meetsitaram/echo/reports/checks.md

# Physical checks

spec: `spec/robot.json`, 2026-11-05 15:00, 550 s

1134 checks: 1052 pass, 18 warn, **64 fail**

## targets

| status | item | detail |
|---|---|---|
| PASS | height | 1.727 m (Figure 03: 1.727 m, +/- 0.010) |
| PASS | chin_z | 1.522 (photo 1.522 +/- 0.02) |
| PASS | shoulder_top_z | 1.449 (photo 1.445 +/- 0.025) |
| PASS | elbow_z | 1.155 (photo 1.156 +/- 0.025) |
| PASS | wrist_z | 0.955 (photo 0.955 +/- 0.03) |
| PASS | fingertip_z | 0.716 (photo 0.71 +/- 0.03) |
| PASS | knee_z | 0.535 (photo 0.54 +/- 0.03) |
| PASS | pelvis_band_top_z | 1.085 (photo 1.085 +/- 0.02) |
| PASS | hips_black_bottom_z | 0.853 (photo 0.86 +/- 0.03) |
| PASS | head_height_m | 0.205 (photo 0.205 +/- 0.015) |
| PASS | head_depth_m | 0.190 (photo 0.183 +/- 0.015) |
| PASS | head_width_m | 0.140 (photo 0.138 +/- 0.012) |
| PASS | chest_depth_m | 0.231 (photo 0.235 +/- 0.025) |
| PASS | bideltoid_width_m | 0.513 (photo 0.51 +/- 0.04) |
| PASS | foot_length_m | 0.289 (photo 0.28 +/- 0.02) |

## mass

| status | item | detail |
|---|---|---|
| PASS | total | 62.29 kg bottom-up (Figure 03: 61.0 kg; allowed 54.9 .. 62.5) |

## axis

| status | item | detail |
|---|---|---|
| PASS | waist_yaw | RS04 0.0 mm off the axis |
| PASS | neck_yaw | RS00 0.0 mm off the axis |
| PASS | neck_pitch | RS00 0.0 mm off the axis |
| PASS | L_shoulder_pitch | RS04 0.0 mm off the axis |
| PASS | R_shoulder_pitch | RS04 0.0 mm off the axis |
| PASS | L_shoulder_roll | RS06 0.0 mm off the axis |
| PASS | R_shoulder_roll | RS06 0.0 mm off the axis |
| PASS | L_shoulder_yaw | RS02 0.0 mm off the axis |
| PASS | R_shoulder_yaw | RS02 0.0 mm off the axis |
| PASS | L_elbow | RS06 0.0 mm off the axis |
| PASS | R_elbow | RS06 0.0 mm off the axis |
| PASS | L_wrist_yaw | RS02 0.0 mm off the axis |
| PASS | R_wrist_yaw | RS02 0.0 mm off the axis |
| PASS | L_wrist_pitch | RS00 0.0 mm off the axis |
| PASS | R_wrist_pitch | RS00 0.0 mm off the axis |
| PASS | L_wrist_roll | RS00 0.0 mm off the axis |
| PASS | R_wrist_roll | RS00 0.0 mm off the axis |
| PASS | L_hip_pitch | RS04 0.0 mm off the axis |
| PASS | R_hip_pitch | RS04 0.0 mm off the axis |
| PASS | L_hip_roll | RS04 0.0 mm off the axis |
| PASS | R_hip_roll | RS04 0.0 mm off the axis |
| PASS | L_hip_yaw | RS03 0.0 mm off the axis |
| PASS | R_hip_yaw | RS03 0.0 mm off the axis |
| PASS | L_knee | RS04 0.0 mm off the axis |
| PASS | R_knee | RS04 0.0 mm off the axis |

## static

| status | item | detail |
|---|---|---|
| PASS | zero pose | 0 overlaps |

## covers

| status | item | detail |
|---|---|---|
| PASS | motors clear of the covers | 0 cover / motor crossings |

## connect

| status | item | detail |
|---|---|---|
| PASS | pelvis structure |  |
| PASS | pelvis covers mounted |  |
| PASS | torso structure |  |
| PASS | torso covers mounted |  |
| PASS | neck_yaw_link structure |  |
| PASS | neck_yaw_link covers mounted |  |
| PASS | head structure |  |
| PASS | head covers mounted |  |
| PASS | L_shoulder_pitch_link structure |  |
| PASS | L_shoulder_pitch_link covers mounted |  |
| PASS | R_shoulder_pitch_link structure |  |
| PASS | R_shoulder_pitch_link covers mounted |  |
| PASS | L_shoulder_roll_link structure |  |
| PASS | L_shoulder_roll_link covers mounted |  |
| PASS | R_shoulder_roll_link structure |  |
| PASS | R_shoulder_roll_link covers mounted |  |
| PASS | L_shoulder_yaw_link structure |  |
| PASS | L_shoulder_yaw_link covers mounted |  |
| PASS | R_shoulder_yaw_link structure |  |
| PASS | R_shoulder_yaw_link covers mounted |  |
| PASS | L_elbow_link structure |  |
| PASS | L_elbow_link covers mounted |  |
| PASS | R_elbow_link structure |  |
| PASS | R_elbow_link covers mounted |  |
| PASS | L_wrist_yaw_link structure |  |
| PASS | L_wrist_yaw_link covers mounted |  |
| PASS | R_wrist_yaw_link structure |  |
| PASS | R_wrist_yaw_link covers mounted |  |
| PASS | L_wrist_pitch_link structure |  |
| PASS | L_wrist_pitch_link covers mounted |  |
| PASS | R_wrist_pitch_link structure |  |
| PASS | R_wrist_pitch_link covers mounted |  |
| PASS | L_hand structure |  |
| PASS | L_hand covers mounted |  |
| PASS | R_hand structure |  |
| PASS | R_hand covers mounted |  |
| PASS | L_hip_pitch_link structure |  |
| PASS | L_hip_pitch_link covers mounted |  |
| PASS | R_hip_pitch_link structure |  |
| PASS | R_hip_pitch_link covers mounted |  |
| PASS | L_hip_roll_link structure |  |
| PASS | L_hip_roll_link covers mounted |  |
| PASS | R_hip_roll_link structure |  |
| PASS | R_hip_roll_link covers mounted |  |
| PASS | L_hip_yaw_link structure |  |
| PASS | L_hip_yaw_link covers mounted |  |
| PASS | R_hip_yaw_link structure |  |
| PASS | R_hip_yaw_link covers mounted |  |
| PASS | L_knee_link structure |  |
| PASS | L_knee_link covers mounted |  |
| PASS | R_knee_link structure |  |
| PASS | R_knee_link covers mounted |  |
| PASS | L_ankle_pitch_link structure |  |
| PASS | L_ankle_pitch_link covers mounted |  |
| PASS | R_ankle_pitch_link structure |  |
| PASS | R_ankle_pitch_link covers mounted |  |
| PASS | L_foot structure |  |
| PASS | L_foot covers mounted |  |
| PASS | R_foot structure |  |
| PASS | R_foot covers mounted |  |
| PASS | waist_yaw axis |  |
| PASS | neck_yaw axis |  |
| PASS | neck_pitch axis |  |
| PASS | L_shoulder_pitch axis |  |
| PASS | R_shoulder_pitch axis |  |
| PASS | L_shoulder_roll axis |  |
| PASS | R_shoulder_roll axis |  |
| PASS | L_shoulder_yaw axis |  |
| PASS | R_shoulder_yaw axis |  |
| PASS | L_elbow axis |  |
| PASS | R_elbow axis |  |
| PASS | L_wrist_yaw axis |  |
| PASS | R_wrist_yaw axis |  |
| PASS | L_wrist_pitch axis |  |
| PASS | R_wrist_pitch axis |  |
| PASS | L_wrist_roll axis |  |
| PASS | R_wrist_roll axis |  |
| PASS | L_hip_pitch axis |  |
| PASS | R_hip_pitch axis |  |
| PASS | L_hip_roll axis |  |
| PASS | R_hip_roll axis |  |
| PASS | L_hip_yaw axis |  |
| PASS | R_hip_yaw axis |  |
| PASS | L_knee axis |  |
| PASS | R_knee axis |  |
| PASS | L_ankle_pitch axis |  |
| PASS | R_ankle_pitch axis |  |
| PASS | L_ankle_roll axis |  |
| PASS | R_ankle_roll axis |  |

## loadpath

| status | item | detail |
|---|---|---|
| PASS | Foot frame in front of the ankle (all load at the toe) | SF 8.97 on what's required, 810 N walking (needs 1.5); worst of all cases 2.14, 3,400 N foot: 235 MPa on 67.0 x 14.1 mm al7075; a hand estimate |
| PASS | Foot frame behind the ankle (all load at the heel) | SF 7.18 on what's required, 810 N walking (needs 1.5); worst of all cases 1.71, 3,400 N foot: 294 MPa on 67.0 x 14.1 mm al7075; a hand estimate |
| PASS | Clevis plates above the frame | SF 16.23 on what's required, 810 N walking (needs 1.5); worst of all cases 7.66, 3,400 N + 1,614 N side: 66 MPa on 2 x 14.4 x 5.0 + 2 x 14.4 x 6.0 mm al7075; a hand estimate |
| PASS | Clevis plates at the pivot (net of the bushings) | SF 4.66 on what's required, 810 N walking (needs 1.5); worst of all cases 3.23, 3,400 N foot: 156 MPa on 2 x 5.5 x 5.0 + 2 x 6.0 x 5.5 mm al7075; a hand estimate |
| PASS | Ankle cross at its middle (net of the shaft's bore) | SF 95.83 on what's required, 810 N walking (needs 1.5); worst of all cases 22.83, 3,400 N foot: 22 MPa on 2 x 30.6 x 6.2 mm al7075; a hand estimate |
| PASS | Fork cheeks at the bushings' top | SF 5.91 on what's required, motor peak (needs 1.5); worst of all cases 5.14, 3,400 N + 1,614 N side: 98 MPa on 2 x 27.6 x 5.0 mm al7075; a hand estimate |
| PASS | Shank tube, closed, past the rods | SF 11.68 on what's required, motor peak (needs 1.5); worst of all cases 7.16, 3,400 N + 1,614 N side: 70 MPa on 53.0 x 43.2 mm al7075; a hand estimate |
| PASS | Shank closed section at the ankle pitch motor, panel on | SF 19.61 on what's required, motor peak (needs 1.5); worst of all cases 6.49, 3,400 N + 1,614 N side: 78 MPa on 97.1 x 20.0 + 9.5 x 4.8 + 97.4 x 23.1 mm al7075; a hand estimate |
| PASS | Shank closed section at the ankle roll motor, panel on | SF 18.90 on what's required, motor peak (needs 1.5); worst of all cases 6.29, 3,400 N + 1,614 N side: 80 MPa on 82.1 x 15.3 + 92.4 x 29.3 mm al7075; a hand estimate |
| PASS | Shank waist behind the knee | SF 35.78 on what's required, motor peak (needs 1.5); worst of all cases 14.66, 3,400 N + 1,614 N side: 34 MPa on 86.2 x 73.7 mm al7075; a hand estimate |
| PASS | Barrel where it meets the waist | SF 80.79 on what's required, motor peak (needs 1.5); worst of all cases 11.02, 3,400 N + 1,614 N side: 46 MPa on 79.8 x 60.1 mm al7075; a hand estimate |
| PASS | Barrel at the axis (walls, net of the bore) | SF 133.73 on what's required, motor peak (needs 1.5); worst of all cases 57.68, 3,400 N foot: 9 MPa on 2 x 58.3 x 8.3 + 2 x 20.1 x 13.9 mm al7075; a hand estimate |
| PASS | Barrel plate round the inner bearing | SF 4317.73 on what's required, 810 N walking (needs 1.5); worst of all cases 1028.64, 3,400 N foot: 0 MPa on 7.8 x 3.5 + 6.2 x 0.7 + 16.7 x 6.8 + 16.0 x 0.7 + 65.6 x 40.3 + 368.8 x 125.0 mm al7075; a hand estimate |
| PASS | Knee post at its root | SF 620.08 on what's required, 810 N walking (needs 1.5); worst of all cases 147.72, 3,400 N foot: 3 MPa on 52.3 x 52.3 mm al7075; a hand estimate |
| PASS | Rear cap at the axis | SF 193.74 on what's required, 810 N walking (needs 1.5); worst of all cases 46.16, 3,400 N foot: 11 MPa on 127.0 x 26.7 mm al7075; a hand estimate |
| PASS | Cup neck between bearing and cheek | SF 33.98 on what's required, motor peak (needs 1.5); worst of all cases 33.98, motor peak: 15 MPa on 52.8 x 52.8 mm al7075; a hand estimate |
| PASS | Fork inner eye, net of its opening | SF 11.73 on what's required, 810 N walking (needs 1.5); worst of all cases 2.79, 3,400 N foot: 180 MPa on 19.9 x 5.1 + 20.0 x 5.2 mm al7075; a hand estimate |
| PASS | Outer cheek at its bearing | SF 153.79 on what's required, 810 N walking (needs 1.5); worst of all cases 36.64, 3,400 N foot: 14 MPa on 95.7 x 11.1 mm al7075; a hand estimate |
| PASS | Fork cheeks over the barrel, both | SF 116.38 on what's required, 810 N walking (needs 1.5); worst of all cases 77.21, 3,400 N foot: 7 MPa on 86.8 x 84.3 mm al7075; a hand estimate |
| PASS | Fork inner cheek alone (the only one that takes motor torque) | SF 111.58 on what's required, motor peak (needs 1.5); worst of all cases 111.58, motor peak: 5 MPa on 86.8 x 73.7 mm al7075; a hand estimate |
| PASS | Fork cheeks out of plane, under the recorded side force | SF 122.05 on what's required, 3,400 N + 1,614 N side (needs 1.5); worst of all cases 122.05, 3,400 N + 1,614 N side: 4 MPa on 86.8 x 84.3 mm al7075; a hand estimate |
| PASS | Fork crown | SF 137.61 on what's required, 810 N walking (needs 1.5); worst of all cases 89.92, 3,400 N foot: 6 MPa on 80.7 x 79.4 mm al7075; a hand estimate |
| PASS | Thigh tube | SF 26.22 on what's required, motor peak (needs 1.5); worst of all cases 20.35, 3,400 N foot: 25 MPa on 66.0 x 66.0 mm al7075; a hand estimate |
| PASS | Thigh tube under its collar | SF 26.15 on what's required, motor peak (needs 1.5); worst of all cases 20.30, 3,400 N foot: 25 MPa on 66.0 x 66.0 mm al7075; a hand estimate |
| PASS | Yaw housing at the motor | SF 84.72 on what's required, 810 N walking (needs 1.5); worst of all cases 53.02, 3,400 N foot: 9 MPa on 110.6 x 110.6 mm al7075; a hand estimate |
| PASS | Yoke band under the pitch motor | SF 16.50 on what's required, 810 N walking (needs 1.5); worst of all cases 10.09, 3,400 N foot: 50 MPa on 41.5 x 9.7 + 104.8 x 56.9 mm al7075; a hand estimate |
| PASS | Yoke plate behind the pitch motor | SF 7.34 on what's required, 810 N walking (needs 1.5); worst of all cases 3.40, 3,400 N foot: 148 MPa on 59.3 x 6.4 + 41.5 x 11.7 mm al7075; a hand estimate |
| PASS | Carrier arm over the roll output | SF 4.16 on what's required, motor peak (needs 1.5); worst of all cases 2.32, 3,400 N foot: 217 MPa on 56.3 x 10.6 mm al7075; a hand estimate |
| PASS | Carrier arm at the eye | SF 4.03 on what's required, motor peak (needs 1.5); worst of all cases 2.34, 3,400 N foot: 215 MPa on 54.2 x 10.6 mm al7075; a hand estimate |
| PASS | Roll barrel | SF 83.27 on what's required, 810 N walking (needs 1.5); worst of all cases 31.65, 3,400 N foot: 16 MPa on 130.3 x 125.4 mm al7075; a hand estimate |
| PASS | Pelvis bar between the hips | SF 20.26 on what's required, 810 N walking (needs 1.5); worst of all cases 8.19, 3,400 N foot: 61 MPa on 2 x 22.1 x 2.0 + 2 x 67.1 x 16.0 + 2 x 5.7 x 4.6 mm al7075; a hand estimate |
| PASS | Hip barrel on the pelvis | SF 104.96 on what's required, 810 N walking (needs 1.5); worst of all cases 44.31, 3,400 N foot: 11 MPa on 125.4 x 125.4 mm al7075; a hand estimate |
| PASS | Waist housing on the pelvis | SF 151.60 on what's required, 810 N walking (needs 1.5); worst of all cases 130.99, 3,400 N foot: 4 MPa on 232.6 x 125.4 mm al7075; a hand estimate |
| PASS | Waist cup neck | SF 16.93 on what's required, motor peak (needs 1.5); worst of all cases 16.93, motor peak: 30 MPa on 52.9 x 52.9 mm al7075; a hand estimate |
| PASS | Chest rails over the waist | SF 7.33 on what's required, motor peak (needs 1.5); worst of all cases 7.33, motor peak: 69 MPa on 2 x 46.0 x 25.0 mm al7075; a hand estimate |
| PASS | Frame between waist and shoulder bar (the pack is not frame) | SF 6.69 on what's required, motor peak (needs 1.5); worst of all cases 6.69, motor peak: 75 MPa on 2 x 44.0 x 24.0 mm al7075; a hand estimate |
| PASS | Chest bar under the neck | SF 95.29 on what's required, motor peak (needs 1.5); worst of all cases 95.29, motor peak: 5 MPa on 12.5 x 3.8 + 2 x 31.6 x 6.7 + 125.4 x 125.4 mm al7075; a hand estimate |
| PASS | Chest bar at the shoulder motor | SF 185.29 on what's required, motor peak (needs 1.5); worst of all cases 112.72, 3,400 N foot: 4 MPa on 66.0 x 43.8 + 63.9 x 46.3 + 65.2 x 10.0 + 124.2 x 55.5 mm al7075; a hand estimate |
| PASS | Shoulder bracket | SF 24.80 on what's required, motor peak (needs 1.5); worst of all cases 24.80, motor peak: 20 MPa on 36.0 x 36.0 mm al7075; a hand estimate |
| PASS | Shoulder roll post (front of the fork) | SF 15.50 on what's required, 5 kg in the hand (needs 1.5); worst of all cases 7.65, 3,400 N foot: 66 MPa on 24.0 x 24.0 mm al7075; a hand estimate |
| PASS | Shoulder roll axle (back of the fork) | SF 12.11 on what's required, 5 kg in the hand (needs 1.5); worst of all cases 6.12, 3,400 N foot: 82 MPa on 22.0 x 22.0 mm al7075; a hand estimate |
| PASS | Fork plates, upper, solid | SF 99.92 on what's required, motor peak (needs 1.5); worst of all cases 99.92, motor peak: 5 MPa on 2 x 64.0 x 6.0 mm al7075; a hand estimate |
| PASS | Fork plates at the roll axis (front net of its bore) | SF 38.28 on what's required, motor peak (needs 1.5); worst of all cases 38.28, motor peak: 13 MPa on 64.0 x 6.0 + 6.0 x 3.5 + 33.5 x 6.0 mm al7075; a hand estimate |
| PASS | Fork front plate alone, net of its bore | SF 8.66 on what's required, motor peak (needs 1.5); worst of all cases 8.66, motor peak: 58 MPa on 6.0 x 3.5 + 33.5 x 6.0 mm al7075; a hand estimate |
| PASS | Fork plates, lower | SF 67.51 on what's required, motor peak (needs 1.5); worst of all cases 67.51, motor peak: 7 MPa on 2 x 50.0 x 6.0 mm al7075; a hand estimate |
| PASS | Fork bridge | SF 10.77 on what's required, 5 kg in the hand (needs 1.5); worst of all cases 5.67, 3,400 N foot: 89 MPa on 50.0 x 10.0 mm al7075; a hand estimate |
| PASS | Upper arm frame | SF 60.28 on what's required, motor peak (needs 1.5); worst of all cases 42.03, 3,400 N foot: 12 MPa on 30.0 x 30.0 mm al7075; a hand estimate |
| PASS | Elbow bridge beside the frame | SF 5.67 on what's required, motor peak (needs 1.5); worst of all cases 4.24, 3,400 N foot: 119 MPa on 24.0 x 10.0 mm al7075; a hand estimate |
| PASS | Elbow cheeks over the discs, both | SF 39.62 on what's required, 5 kg in the hand (needs 1.5); worst of all cases 24.77, 3,400 N foot: 20 MPa on 2 x 46.0 x 3.0 mm al7075; a hand estimate |
| FAIL | Elbow inner cheek alone (the only one that takes motor torque) | SF 1.31 on what's required, 5 kg in the hand (needs 1.5); worst of all cases 0.82, 3,400 N foot: 610 MPa on 46.0 x 3.0 mm al7075; a hand estimate |
| PASS | Elbow cheek discs at the bores (net of them) | SF 83.18 on what's required, motor peak (needs 1.5); worst of all cases 83.18, motor peak: 6 MPa on 2 x 20.5 x 3.0 + 2 x 28.5 x 3.0 mm al7075; a hand estimate |
| PASS | Elbow axle | SF 52.04 on what's required, motor peak (needs 1.5); worst of all cases 52.04, motor peak: 10 MPa on 34.0 x 34.0 mm al7075; a hand estimate |
| PASS | Elbow post | SF 49.76 on what's required, 5 kg in the hand (needs 1.5); worst of all cases 49.76, 5 kg in the hand: 10 MPa on 34.0 x 34.0 mm al7075; a hand estimate |
| PASS | Forearm frame | SF 4.70 on what's required, 5 kg in the hand (needs 1.5); worst of all cases 3.61, 3,400 N foot: 139 MPa on 40.0 x 5.0 mm al7075; a hand estimate |
| PASS | Elbow idler arm | SF 16.11 on what's required, 5 kg in the hand (needs 1.5); worst of all cases 10.32, 3,400 N foot: 49 MPa on 12.0 x 4.0 mm al7075; a hand estimate |
| PASS | Under the elbow motor | SF 85.51 on what's required, 5 kg in the hand (needs 1.5); worst of all cases 54.82, 3,400 N foot: 9 MPa on 30.0 x 8.0 mm al7075; a hand estimate |
| PASS | Forearm lower frame | SF 71.86 on what's required, motor peak (needs 1.5); worst of all cases 71.86, motor peak: 7 MPa on 30.0 x 24.0 mm al7075; a hand estimate |
| PASS | Wrist cheek | SF 8.34 on what's required, motor peak (needs 1.5); worst of all cases 8.34, motor peak: 60 MPa on 40.0 x 6.0 mm al7075; a hand estimate |
| PASS | Hand bracket | SF 13.22 on what's required, motor peak (needs 1.5); worst of all cases 13.22, motor peak: 38 MPa on 20.0 x 6.0 mm al7075; a hand estimate |
| PASS | Neck housing column | SF 17.04 on what's required, motor peak (needs 1.5); worst of all cases 17.04, motor peak: 30 MPa on 17.2 x 17.0 mm al7075; a hand estimate |
| PASS | Head frame | SF 31.82 on what's required, motor peak (needs 1.5); worst of all cases 7.98, 3,400 N foot: 63 MPa on 37.0 x 4.0 mm al7075; a hand estimate |
| PASS | Pitch rod | SF 2.84 on what's required, motor peak (needs 1.5); worst of all cases 2.84, motor peak: 34 MPa on 10.0 x 10.0 mm al7075; a hand estimate |
| PASS | Roll rod | SF 2.55 on what's required, motor peak (needs 1.5); worst of all cases 2.55, motor peak: 18 MPa on 10.0 x 10.0 mm al7075; a hand estimate |
| PASS | Pitch crank at the motor | SF 4.96 on what's required, motor peak (needs 1.5); worst of all cases 4.96, motor peak: 102 MPa on 6.4 x 4.4 + 6.4 x 4.9 + 12.4 x 6.4 mm al7075; a hand estimate |
| PASS | Roll crank at the motor | SF 6.21 on what's required, motor peak (needs 1.5); worst of all cases 6.21, motor peak: 81 MPa on 2 x 6.2 x 4.3 + 2 x 6.2 x 4.1 mm al7075; a hand estimate |
| PASS | Ankle pitch arm | SF 1.96 on what's required, motor peak (needs 1.5); worst of all cases 1.96, motor peak: 257 MPa on 19.6 x 15.8 mm al7075; a hand estimate |
| PASS | Roll rod post | SF 2.76 on what's required, motor peak (needs 1.5); worst of all cases 2.76, motor peak: 182 MPa on 19.4 x 3.5 mm al7075; a hand estimate |
| PASS | coverage: every rigid part on a path or excused |  |
| PASS | coverage: every named part exists |  |
| WARN | role: L elbow hub in | 7075 with role shell: not counted as load-bearing. If it carries load, make it struct |
| WARN | role: L elbow hub out | 7075 with role shell: not counted as load-bearing. If it carries load, make it struct |
| WARN | role: L knee hub out | 7075 with role shell: not counted as load-bearing. If it carries load, make it struct |

## contact

| status | item | detail |
|---|---|---|
| PASS | L foot frame / L ankle roll bushing front | 110 mm2 (overlap, 0.23 deep), needs 100 to pass 405 N |
| PASS | L foot frame / L ankle roll bushing back | 100 mm2 (overlap, 0.25 deep), needs 100 to pass 405 N |
| PASS | L ankle roll shaft / L ankle cross | 367 mm2 (flush, 0.00 deep), needs 100 to pass 810 N |
| PASS | L ankle pitch bushing in / L shank body | 101 mm2 (overlap, 0.25 deep), needs 100 to pass 405 N |
| PASS | L ankle pitch bushing out / L shank body | 109 mm2 (overlap, 0.23 deep), needs 100 to pass 405 N |
| PASS | L shank body / L shank back panel | 1281 mm2 (overlap, 0.20 deep), needs 100 to pass 81 N |
| PASS | L shank body / L knee rear cap | 534 mm2 (overlap, 0.69 deep), needs 100 to pass 613 N |
| PASS | L shank body / L_knee actuator (buy) RS04 | 8212 mm2 (flush, 0.00 deep), needs 100 to pass 543 N |
| PASS | L thigh fork / L_knee flange | 1461 mm2 (overlap, 0.38 deep), needs 100 to pass 613 N |
| PASS | L thigh fork / L knee outer cheek | 543 mm2 (overlap, 1.67 deep), needs 100 to pass 613 N |
| PASS | L thigh fork / L_hip_yaw flange | 2357 mm2 (overlap, 0.20 deep), needs 100 to pass 810 N |
| PASS | L hip yoke / L hip yaw ring | 274 mm2 (overlap, 0.90 deep), needs 100 to pass 810 N |
| PASS | L hip yaw ring / L_hip_yaw actuator (buy) RS03 | 457 mm2 (overlap, 0.15 deep), needs 100 to pass 810 N |
| PASS | L hip yoke / L_hip_roll flange | 122 mm2 (overlap, 0.57 deep), needs 100 to pass 810 N |
| PASS | L hip carrier / L_hip_roll actuator (buy) RS04 | 3528 mm2 (overlap, 0.31 deep), needs 100 to pass 810 N |
| PASS | L hip carrier / L_hip_pitch flange | 1355 mm2 (overlap, 0.34 deep), needs 100 to pass 810 N |
| PASS | pelvis frame / L_hip_pitch actuator (buy) RS04 | 3516 mm2 (overlap, 0.27 deep), needs 100 to pass 543 N |
| PASS | pelvis frame / L hip ring | 269 mm2 (overlap, 0.80 deep), needs 100 to pass 810 N |
| PASS | pelvis frame / waist_yaw actuator (buy) RS04 | 3580 mm2 (overlap, 0.37 deep), needs 100 to pass 435 N |
| PASS | pelvis frame / waist ring | 268 mm2 (overlap, 0.80 deep), needs 100 to pass 435 N |
| PASS | chest frame / waist_yaw flange | 1150 mm2 (overlap, 0.34 deep), needs 100 to pass 435 N |
| PASS | chest frame / L_shoulder_pitch actuator (buy) RS04 | 3516 mm2 (overlap, 0.27 deep), needs 100 to pass 106 N |
| PASS | L shoulder bracket / L_shoulder_pitch flange | 1187 mm2 (overlap, 4.85 deep), needs 100 to pass 106 N |
| PASS | L shoulder bracket / L_shoulder_roll actuator (buy) RS06 | 545 mm2 (overlap, 2.08 deep), needs 100 to pass 106 N |
| PASS | L shoulder roll axle / L_shoulder_roll flange | 380 mm2 (overlap, 3.25 deep), needs 100 to pass 106 N |
| PASS | L shoulder roll axle / L shoulder roll plate back | 380 mm2 (overlap, 6.00 deep), needs 100 to pass 106 N |
| PASS | L shoulder roll plate back / L shoulder roll plate back low | 115 mm2 (flush, 0.00 deep), needs 100 to pass 106 N |
| PASS | L shoulder roll plate front / L shoulder roll plate front low | 115 mm2 (flush, 0.00 deep), needs 100 to pass 106 N |
| PASS | L shoulder roll plate back low / L shoulder roll bridge | 451 mm2 (overlap, 6.00 deep), needs 100 to pass 106 N |
| PASS | L shoulder roll plate front low / L shoulder roll bridge | 451 mm2 (overlap, 6.00 deep), needs 100 to pass 106 N |
| FAIL | L shoulder roll plate back low / L_shoulder_yaw actuator (buy) RS02 | 87 mm2 (overlap, 1.50 deep), needs 100 to pass 106 N |
| FAIL | L shoulder roll plate front low / L_shoulder_yaw actuator (buy) RS02 | 87 mm2 (overlap, 1.50 deep), needs 100 to pass 106 N |
| PASS | L upper arm frame / L_shoulder_yaw flange | 753 mm2 (overlap, 2.75 deep), needs 100 to pass 106 N |
| PASS | L upper arm frame / L elbow bridge | 619 mm2 (overlap, 2.00 deep), needs 100 to pass 106 N |
| PASS | L elbow bridge / L elbow cheek in | 149 mm2 (overlap, 3.00 deep), needs 100 to pass 106 N |
| PASS | L elbow bridge / L elbow cheek out | 149 mm2 (overlap, 3.00 deep), needs 100 to pass 106 N |
| PASS | L elbow cheek in / L elbow cheek disc in | 788 mm2 (overlap, 3.00 deep), needs 100 to pass 106 N |
| PASS | L elbow cheek out / L elbow cheek disc out | 788 mm2 (overlap, 3.00 deep), needs 100 to pass 106 N |
| PASS | L elbow cheek disc in / L elbow axle | 492 mm2 (overlap, 0.20 deep), needs 100 to pass 106 N |
| PASS | L elbow axle / L_elbow flange | 906 mm2 (overlap, 0.60 deep), needs 100 to pass 106 N |
| PASS | L elbow post / L forearm frame | 875 mm2 (overlap, 5.00 deep), needs 100 to pass 106 N |
| PASS | L forearm frame / L_elbow actuator (buy) RS06 | 1618 mm2 (flush, 0.00 deep), needs 100 to pass 106 N |
| FAIL | L elbow idler stub / L elbow idler arm | 74 mm2 (overlap, 3.50 deep), needs 100 to pass 106 N |
| FAIL | L elbow idler arm / L elbow under motor | 55 mm2 (overlap, 3.00 deep), needs 100 to pass 106 N |
| PASS | L elbow under motor / L forearm frame | 223 mm2 (overlap, 4.50 deep), needs 100 to pass 106 N |
| PASS | L forearm frame / L_wrist_yaw actuator (buy) RS02 | 362 mm2 (overlap, 5.00 deep), needs 100 to pass 106 N |
| PASS | L forearm lower frame / L_wrist_yaw flange | 628 mm2 (overlap, 4.25 deep), needs 100 to pass 106 N |
| PASS | L forearm lower frame / L_wrist_pitch actuator (buy) RS00 | 314 mm2 (overlap, 1.50 deep), needs 100 to pass 106 N |
| PASS | L wrist cheek / L_wrist_pitch flange | 452 mm2 (overlap, 5.00 deep), needs 100 to pass 106 N |
| PASS | L wrist cheek / L_wrist_roll actuator (buy) RS00 | 149 mm2 (overlap, 2.56 deep), needs 100 to pass 106 N |
| PASS | L hand bracket / L_wrist_roll flange | 230 mm2 (overlap, 3.50 deep), needs 100 to pass 106 N |
| PASS | chest frame / neck_yaw actuator (buy) RS00 | 871 mm2 (overlap, 0.25 deep), needs 100 to pass 19 N |
| PASS | neck housing / neck_yaw flange | 479 mm2 (overlap, 0.70 deep), needs 100 to pass 19 N |
| PASS | neck housing / neck_pitch actuator (buy) RS00 | 758 mm2 (overlap, 0.17 deep), needs 100 to pass 19 N |
| PASS | head frame / neck_pitch flange | 987 mm2 (overlap, 0.30 deep), needs 100 to pass 19 N |
| PASS | L foot frame / L ankle roll post | 281 mm2 (overlap, 0.26 deep), needs 200 to pass 1385 N |
| PASS | pelvis: frame in one piece |  |
| PASS | torso: frame in one piece |  |
| PASS | battery: seated on the frame | 113 mm2 on carrying parts (needs 100) |
| PASS | battery lower: seated on the frame | 141 mm2 on carrying parts (needs 100) |
| PASS | compute: seated on the frame | 253 mm2 on carrying parts (needs 100) |
| PASS | neck_yaw_link: frame in one piece |  |
| PASS | head: frame in one piece |  |
| PASS | head camera 0: seated on the frame | 103 mm2 on carrying parts (needs 100) |
| PASS | head camera 1: seated on the frame | 103 mm2 on carrying parts (needs 100) |
| PASS | head camera 2: seated on the frame | 103 mm2 on carrying parts (needs 100) |
| PASS | head display: seated on the frame | 295 mm2 on carrying parts (needs 100) |
| PASS | head board: seated on the frame | 214 mm2 on carrying parts (needs 100) |
| FAIL | L_shoulder_pitch_link: frame in one piece | 2 pieces: L shoulder bracket + L_shoulder_pitch flange; L shoulder roll post. Nothing joins them |
| PASS | L_shoulder_roll_link: frame in one piece |  |
| PASS | L_shoulder_yaw_link: frame in one piece |  |
| FAIL | L_elbow_link: frame in one piece | 3 pieces: L elbow idler stub; L elbow idler arm; L elbow post + L elbow under motor + L forearm frame. Only by: L elbow idler stub / L elbow idler arm 74 mm2 overlap; L elbow idler arm / L elbow under motor 55 mm2 overlap |
| PASS | L_wrist_yaw_link: frame in one piece |  |
| PASS | L_wrist_pitch_link: frame in one piece |  |
| PASS | L_hand: frame in one piece |  |
| PASS | L_hip_pitch_link: frame in one piece |  |
| PASS | L_hip_roll_link: frame in one piece |  |
| PASS | L_hip_yaw_link: frame in one piece |  |
| PASS | L_knee_link: frame in one piece |  |
| PASS | L_ankle_pitch_link: frame in one piece |  |
| PASS | L_foot: frame in one piece |  |

## pivot

| status | item | detail |
|---|---|---|
| PASS | L_ankle_pitch: passive joint | pin d12, 3400 N in double shear: SF 24.6 to yield (a hand estimate) |
| PASS | L_ankle_roll: passive joint | pin d12, 3400 N in double shear: SF 24.6 to yield (a hand estimate) |
| FAIL | L shoulder roll bearing bore: bearing seat | no bearing modelled: L shoulder roll post is on the axis, with 1.50 mm of air to the other link |
| FAIL | L elbow cheek bearing bore: bearing seat | no bearing modelled: L elbow post is on the axis, with 2.50 mm of air to the other link |
| FAIL | L elbow cheek idler bore: bearing seat | no bearing modelled: L elbow axle is on the axis, with 0.30 mm of air to the other link |
| PASS | L knee outer cheek bearing bore: bearing seat | CRBS 508: inner race on L knee rear cap, outer in L knee outer cheek; rating in group bearing |
| PASS | L knee barrel bearing bore: bearing seat | CRBS 508: inner race on L_knee flange, outer in L shank body; rating in group bearing |

## linkage

| status | item | detail |
|---|---|---|
| PASS | L_ankle_pitch: has a motor, crank and rod |  |
| PASS | L_ankle_pitch: crank reaches the motor |  |
| PASS | L_ankle_pitch: rod reaches the crank |  |
| PASS | L_ankle_pitch: rod reaches the output | at L ankle pitch arm |
| PASS | L_ankle_pitch: rod crank end has a pivot | L ankle pitch rod end top |
| PASS | L_ankle_pitch: rod output end has a pivot | L ankle pitch rod end bottom |
| PASS | L_ankle_roll: has a motor, crank and rod |  |
| PASS | L_ankle_roll: crank reaches the motor |  |
| PASS | L_ankle_roll: rod reaches the crank |  |
| PASS | L_ankle_roll: rod reaches the output | at L ankle roll post |
| PASS | L_ankle_roll: rod crank end has a pivot | L ankle roll rod end top |
| PASS | L_ankle_roll: rod output end has a pivot | L ankle roll rod end bottom |

## stator

| status | item | detail |
|---|---|---|
| PASS | waist_yaw actuator (buy) RS04 | held by pelvis frame (on its screwed face), 3850 mm2 on its end face |
| PASS | L_hip_pitch actuator (buy) RS04 | held by pelvis frame (on its screwed face), 3849 mm2 on its end face |
| PASS | R_hip_pitch actuator (buy) RS04 | held by pelvis frame (on its screwed face), 3849 mm2 on its end face |
| PASS | neck_yaw actuator (buy) RS00 | held by chest frame, 1175 mm2 on its end face |
| PASS | L_shoulder_pitch actuator (buy) RS04 | held by chest frame (on its screwed face), 3849 mm2 on its end face |
| PASS | R_shoulder_pitch actuator (buy) RS04 | held by chest frame (on its screwed face), 3849 mm2 on its end face |
| PASS | neck_pitch actuator (buy) RS00 | held by neck housing, 1299 mm2 on its end face |
| FAIL | L_shoulder_roll actuator (buy) RS06 | no mounting face: 0 mm2 on its ends (needs 100); what touches it overlaps its side wall |
| FAIL | L_shoulder_yaw actuator (buy) RS02 | no mounting face: 0 mm2 on its ends (needs 100); what touches it overlaps its side wall |
| PASS | L_elbow actuator (buy) RS06 | held by L forearm frame, 2077 mm2 on its end face |
| FAIL | L_wrist_yaw actuator (buy) RS02 | no mounting face: 0 mm2 on its ends (needs 100); what touches it overlaps its side wall |
| FAIL | L_wrist_pitch actuator (buy) RS00 | no mounting face: 0 mm2 on its ends (needs 100); what touches it overlaps its side wall |
| FAIL | L_wrist_roll actuator (buy) RS00 | no mounting face: 0 mm2 on its ends (needs 100); what touches it overlaps its side wall |
| PASS | L_hip_roll actuator (buy) RS04 | held by L hip carrier (on its screwed face), 3850 mm2 on its end face |
| PASS | L_hip_yaw actuator (buy) RS03 | held by L hip yoke, 8811 mm2 on its end face |
| PASS | L_ankle_pitch actuator (buy) RS03 | held by L shank body, 3052 mm2 on its end face |
| PASS | L_ankle_roll actuator (buy) RS06 | held by L shank body, 1500 mm2 on its end face |
| PASS | L_knee actuator (buy) RS04 | held by L shank body (on its screwed face), 7068 mm2 on its end face |

## skin

| status | item | detail |
|---|---|---|
| PASS | waist_yaw actuator (buy) RS04 | 0.00 % outside the skin |
| PASS | chest frame | 0.00 % outside the skin |
| PASS | battery | 0.00 % outside the skin |
| PASS | battery lower | 0.00 % outside the skin |
| PASS | compute | 0.00 % outside the skin |
| PASS | neck_yaw actuator (buy) RS00 | 0.00 % outside the skin |
| PASS | L_shoulder_pitch actuator (buy) RS04 | 0.00 % outside the skin |
| PASS | R_shoulder_pitch actuator (buy) RS04 | 0.00 % outside the skin |
| PASS | neck housing | 0.00 % outside the skin |
| PASS | neck_yaw flange | 0.00 % outside the skin |
| PASS | neck_pitch actuator (buy) RS00 | 0.00 % outside the skin |
| PASS | head sensor block | 0.00 % outside the skin |
| PASS | head camera 0 | 0.00 % outside the skin |
| PASS | head camera 1 | 0.00 % outside the skin |
| PASS | head camera 2 | 0.00 % outside the skin |
| PASS | head display | 0.22 % outside the skin |
| PASS | head board | 0.00 % outside the skin |
| PASS | head frame | 0.00 % outside the skin |
| PASS | neck_pitch flange | 0.00 % outside the skin |
| PASS | L shoulder bracket | 0.00 % outside the skin |
| PASS | L shoulder roll post | 0.00 % outside the skin |
| PASS | L_shoulder_pitch flange | 0.00 % outside the skin |
| PASS | L_shoulder_roll actuator (buy) RS06 | 0.00 % outside the skin |
| PASS | R shoulder bracket | 0.00 % outside the skin |
| PASS | R shoulder roll post | 0.00 % outside the skin |
| PASS | R_shoulder_pitch flange | 0.00 % outside the skin |
| PASS | R_shoulder_roll actuator (buy) RS06 | 0.00 % outside the skin |
| PASS | L shoulder roll axle | 0.00 % outside the skin |
| PASS | L shoulder roll plate back | 0.00 % outside the skin |
| PASS | L shoulder roll plate front | 0.00 % outside the skin |
| PASS | L shoulder roll plate back low | 0.02 % outside the skin |
| PASS | L shoulder roll plate front low | 0.05 % outside the skin |
| PASS | L shoulder roll bridge | 0.00 % outside the skin |
| PASS | L_shoulder_roll flange | 0.00 % outside the skin |
| PASS | L_shoulder_yaw actuator (buy) RS02 | 0.00 % outside the skin |
| PASS | R shoulder roll axle | 0.00 % outside the skin |
| PASS | R shoulder roll plate back | 0.00 % outside the skin |
| PASS | R shoulder roll plate front | 0.00 % outside the skin |
| PASS | R shoulder roll plate back low | 0.02 % outside the skin |
| PASS | R shoulder roll plate front low | 0.08 % outside the skin |
| PASS | R shoulder roll bridge | 0.00 % outside the skin |
| PASS | R_shoulder_roll flange | 0.00 % outside the skin |
| PASS | R_shoulder_yaw actuator (buy) RS02 | 0.00 % outside the skin |
| PASS | L_elbow flange | 0.00 % outside the skin |
| PASS | R_elbow flange | 0.00 % outside the skin |
| PASS | L_elbow actuator (buy) RS06 | 0.00 % outside the skin |
| PASS | L_wrist_yaw actuator (buy) RS02 | 0.00 % outside the skin |
| PASS | R_elbow actuator (buy) RS06 | 0.00 % outside the skin |
| PASS | R_wrist_yaw actuator (buy) RS02 | 0.00 % outside the skin |
| PASS | L shank body | 0.10 % outside the skin |
| PASS | L shank back panel | 0.00 % outside the skin |
| PASS | L_ankle_pitch actuator (buy) RS03 | 0.00 % outside the skin |
| PASS | L_ankle_roll actuator (buy) RS06 | 0.00 % outside the skin |
| PASS | L ankle pitch bushing in | 0.00 % outside the skin |
| PASS | L ankle pitch bushing out | 0.00 % outside the skin |
| PASS | L_knee actuator (buy) RS04 | 0.00 % outside the skin |
| PASS | R shank body | 0.10 % outside the skin |
| PASS | R shank back panel | 0.00 % outside the skin |
| PASS | R_ankle_pitch actuator (buy) RS03 | 0.00 % outside the skin |
| PASS | R_ankle_roll actuator (buy) RS06 | 0.00 % outside the skin |
| PASS | R ankle pitch bushing in | 0.00 % outside the skin |
| PASS | R ankle pitch bushing out | 0.00 % outside the skin |
| PASS | R_knee actuator (buy) RS04 | 0.00 % outside the skin |
| PASS | L ankle roll shaft | 0.00 % outside the skin |
| PASS | R ankle roll shaft | 0.00 % outside the skin |
| PASS | L ankle roll bushing front | 0.00 % outside the skin |
| PASS | L ankle roll bushing back | 0.00 % outside the skin |
| PASS | R ankle roll bushing front | 0.00 % outside the skin |
| PASS | R ankle roll bushing back | 0.00 % outside the skin |

## sweep

| status | item | detail |
|---|---|---|
| WARN | waist_yaw | [-2.60, +2.60] rad clear; lower: R_hand / R_hip_yaw_link: R palm / R thigh at -0.11 rad (pose-dependent); upper: L_hand / L_hip_yaw_link: L palm / L thigh at +0.11 rad (pose-dependent) |
| PASS | neck_yaw | [-1.40, +1.40] rad clear |
| PASS | neck_pitch | [-0.40, +0.45] rad clear |
| PASS | L_shoulder_pitch | [-3.00, +1.00] rad clear |
| WARN | L_shoulder_roll | [-0.05, +2.60] rad clear; lower: L_hand / L_hip_yaw_link: L palm / L thigh at -0.00 rad (pose-dependent) |
| WARN | L_shoulder_yaw | [-2.60, +2.60] rad clear; lower: L_hand / L_hip_yaw_link: L palm / L thigh at -0.33 rad (pose-dependent); upper: L_hand / L_hip_yaw_link: L palm / L thigh at +0.11 rad (pose-dependent) |
| PASS | L_elbow | [-1.90, +0.00] rad clear |
| WARN | L_wrist_yaw | [-2.60, +2.60] rad clear; lower: L_hand / L_hip_yaw_link: L palm / L thigh at -0.33 rad (pose-dependent); upper: L_hand / L_hip_yaw_link: L palm / L thigh at +0.11 rad (pose-dependent) |
| WARN | L_wrist_pitch | [-0.90, +0.90] rad clear; lower: L_hand / L_hip_yaw_link: L palm / L thigh at -0.04 rad (pose-dependent) |
| PASS | L_wrist_roll | [-0.60, +0.60] rad clear |
| PASS | L_hip_pitch | [-1.65, +0.24] rad clear |
| WARN | L_hip_roll | [-0.35, +0.60] rad clear; lower: L_foot / R_foot: L sole / R shoe midsole at -0.10 rad (pose-dependent); upper: L_hip_yaw_link / L_hand: L thigh / L palm at +0.02 rad (pose-dependent) |
| WARN | L_hip_yaw | [-1.20, +1.20] rad clear; lower: L_hip_yaw_link / L_hand: L thigh / L palm at -0.05 rad (pose-dependent); upper: L_hip_yaw_link / R_hip_yaw_link: L thigh / R thigh at +1.20 rad (pose-dependent) |
| PASS | L_knee | [+0.00, +2.15] rad clear |
| PASS | L_ankle_pitch | [-0.80, +0.55] rad clear |
| PASS | L_ankle_roll | [-0.30, +0.30] rad clear |

## poses

| status | item | detail |
|---|---|---|
| PASS | stand: balance | CoM 11.8 cm inside the feet |
| PASS | stand: within limits | yes |
| PASS | stand: collisions | none |
| PASS | walk crouch: balance | CoM 12.0 cm inside the feet |
| PASS | walk crouch: within limits | yes |
| PASS | walk crouch: collisions | none |
| PASS | carry 3 kg at the chest: balance | CoM 11.8 cm inside the feet |
| PASS | carry 3 kg at the chest: within limits | yes |
| PASS | carry 3 kg at the chest: collisions | none |
| PASS | carry 10 kg at the chest: balance | CoM 11.9 cm inside the feet |
| PASS | carry 10 kg at the chest: within limits | yes |
| PASS | carry 10 kg at the chest: collisions | none |
| PASS | deep squat: balance | CoM 11.9 cm inside the feet |
| PASS | deep squat: within limits | yes |
| PASS | deep squat: collisions | none |
| PASS | arms straight out, 5 kg: balance | CoM 11.9 cm inside the feet |
| PASS | arms straight out, 5 kg: within limits | yes |
| PASS | arms straight out, 5 kg: collisions | none |
| PASS | arms out to the sides: balance | CoM 11.9 cm inside the feet |
| PASS | arms out to the sides: within limits | yes |
| PASS | arms out to the sides: collisions | none |
| PASS | lift 10 kg from a low table: balance | CoM 11.9 cm inside the feet |
| PASS | lift 10 kg from a low table: within limits | yes |
| PASS | lift 10 kg from a low table: collisions | none |
| PASS | single-leg stance (walking): balance | CoM 4.9 cm inside the stance foot |
| PASS | single-leg stance (walking): within limits | yes |
| PASS | single-leg stance (walking): collisions | none |
| PASS | step up a stair: balance | CoM 4.9 cm inside the stance foot |
| PASS | step up a stair: within limits | yes |
| PASS | step up a stair: collisions | none |

## torque

| status | item | detail |
|---|---|---|
| FAIL | L_knee | 144.6 N m x 1.5 in 'step up a stair' vs peak 120 N m (1 x RS04): 181 % used |
| FAIL | L_hip_yaw | 41.1 N m x 1.5 in 'step up a stair' vs peak 60 N m (1 x RS03): 103 % used |
| PASS | R_elbow | 10.5 N m in 'carry 3 kg at the chest' vs rated 11 N m (1 x RS06): 95 % used |
| PASS | L_elbow | 10.5 N m in 'carry 3 kg at the chest' vs rated 11 N m (1 x RS06): 95 % used |
| PASS | R_knee | 71.9 N m x 1.5 in 'deep squat' vs peak 120 N m (1 x RS04): 90 % used |
| PASS | L_hip_roll | 63.6 N m x 1.5 in 'single-leg stance (walking)' vs peak 120 N m (1 x RS04): 79 % used |
| PASS | L_shoulder_roll | 15.8 N m x 1.5 in 'arms out to the sides' vs peak 36 N m (1 x RS06): 66 % used |
| PASS | R_shoulder_roll | 15.8 N m x 1.5 in 'arms out to the sides' vs peak 36 N m (1 x RS06): 66 % used |
| PASS | R_wrist_roll | 4.1 N m x 1.5 in 'carry 10 kg at the chest' vs peak 14 N m (1 x RS00): 44 % used |
| PASS | L_wrist_roll | 4.1 N m x 1.5 in 'carry 10 kg at the chest' vs peak 14 N m (1 x RS00): 44 % used |
| PASS | R_ankle_pitch | 12.5 N m in 'stand' vs rated 30 N m (1 x RS03 x 1.5): 42 % used |
| PASS | L_ankle_pitch | 12.5 N m in 'stand' vs rated 30 N m (1 x RS03 x 1.5): 42 % used |
| PASS | R_shoulder_pitch | 16.6 N m in 'carry 3 kg at the chest' vs rated 40 N m (1 x RS04): 41 % used |
| PASS | L_shoulder_pitch | 16.6 N m in 'carry 3 kg at the chest' vs rated 40 N m (1 x RS04): 41 % used |
| PASS | L_hip_pitch | 29.3 N m x 1.5 in 'lift 10 kg from a low table' vs peak 120 N m (1 x RS04): 37 % used |
| PASS | R_hip_pitch | 29.3 N m x 1.5 in 'lift 10 kg from a low table' vs peak 120 N m (1 x RS04): 37 % used |
| PASS | R_wrist_pitch | 1.5 N m x 1.5 in 'arms out to the sides' vs peak 14 N m (1 x RS00): 16 % used |
| PASS | L_wrist_pitch | 1.5 N m x 1.5 in 'arms out to the sides' vs peak 14 N m (1 x RS00): 16 % used |
| PASS | neck_pitch | 0.7 N m x 1.5 in 'deep squat' vs peak 14 N m (1 x RS00): 7 % used |
| PASS | R_hip_roll | 2.8 N m x 1.5 in 'single-leg stance (walking)' vs peak 120 N m (1 x RS04): 3 % used |
| PASS | R_wrist_yaw | 0.3 N m x 1.5 in 'carry 10 kg at the chest' vs peak 17 N m (1 x RS02): 3 % used |
| PASS | L_wrist_yaw | 0.3 N m x 1.5 in 'carry 10 kg at the chest' vs peak 17 N m (1 x RS02): 3 % used |
| PASS | R_hip_yaw | 0.8 N m x 1.5 in 'single-leg stance (walking)' vs peak 60 N m (1 x RS03): 2 % used |
| PASS | R_shoulder_yaw | 0.2 N m x 1.5 in 'arms straight out, 5 kg' vs peak 17 N m (1 x RS02): 2 % used |
| PASS | L_shoulder_yaw | 0.2 N m x 1.5 in 'arms straight out, 5 kg' vs peak 17 N m (1 x RS02): 2 % used |
| PASS | L_ankle_roll | 0.2 N m in 'stand' vs rated 15 N m (1 x RS06 x 1.3): 1 % used |
| PASS | R_ankle_roll | 0.2 N m in 'walk crouch' vs rated 15 N m (1 x RS06 x 1.3): 1 % used |
| PASS | neck_yaw | 0.0 N m x 1.5 in 'deep squat' vs peak 14 N m (1 x RS00): 0 % used |
| PASS | waist_yaw | 0.1 N m x 1.5 in 'step up a stair' vs peak 120 N m (1 x RS04): 0 % used |

## motorfit

| status | item | detail |
|---|---|---|
| PASS | waist_yaw actuator (buy) RS04 | clear |
| PASS | L_hip_pitch actuator (buy) RS04 | clear |
| PASS | neck_yaw actuator (buy) RS00 | clear |
| PASS | L_shoulder_pitch actuator (buy) RS04 | clear |
| PASS | neck_pitch actuator (buy) RS00 | clear |
| FAIL | L_shoulder_roll actuator (buy) RS06 | inside: L shoulder bracket 1.1 cm3 |
| PASS | L_shoulder_yaw actuator (buy) RS02 | clear |
| PASS | L_elbow actuator (buy) RS06 | clear |
| FAIL | L_wrist_yaw actuator (buy) RS02 | inside: L forearm frame 1.8 cm3 |
| FAIL | L_wrist_pitch actuator (buy) RS00 | inside: L forearm lower frame 0.5 cm3 |
| FAIL | L_wrist_roll actuator (buy) RS00 | inside: L wrist cheek 0.4 cm3 |
| PASS | L_hip_roll actuator (buy) RS04 | clear |
| PASS | L_hip_yaw actuator (buy) RS03 | clear |
| PASS | L_ankle_pitch actuator (buy) RS03 | clear |
| PASS | L_ankle_roll actuator (buy) RS06 | clear |
| PASS | L_knee actuator (buy) RS04 | clear |

## fastener

| status | item | detail |
|---|---|---|
| FAIL | L hip pitch stator: engagement | M4 x 10, 5.3 mm in the motor's drawn thread (1.32 d, the rule is 2.0 d). Strip force 15.5 kN at this length, so preload 6.4 kN, by 0.75 x proof |
| PASS | L hip pitch stator: tip inside its hole | 0.7 mm short of the 6.0 mm hole |
| PASS | L hip pitch stator: clear of what it does not belong in | head and shank clear; clearance holes and counterbores cut |
| PASS | L hip pitch stator: clear through the joints beside it | 3 joints swept, 13 steps |
| FAIL | waist stator: engagement | M4 x 10, 5.3 mm in the motor's drawn thread (1.33 d, the rule is 2.0 d). Strip force 15.5 kN at this length, so preload 6.4 kN, by 0.75 x proof |
| PASS | waist stator: tip inside its hole | 0.7 mm short of the 6.0 mm hole |
| PASS | waist stator: clear of what it does not belong in | head and shank clear; clearance holes and counterbores cut |
| PASS | waist stator: clear through the joints beside it | 3 joints swept, 13 steps |
| PASS | L hip pitch rim: engagement | M3 x 12, 7.8 mm in pelvis frame (2.60 d, the rule is 2.0 d). Strip force 27.4 kN at this length, so preload 3.7 kN, by 0.75 x proof |
| PASS | L hip pitch rim: tip inside its hole | 0.7 mm short of the 8.6 mm hole |
| PASS | L hip pitch rim: clear of what it does not belong in | head and shank clear; clearance holes and counterbores cut |
| PASS | L hip pitch rim: clear through the joints beside it | 3 joints swept, 13 steps |
| PASS | waist rim: engagement | M3 x 12, 7.8 mm in pelvis frame (2.60 d, the rule is 2.0 d). Strip force 27.4 kN at this length, so preload 3.7 kN, by 0.75 x proof |
| PASS | waist rim: tip inside its hole | 0.7 mm short of the 8.6 mm hole |
| PASS | waist rim: clear of what it does not belong in | head and shank clear; clearance holes and counterbores cut |
| PASS | waist rim: clear through the joints beside it | 3 joints swept, 13 steps |
| FAIL | R hip pitch stator: engagement | M4 x 10, 5.3 mm in the motor's drawn thread (1.32 d, the rule is 2.0 d). Strip force 15.5 kN at this length, so preload 6.4 kN, by 0.75 x proof |
| PASS | R hip pitch stator: tip inside its hole | 0.7 mm short of the 6.0 mm hole |
| PASS | R hip pitch stator: clear of what it does not belong in | head and shank clear; clearance holes and counterbores cut |
| PASS | R hip pitch stator: clear through the joints beside it | 3 joints swept, 13 steps |
| PASS | R hip pitch rim: engagement | M3 x 12, 7.8 mm in pelvis frame (2.60 d, the rule is 2.0 d). Strip force 27.4 kN at this length, so preload 3.7 kN, by 0.75 x proof |
| PASS | R hip pitch rim: tip inside its hole | 0.7 mm short of the 8.6 mm hole |
| PASS | R hip pitch rim: clear of what it does not belong in | head and shank clear; clearance holes and counterbores cut |
| PASS | R hip pitch rim: clear through the joints beside it | 3 joints swept, 13 steps |
| FAIL | waist hub: engagement | M5 x 12, 6.2 mm in the motor's drawn thread (1.24 d, the rule is 2.0 d). Strip force 22.7 kN at this length, so preload 10.3 kN, by 0.75 x proof |
| PASS | waist hub: tip inside its hole | 0.3 mm short of the 6.5 mm hole |
| PASS | waist hub: clear of what it does not belong in | head and shank clear; clearance holes and counterbores cut |
| PASS | waist hub: clear through the joints beside it | 4 joints swept, 13 steps |
| FAIL | L shoulder stator: engagement | M4 x 10, 5.3 mm in the motor's drawn thread (1.32 d, the rule is 2.0 d). Strip force 15.5 kN at this length, so preload 6.4 kN, by 0.75 x proof |
| PASS | L shoulder stator: tip inside its hole | 0.7 mm short of the 6.0 mm hole |
| PASS | L shoulder stator: clear of what it does not belong in | head and shank clear; clearance holes and counterbores cut |
| PASS | L shoulder stator: clear through the joints beside it | 4 joints swept, 13 steps |
| FAIL | neck stator: engagement | M3 x 8, 4.5 mm in the motor's drawn thread (1.50 d, the rule is 2.0 d). Strip force 9.9 kN at this length, so preload 3.7 kN, by 0.75 x proof |
| PASS | neck stator: tip inside its hole | 0.5 mm short of the 5.0 mm hole |
| FAIL | neck stator: clear of what it does not belong in | neck stator screw 6 in chest frame 1 mm3; neck stator screw 2 in chest frame 1 mm3; neck stator screw 1 in chest frame 1 mm3 |
| PASS | neck stator: clear through the joints beside it | 4 joints swept, 13 steps |
| FAIL | R shoulder stator: engagement | M4 x 10, 5.3 mm in the motor's drawn thread (1.32 d, the rule is 2.0 d). Strip force 15.5 kN at this length, so preload 6.4 kN, by 0.75 x proof |
| PASS | R shoulder stator: tip inside its hole | 0.7 mm short of the 6.0 mm hole |
| PASS | R shoulder stator: clear of what it does not belong in | head and shank clear; clearance holes and counterbores cut |
| PASS | R shoulder stator: clear through the joints beside it | 4 joints swept, 13 steps |
| FAIL | neck pitch stator: engagement | M3 x 8, 4.0 mm in the motor's drawn thread (1.33 d, the rule is 2.0 d). Strip force 8.8 kN at this length, so preload 3.7 kN, by 0.75 x proof |
| PASS | neck pitch stator: tip inside its hole | 1.0 mm short of the 5.0 mm hole |
| PASS | neck pitch stator: clear of what it does not belong in | head and shank clear; clearance holes and counterbores cut |
| PASS | neck pitch stator: clear through the joints beside it | 2 joints swept, 13 steps |
| FAIL | neck yaw hub: engagement | M3 x 12, 4.2 mm in the motor's drawn thread (1.40 d, the rule is 2.0 d). Strip force 9.2 kN at this length, so preload 3.7 kN, by 0.75 x proof |
| PASS | neck yaw hub: tip inside its hole | 0.8 mm short of the 5.0 mm hole |
| PASS | neck yaw hub: clear of what it does not belong in | head and shank clear; clearance holes and counterbores cut |
| PASS | neck yaw hub: clear through the joints beside it | 2 joints swept, 13 steps |
| FAIL | neck pitch hub: engagement | M3 x 12, 4.3 mm in the motor's drawn thread (1.43 d, the rule is 2.0 d). Strip force 9.4 kN at this length, so preload 3.7 kN, by 0.75 x proof |
| PASS | neck pitch hub: tip inside its hole | 0.7 mm short of the 5.0 mm hole |
| PASS | neck pitch hub: clear of what it does not belong in | head and shank clear; clearance holes and counterbores cut |
| PASS | neck pitch hub: clear through the joints beside it | 1 joints swept, 13 steps |
| FAIL | L hip roll stator: engagement | M4 x 10, 5.3 mm in the motor's drawn thread (1.32 d, the rule is 2.0 d). Strip force 15.5 kN at this length, so preload 6.4 kN, by 0.75 x proof |
| PASS | L hip roll stator: tip inside its hole | 0.7 mm short of the 6.0 mm hole |
| PASS | L hip roll stator: clear of what it does not belong in | head and shank clear; clearance holes and counterbores cut |
| PASS | L hip roll stator: clear through the joints beside it | 2 joints swept, 13 steps |
| FAIL | L hip pitch hub: engagement | M5 x 12, 6.2 mm in the motor's drawn thread (1.24 d, the rule is 2.0 d). Strip force 22.7 kN at this length, so preload 10.3 kN, by 0.75 x proof |
| PASS | L hip pitch hub: tip inside its hole | 0.3 mm short of the 6.5 mm hole |
| PASS | L hip pitch hub: clear of what it does not belong in | head and shank clear; clearance holes and counterbores cut |
| PASS | L hip pitch hub: clear through the joints beside it | 2 joints swept, 13 steps |
| FAIL | L hip roll hub: engagement | M5 x 12, 6.2 mm in the motor's drawn thread (1.24 d, the rule is 2.0 d). Strip force 22.7 kN at this length, so preload 10.3 kN, by 0.75 x proof |
| PASS | L hip roll hub: tip inside its hole | 0.3 mm short of the 6.5 mm hole |
| PASS | L hip roll hub: clear of what it does not belong in | head and shank clear; clearance holes and counterbores cut |
| PASS | L hip roll hub: clear through the joints beside it | 2 joints swept, 13 steps |
| FAIL | L hip yaw stator: engagement | M4 x 10, 4.8 mm in the motor's drawn thread (1.20 d, the rule is 2.0 d). Strip force 14.0 kN at this length, so preload 6.4 kN, by 0.75 x proof |
| PASS | L hip yaw stator: tip inside its hole | 3.2 mm short of the 8.0 mm hole |
| PASS | L hip yaw stator: clear of what it does not belong in | head and shank clear; clearance holes and counterbores cut |
| PASS | L hip yaw stator: clear through the joints beside it | 2 joints swept, 13 steps |
| PASS | L hip yaw rim: engagement | M3 x 12, 6.8 mm in L hip yoke (2.27 d, the rule is 2.0 d). Strip force 23.9 kN at this length, so preload 3.7 kN, by 0.75 x proof |
| PASS | L hip yaw rim: tip inside its hole | 0.7 mm short of the 7.5 mm hole |
| PASS | L hip yaw rim: clear of what it does not belong in | head and shank clear; clearance holes and counterbores cut |
| PASS | L hip yaw rim: clear through the joints beside it | 2 joints swept, 13 steps |
| FAIL | L knee hub: engagement | M5 x 12, 6.2 mm in the motor's drawn thread (1.24 d, the rule is 2.0 d). Strip force 22.7 kN at this length, so preload 10.3 kN, by 0.75 x proof |
| PASS | L knee hub: tip inside its hole | 0.3 mm short of the 6.5 mm hole |
| PASS | L knee hub: clear of what it does not belong in | head and shank clear; clearance holes and counterbores cut |
| PASS | L knee hub: clear through the joints beside it | 2 joints swept, 13 steps |
| PASS | L knee cheek top: engagement | M5 x 14, 11.5 mm in L thigh fork (2.29 d, the rule is 2.0 d). Strip force 67.0 kN at this length, so preload 10.3 kN, by 0.75 x proof |
| PASS | L knee cheek top: tip inside its hole | 1.2 mm short of the 12.6 mm hole |
| PASS | L knee cheek top: clear of what it does not belong in | head and shank clear; clearance holes and counterbores cut |
| PASS | L knee cheek top: clear through the joints beside it | 2 joints swept, 13 steps |
| PASS | L knee cheek: engagement | M5 x 16, 10.0 mm in L thigh fork (2.01 d, the rule is 2.0 d). Strip force 58.8 kN at this length, so preload 10.3 kN, by 0.75 x proof |
| PASS | L knee cheek: tip inside its hole | 1.2 mm short of the 11.2 mm hole |
| PASS | L knee cheek: clear of what it does not belong in | head and shank clear; clearance holes and counterbores cut |
| PASS | L knee cheek: clear through the joints beside it | 2 joints swept, 13 steps |
| FAIL | L hip yaw hub: engagement | M4 x 10, 5.5 mm in the motor's drawn thread (1.38 d, the rule is 2.0 d). Strip force 16.1 kN at this length, so preload 6.4 kN, by 0.75 x proof |
| PASS | L hip yaw hub: tip inside its hole | 0.5 mm short of the 6.0 mm hole |
| PASS | L hip yaw hub: clear of what it does not belong in | head and shank clear; clearance holes and counterbores cut |
| PASS | L hip yaw hub: clear through the joints beside it | 2 joints swept, 13 steps |
| PASS | L thigh collar: engagement | M4 x 12, 8.0 mm in L_hip_yaw flange (2.00 d, the rule is 2.0 d). Strip force 37.4 kN at this length, so preload 6.4 kN, by 0.75 x proof |
| PASS | L thigh collar: tip inside its hole | 1.0 mm short of the 9.1 mm hole |
| PASS | L thigh collar: clear of what it does not belong in | head and shank clear; clearance holes and counterbores cut |
| PASS | L thigh collar: clear through the joints beside it | 2 joints swept, 13 steps |
| FAIL | L knee stator: engagement | M4 x 10, 4.7 mm in the motor's drawn thread (1.19 d, the rule is 2.0 d). Strip force 13.9 kN at this length, so preload 6.4 kN, by 0.75 x proof |
| PASS | L knee stator: tip inside its hole | 0.3 mm short of the 5.0 mm hole |
| PASS | L knee stator: clear of what it does not belong in | head and shank clear; clearance holes and counterbores cut |
| PASS | L knee stator: clear through the joints beside it | 2 joints swept, 13 steps |
| PASS | L knee rim: engagement | M3 x 10, 7.0 mm in L shank body (2.35 d, the rule is 2.0 d). Strip force 24.7 kN at this length, so preload 3.7 kN, by 0.75 x proof |
| PASS | L knee rim: tip inside its hole | 0.8 mm short of the 7.8 mm hole |
| PASS | L knee rim: clear of what it does not belong in | head and shank clear; clearance holes and counterbores cut |
| PASS | L knee rim: clear through the joints beside it | 2 joints swept, 13 steps |
| PASS | L knee post: engagement | M4 x 10, 8.4 mm in L knee rear cap (2.10 d, the rule is 2.0 d). Strip force 39.3 kN at this length, so preload 6.4 kN, by 0.75 x proof |
| PASS | L knee post: tip inside its hole | 1.0 mm short of the 9.4 mm hole |
| PASS | L knee post: clear of what it does not belong in | head and shank clear; clearance holes and counterbores cut |
| PASS | L knee post: clear through the joints beside it | 2 joints swept, 13 steps |
| PASS | L knee hub in foot: engagement | M4 x 12, 9.2 mm in L shank body (2.30 d, the rule is 2.0 d). Strip force 43.0 kN at this length, so preload 6.4 kN, by 0.75 x proof |
| PASS | L knee hub in foot: tip inside its hole | 1.1 mm short of the 10.2 mm hole |
| PASS | L knee hub in foot: clear of what it does not belong in | head and shank clear; clearance holes and counterbores cut |
| PASS | L knee hub in foot: clear through the joints beside it | 2 joints swept, 13 steps |
| PASS | L knee hub out foot: engagement | M4 x 12, 9.2 mm in L shank body (2.30 d, the rule is 2.0 d). Strip force 43.0 kN at this length, so preload 6.4 kN, by 0.75 x proof |
| PASS | L knee hub out foot: tip inside its hole | 1.0 mm short of the 10.2 mm hole |
| PASS | L knee hub out foot: clear of what it does not belong in | head and shank clear; clearance holes and counterbores cut |
| PASS | L knee hub out foot: clear through the joints beside it | 2 joints swept, 13 steps |
| PASS | L shank panel: engagement | M3 x 10, 7.0 mm in L shank body (2.33 d, the rule is 2.0 d). Strip force 24.6 kN at this length, so preload 3.7 kN, by 0.75 x proof |
| PASS | L shank panel: tip inside its hole | 0.8 mm short of the 7.8 mm hole |
| PASS | L shank panel: clear of what it does not belong in | head and shank clear; clearance holes and counterbores cut |
| PASS | L shank panel: clear through the joints beside it | 2 joints swept, 13 steps |
| FAIL | L ankle pitch stator: engagement | M4 x 12, 7.8 mm in the motor's drawn thread (1.95 d, the rule is 2.0 d). Strip force 22.8 kN at this length, so preload 6.4 kN, by 0.75 x proof |
| PASS | L ankle pitch stator: tip inside its hole | 0.2 mm short of the 8.0 mm hole |
| PASS | L ankle pitch stator: clear of what it does not belong in | head and shank clear; clearance holes and counterbores cut |
| PASS | L ankle pitch stator: clear through the joints beside it | 2 joints swept, 13 steps |
| PASS | L ankle roll stator: engagement | M3 x 12, 8.0 mm in the motor's drawn thread (2.67 d, the rule is 2.0 d). Strip force 17.6 kN at this length, so preload 3.7 kN, by 0.75 x proof |
| PASS | L ankle roll stator: tip inside its hole | 0.5 mm short of the 8.5 mm hole |
| PASS | L ankle roll stator: clear of what it does not belong in | head and shank clear; clearance holes and counterbores cut |
| PASS | L ankle roll stator: clear through the joints beside it | 2 joints swept, 13 steps |
| FAIL | L ankle pitch hub: engagement | M4 x 12, 5.8 mm in the motor's drawn thread (1.45 d, the rule is 2.0 d). Strip force 17.0 kN at this length, so preload 6.4 kN, by 0.75 x proof |
| PASS | L ankle pitch hub: tip inside its hole | 0.2 mm short of the 6.0 mm hole |
| PASS | L ankle pitch hub: clear of what it does not belong in | head and shank clear; clearance holes and counterbores cut |
| PASS | L ankle pitch hub: clear through the joints beside it | 2 joints swept, 13 steps |
| FAIL | L ankle roll hub: engagement | M4 x 12, 6.0 mm in the motor's drawn thread (1.50 d, the rule is 2.0 d). Strip force 17.6 kN at this length, so preload 6.4 kN, by 0.75 x proof |
| PASS | L ankle roll hub: tip inside its hole | 0.0 mm short of the 6.0 mm hole |
| PASS | L ankle roll hub: clear of what it does not belong in | head and shank clear; clearance holes and counterbores cut |
| PASS | L ankle roll hub: clear through the joints beside it | 2 joints swept, 13 steps |
| PASS | L ankle roll post: engagement | M4 x 25, 11.0 mm in L ankle roll post (2.75 d, the rule is 2.0 d). Strip force 51.5 kN at this length, so preload 6.4 kN, by 0.75 x proof |
| PASS | L ankle roll post: tip inside its hole | 1.0 mm short of the 12.1 mm hole |
| PASS | L ankle roll post: clear of what it does not belong in | head and shank clear; clearance holes and counterbores cut |
| PASS | L ankle roll post: clear through the joints beside it | 1 joints swept, 13 steps |
| PASS | L hip pitch stator: under the skin | shows on purpose: a real screw in sight, as the design means it |
| PASS | waist stator: under the skin | all inside |
| PASS | L hip pitch rim: under the skin | all inside |
| PASS | waist rim: under the skin | all inside |
| PASS | R hip pitch stator: under the skin | shows on purpose: a real screw in sight, as the design means it |
| PASS | R hip pitch rim: under the skin | all inside |
| PASS | waist hub: under the skin | all inside |
| PASS | L shoulder stator: under the skin | all inside |
| PASS | neck stator: under the skin | all inside |
| PASS | R shoulder stator: under the skin | all inside |
| PASS | neck pitch stator: under the skin | shows on purpose: a real screw in sight, as the design means it |
| PASS | neck yaw hub: under the skin | all inside |
| PASS | neck pitch hub: under the skin | shows on purpose: a real screw in sight, as the design means it |
| PASS | L hip roll stator: under the skin | shows on purpose: a real screw in sight, as the design means it |
| PASS | L hip pitch hub: under the skin | shows on purpose: a real screw in sight, as the design means it |
| PASS | L hip roll hub: under the skin | shows on purpose: a real screw in sight, as the design means it |
| PASS | L hip yaw stator: under the skin | all inside |
| PASS | L hip yaw rim: under the skin | all inside |
| PASS | L knee hub: under the skin | all inside |
| PASS | L knee cheek top: under the skin | all inside |
| PASS | L knee cheek: under the skin | all inside |
| PASS | L hip yaw hub: under the skin | all inside |
| PASS | L thigh collar: under the skin | all inside |
| PASS | L knee stator: under the skin | all inside |
| PASS | L knee rim: under the skin | all inside |
| PASS | L knee post: under the skin | all inside |
| PASS | L knee hub in foot: under the skin | all inside |
| PASS | L knee hub out foot: under the skin | all inside |
| PASS | L shank panel: under the skin | all inside |
| PASS | L ankle pitch stator: under the skin | shows on purpose: a real screw in sight, as the design means it |
| PASS | L ankle roll stator: under the skin | shows on purpose: a real screw in sight, as the design means it |
| PASS | L ankle pitch hub: under the skin | shows on purpose: a real screw in sight, as the design means it |
| PASS | L ankle roll hub: under the skin | shows on purpose: a real screw in sight, as the design means it |
| PASS | L ankle roll post: under the skin | all inside |

## holes

| status | item | detail |
|---|---|---|
| PASS | L hip pitch stator, clearance d4.5: edge distance | 5.5 mm to the edge of pelvis frame (needs 5.4) |
| PASS | L hip pitch stator, clearance d4.5: ligament | 28.3 mm to the next hole in pelvis frame (needs 2.2) |
| PASS | waist stator, clearance d4.5: edge distance | 5.5 mm to the edge of pelvis frame (needs 5.4) |
| PASS | waist stator, clearance d4.5: ligament | 28.3 mm to the next hole in pelvis frame (needs 2.2) |
| PASS | L hip pitch rim screw 1, clearance d3.4: edge distance | 5.3 mm to the edge of L hip ring (needs 4.1) |
| PASS | L hip pitch rim screw 1, clearance d3.4: ligament | 59.7 mm to the next hole in L hip ring (needs 1.7) |
| PASS | L hip pitch rim screw 1, tapped d2.5: edge distance | 3.1 mm to the edge of pelvis frame (needs 3.0) |
| PASS | L hip pitch rim screw 1, tapped d2.5: ligament | 60.6 mm to the next hole in pelvis frame (needs 1.5) |
| PASS | L hip pitch rim screw 2, clearance d3.4: edge distance | 5.3 mm to the edge of L hip ring (needs 4.1) |
| PASS | L hip pitch rim screw 2, clearance d3.4: ligament | 59.7 mm to the next hole in L hip ring (needs 1.7) |
| PASS | L hip pitch rim screw 2, tapped d2.5: edge distance | 3.0 mm to the edge of pelvis frame (needs 3.0) |
| PASS | L hip pitch rim screw 2, tapped d2.5: ligament | 60.6 mm to the next hole in pelvis frame (needs 1.5) |
| PASS | L hip pitch rim screw 3, clearance d3.4: edge distance | 5.3 mm to the edge of L hip ring (needs 4.1) |
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
| PASS | R hip pitch rim screw 6, tapped d2.5: ligament | 60.6 mm to the next hole in pelvis frame (needs 1.5) |
| PASS | waist hub, clearance d5.5: edge distance | 7.0 mm to the edge of waist_yaw flange (needs 6.6) |
| PASS | waist hub, clearance d5.5: ligament | 3.5 mm to the next hole in waist_yaw flange (needs 2.8) |
| FAIL | waist_yaw flange pin hole, pin d6.0: edge distance | 7.0 mm to the edge of waist_yaw flange (needs 7.2) |
| PASS | waist_yaw flange pin hole, pin d6.0: ligament | 3.5 mm to the next hole in waist_yaw flange (needs 3.0) |
| PASS | L shoulder stator, clearance d4.5: edge distance | 5.5 mm to the edge of chest frame (needs 5.4) |
| PASS | L shoulder stator, clearance d4.5: ligament | 28.3 mm to the next hole in chest frame (needs 2.2) |
| PASS | neck stator, clearance d3.4: edge distance | 4.5 mm to the edge of chest frame (needs 4.1) |
| PASS | neck stator, clearance d3.4: ligament | 21.6 mm to the next hole in chest frame (needs 1.7) |
| PASS | R shoulder stator, clearance d4.5: edge distance | 5.5 mm to the edge of chest frame (needs 5.4) |
| PASS | R shoulder stator, clearance d4.5: ligament | 28.3 mm to the next hole in chest frame (needs 2.2) |
| PASS | neck pitch stator, clearance d3.4: edge distance | 5.5 mm to the edge of neck housing (needs 4.1) |
| PASS | neck pitch stator, clearance d3.4: ligament | 21.6 mm to the next hole in neck housing (needs 1.7) |
| PASS | neck yaw hub, clearance d3.4: edge distance | 5.0 mm to the edge of neck_yaw flange + neck housing (needs 4.1) |
| PASS | neck yaw hub, clearance d3.4: ligament | 10.1 mm to the next hole in neck_yaw flange + neck housing (needs 1.7) |
| PASS | neck pitch hub, clearance d3.4: edge distance | 5.0 mm to the edge of neck_pitch flange + head frame (needs 4.1) |
| PASS | neck pitch hub, clearance d3.4: ligament | 10.1 mm to the next hole in neck_pitch flange + head frame (needs 1.7) |
| PASS | neck pitch hub, counterbore d6.3: edge distance | 5.0 mm to the edge of neck_pitch flange + head frame (needs 4.7) |
| PASS | neck pitch hub, counterbore d6.3: ligament | 7.2 mm to the next hole in neck_pitch flange + head frame (needs 1.5) |
| PASS | L hip roll stator, clearance d4.5: edge distance | 5.5 mm to the edge of L hip carrier (needs 5.4) |
| PASS | L hip roll stator, clearance d4.5: ligament | 28.3 mm to the next hole in L hip carrier (needs 2.2) |
| PASS | L hip pitch hub, clearance d5.5: edge distance | 7.0 mm to the edge of L_hip_pitch flange (needs 6.6) |
| PASS | L hip pitch hub, clearance d5.5: ligament | 3.5 mm to the next hole in L_hip_pitch flange (needs 2.8) |
| FAIL | L_hip_pitch flange pin hole, pin d6.0: edge distance | 7.0 mm to the edge of L_hip_pitch flange (needs 7.2) |
| PASS | L_hip_pitch flange pin hole, pin d6.0: ligament | 3.5 mm to the next hole in L_hip_pitch flange (needs 3.0) |
| PASS | L hip roll hub, clearance d5.5: edge distance | 10.5 mm to the edge of L_hip_roll flange (needs 6.6) |
| PASS | L hip roll hub, clearance d5.5: ligament | 3.5 mm to the next hole in L_hip_roll flange (needs 2.8) |
| PASS | L_hip_roll flange pin hole, pin d6.0: edge distance | 10.6 mm to the edge of L_hip_roll flange (needs 7.2) |
| PASS | L_hip_roll flange pin hole, pin d6.0: ligament | 3.5 mm to the next hole in L_hip_roll flange (needs 3.0) |
| FAIL | L hip yaw stator, clearance d4.5: edge distance | 3.4 mm to the edge of L hip yaw ring (needs 5.4) |
| PASS | L hip yaw stator, clearance d4.5: ligament | 6.0 mm to the next hole in L hip yaw ring (needs 2.2) |
| PASS | L hip yaw rim screw 1, clearance d3.4: edge distance | 4.2 mm to the edge of L hip yaw ring (needs 4.1) |
| PASS | L hip yaw rim screw 1, clearance d3.4: ligament | 6.0 mm to the next hole in L hip yaw ring (needs 1.7) |
| PASS | L hip yaw rim screw 1, tapped d2.5: edge distance | 3.1 mm to the edge of L hip yoke (needs 3.0) |
| PASS | L hip yaw rim screw 1, tapped d2.5: ligament | 53.7 mm to the next hole in L hip yoke (needs 1.5) |
| PASS | L hip yaw rim screw 2, clearance d3.4: edge distance | 4.2 mm to the edge of L hip yaw ring (needs 4.1) |
| PASS | L hip yaw rim screw 2, clearance d3.4: ligament | 17.8 mm to the next hole in L hip yaw ring (needs 1.7) |
| PASS | L hip yaw rim screw 2, tapped d2.5: edge distance | 3.2 mm to the edge of L hip yoke (needs 3.0) |
| PASS | L hip yaw rim screw 2, tapped d2.5: ligament | 53.7 mm to the next hole in L hip yoke (needs 1.5) |
| PASS | L hip yaw rim screw 3, clearance d3.4: edge distance | 4.2 mm to the edge of L hip yaw ring (needs 4.1) |
| PASS | L hip yaw rim screw 3, clearance d3.4: ligament | 6.0 mm to the next hole in L hip yaw ring (needs 1.7) |
| PASS | L hip yaw rim screw 3, tapped d2.5: edge distance | 3.2 mm to the edge of L hip yoke (needs 3.0) |
| PASS | L hip yaw rim screw 3, tapped d2.5: ligament | 53.7 mm to the next hole in L hip yoke (needs 1.5) |
| PASS | L hip yaw rim screw 4, clearance d3.4: edge distance | 4.2 mm to the edge of L hip yaw ring (needs 4.1) |
| PASS | L hip yaw rim screw 4, clearance d3.4: ligament | 6.0 mm to the next hole in L hip yaw ring (needs 1.7) |
| PASS | L hip yaw rim screw 4, tapped d2.5: edge distance | 3.1 mm to the edge of L hip yoke (needs 3.0) |
| PASS | L hip yaw rim screw 4, tapped d2.5: ligament | 53.7 mm to the next hole in L hip yoke (needs 1.5) |
| PASS | L hip yaw rim screw 5, clearance d3.4: edge distance | 4.2 mm to the edge of L hip yaw ring (needs 4.1) |
| PASS | L hip yaw rim screw 5, clearance d3.4: ligament | 17.8 mm to the next hole in L hip yaw ring (needs 1.7) |
| PASS | L hip yaw rim screw 5, tapped d2.5: edge distance | 3.2 mm to the edge of L hip yoke (needs 3.0) |
| PASS | L hip yaw rim screw 5, tapped d2.5: ligament | 53.7 mm to the next hole in L hip yoke (needs 1.5) |
| PASS | L hip yaw rim screw 6, clearance d3.4: edge distance | 4.2 mm to the edge of L hip yaw ring (needs 4.1) |
| PASS | L hip yaw rim screw 6, clearance d3.4: ligament | 6.0 mm to the next hole in L hip yaw ring (needs 1.7) |
| PASS | L hip yaw rim screw 6, tapped d2.5: edge distance | 3.2 mm to the edge of L hip yoke (needs 3.0) |
| PASS | L hip yaw rim screw 6, tapped d2.5: ligament | 53.7 mm to the next hole in L hip yoke (needs 1.5) |
| PASS | L knee hub, clearance d5.5: edge distance | 7.0 mm to the edge of L_knee flange (needs 6.6) |
| PASS | L knee hub, clearance d5.5: ligament | 3.5 mm to the next hole in L_knee flange (needs 2.8) |
| FAIL | L knee hub pin hole, pin d6.0: edge distance | 7.0 mm to the edge of L_knee flange (needs 7.2) |
| PASS | L knee hub pin hole, pin d6.0: ligament | 3.5 mm to the next hole in L_knee flange (needs 3.0) |
| PASS | L knee cheek top screw 1, clearance d5.5: edge distance | 12.0 mm to the edge of L knee outer cheek (needs 6.6) |
| PASS | L knee cheek top screw 1, clearance d5.5: ligament | 23.1 mm to the next hole in L knee outer cheek (needs 2.8) |
| PASS | L knee cheek top screw 1, tapped d4.2: edge distance | 6.3 mm to the edge of L thigh fork (needs 5.0) |
| PASS | L knee cheek top screw 1, tapped d4.2: ligament | 24.4 mm to the next hole in L thigh fork (needs 2.1) |
| PASS | L knee cheek top screw 2, clearance d5.5: edge distance | 12.0 mm to the edge of L knee outer cheek (needs 6.6) |
| PASS | L knee cheek top screw 2, clearance d5.5: ligament | 23.1 mm to the next hole in L knee outer cheek (needs 2.8) |
| PASS | L knee cheek top screw 2, tapped d4.2: edge distance | 6.3 mm to the edge of L thigh fork (needs 5.0) |
| PASS | L knee cheek top screw 2, tapped d4.2: ligament | 24.4 mm to the next hole in L thigh fork (needs 2.1) |
| PASS | L knee cheek screw 1, clearance d5.5: edge distance | 16.0 mm to the edge of L knee outer cheek (needs 6.6) |
| PASS | L knee cheek screw 1, clearance d5.5: ligament | 20.9 mm to the next hole in L knee outer cheek (needs 2.8) |
| PASS | L knee cheek screw 1, tapped d4.2: edge distance | 6.5 mm to the edge of L thigh fork (needs 5.0) |
| PASS | L knee cheek screw 1, tapped d4.2: ligament | 24.4 mm to the next hole in L thigh fork (needs 2.1) |
| PASS | L knee cheek screw 2, clearance d5.5: edge distance | 16.0 mm to the edge of L knee outer cheek (needs 6.6) |
| PASS | L knee cheek screw 2, clearance d5.5: ligament | 20.9 mm to the next hole in L knee outer cheek (needs 2.8) |
| PASS | L knee cheek screw 2, tapped d4.2: edge distance | 6.5 mm to the edge of L thigh fork (needs 5.0) |
| PASS | L knee cheek screw 2, tapped d4.2: ligament | 24.4 mm to the next hole in L thigh fork (needs 2.1) |
| PASS | L hip yaw hub, clearance d4.5: edge distance | 29.3 mm to the edge of L_hip_yaw flange (needs 5.4) |
| PASS | L hip yaw hub, clearance d4.5: ligament | 10.7 mm to the next hole in L_hip_yaw flange (needs 2.2) |
| PASS | L hip yaw hub, counterbore d7.6: edge distance | 5.3 mm to the edge of L_hip_yaw flange (needs 5.3) |
| PASS | L hip yaw hub, counterbore d7.6: ligament | 7.6 mm to the next hole in L_hip_yaw flange (needs 1.5) |
| PASS | L thigh collar screw 1, clearance d4.5: edge distance | 5.5 mm to the edge of L thigh fork (needs 5.4) |
| PASS | L thigh collar screw 1, clearance d4.5: ligament | 34.5 mm to the next hole in L thigh fork (needs 2.2) |
| PASS | L thigh collar screw 1, tapped d3.3: edge distance | 5.5 mm to the edge of L_hip_yaw flange (needs 4.0) |
| PASS | L thigh collar screw 1, tapped d3.3: ligament | 19.2 mm to the next hole in L_hip_yaw flange (needs 1.6) |
| PASS | L thigh collar screw 2, clearance d4.5: edge distance | 5.5 mm to the edge of L thigh fork (needs 5.4) |
| PASS | L thigh collar screw 2, clearance d4.5: ligament | 34.5 mm to the next hole in L thigh fork (needs 2.2) |
| PASS | L thigh collar screw 2, tapped d3.3: edge distance | 5.5 mm to the edge of L_hip_yaw flange (needs 4.0) |
| PASS | L thigh collar screw 2, tapped d3.3: ligament | 19.2 mm to the next hole in L_hip_yaw flange (needs 1.6) |
| PASS | L thigh collar screw 3, clearance d4.5: edge distance | 5.5 mm to the edge of L thigh fork (needs 5.4) |
| PASS | L thigh collar screw 3, clearance d4.5: ligament | 34.5 mm to the next hole in L thigh fork (needs 2.2) |
| PASS | L thigh collar screw 3, tapped d3.3: edge distance | 5.5 mm to the edge of L_hip_yaw flange (needs 4.0) |
| PASS | L thigh collar screw 3, tapped d3.3: ligament | 19.2 mm to the next hole in L_hip_yaw flange (needs 1.6) |
| PASS | L thigh collar screw 4, clearance d4.5: edge distance | 5.5 mm to the edge of L thigh fork (needs 5.4) |
| PASS | L thigh collar screw 4, clearance d4.5: ligament | 34.5 mm to the next hole in L thigh fork (needs 2.2) |
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
| PASS | L knee post screw 1, tapped d3.3: edge distance | 6.0 mm to the edge of L knee rear cap (needs 4.0) |
| PASS | L knee post screw 1, tapped d3.3: ligament | 22.9 mm to the next hole in L knee rear cap (needs 1.6) |
| PASS | L knee post screw 2, clearance d4.5: edge distance | 6.0 mm to the edge of L knee post washer (needs 5.4) |
| PASS | L knee post screw 2, clearance d4.5: ligament | 21.7 mm to the next hole in L knee post washer (needs 2.2) |
| PASS | L knee post screw 2, tapped d3.3: edge distance | 6.0 mm to the edge of L knee rear cap (needs 4.0) |
| PASS | L knee post screw 2, tapped d3.3: ligament | 22.9 mm to the next hole in L knee rear cap (needs 1.6) |
| PASS | L knee post screw 3, clearance d4.5: edge distance | 6.0 mm to the edge of L knee post washer (needs 5.4) |
| PASS | L knee post screw 3, clearance d4.5: ligament | 21.7 mm to the next hole in L knee post washer (needs 2.2) |
| PASS | L knee post screw 3, tapped d3.3: edge distance | 6.0 mm to the edge of L knee rear cap (needs 4.0) |
| PASS | L knee post screw 3, tapped d3.3: ligament | 22.9 mm to the next hole in L knee rear cap (needs 1.6) |
| PASS | L knee post screw 4, clearance d4.5: edge distance | 6.0 mm to the edge of L knee post washer (needs 5.4) |
| PASS | L knee post screw 4, clearance d4.5: ligament | 21.7 mm to the next hole in L knee post washer (needs 2.2) |
| PASS | L knee post screw 4, tapped d3.3: edge distance | 6.0 mm to the edge of L knee rear cap (needs 4.0) |
| PASS | L knee post screw 4, tapped d3.3: ligament | 22.9 mm to the next hole in L knee rear cap (needs 1.6) |
| PASS | L knee hub in foot screw 1, clearance d4.5: edge distance | 9.7 mm to the edge of L knee hub in (needs 5.4) |
| PASS | L knee hub in foot screw 1, clearance d4.5: ligament | 9.0 mm to the next hole in L knee hub in (needs 2.2) |
| PASS | L knee hub in foot screw 1, tapped d3.3: edge distance | 7.2 mm to the edge of L shank body (needs 4.0) |
| PASS | L knee hub in foot screw 1, tapped d3.3: ligament | 10.2 mm to the next hole in L shank body (needs 1.6) |
| PASS | L knee hub in foot screw 2, clearance d4.5: edge distance | 7.1 mm to the edge of L knee hub in (needs 5.4) |
| PASS | L knee hub in foot screw 2, clearance d4.5: ligament | 9.0 mm to the next hole in L knee hub in (needs 2.2) |
| PASS | L knee hub in foot screw 2, tapped d3.3: edge distance | 7.2 mm to the edge of L shank body (needs 4.0) |
| PASS | L knee hub in foot screw 2, tapped d3.3: ligament | 10.2 mm to the next hole in L shank body (needs 1.6) |
| PASS | L knee hub out foot screw 1, clearance d4.5: edge distance | 9.7 mm to the edge of L knee hub out (needs 5.4) |
| PASS | L knee hub out foot screw 1, clearance d4.5: ligament | 9.0 mm to the next hole in L knee hub out (needs 2.2) |
| PASS | L knee hub out foot screw 1, tapped d3.3: edge distance | 7.2 mm to the edge of L shank body (needs 4.0) |
| PASS | L knee hub out foot screw 1, tapped d3.3: ligament | 10.2 mm to the next hole in L shank body (needs 1.6) |
| PASS | L knee hub out foot screw 2, clearance d4.5: edge distance | 7.1 mm to the edge of L knee hub out (needs 5.4) |
| PASS | L knee hub out foot screw 2, clearance d4.5: ligament | 9.0 mm to the next hole in L knee hub out (needs 2.2) |
| PASS | L knee hub out foot screw 2, tapped d3.3: edge distance | 7.2 mm to the edge of L shank body (needs 4.0) |
| PASS | L knee hub out foot screw 2, tapped d3.3: ligament | 10.2 mm to the next hole in L shank body (needs 1.6) |
| PASS | L shank panel screw 1, clearance d3.4: edge distance | 6.1 mm to the edge of L shank back panel (needs 4.1) |
| PASS | L shank panel screw 1, clearance d3.4: ligament | 36.2 mm to the next hole in L shank back panel (needs 1.7) |
| PASS | L shank panel screw 1, tapped d2.5: edge distance | 5.1 mm to the edge of L shank body (needs 3.0) |
| PASS | L shank panel screw 1, tapped d2.5: ligament | 31.8 mm to the next hole in L shank body (needs 1.5) |
| PASS | L shank panel screw 2, clearance d3.4: edge distance | 7.0 mm to the edge of L shank back panel (needs 4.1) |
| PASS | L shank panel screw 2, clearance d3.4: ligament | 26.2 mm to the next hole in L shank back panel (needs 1.7) |
| PASS | L shank panel screw 2, tapped d2.5: edge distance | 9.9 mm to the edge of L shank body (needs 3.0) |
| PASS | L shank panel screw 2, tapped d2.5: ligament | 5.7 mm to the next hole in L shank body (needs 1.5) |
| PASS | L shank panel screw 3, clearance d3.4: edge distance | 7.0 mm to the edge of L shank back panel (needs 4.1) |
| PASS | L shank panel screw 3, clearance d3.4: ligament | 26.2 mm to the next hole in L shank back panel (needs 1.7) |
| PASS | L shank panel screw 3, tapped d2.5: edge distance | 7.0 mm to the edge of L shank body (needs 3.0) |
| PASS | L shank panel screw 3, tapped d2.5: ligament | 21.8 mm to the next hole in L shank body (needs 1.5) |
| PASS | L shank panel screw 4, clearance d3.4: edge distance | 6.1 mm to the edge of L shank back panel (needs 4.1) |
| PASS | L shank panel screw 4, clearance d3.4: ligament | 36.2 mm to the next hole in L shank back panel (needs 1.7) |
| PASS | L shank panel screw 4, tapped d2.5: edge distance | 7.0 mm to the edge of L shank body (needs 3.0) |
| PASS | L shank panel screw 4, tapped d2.5: ligament | 8.1 mm to the next hole in L shank body (needs 1.5) |
| PASS | L shank panel screw 5, clearance d3.4: edge distance | 7.0 mm to the edge of L shank back panel (needs 4.1) |
| PASS | L shank panel screw 5, clearance d3.4: ligament | 26.2 mm to the next hole in L shank back panel (needs 1.7) |
| PASS | L shank panel screw 5, tapped d2.5: edge distance | 7.0 mm to the edge of L shank body (needs 3.0) |
| PASS | L shank panel screw 5, tapped d2.5: ligament | 27.5 mm to the next hole in L shank body (needs 1.5) |
| PASS | L shank panel screw 6, clearance d3.4: edge distance | 7.0 mm to the edge of L shank back panel (needs 4.1) |
| PASS | L shank panel screw 6, clearance d3.4: ligament | 26.2 mm to the next hole in L shank back panel (needs 1.7) |
| PASS | L shank panel screw 6, tapped d2.5: edge distance | 7.0 mm to the edge of L shank body (needs 3.0) |
| PASS | L shank panel screw 6, tapped d2.5: ligament | 27.5 mm to the next hole in L shank body (needs 1.5) |
| FAIL | L ankle pitch stator, clearance d4.5: edge distance | 5.0 mm to the edge of L shank body (needs 5.4) |
| PASS | L ankle pitch stator, clearance d4.5: ligament | 33.0 mm to the next hole in L shank body (needs 2.2) |
| PASS | L ankle roll stator, clearance d3.4: edge distance | 4.2 mm to the edge of L shank body (needs 4.1) |
| PASS | L ankle roll stator, clearance d3.4: ligament | 28.0 mm to the next hole in L shank body (needs 1.7) |
| PASS | L ankle pitch hub, clearance d4.5: edge distance | 5.6 mm to the edge of L ankle pitch crank (needs 5.4) |
| PASS | L ankle pitch hub, clearance d4.5: ligament | 3.9 mm to the next hole in L ankle pitch crank (needs 2.2) |
| PASS | L ankle roll hub, clearance d4.5: edge distance | 5.5 mm to the edge of L ankle roll crank (needs 5.4) |
| PASS | L ankle roll hub, clearance d4.5: ligament | 2.6 mm to the next hole in L ankle roll crank (needs 2.2) |
| PASS | L ankle roll post screw 1, clearance d4.5: edge distance | 5.5 mm to the edge of L foot frame (needs 5.4) |
| PASS | L ankle roll post screw 1, clearance d4.5: ligament | 35.0 mm to the next hole in L foot frame (needs 2.2) |
| PASS | L ankle roll post screw 1, tapped d3.3: edge distance | 5.0 mm to the edge of L ankle roll post (needs 4.0) |
| PASS | L ankle roll post screw 1, tapped d3.3: ligament | 36.2 mm to the next hole in L ankle roll post (needs 1.6) |
| PASS | L ankle roll post screw 2, clearance d4.5: edge distance | 5.5 mm to the edge of L foot frame (needs 5.4) |
| PASS | L ankle roll post screw 2, clearance d4.5: ligament | 35.0 mm to the next hole in L foot frame (needs 2.2) |
| PASS | L ankle roll post screw 2, tapped d3.3: edge distance | 6.0 mm to the edge of L ankle roll post (needs 4.0) |
| PASS | L ankle roll post screw 2, tapped d3.3: ligament | 36.2 mm to the next hole in L ankle roll post (needs 1.6) |

## bolted

| status | item | detail |
|---|---|---|
| PASS | L knee hub, the design, the supports take the force | 9 M5, Fp 10.3 kN by 0.75 x proof, T 120 N m, V 0 N, Fa 0 N, Mt 0 N m: slip 2.1, separation inf, shear 14.0, tension 1.3 (needs 1.1), strip 2.2; a hand estimate |
| WARN | L knee hub, what if the motor carried it all | Not the design's load: a bracket on what the motor's bearing could be asked. 9 M5, Fp 10.3 kN by 0.75 x proof, T 120 N m, V 3400 N, Fa 1614 N, Mt 142 N m: slip 1.4, separation 5.3, shear 9.3, tension 1.3 (needs 1.1), strip 2.1; a hand estimate |
| PASS | L knee stator, the design, the supports take the force | 10 M4, Fp 6.4 kN by 0.75 x proof, T 120 N m, V 0 N, Fa 0 N, Mt 0 N m: slip 4.2, separation inf, shear 28.4, tension 1.3 (needs 1.1), strip 2.2; a hand estimate |
| PASS | L knee stator, what if the motor carried it all | 10 M4, Fp 6.4 kN by 0.75 x proof, T 120 N m, V 3400 N, Fa 1614 N, Mt 142 N m: slip 1.7, separation 9.2, shear 11.3, tension 1.3 (needs 1.1), strip 2.1; a hand estimate |
| FAIL | L hip yaw hub, the design, the supports take the force | 6 M4, Fp 6.4 kN by 0.75 x proof, T 60 N m, V 0 N, Fa 0 N, Mt 0 N m: slip 1.5, separation inf, shear 9.8, tension 1.3 (needs 1.1), strip 2.5; a hand estimate |
| WARN | L hip yaw hub, what if the motor carried it all | Not the design's load: a bracket on what the motor's bearing could be asked. 6 M4, Fp 6.4 kN by 0.75 x proof, T 60 N m, V 0 N, Fa 1614 N, Mt 102 N m: slip 1.5, separation 2.6, shear 9.8, tension 1.2 (needs 1.1), strip 2.3; a hand estimate |
| PASS | L ankle pitch stator, the design, the supports take the force | 5 M4, Fp 6.4 kN by 0.75 x proof, T 60 N m, V 0 N, Fa 0 N, Mt 0 N m: slip 3.9, separation inf, shear 26.2, tension 1.3 (needs 1.1), strip 3.6; a hand estimate |
| WARN | L ankle pitch stator, what if the motor carried it all | Not the design's load: a bracket on what the motor's bearing could be asked. 5 M4, Fp 6.4 kN by 0.75 x proof, T 60 N m, V 3400 N, Fa 1614 N, Mt 0 N m: slip 1.0, separation 19.8, shear 6.9, tension 1.3 (needs 1.1), strip 3.5; a hand estimate |
| PASS | L ankle roll stator, the design, the supports take the force | 6 M3, Fp 3.7 kN by 0.75 x proof, T 36 N m, V 0 N, Fa 0 N, Mt 0 N m: slip 3.8, separation inf, shear 25.2, tension 1.3 (needs 1.1), strip 4.8; a hand estimate |
| WARN | L ankle roll stator, what if the motor carried it all | Not the design's load: a bracket on what the motor's bearing could be asked. 6 M3, Fp 3.7 kN by 0.75 x proof, T 36 N m, V 3400 N, Fa 1614 N, Mt 0 N m: slip 0.8, separation 13.6, shear 5.2, tension 1.3 (needs 1.1), strip 4.7; a hand estimate |
| FAIL | L ankle pitch hub, the design, the supports take the force | 6 M4, Fp 6.4 kN by 0.75 x proof, T 60 N m, V 0 N, Fa 0 N, Mt 0 N m: slip 1.5, separation inf, shear 9.8, tension 1.3 (needs 1.1), strip 2.7; a hand estimate |
| WARN | L ankle pitch hub, what if the motor carried it all | Not the design's load: a bracket on what the motor's bearing could be asked. 6 M4, Fp 6.4 kN by 0.75 x proof, T 60 N m, V 3400 N, Fa 1614 N, Mt 0 N m: slip 0.8, separation 23.8, shear 5.2, tension 1.3 (needs 1.1), strip 2.6; a hand estimate |
| PASS | L ankle roll hub, the design, the supports take the force | 6 M4, Fp 6.4 kN by 0.75 x proof, T 36 N m, V 0 N, Fa 0 N, Mt 0 N m: slip 1.9, separation inf, shear 12.9, tension 1.3 (needs 1.1), strip 2.7; a hand estimate |
| WARN | L ankle roll hub, what if the motor carried it all | Not the design's load: a bracket on what the motor's bearing could be asked. 6 M4, Fp 6.4 kN by 0.75 x proof, T 36 N m, V 3400 N, Fa 1614 N, Mt 0 N m: slip 0.9, separation 23.8, shear 6.0, tension 1.3 (needs 1.1), strip 2.7; a hand estimate |
| PASS | L hip pitch stator, the design, the supports take the force | 10 M4, Fp 6.4 kN by 0.75 x proof, T 120 N m, V 0 N, Fa 0 N, Mt 0 N m: slip 4.2, separation inf, shear 28.4, tension 1.3 (needs 1.1), strip 2.4; a hand estimate |
| PASS | L hip pitch stator, what if the motor carried it all | 10 M4, Fp 6.4 kN by 0.75 x proof, T 120 N m, V 3400 N, Fa 1614 N, Mt 115 N m: slip 1.7, separation 10.7, shear 11.3, tension 1.3 (needs 1.1), strip 2.4; a hand estimate |
| PASS | waist stator, the design, the supports take the force | 10 M4, Fp 6.4 kN by 0.75 x proof, T 120 N m, V 0 N, Fa 0 N, Mt 0 N m: slip 4.2, separation inf, shear 28.4, tension 1.3 (needs 1.1), strip 2.4; a hand estimate |
| PASS | waist stator, what if the motor carried it all | 10 M4, Fp 6.4 kN by 0.75 x proof, T 120 N m, V 0 N, Fa 1614 N, Mt 177 N m: slip 4.2, separation 7.7, shear 28.4, tension 1.3 (needs 1.1), strip 2.4; a hand estimate |
| PASS | L hip roll stator, the design, the supports take the force | 10 M4, Fp 6.4 kN by 0.75 x proof, T 120 N m, V 0 N, Fa 0 N, Mt 0 N m: slip 4.2, separation inf, shear 28.4, tension 1.3 (needs 1.1), strip 2.4; a hand estimate |
| PASS | L hip roll stator, what if the motor carried it all | 10 M4, Fp 6.4 kN by 0.75 x proof, T 120 N m, V 3400 N, Fa 1614 N, Mt 335 N m: slip 1.7, separation 4.5, shear 11.3, tension 1.3 (needs 1.1), strip 2.3; a hand estimate |
| PASS | L hip pitch hub, the design, the supports take the force | 9 M5, Fp 10.3 kN by 0.75 x proof, T 120 N m, V 0 N, Fa 0 N, Mt 0 N m: slip 2.1, separation inf, shear 14.0, tension 1.3 (needs 1.1), strip 2.2; a hand estimate |
| WARN | L hip pitch hub, what if the motor carried it all | Not the design's load: a bracket on what the motor's bearing could be asked. 9 M5, Fp 10.3 kN by 0.75 x proof, T 120 N m, V 3400 N, Fa 1614 N, Mt 115 N m: slip 1.4, separation 6.5, shear 9.3, tension 1.3 (needs 1.1), strip 2.1; a hand estimate |
| PASS | waist hub, the design, the supports take the force | 9 M5, Fp 10.3 kN by 0.75 x proof, T 120 N m, V 0 N, Fa 0 N, Mt 0 N m: slip 2.1, separation inf, shear 14.0, tension 1.3 (needs 1.1), strip 2.2; a hand estimate |
| PASS | waist hub, what if the motor carried it all | 9 M5, Fp 10.3 kN by 0.75 x proof, T 120 N m, V 0 N, Fa 1614 N, Mt 177 N m: slip 2.1, separation 4.4, shear 14.0, tension 1.3 (needs 1.1), strip 2.1; a hand estimate |
| PASS | L hip roll hub, the design, the supports take the force | 9 M5, Fp 10.3 kN by 0.75 x proof, T 120 N m, V 0 N, Fa 0 N, Mt 0 N m: slip 2.1, separation inf, shear 14.0, tension 1.3 (needs 1.1), strip 2.2; a hand estimate |
| WARN | L hip roll hub, what if the motor carried it all | Not the design's load: a bracket on what the motor's bearing could be asked. 9 M5, Fp 10.3 kN by 0.75 x proof, T 120 N m, V 3400 N, Fa 1614 N, Mt 335 N m: slip 1.4, separation 2.4, shear 9.3, tension 1.2 (needs 1.1), strip 2.0; a hand estimate |
| PASS | L hip yaw stator, the design, the supports take the force | 8 M4, Fp 6.4 kN by 0.75 x proof, T 60 N m, V 0 N, Fa 0 N, Mt 0 N m: slip 6.3, separation inf, shear 42.0, tension 1.3 (needs 1.1), strip 2.2; a hand estimate |
| PASS | L hip yaw stator, what if the motor carried it all | 8 M4, Fp 6.4 kN by 0.75 x proof, T 60 N m, V 0 N, Fa 1614 N, Mt 102 N m: slip 6.3, separation 8.9, shear 42.0, tension 1.3 (needs 1.1), strip 2.1; a hand estimate |
| PASS | L shoulder stator, the design, the supports take the force | 10 M4, Fp 6.4 kN by 0.75 x proof, T 120 N m, V 0 N, Fa 0 N, Mt 0 N m: slip 4.2, separation inf, shear 28.4, tension 1.3 (needs 1.1), strip 2.4; a hand estimate |
| PASS | L shoulder stator, what if the motor carried it all | 10 M4, Fp 6.4 kN by 0.75 x proof, T 120 N m, V 0 N, Fa 1614 N, Mt 36 N m: slip 4.2, separation 21.5, shear 28.4, tension 1.3 (needs 1.1), strip 2.4; a hand estimate |
| PASS | neck stator, the design, the supports take the force | 6 M3, Fp 3.7 kN by 0.75 x proof, T 14 N m, V 0 N, Fa 0 N, Mt 0 N m: slip 5.9, separation inf, shear 39.4, tension 1.3 (needs 1.1), strip 2.7; a hand estimate |
| PASS | neck stator, what if the motor carried it all | 6 M3, Fp 3.7 kN by 0.75 x proof, T 14 N m, V 80 N, Fa 1614 N, Mt 11 N m: slip 5.1, separation 8.9, shear 34.5, tension 1.3 (needs 1.1), strip 2.6; a hand estimate |
| PASS | neck pitch stator, the design, the supports take the force | 6 M3, Fp 3.7 kN by 0.75 x proof, T 14 N m, V 0 N, Fa 0 N, Mt 0 N m: slip 5.9, separation inf, shear 39.4, tension 1.3 (needs 1.1), strip 2.4; a hand estimate |
| PASS | neck pitch stator, what if the motor carried it all | 6 M3, Fp 3.7 kN by 0.75 x proof, T 14 N m, V 0 N, Fa 1614 N, Mt 7 N m: slip 5.9, separation 10.1, shear 39.4, tension 1.3 (needs 1.1), strip 2.4; a hand estimate |
| PASS | neck pitch hub, the design, the supports take the force | 6 M3, Fp 3.7 kN by 0.75 x proof, T 14 N m, V 0 N, Fa 0 N, Mt 0 N m: slip 3.2, separation inf, shear 21.3, tension 1.3 (needs 1.1), strip 2.6; a hand estimate |
| PASS | neck pitch hub, what if the motor carried it all | 6 M3, Fp 3.7 kN by 0.75 x proof, T 14 N m, V 0 N, Fa 1614 N, Mt 7 N m: slip 3.2, separation 8.2, shear 21.3, tension 1.3 (needs 1.1), strip 2.5; a hand estimate |
| PASS | neck yaw hub, the design, the supports take the force | 6 M3, Fp 3.7 kN by 0.75 x proof, T 14 N m, V 0 N, Fa 0 N, Mt 0 N m: slip 3.2, separation inf, shear 21.3, tension 1.3 (needs 1.1), strip 2.5; a hand estimate |
| PASS | neck yaw hub, what if the motor carried it all | 6 M3, Fp 3.7 kN by 0.75 x proof, T 14 N m, V 80 N, Fa 1614 N, Mt 11 N m: slip 2.9, separation 6.8, shear 19.8, tension 1.3 (needs 1.1), strip 2.4; a hand estimate |
| PASS | L knee rim, the side force and the post's tilt; the cap takes no torque | 6 M3, Fp 3.7 kN by 0.75 x proof, T 0 N m, V 0 N, Fa 1614 N, Mt 0 N m: slip 3294000000.0, separation 13.6, shear 3681960000.0, tension 1.3 (needs 1.1), strip 6.7; a hand estimate |
| PASS | L knee cheek top, half of the outer support, 2,574 N, and half of the moment: the side force 1,614 N at 90 mm over the row, and the bearing 5.75 mm off the seam: an upper bound | 2 M5, Fp 10.3 kN by 0.75 x proof, T 0 N m, V 1287 N, Fa 0 N, Mt 80 N m: slip 2.4, separation 3.2, shear 16.2, tension 1.3 (needs 1.1), strip 6.1; a hand estimate |
| PASS | L knee cheek, the other half, as the top pair | 2 M5, Fp 10.3 kN by 0.75 x proof, T 0 N m, V 1287 N, Fa 0 N, Mt 80 N m: slip 2.4, separation 3.2, shear 16.2, tension 1.3 (needs 1.1), strip 5.3; a hand estimate |
| PASS | L knee post, the side force, on the inner race | 4 M4, Fp 6.4 kN by 0.75 x proof, T 0 N m, V 0 N, Fa 1614 N, Mt 0 N m: slip 3834000000.0, separation 15.8, shear 6426960000.0, tension 1.3 (needs 1.1), strip 6.1; a hand estimate |
| PASS | L knee hub in foot, a cover: its own weight at 10 g | 2 M4, Fp 6.4 kN by 0.75 x proof, T 0 N m, V 30 N, Fa 30 N, Mt 0 N m: slip 63.9, separation 426.0, shear 428.5, tension 1.3 (needs 1.1), strip 6.7; a hand estimate |
| PASS | L knee hub out foot, a cover: its own weight at 10 g | 2 M4, Fp 6.4 kN by 0.75 x proof, T 0 N m, V 30 N, Fa 30 N, Mt 0 N m: slip 63.9, separation 426.0, shear 428.5, tension 1.3 (needs 1.1), strip 6.7; a hand estimate |
| PASS | L shank panel, shear flow in the closed section, a hand figure from the motor's torque on the section | 6 M3, Fp 3.7 kN by 0.75 x proof, T 0 N m, V 200 N, Fa 0 N, Mt 0 N m: slip 16.5, separation inf, shear 110.5, tension 1.3 (needs 1.1), strip 6.7; a hand estimate |
| PASS | L thigh collar, the whole leg, and the yaw motor's and knee motor's peak | 6 M4, Fp 6.4 kN by 0.75 x proof, T 60 N m, V 810 N, Fa 3400 N, Mt 120 N m: slip 2.4, separation 4.0, shear 16.4, tension 1.3 (needs 1.1), strip 5.6; a hand estimate |
| PASS | L ankle roll post, the roll rod at the peak of the RS06, 1,385 N along the post; its 6.6 deg lean, 160 N across, 61 mm up | 2 M4, Fp 6.4 kN by 0.75 x proof, T 0 N m, V 160 N, Fa 1385 N, Mt 10 N m: slip 12.0, separation 5.3, shear 80.3, tension 1.3 (needs 1.1), strip 7.8; a hand estimate |
| PASS | L hip pitch rim, what the ring passes on: the bearing goes in it, not the screws, which only hold it | 6 M3, Fp 3.7 kN by 0.75 x proof, T 0 N m, V 0 N, Fa 1614 N, Mt 0 N m: slip 3294000000.0, separation 13.6, shear 3681960000.0, tension 1.3 (needs 1.1), strip 7.4; a hand estimate |
| PASS | waist rim, what the ring passes on: the bearing goes in it, not the screws, which only hold it | 6 M3, Fp 3.7 kN by 0.75 x proof, T 0 N m, V 0 N, Fa 1000 N, Mt 0 N m: slip 3294000000.0, separation 22.0, shear 3681960000.0, tension 1.3 (needs 1.1), strip 7.4; a hand estimate |
| PASS | L hip yaw rim, the leg, at 810 N, from the motor's face into the housing, and the yaw motor's peak | 6 M3, Fp 3.7 kN by 0.75 x proof, T 60 N m, V 810 N, Fa 810 N, Mt 60 N m: slip 1.7, separation 7.4, shear 11.7, tension 1.3 (needs 1.1), strip 6.3; a hand estimate |

## bearing

| status | item | detail |
|---|---|---|
| PASS | L hip pitch bearing: static at 810 N | C0 6170 N, fs 7.6 at calm walking |
| PASS | L hip pitch bearing: static at 3,400 N (reported) | CRBS 508: C0 6170 N, Fr 3400 N (lever rule on 0 mm), fs 1.81, needs 1.5 |
| PASS | L hip pitch bearing: static with the side force | adding 1614 N axial, an upper bound: fs 1.50, needs 1.5 |
| PASS | L hip pitch bearing: life on the walk | P 1215 N (C 4900 N), 313 M cycles of 60 deg, needs 31.5 M (a hand figure) |
| PASS | L hip pitch bearing: outer race seat wall | 5.5 mm of L hip ring, needs 4.0 (the race's section) |
| PASS | L hip pitch bearing: outer race seat land | 100 % of its 8 mm width seated, needs 80 % |
| PASS | L hip pitch bearing: outer race stopped toward +y | 100 % of its shoulder band has a part of its own link beside it |
| PASS | L hip pitch bearing: outer race stopped toward -y | 100 % of its shoulder band has a part of its own link beside it |
| PASS | L hip pitch bearing: inner race seat wall | 4.0 mm of L_hip_pitch flange, needs 4.0 (the race's section) |
| PASS | L hip pitch bearing: inner race seat land | 100 % of its 8 mm width seated, needs 80 % |
| PASS | L hip pitch bearing: inner race stopped toward +y | 70 % of its shoulder band has a part of its own link beside it |
| PASS | L hip pitch bearing: inner race stopped toward -y | 100 % of its shoulder band has a part of its own link beside it |
| PASS | L hip pitch bearing: goes in | 8 mm wide; nothing in its way, 0.2 mm or more from what turns against it |
| PASS | waist bearing: static at 810 N | C0 6170 N, fs 7.6 at calm walking |
| PASS | waist bearing: static at 3,400 N (reported) | CRBS 508: C0 6170 N, Fr 3400 N (lever rule on 0 mm), fs 1.81, needs 1.5 |
| PASS | waist bearing: static with the side force | adding 1614 N axial, an upper bound: fs 1.50, needs 1.5 |
| PASS | waist bearing: life on the walk | P 1215 N (C 4900 N), 313 M cycles of 60 deg, needs 31.5 M (a hand figure) |
| PASS | waist bearing: outer race seat wall | 5.5 mm of waist ring, needs 4.0 (the race's section) |
| PASS | waist bearing: outer race seat land | 100 % of its 8 mm width seated, needs 80 % |
| PASS | waist bearing: outer race stopped toward + | 100 % of its shoulder band has a part of its own link beside it |
| PASS | waist bearing: outer race stopped toward - | 100 % of its shoulder band has a part of its own link beside it |
| PASS | waist bearing: inner race seat wall | 4.0 mm of waist_yaw flange, needs 4.0 (the race's section) |
| PASS | waist bearing: inner race seat land | 100 % of its 8 mm width seated, needs 80 % |
| PASS | waist bearing: inner race stopped toward + | 70 % of its shoulder band has a part of its own link beside it |
| PASS | waist bearing: inner race stopped toward - | 100 % of its shoulder band has a part of its own link beside it |
| PASS | waist bearing: goes in | 8 mm wide; nothing in its way, 0.2 mm or more from what turns against it |
| PASS | L knee outer bearing: static at 810 N | C0 6170 N, fs 11.6 at calm walking |
| PASS | L knee outer bearing: static at 3,400 N (reported) | CRBS 508: C0 6170 N, Fr 2227 N (lever rule on 68 mm), fs 2.77, needs 1.5 |
| PASS | L knee outer bearing: static with the side force | adding 1614 N axial, an upper bound: fs 2.10, needs 1.5 |
| PASS | L knee outer bearing: life on the walk | P 867 N (C 4900 N), 966 M cycles of 60 deg, needs 31.5 M (a hand figure) |
| PASS | L knee outer bearing: outer race seat wall | 6.3 mm of L knee outer cheek, needs 4.0 (the race's section) |
| PASS | L knee outer bearing: outer race seat land | 100 % of its 8 mm width seated, needs 80 % |
| PASS | L knee outer bearing: outer race stopped toward +y | 100 % of its shoulder band has a part of its own link beside it |
| PASS | L knee outer bearing: outer race stopped toward -y | 100 % of its shoulder band has a part of its own link beside it |
| PASS | L knee outer bearing: inner race seat wall | 8.1 mm of L knee rear cap, needs 4.0 (the race's section) |
| PASS | L knee outer bearing: inner race seat land | 100 % of its 8 mm width seated, needs 80 % |
| PASS | L knee outer bearing: inner race stopped toward +y | 100 % of its shoulder band has a part of its own link beside it |
| PASS | L knee outer bearing: inner race stopped toward -y | 46 % of its shoulder band has a part of its own link beside it |
| PASS | L knee outer bearing: goes in | 8 mm wide; nothing in its way, 0.2 mm or more from what turns against it |
| PASS | L knee inner bearing: static at 810 N | C0 6170 N, fs 10.1 at calm walking |
| PASS | L knee inner bearing: static at 3,400 N (reported) | CRBS 508: C0 6170 N, Fr 2573 N (lever rule on 68 mm), fs 2.40, needs 1.5 |
| PASS | L knee inner bearing: static with the side force | adding 1614 N axial, an upper bound: fs 1.88, needs 1.5 |
| PASS | L knee inner bearing: life on the walk | P 990 N (C 4900 N), 620 M cycles of 60 deg, needs 31.5 M (a hand figure) |
| PASS | L knee inner bearing: outer race seat wall | 5.5 mm of L shank body, needs 4.0 (the race's section) |
| PASS | L knee inner bearing: outer race seat land | 100 % of its 8 mm width seated, needs 80 % |
| PASS | L knee inner bearing: outer race stopped toward +y | 100 % of its shoulder band has a part of its own link beside it |
| PASS | L knee inner bearing: outer race stopped toward -y | 100 % of its shoulder band has a part of its own link beside it |
| PASS | L knee inner bearing: inner race seat wall | 4.0 mm of L_knee flange, needs 4.0 (the race's section) |
| PASS | L knee inner bearing: inner race seat land | 100 % of its 8 mm width seated, needs 80 % |
| PASS | L knee inner bearing: inner race stopped toward +y | 100 % of its shoulder band has a part of its own link beside it |
| PASS | L knee inner bearing: inner race stopped toward -y | 66 % of its shoulder band has a part of its own link beside it |
| PASS | L knee inner bearing: goes in | 8 mm wide; nothing in its way, 0.2 mm or more from what turns against it |

## pattern

| status | item | detail |
|---|---|---|
| PASS | waist_yaw actuator (buy) RS04: hub | 9 of 9 M5 placed |
| PASS | waist_yaw actuator (buy) RS04: stator | 10 of 10 M4 placed |
| PASS | waist_yaw actuator (buy) RS04: hub screws clear of connector, cable and bumps | 9 checked |
| PASS | waist_yaw actuator (buy) RS04: stator_rear screws clear of connector, cable and bumps | 10 checked |
| PASS | L_hip_pitch actuator (buy) RS04: hub | 9 of 9 M5 placed |
| PASS | L_hip_pitch actuator (buy) RS04: stator | 10 of 10 M4 placed |
| PASS | L_hip_pitch actuator (buy) RS04: hub screws clear of connector, cable and bumps | 9 checked |
| PASS | L_hip_pitch actuator (buy) RS04: stator_rear screws clear of connector, cable and bumps | 10 checked |
| PASS | RS04: the same part fits the right side | its patterns read the same reflected across 75.0 deg |
| PASS | neck_yaw actuator (buy) RS00: hub | 6 of 6 M3 placed |
| PASS | neck_yaw actuator (buy) RS00: stator | 6 of 6 M3 placed |
| PASS | neck_yaw actuator (buy) RS00: hub screws clear of connector, cable and bumps | 6 checked |
| PASS | neck_yaw actuator (buy) RS00: stator_front screws clear of connector, cable and bumps | 6 checked |
| FAIL | L_shoulder_pitch actuator (buy) RS04: hub | 0 of 9 M5 placed: no screws in the spec yet |
| PASS | L_shoulder_pitch actuator (buy) RS04: stator | 10 of 10 M4 placed |
| PASS | L_shoulder_pitch actuator (buy) RS04: stator_rear screws clear of connector, cable and bumps | 10 checked |
| PASS | neck_pitch actuator (buy) RS00: hub | 6 of 6 M3 placed |
| PASS | neck_pitch actuator (buy) RS00: stator | 6 of 6 M3 placed |
| PASS | neck_pitch actuator (buy) RS00: hub screws clear of connector, cable and bumps | 6 checked |
| PASS | neck_pitch actuator (buy) RS00: stator_front screws clear of connector, cable and bumps | 6 checked |
| FAIL | L_shoulder_roll actuator (buy) RS06: hub | 0 of 6 M4 placed: no screws in the spec yet |
| FAIL | L_shoulder_roll actuator (buy) RS06: stator | 0 of 8 M3 placed: no screws in the spec yet |
| PASS | RS06: the same part fits the right side | its patterns read the same reflected across 0.0 deg |
| FAIL | L_shoulder_yaw actuator (buy) RS02: hub | 0 of 6 M4 placed: no screws in the spec yet |
| FAIL | L_shoulder_yaw actuator (buy) RS02: stator | 0 of 9 M3 placed: no screws in the spec yet |
| PASS | RS02: the same part fits the right side | its patterns read the same reflected across 13.5 deg |
| FAIL | L_elbow actuator (buy) RS06: hub | 0 of 6 M4 placed: no screws in the spec yet |
| FAIL | L_elbow actuator (buy) RS06: stator | 0 of 8 M3 placed: no screws in the spec yet |
| FAIL | L_wrist_yaw actuator (buy) RS02: hub | 0 of 6 M4 placed: no screws in the spec yet |
| FAIL | L_wrist_yaw actuator (buy) RS02: stator | 0 of 9 M3 placed: no screws in the spec yet |
| FAIL | L_wrist_pitch actuator (buy) RS00: hub | 0 of 6 M3 placed: no screws in the spec yet |
| FAIL | L_wrist_pitch actuator (buy) RS00: stator | 0 of 6 M3 placed: no screws in the spec yet |
| PASS | RS00: the same part fits the right side | its patterns read the same reflected across 0.0 deg |
| FAIL | L_wrist_roll actuator (buy) RS00: hub | 0 of 6 M3 placed: no screws in the spec yet |
| FAIL | L_wrist_roll actuator (buy) RS00: stator | 0 of 6 M3 placed: no screws in the spec yet |
| PASS | L_hip_roll actuator (buy) RS04: hub | 9 of 9 M5 placed |
| PASS | L_hip_roll actuator (buy) RS04: stator | 10 of 10 M4 placed |
| PASS | L_hip_roll actuator (buy) RS04: hub screws clear of connector, cable and bumps | 9 checked |
| PASS | L_hip_roll actuator (buy) RS04: stator_rear screws clear of connector, cable and bumps | 10 checked |
| PASS | L_hip_yaw actuator (buy) RS03: hub | 6 of 6 M4 placed |
| PASS | L_hip_yaw actuator (buy) RS03: stator | 8 of 8 M4 placed |
| PASS | L_hip_yaw actuator (buy) RS03: hub screws clear of connector, cable and bumps | 6 checked |
| PASS | L_hip_yaw actuator (buy) RS03: stator_front screws clear of connector, cable and bumps | 8 checked |
| PASS | RS03: the same part fits the right side | its patterns read the same reflected across 90.0 deg |
| PASS | L_ankle_pitch actuator (buy) RS03: hub | 6 of 6 M4 placed |
| FAIL | L_ankle_pitch actuator (buy) RS03: stator | 5 of 8 M4 placed |
| PASS | L_ankle_pitch actuator (buy) RS03: hub screws clear of connector, cable and bumps | 6 checked |
| PASS | L_ankle_pitch actuator (buy) RS03: stator_front screws clear of connector, cable and bumps | 5 checked |
| PASS | L_ankle_roll actuator (buy) RS06: hub | 6 of 6 M4 placed |
| FAIL | L_ankle_roll actuator (buy) RS06: stator | 6 of 8 M3 placed |
| PASS | L_ankle_roll actuator (buy) RS06: hub screws clear of connector, cable and bumps | 6 checked |
| PASS | L_ankle_roll actuator (buy) RS06: stator_front screws clear of connector, cable and bumps | 6 checked |
| PASS | L_knee actuator (buy) RS04: hub | 9 of 9 M5 placed |
| PASS | L_knee actuator (buy) RS04: stator | 10 of 10 M4 placed |
| PASS | L_knee actuator (buy) RS04: hub screws clear of connector, cable and bumps | 9 checked |
| PASS | L_knee actuator (buy) RS04: stator_front screws clear of connector, cable and bumps | 10 checked |
| PASS | RS00 drawn hub: no hole on a connector, cable or bump | clear |
| PASS | RS00 drawn stator front flange around the hub, z=-5: no hole on a connector, cable or bump | clear |
| PASS | RS00 drawn stator rear cover, z=46.1: no hole on a connector, cable or bump | clear |
| PASS | RS02 drawn hub: no hole on a connector, cable or bump | clear |
| PASS | RS02 drawn stator front flange, z=-23.5: no hole on a connector, cable or bump | clear |
| PASS | RS03 drawn hub: no hole on a connector, cable or bump | clear |
| PASS | RS03 drawn stator front of ears, z=2.5: no hole on a connector, cable or bump | clear |
| PASS | RS04 drawn hub: no hole on a connector, cable or bump | clear |
| PASS | RS04 drawn stator output side, z=25: no hole on a connector, cable or bump | clear |
| PASS | RS04 drawn stator rear side, z=-14: no hole on a connector, cable or bump | clear |
| PASS | RS06 drawn hub: no hole on a connector, cable or bump | clear |
| PASS | RS06 drawn stator front of ears, z=0: no hole on a connector, cable or bump | clear |

## access

| status | item | detail |
|---|---|---|
| PASS | L hip pitch stator | 10 of 10 reachable at step 29 of the build order, 60 mm of key |
| PASS | waist stator | 10 of 10 reachable at step 30 of the build order, 60 mm of key |
| PASS | L hip pitch rim | 6 of 6 reachable at step 31 of the build order, 60 mm of key |
| PASS | waist rim | 6 of 6 reachable at step 32 of the build order, 60 mm of key |
| PASS | R hip pitch stator | 10 of 10 reachable at step 29 of the build order, 60 mm of key |
| PASS | R hip pitch rim | 6 of 6 reachable at step 31 of the build order, 60 mm of key |
| PASS | waist hub | 9 of 9 reachable at step 33 of the build order, 60 mm of key |
| PASS | L shoulder stator | 10 of 10 reachable at step 34 of the build order, 60 mm of key |
| PASS | neck stator | 6 of 6 reachable at step 35 of the build order, 60 mm of key |
| PASS | R shoulder stator | 10 of 10 reachable at step 34 of the build order, 60 mm of key |
| PASS | neck pitch stator | 6 of 6 reachable at step 38 of the build order, 60 mm of key |
| PASS | neck yaw hub | 6 of 6 reachable at step 37 of the build order, 60 mm of key |
| PASS | neck pitch hub | 6 of 6 reachable at step 39 of the build order, 60 mm of key |
| PASS | L hip roll stator | 10 of 10 reachable at step 40 of the build order, 60 mm of key |
| PASS | L hip pitch hub | 9 of 9 reachable at step 44 of the build order, 60 mm of key |
| PASS | L hip roll hub | 9 of 9 reachable at step 41 of the build order, 60 mm of key |
| PASS | L hip yaw stator | 8 of 8 reachable at step 43 of the build order, 60 mm of key |
| PASS | L hip yaw rim | 6 of 6 reachable at step 43 of the build order, 60 mm of key |
| PASS | L knee hub | 9 of 9 reachable at step 3 of the build order, 60 mm of key |
| PASS | L knee cheek top | 2 of 2 reachable at step 4 of the build order, 60 mm of key |
| PASS | L knee cheek | 2 of 2 reachable at step 4 of the build order, 60 mm of key |
| PASS | L hip yaw hub | 6 of 6 reachable at step 45 of the build order, 60 mm of key |
| PASS | L thigh collar | 6 of 6 reachable at step 46 of the build order, 60 mm of key |
| PASS | L knee stator | 10 of 10 reachable at step 1 of the build order, 60 mm of key |
| PASS | L knee rim | 6 of 6 reachable at step 2 of the build order, 60 mm of key |
| PASS | L knee post | 4 of 4 reachable at step 4 of the build order, 60 mm of key |
| PASS | L knee hub in foot | 2 of 2 reachable at step 5 of the build order, 60 mm of key |
| PASS | L knee hub out foot | 2 of 2 reachable at step 6 of the build order, 60 mm of key |
| PASS | L shank panel | 6 of 6 reachable at step 11 of the build order, 60 mm of key |
| PASS | L ankle pitch stator | 5 of 5 reachable at step 7 of the build order, 60 mm of key |
| PASS | L ankle roll stator | 6 of 6 reachable at step 8 of the build order, 60 mm of key |
| PASS | L ankle pitch hub | 6 of 6 reachable at step 9 of the build order, 60 mm of key |
| PASS | L ankle roll hub | 6 of 6 reachable at step 10 of the build order, 60 mm of key |
| PASS | L ankle roll post | 2 of 2 reachable at step 22 of the build order, 60 mm of key |

## What the hardware checks assume

From `spec/assumptions.json`: change one there and run the checks. All status `assumed`.

| id | value | basis | source | what it risks |
|---|---|---|---|---|
| hub_thread_depth_RS04 | 6.5 mm | drawing | RS04 User Manual 260713 section 1.1: 9-M5 6.5 MIN. User's choice, 2026-11-05: design to the drawing | If the STEP is right, engagement falls from 6 to 3 mm, 0.6 x d: thread strip then limits preload (reports/strength.md shows the margin) |
| hub_thread_depth_RS06 | 6.0 mm | drawing | RS06 User Manual 260713 section 1.1: 6-M4 depth 6. User's choice, 2026-11-05 | Not used yet: no RS06 hub is bolted in the spec |
| hub_thread_depth_RS02 | 7.0 mm | drawing | RS02 User Manual 260713 section 1.1: 6-M4 7 MIN. User's choice, 2026-11-05 | Not used yet: no RS02 hub is bolted in the spec |
| rear_threads | drawing only  | standard practice | User's rule, 2026-11-05: no load on rear threads that are not on a drawing. RS04's rear 10-M4 is on its drawing; RS03 and RS06 rear ears and RS02's through-holes are not | RS04's rear 10-M4 is drawn but its rated use isn't stated |
| screw_grade | 12.9  | standard practice | User's rule, 2026-11-05. Proof and breaking loads: ISO 898-1 via hardware_catalog.json (wuerth p3) | RobStride gives no grade or torque. A softer hub thread may need less |
| preload_fraction | 0.75 of proof load | estimate, from memory | Usual target for reusable joints (Shigley, VDI 2230 practice) | Scatter in tightening is about +-25 % with a torque wrench: separation margins carry it |
| torque_coefficient | 0.2 T = K F d | estimate, from memory | Black-oxide steel screw, dry or lightly oiled (Shigley) | Sets the torque quoted, not the capacities |
| friction_joint | 0.15  | estimate, from memory | Bare aluminium on aluminium for slip, as tools/strength.py BOLT_SLIP_N already used | Anodised or oiled faces can be lower: slip margins scale with it directly |
| joint_stiffness_factor | 0.2 share of external tension the screw sees | estimate, from memory | Typical screw in short metal clamp (VDI 2230 range about 0.1 to 0.3) | Small: tension margins are mostly preload |
| shear_al_motor | 207.0 MPa | estimate, from memory | 6061-T6 shear strength (ASM). RobStride's housing and hub alloys are unknown | A casting (ADC12 about 185 MPa, estimate) drops the strip margin by a tenth |
| shear_al_part | 331.0 MPa | estimate, from memory | 7075-T6 shear strength (ASM) | Only for threads tapped in our own parts |
| strip_factor | 2.0 thread strip force / screw load | standard practice | Same factor as tools/strength.py SF_MIN. The stripping area is the standard one for an internal thread (ISO 898 / FED-STD-H28), which assumes even load across the threads; first threads carry more | The check limits preload by this; it does not model fatigue of the thread |
| min_engagement | 2.0 x thread diameter | catalogue | hardware_catalog.json thread_engagement.aluminium (project rule, top of Bossard F.044's range) | RobStride's threads are shallower than this by drawing: see the 'fastener' group |
| machining_clearance | 0.2 mm | standard practice | Twice ISO 2768-m's +-0.1 mm for parts this size: the least running gap that is still a gap once made | Stack of three parts can use it up |
| seat_fit | per IKO: slight interference, measured  | catalogue | IKO CAT-57166 p8: on Super Slim, 'fit based on the actual measured dimensions' and 'a slight interference fit'. Seats are drawn at nominal diameter | Interference eats internal clearance at 70 to 90 %: machined to the bearing in hand |
| support_shared_by_levers | 2 bearings, lever rule; the motor's own bearing takes none  | standard practice | RobStride publishes no output bearing rating, so nothing is rested on it (reports/actuator_interfaces.md). Real share goes by stiffness: the motor's bearing will take some, which helps the two supports and loads it unrated | HIGH: knee capacities assume the fork shares load between the two supports only, with no flex in 3 mm cheeks |
| walk_force_line | the ankle motor's rated torque limits the lever  | standard practice | A load repeated every step can only be held by what a motor sustains: RS06 rated 11 N m x 1.32 linkage, so 18 mm at 810 N. Static cases keep the peak | A faster walk or jog passes 810 N (reports/strength.md: to 2,220 N) |
| bearing_load_factor | 1.5 fw | catalogue | IKO CAT-57166 Table 5: 1.2 to 1.5 normal operation, 1.5 to 3 with shock. Walking taken at the boundary | Shock loads would use a higher factor |
| bearing_static_min | 1.5 fs | catalogue | IKO CAT-57166 Table 4: 1.5 or more for normal operation | A fall isn't in the load cases at all |
| service_cycles | 31500000.0 knee cycles | estimate, from memory | 8 h a day x 1 cycle a second x 365 days x 3 years: a hand figure for a service life, no product requirement behind it | A real duty cycle may be half or twice this |
| knee_oscillation | 60.0 deg, 2 theta | estimate, from memory | Knee swing in a calm walk (human about 60 deg). Not measured on echo's take | Enters the oscillating-life formula as a straight factor |
| garment_former | torso 0.42, thigh 0.70, shank 0.30, gaiter 0.24 of 3.3 kg/m2 wall_fill on role knit | estimate, from memory | Iteration 41: the garment's density held 2.5 kg/m2 of undesigned formers. The shank's closed body now fills that skin to 3 mm, and the thigh needs only ribs off its tube. Knit 0.5 and foam 0.3 kg/m2 are the note in spec/robot.py MATERIALS | Up to 1.0 kg on the robot if formers are heavier than this. Nothing here is weighed |
| bearing_retainers | threaded rings M68 x 1, nut M50 x 1  | standard practice | Thin rings, made not bought. Thread forms aren't drawn: the rings and nut are plain bands in the spec. Tightened with a pin spanner, locked with thread adhesive | Race axial load on a fine thread in 7075: not calculated; a circlip needs 2.65 mm of groove and 4 mm more width each side, estimate |
| thermal_interface | paste in the bore, gap pad on the skirt  | standard practice | reports/strength.md counts these as contact area. No resistance is modelled, and the bore's 0.05 mm gap is a nominal | Rated torque isn't transferred from the maker's plate |
| steel_density | 7850.0 kg/m3 | standard practice | Steel, for screw masses: geometry times density, as no maker's mass table was read | None that matters |
| shoe_walls | upper and heel 1.5 mm TPU (wall_fill 0.5); midsole 0.45 of its solid; the outsole's top not counted wall_fill | estimate, from memory | Iteration 43: the shell rule gave the shoe a 3 mm wall, the midsole was a solid filling the whole shoe below its rail, frame included, and the outsole counted a top wall the midsole sits on. A molded shoe upper is about 1.5 mm; a midsole is foam under and round the frame, not through it | About 0.25 kg a foot if the shoe is built as the old rule counted it |
| ankle_bushings | CuSn8 flanged bushings d10 D12, 5 and 6 long; pins d10 h6 hardened; shoulder screws ISO 7379 d6 12.9  | standard practice | Iteration 43: plain bushings where a catalogue bearing would not fit the 5 to 6 mm plates. Allowable static pressure of bronze about 60 MPa, from memory: at 810 N on two, 6.8 MPa; at 3,400 N with the line off centre, 44 MPa | Wear and play over time, not strength; a polymer bushing of the same size if lubrication is a problem |
| rod_ends | female spherical rod ends, bore 6, eye 15, width 5 to 6, misalignment 15 deg or more  | estimate, from memory | Iteration 43: drawn to the size a catalogue M6 rod end has; static rating about 10 kN, from memory, against 2,649 N at the RS03's peak through the crank | The roll rod's lower end tilts 17 deg across its pin at full roll: a high-misalignment rod end |
