meetsitaram/echo/reports/mass.md

# Mass model

Bottom-up: every part from its material and shape (`tools/mass_model.py`, materials in `spec/robot.py`), a 6 % wiring / fastener / bearing allowance per link on its frames.

**Total 62.29 kg** (Figure 03: 61.0 kg).

| material | kg | share |
|---|---|---|
| actuator | 23.49 | 38 % |
| al7075 | 13.52 | 22 % |
| cells | 13.10 | 21 % |
| garment | 3.43 | 6 % |
| electronics | 2.74 | 4 % |
| hand | 1.70 | 3 % |
| steel | 1.69 | 3 % |
| pc | 0.90 | 1 % |
| tpu | 0.61 | 1 % |
| pa12 | 0.59 | 1 % |
| knit_pa12 | 0.30 | 0 % |
| eva | 0.21 | 0 % |
| bronze | 0.03 | 0 % |

| link | mass kg | budget kg (hand estimate) | CoM (m, world, zero pose) | principal inertia (kg m2) |
|---|---|---|---|---|
| pelvis | 6.16 | 6.50 | +0.000 -0.000 +0.951 | 0.0170 0.0454 0.0486 |
| torso | 20.40 | 19.96 | -0.010 +0.000 +1.256 | 0.1199 0.2478 0.2767 |
| neck_yaw_link | 0.43 | 0.45 | -0.012 +0.001 +1.492 | 0.0002 0.0003 0.0003 |
| head | 1.03 | 1.95 | +0.015 +0.003 +1.619 | 0.0046 0.0049 0.0066 |
| L_shoulder_pitch_link | 0.77 | 0.99 | +0.001 +0.165 +1.390 | 0.0005 0.0009 0.0010 |
| R_shoulder_pitch_link | 0.77 | 0.99 | +0.001 -0.165 +1.390 | 0.0005 0.0009 0.0010 |
| L_shoulder_roll_link | 0.84 | 1.00 | -0.002 +0.200 +1.322 | 0.0010 0.0018 0.0020 |
| R_shoulder_roll_link | 0.84 | 1.00 | -0.002 -0.200 +1.322 | 0.0010 0.0018 0.0020 |
| L_shoulder_yaw_link | 0.39 | 1.05 | +0.000 +0.202 +1.214 | 0.0006 0.0013 0.0013 |
| R_shoulder_yaw_link | 0.39 | 1.05 | +0.000 -0.202 +1.214 | 0.0006 0.0013 0.0013 |
| L_elbow_link | 1.85 | 0.85 | -0.000 +0.206 +1.124 | 0.0024 0.0055 0.0060 |
| R_elbow_link | 1.85 | 0.85 | -0.000 -0.206 +1.124 | 0.0024 0.0055 0.0060 |
| L_wrist_yaw_link | 0.49 | 0.60 | +0.000 +0.205 +0.976 | 0.0003 0.0007 0.0007 |
| R_wrist_yaw_link | 0.49 | 0.60 | -0.000 -0.205 +0.976 | 0.0003 0.0007 0.0007 |
| L_wrist_pitch_link | 0.44 | 0.45 | +0.004 +0.206 +0.904 | 0.0002 0.0004 0.0004 |
| R_wrist_pitch_link | 0.44 | 0.45 | +0.004 -0.206 +0.904 | 0.0002 0.0004 0.0004 |
| L_hand | 1.02 | 1.00 | +0.001 +0.198 +0.824 | 0.0009 0.0011 0.0015 |
| R_hand | 1.02 | 1.00 | +0.001 -0.198 +0.824 | 0.0009 0.0011 0.0015 |
| L_hip_pitch_link | 1.89 | 1.60 | -0.088 +0.104 +0.931 | 0.0033 0.0043 0.0047 |
| R_hip_pitch_link | 1.89 | 1.60 | -0.088 -0.104 +0.931 | 0.0033 0.0043 0.0047 |
| L_hip_roll_link | 1.51 | 2.00 | -0.013 +0.103 +0.838 | 0.0023 0.0052 0.0054 |
| R_hip_roll_link | 1.51 | 2.00 | -0.013 -0.103 +0.838 | 0.0023 0.0052 0.0054 |
| L_hip_yaw_link | 1.55 | 3.60 | -0.002 +0.103 +0.650 | 0.0037 0.0157 0.0159 |
| R_hip_yaw_link | 1.55 | 3.60 | -0.002 -0.103 +0.650 | 0.0037 0.0157 0.0159 |
| L_knee_link | 5.22 | 2.08 | -0.004 +0.101 +0.417 | 0.0077 0.0907 0.0921 |
| R_knee_link | 5.22 | 2.08 | -0.004 -0.101 +0.417 | 0.0077 0.0907 0.0921 |
| L_ankle_pitch_link | 0.13 | 0.25 | -0.004 +0.099 +0.085 | 0.0000 0.0000 0.0000 |
| R_ankle_pitch_link | 0.13 | 0.25 | -0.004 -0.099 +0.085 | 0.0000 0.0000 0.0000 |
| L_foot | 1.02 | 1.10 | +0.033 +0.102 +0.027 | 0.0012 0.0044 0.0047 |
| R_foot | 1.02 | 1.10 | +0.033 -0.102 +0.027 | 0.0012 0.0044 0.0047 |
