meetsitaram/echo/reports/strength.md

# echo strength table: hand estimates, not FEA

Live spec (`spec/robot.json`), total mass 62.29 kg. Generated by `python -I tools/strength.py`; `tools/checks.py` groups `loadpath` and `contact` read the same tables. Left side at the zero pose; the right is built as its mirror.

**How far to trust this.** Every number is a hand estimate on a section cut from the spec's solid primitives. No FEA, no test. It finds the weak parts and ranks them; it cannot sign anything off.

**Result:** 67 sections on what is required, calm walking at 810 N and each motor at peak: **0 fail** (under 1 to yield), **1 marginal** (under 1.5), 66 pass. The 3,400 N shove is reported in the SF column, and nothing is sized for it. 4 of 56 interfaces fail. Sections that pass only because they are read as solid: 0: at the mass model's fill they drop under 2.

## Load cases

| case | size | where it comes from |
|---|---|---|
| 3,400 N foot | 3,400 N up the straight leg, off the axes by 26 mm fore-aft and 14 mm sideways, the most the ankle motors can hold (a joint back-drives past its peak). The body takes it as inertia, 54.6 m/s2 | Largest vertical foot force in the recorded sims: 3,432 N, one 20 ms sample, `neutral_walk_180_R_002__A122` with a 1.48 m/s pelvis push (`mv6/2_shove15.npz`, 569 N weight: the v6 plant, not this exact mass). Only 4 of 526 frames pass 2,000 N |
| 3,400 N + 1,614 N side | the same frame's side force on a line through the ankle | Foot and shank only, plus one row for the knee cheeks. Upper bound: hip roll held only 43 N m at that frame, so most of the side force went into the leg's inertia |
| 810 N walking | 810 N, levers to what the ankle can hold, inside the sole | `force_v6.npz`, `Relaxed_walk_forward_001__A057`. That peak is frame 1 (settling); later steps peak near 670 N, 99th percentile 612 N. A faster neutral walk with 300 N neck shoves reached 2,471 N, and jogging 1,660 to 2,220 N, so 810 N is a calm walk, not a limit |
| motor peak | each motor beside the section at peak, one at a time, as a free moment; ankle motors as rod force | `spec/actuators.json`: a motor must not break its own bracket |
| 5 kg in the hand | 5 kg per hand plus link weight, static, worst direction | `POSES` in `tools/checks.py`: "carry 10 kg at the chest" |

## Sections, worst first (hand estimates)

"SF" is to yield, worst of all cases, the 3,400 N shove included; the verdict reads calm walking and motor peak only (`other cases`).  "SF hollow" is the same at the fill the mass model charges for that part (`tools/mass_model.py`: 0.25 for anything thicker than 20 mm, 0.5 to 20 mm, 0.8 to 8 mm, beam 0.12), keeping the outline; the parts cannot be both as light as the mass model says and as strong as the SF says. Thin-wall buckling is not in it.

| # | verdict | section | path | material | smallest section, mm | mm2 | governing case | N, V (N) | bending, torsion (N m) | stress (MPa) | SF | SF hollow | other cases (SF) | note |
|---|---|---|---|---|---|---|---|---|---|---|---|---|---|---|
| 1 | **MARGINAL** | Elbow inner cheek alone (the only one that takes motor torque) | shoulder to hand | al7075 (503) | 46.0 x 3.0 | 136 | 3,400 N foot | 0, 207 | 41, 0 | 610 | **0.82** | 0.79 | 810 N walking 3.46; motor peak 14.2; 5 kg in the hand 1.31 | all the arm load as drawn: the outer cheek has air at its bearing |
| 2 | pass | Ankle pitch arm | ankle rods and cranks | al7075 (503) | 19.6 x 15.8 | 138 | motor peak | 2244, 1407 | 23, 14 | 257 | **1.96** | 1.96 |  |  |
| 3 | pass | Roll rod | ankle rods and cranks | al7075 (503) | 10.0 x 10.0 | 78 | motor peak | 1385, 0 | 0, 0 | 18 | **2.55** (buckling) | 2.55 |  | Euler, pinned both ends, solid, over the 311.6 mm between its rod ends' centres |
| 4 | pass | Roll rod post | ankle rods and cranks | al7075 (503) | 19.4 x 3.5 | 68 | motor peak | 1375, 160 | 7, 1 | 182 | **2.76** | 2.76 |  |  |
| 5 | pass | Pitch rod | ankle rods and cranks | al7075 (503) | 10.0 x 10.0 | 78 | motor peak | 2649, 0 | 0, 0 | 34 | **2.84** (buckling) | 2.84 |  | Euler, pinned both ends, solid, over the 213.5 mm between its rod ends' centres |
| 6 | pass | Carrier arm at the eye | foot to pelvis | al7075 (503) | 54.2 x 10.6 | 285 | 3,400 N foot | 0, 3400 | 243, 163 | 215 | **2.34** | 2.34 | 810 N walking 5.72; motor peak 4.03 |  |
| 7 | pass | Carrier arm over the roll output | foot to pelvis | al7075 (503) | 56.3 x 10.6 | 301 | 3,400 N foot | 0, 3400 | 331, 163 | 217 | **2.32** | 2.32 | 810 N walking 5.78; motor peak 4.16 |  |
| 8 | pass | Clevis plates at the pivot (net of the bushings) | foot to pelvis | al7075 (503) | 2 x 5.5 x 5.0 + 2 x 6.0 x 5.5 | 99 | 3,400 N foot | 3400, 0 | 108, 0 | 156 | **3.23** | 3.23 | 3,400 N + 1,614 N side 3.52; 810 N walking 4.66; motor peak 8.03 |  |
| 9 | pass | Forearm frame | shoulder to hand | al7075 (503) | 40.0 x 5.0 | 195 | 3,400 N foot | 0, 106 | 22, 0 | 139 | **3.61** | 3.46 | 810 N walking 15.1; motor peak 5.17; 5 kg in the hand 4.70 |  |
| 10 | pass | Pitch crank at the motor | ankle rods and cranks | al7075 (503) | 6.4 x 4.4 + 6.4 x 4.9 + 12.4 x 6.4 | 138 | motor peak | 628, 2573 | 51, 21 | 102 | **4.96** | 4.96 |  |  |
| 11 | pass | Elbow bridge beside the frame | shoulder to hand | al7075 (503) | 24.0 x 10.0 | 237 | 3,400 N foot | 207, 0 | 45, 0 | 119 | **4.24** | 2.84 | 810 N walking 17.8; motor peak 5.67; 5 kg in the hand 7.01 | all the arm load through one side, as drawn |
| 12 | pass | Fork cheeks at the bushings' top | foot to pelvis | al7075 (503) | 2 x 27.6 x 5.0 | 275 | 3,400 N + 1,614 N side | 3400, 1614 | 97, 45 | 98 | **5.14** | 5.14 | 3,400 N foot 5.24; 810 N walking 6.26; motor peak 5.91 |  |
| 13 | pass | Roll crank at the motor | ankle rods and cranks | al7075 (503) | 2 x 6.2 x 4.3 + 2 x 6.2 x 4.1 | 103 | motor peak | 160, 1375 | 33, 12 | 81 | **6.21** | 6.21 |  |  |
| 14 | pass | Frame between waist and shoulder bar (the pack is not frame) | pelvis to shoulder | al7075 (503) | 2 x 44.0 x 24.0 | 323 | motor peak | 0, 0 | 240, 0 | 75 | **6.69** | 6.69 | 3,400 N foot 10.2; 810 N walking 11.7; 5 kg in the hand 8.57 | slices every carrying part of the torso |
| 15 | pass | Foot frame behind the ankle (all load at the heel) | foot to pelvis | al7075 (503) | 67.0 x 14.1 | 935 | 3,400 N foot | 0, 3400 | 629, 2 | 294 | **1.71** | 1.71 | 810 N walking 7.18 | as the toe row, the heel end |
| 16 | pass | Chest rails over the waist | pelvis to shoulder | al7075 (503) | 2 x 46.0 x 25.0 | 338 | motor peak | 0, 0 | 240, 0 | 69 | **7.33** | 7.33 | 3,400 N foot 10.8; 810 N walking 12.4; 5 kg in the hand 12.2 | two closed rails, tied at both ends |
| 17 | pass | Yoke plate behind the pitch motor | foot to pelvis | al7075 (503) | 59.3 x 6.4 + 41.5 x 11.7 | 624 | 3,400 N foot | 3400, 0 | 319, 0 | 148 | **3.40** | 3.40 | 810 N walking 7.34; motor peak 13.3 |  |
| 18 | pass | Wrist cheek | shoulder to hand | al7075 (503) | 40.0 x 6.0 | 237 | motor peak | 0, 0 | 14, 0 | 60 | **8.34** | 8.01 | 3,400 N foot 20.3; 810 N walking 85.0; 5 kg in the hand 19.0 |  |
| 19 | pass | Fork front plate alone, net of its bore | shoulder to hand | al7075 (503) | 6.0 x 3.5 + 33.5 x 6.0 | 219 | motor peak | 1846, 0 | 48, 0 | 58 | **8.66** | 8.08 |  | takes the pitch couple alone |
| 20 | pass | Foot frame in front of the ankle (all load at the toe) | foot to pelvis | al7075 (503) | 67.0 x 14.1 | 911 | 3,400 N foot | 0, 3400 | 456, 2 | 235 | **2.14** | 2.14 | 810 N walking 8.97 | ankle on its stop, so the motors do not limit the lever; floor, rim and middle rib |
| 21 | pass | Fork bridge | shoulder to hand | al7075 (503) | 50.0 x 10.0 | 497 | 3,400 N foot | 229, 0 | 72, 0 | 89 | **5.67** | 4.24 | 5 kg in the hand 10.8 | ties the plates; read as a beam across them |
| 22 | pass | Shank tube, closed, past the rods | foot to pelvis | al7075 (503) | 53.0 x 43.2 | 327 | 3,400 N + 1,614 N side | 3400, 1614 | 201, 57 | 70 | **7.16** | 7.16 | 3,400 N foot 10.9; 810 N walking 17.9; motor peak 11.7 | 2 mm wall; Bredt for torsion |
| 23 | pass | Fork inner eye, net of its opening | foot to pelvis | al7075 (503) | 19.9 x 5.1 + 20.0 x 5.2 | 173 | 3,400 N foot | 2574, 0 | 23, 0 | 180 | **2.79** | 2.79 | 810 N walking 11.7; motor peak 20.2 |  |
| 24 | pass | Shoulder roll axle (back of the fork) | shoulder to hand | al7075 (503) | 22.0 x 22.0 | 380 | 3,400 N foot | 229, 0 | 85, 0 | 82 | **6.12** | 4.58 | 810 N walking 24.6; motor peak 14.1; 5 kg in the hand 12.1 |  |
| 25 | pass | Hand bracket | shoulder to hand | al7075 (503) | 20.0 x 6.0 | 117 | motor peak | 0, 0 | 14, 0 | 38 | **13.2** | 12.7 | 3,400 N foot 20.4; 810 N walking 85.5; 5 kg in the hand 20.3 |  |
| 26 | pass | Shoulder roll post (front of the fork) | shoulder to hand | al7075 (503) | 24.0 x 24.0 | 452 | 3,400 N foot | 274, 0 | 88, 0 | 66 | **7.65** | 5.71 | 810 N walking 30.6; motor peak 47.4; 5 kg in the hand 15.5 | a pitch moment reaches the fork as a couple over the bearing spacing |
| 27 | pass | Elbow idler arm | shoulder to hand | al7075 (503) | 12.0 x 4.0 | 47 | 3,400 N foot | 0, 53 | 1, 0 | 49 | **10.3** | 9.90 | 5 kg in the hand 16.1 | half the forearm load as a force at the stub, if a bearing existed |
| 28 | pass | Clevis plates above the frame | foot to pelvis | al7075 (503) | 2 x 14.4 x 5.0 + 2 x 14.4 x 6.0 | 309 | 3,400 N + 1,614 N side | 3400, 1614 | 127, 46 | 66 | **7.66** | 7.66 | 3,400 N foot 11.0; 810 N walking 16.2; motor peak 32.0 |  |
| 29 | pass | Yoke band under the pitch motor | foot to pelvis | al7075 (503) | 41.5 x 9.7 + 104.8 x 56.9 | 742 | 3,400 N foot | 0, 3400 | 192, 58 | 50 | **10.1** | 10.1 | 810 N walking 16.5; motor peak 148 |  |
| 30 | pass | Waist cup neck | pelvis to shoulder | al7075 (503) | 52.9 x 52.9 | 738 | motor peak | 0, 0 | 240, 0 | 30 | **16.9** | 16.9 | 3,400 N foot 20.5; 810 N walking 23.1; 5 kg in the hand 21.2 |  |
| 31 | pass | Neck housing column | neck to head | al7075 (503) | 17.2 x 17.0 | 229 | motor peak | 0, 0 | 0, 14 | 30 | **17.0** | 17.0 | 3,400 N foot 27.0; 810 N walking 113 |  |
| 32 | pass | Shank closed section at the ankle roll motor, panel on | foot to pelvis | al7075 (503) | 82.1 x 15.3 + 92.4 x 29.3 | 474 | 3,400 N + 1,614 N side | 3400, 1614 | 514, 36 | 80 | **6.29** | 6.29 | 3,400 N foot 27.5; 810 N walking 47.0; motor peak 18.9 |  |
| 33 | pass | Shank closed section at the ankle pitch motor, panel on | foot to pelvis | al7075 (503) | 97.1 x 20.0 + 9.5 x 4.8 + 97.4 x 23.1 | 355 | 3,400 N + 1,614 N side | 3400, 1614 | 379, 40 | 78 | **6.49** | 6.49 | 3,400 N foot 19.1; 810 N walking 35.7; motor peak 19.6 | counts the back panel: its 7 M3 hold it (Bolted joints). With the panel off it is an open section, SF about 0.4: the screws are not optional |
| 34 | pass | Pelvis bar between the hips | foot to pelvis | al7075 (503) | 2 x 22.1 x 2.0 + 2 x 67.1 x 16.0 + 2 x 5.7 x 4.6 | 521 | 3,400 N foot | 0, 3400 | 286, 90 | 61 | **8.19** | 8.19 | 810 N walking 20.3; motor peak 29.6 |  |
| 35 | pass | Shoulder bracket | shoulder to hand | al7075 (503) | 36.0 x 36.0 | 1282 | motor peak | 0, 0 | 0, 120 | 20 | **24.8** | 6.20 | 3,400 N foot 32.1; 810 N walking 135; 5 kg in the hand 65.9 |  |
| 36 | pass | Thigh tube under its collar | foot to pelvis | al7075 (503) | 66.0 x 66.0 | 402 | 3,400 N foot | 3400, 0 | 102, 0 | 25 | **20.3** | 20.3 | 810 N walking 28.2; motor peak 26.1 |  |
| 37 | pass | Thigh tube | foot to pelvis | al7075 (503) | 66.0 x 66.0 | 403 | 3,400 N foot | 3400, 0 | 102, 0 | 25 | **20.3** | 20.3 | 810 N walking 28.3; motor peak 26.2 | d66 x 2.5; no local buckling in this figure (D / t 26, plain 7075 tube: not close) |
| 38 | pass | Head frame | neck to head | al7075 (503) | 37.0 x 4.0 | 146 | 3,400 N foot | 0, 55 | 6, 1 | 63 | **7.98** | 7.98 | 810 N walking 33.5; motor peak 31.8 |  |
| 39 | pass | Cup neck between bearing and cheek | foot to pelvis | al7075 (503) | 52.8 x 52.8 | 732 | motor peak | 0, 0 | 0, 120 | 15 | **34.0** | 34.0 | 3,400 N foot 53.2 | the wall round the M5 heads: the motor's torque and the nearer support's share |
| 40 | pass | Shank waist behind the knee | foot to pelvis | al7075 (503) | 86.2 x 73.7 | 1027 | 3,400 N + 1,614 N side | 3400, 1614 | 617, 57 | 34 | **14.7** | 14.7 | 3,400 N foot 34.3; 810 N walking 46.4; motor peak 35.8 | closed; where the back line is scooped for the fold |
| 41 | pass | Fork plates at the roll axis (front net of its bore) | shoulder to hand | al7075 (503) | 64.0 x 6.0 + 6.0 x 3.5 + 33.5 x 6.0 | 599 | motor peak | 0, 0 | 120, 0 | 13 | **38.3** | 36.7 | 3,400 N foot 51.4; 810 N walking 101; 5 kg in the hand 58.6 |  |
| 42 | pass | Elbow cheeks over the discs, both | shoulder to hand | al7075 (503) | 2 x 46.0 x 3.0 | 272 | 3,400 N foot | 0, 207 | 41, 0 | 20 | **24.8** | 23.7 | 810 N walking 104; 5 kg in the hand 39.6 |  |
| 43 | pass | Elbow post | shoulder to hand | al7075 (503) | 34.0 x 34.0 | 906 | 5 kg in the hand | 0, 126 | 5, 36 | 10 | **49.8** | 25.0 | 3,400 N foot 53.1 |  |
| 44 | pass | Elbow axle | shoulder to hand | al7075 (503) | 34.0 x 34.0 | 906 | motor peak | 0, 0 | 0, 36 | 10 | **52.0** | 41.6 | 3,400 N foot 53.5; 5 kg in the hand 81.1 |  |
| 45 | pass | Upper arm frame | shoulder to hand | al7075 (503) | 30.0 x 30.0 | 886 | 3,400 N foot | 0, 207 | 52, 0 | 12 | **42.0** | 18.3 | 810 N walking 176; motor peak 60.3; 5 kg in the hand 72.0 |  |
| 46 | pass | Fork plates, lower | shoulder to hand | al7075 (503) | 2 x 50.0 x 6.0 | 593 | motor peak | 0, 0 | 36, 0 | 7 | **67.5** | 64.8 | 3,400 N foot 76.4; 810 N walking 136; 5 kg in the hand 74.3 |  |
| 47 | pass | Forearm lower frame | shoulder to hand | al7075 (503) | 30.0 x 24.0 | 706 | motor peak | 0, 0 | 0, 17 | 7 | **71.9** | 18.0 | 3,400 N foot 107; 810 N walking 450; 5 kg in the hand 120 |  |
| 48 | pass | Barrel where it meets the waist | foot to pelvis | al7075 (503) | 79.8 x 60.1 | 1693 | 3,400 N + 1,614 N side | 3400, 1614 | 652, 49 | 46 | **11.0** | 11.0 | 3,400 N foot 57.0; 810 N walking 82.0; motor peak 80.8 |  |
| 49 | pass | Elbow cheek discs at the bores (net of them) | shoulder to hand | al7075 (503) | 2 x 20.5 x 3.0 + 2 x 28.5 x 3.0 | 294 | motor peak | 0, 0 | 36, 0 | 6 | **83.2** | 79.9 | 3,400 N foot 86.8; 810 N walking 364; 5 kg in the hand 133 |  |
| 50 | pass | Roll barrel | foot to pelvis | al7075 (503) | 130.3 x 125.4 | 1069 | 3,400 N foot | 0, 3400 | 396, 53 | 16 | **31.7** | 31.7 | 810 N walking 83.3; motor peak 132 |  |
| 51 | pass | Yaw housing at the motor | foot to pelvis | al7075 (503) | 110.6 x 110.6 | 763 | 3,400 N foot | 3400, 0 | 102, 0 | 9 | **53.0** | 53.0 | 810 N walking 84.7; motor peak 195 |  |
| 52 | pass | Under the elbow motor | shoulder to hand | al7075 (503) | 30.0 x 8.0 | 237 | 3,400 N foot | 53, 0 | 3, 0 | 9 | **54.8** | 52.4 | 5 kg in the hand 85.5 | half the forearm load as a force at the stub, if a bearing existed |
| 53 | pass | Chest bar under the neck | pelvis to shoulder | al7075 (503) | 12.5 x 3.8 + 2 x 31.6 x 6.7 + 125.4 x 125.4 | 755 | motor peak | 0, 0 | 0, 240 | 5 | **95.3** | 95.3 | 3,400 N foot 140; 810 N walking 588; 5 kg in the hand 165 |  |
| 54 | pass | Ankle cross at its middle (net of the shaft's bore) | foot to pelvis | al7075 (503) | 2 x 30.6 x 6.2 | 348 | 3,400 N foot | 0, 1700 | 42, 0 | 22 | **22.8** | 22.8 | 810 N walking 95.8 | half the load from each cheek's bushing; the pins and shaft are read in group pivot |
| 55 | pass | Fork plates, upper, solid | shoulder to hand | al7075 (503) | 2 x 64.0 x 6.0 | 761 | motor peak | 0, 0 | 120, 0 | 5 | **99.9** | 95.9 | 3,400 N foot 125; 810 N walking 214; 5 kg in the hand 120 |  |
| 56 | pass | Hip barrel on the pelvis | foot to pelvis | al7075 (503) | 125.4 x 125.4 | 1022 | 3,400 N foot | 0, 3400 | 65, 90 | 11 | **44.3** | 44.3 | 810 N walking 105; motor peak 150 |  |
| 57 | pass | Fork inner cheek alone (the only one that takes motor torque) | foot to pelvis | al7075 (503) | 86.8 x 73.7 | 948 | motor peak | 0, 0 | 120, 0 | 5 | **112** | 112 | 3,400 N foot 123 |  |
| 58 | pass | Fork cheeks over the barrel, both | foot to pelvis | al7075 (503) | 86.8 x 84.3 | 1394 | 3,400 N foot | 3400, 0 | 104, 0 | 7 | **77.2** | 77.2 | 810 N walking 116; motor peak 146 |  |
| 59 | pass | Fork cheeks out of plane, under the recorded side force | foot to pelvis | al7075 (503) | 86.8 x 84.3 | 1394 | 3,400 N + 1,614 N side | 0, 1614 | 89, 0 | 4 | **122** | 122 |  | upper bound: all of the 1,614 N reaches the knee; each cheek bending on its thin side |
| 60 | pass | Barrel at the axis (walls, net of the bore) | foot to pelvis | al7075 (503) | 2 x 58.3 x 8.3 + 2 x 20.1 x 13.9 | 678 | 3,400 N foot | 2574, 0 | 48, 0 | 9 | **57.7** | 57.7 | 810 N walking 242; motor peak 134 | the inner bearing's share through the plate and walls, and the motor's torque |
| 61 | pass | Fork crown | foot to pelvis | al7075 (503) | 80.7 x 79.4 | 1893 | 3,400 N foot | 3400, 0 | 111, 0 | 6 | **89.9** | 89.9 | 810 N walking 138; motor peak 141 |  |
| 62 | pass | Waist housing on the pelvis | pelvis to shoulder | al7075 (503) | 232.6 x 125.4 | 4312 | 3,400 N foot | 1826, 0 | 177, 0 | 4 | **131** | 131 | 810 N walking 152; motor peak 174 |  |
| 63 | pass | Outer cheek at its bearing | foot to pelvis | al7075 (503) | 95.7 x 11.1 | 287 | 3,400 N foot | 2574, 0 | 2, 0 | 14 | **36.6** | 36.6 | 810 N walking 154 |  |
| 64 | pass | Chest bar at the shoulder motor | pelvis to shoulder | al7075 (503) | 66.0 x 43.8 + 63.9 x 46.3 + 65.2 x 10.0 + 124.2 x 55.5 | 1019 | 3,400 N foot | 0, 316 | 46, 39 | 4 | **113** | 113 | 810 N walking 473; motor peak 185; 5 kg in the hand 305 |  |
| 65 | pass | Rear cap at the axis | foot to pelvis | al7075 (503) | 127.0 x 26.7 | 709 | 3,400 N foot | 2574, 0 | 17, 0 | 11 | **46.2** | 46.2 | 810 N walking 194 |  |
| 66 | pass | Knee post at its root | foot to pelvis | al7075 (503) | 52.3 x 52.3 | 2027 | 3,400 N foot | 0, 2574 | 11, 0 | 3 | **148** | 148 | 810 N walking 620 | the outer support taking the larger share, an upper bound for this side |
| 67 | pass | Barrel plate round the inner bearing | foot to pelvis | al7075 (503) | 7.8 x 3.5 + 6.2 x 0.7 + 16.7 x 6.8 + 16.0 x 0.7 + 65.6 x 40.3 + 368.8 x 125.0 | 14782 | 3,400 N foot | 0, 2574 | 8, 7 | 0 | **1029** | 1029 | 810 N walking 4318 |  |

## Interfaces (hand estimates)

Contact area between two rigid parts: overlap volume over its thinnest dimension, or the shared area of exactly coplanar faces. Required: 100 mm2 (the pad of one M5) x the bolts needed to pass the calm-walking force at factor 1.5 (slip load 1500 N a bolt, from memory). This only asks whether a joint has room to exist. Screws are read in their own table below, at the knee so far.

| verdict | interface | path | force (N) | area (mm2) | required | kind | depth (mm) |
|---|---|---|---|---|---|---|---|
| **FAIL** | L elbow idler arm / L elbow under motor | shoulder to hand | 106 | 55 | 100 | overlap | 3.00 |
| **FAIL** | L elbow idler stub / L elbow idler arm | shoulder to hand | 106 | 74 | 100 | overlap | 3.50 |
| **FAIL** | L shoulder roll plate front low / L_shoulder_yaw actuator (buy) RS02 | shoulder to hand | 106 | 87 | 100 | overlap | 1.50 |
| **FAIL** | L shoulder roll plate back low / L_shoulder_yaw actuator (buy) RS02 | shoulder to hand | 106 | 87 | 100 | overlap | 1.50 |
| pass | L foot frame / L ankle roll bushing back | foot to pelvis | 405 | 100 | 100 | overlap | 0.25 |
| pass | L ankle pitch bushing in / L shank body | foot to pelvis | 405 | 101 | 100 | overlap | 0.25 |
| pass | L ankle pitch bushing out / L shank body | foot to pelvis | 405 | 109 | 100 | overlap | 0.23 |
| pass | L foot frame / L ankle roll bushing front | foot to pelvis | 405 | 110 | 100 | overlap | 0.23 |
| pass | L shoulder roll plate back / L shoulder roll plate back low | shoulder to hand | 106 | 115 | 100 | flush | 0.00 |
| pass | L shoulder roll plate front / L shoulder roll plate front low | shoulder to hand | 106 | 115 | 100 | flush | 0.00 |
| pass | L hip yoke / L_hip_roll flange | foot to pelvis | 810 | 122 | 100 | overlap | 0.57 |
| pass | L foot frame / L ankle roll post | ankle rods and cranks | 1385 | 281 | 200 | overlap | 0.26 |
| pass | L elbow bridge / L elbow cheek out | shoulder to hand | 106 | 149 | 100 | overlap | 3.00 |
| pass | L elbow bridge / L elbow cheek in | shoulder to hand | 106 | 149 | 100 | overlap | 3.00 |
| pass | L wrist cheek / L_wrist_roll actuator (buy) RS00 | shoulder to hand | 106 | 149 | 100 | overlap | 2.56 |
| pass | L elbow under motor / L forearm frame | shoulder to hand | 106 | 223 | 100 | overlap | 4.50 |
| pass | L hand bracket / L_wrist_roll flange | shoulder to hand | 106 | 230 | 100 | overlap | 3.50 |
| pass | pelvis frame / waist ring | pelvis to shoulder | 435 | 268 | 100 | overlap | 0.80 |
| pass | pelvis frame / L hip ring | foot to pelvis | 810 | 269 | 100 | overlap | 0.80 |
| pass | L hip yoke / L hip yaw ring | foot to pelvis | 810 | 274 | 100 | overlap | 0.90 |
| pass | L forearm lower frame / L_wrist_pitch actuator (buy) RS00 | shoulder to hand | 106 | 314 | 100 | overlap | 1.50 |
| pass | L forearm frame / L_wrist_yaw actuator (buy) RS02 | shoulder to hand | 106 | 362 | 100 | overlap | 5.00 |
| pass | L ankle roll shaft / L ankle cross | foot to pelvis | 810 | 367 | 100 | flush | 0.00 |
| pass | L shoulder roll axle / L_shoulder_roll flange | shoulder to hand | 106 | 380 | 100 | overlap | 3.25 |
| pass | L shoulder roll axle / L shoulder roll plate back | shoulder to hand | 106 | 380 | 100 | overlap | 6.00 |
| pass | L shoulder roll plate front low / L shoulder roll bridge | shoulder to hand | 106 | 451 | 100 | overlap | 6.00 |
| pass | L shoulder roll plate back low / L shoulder roll bridge | shoulder to hand | 106 | 451 | 100 | overlap | 6.00 |
| pass | L wrist cheek / L_wrist_pitch flange | shoulder to hand | 106 | 452 | 100 | overlap | 5.00 |
| pass | L hip yaw ring / L_hip_yaw actuator (buy) RS03 | foot to pelvis | 810 | 457 | 100 | overlap | 0.15 |
| pass | neck housing / neck_yaw flange | neck to head | 19 | 479 | 100 | overlap | 0.70 |
| pass | L elbow cheek disc in / L elbow axle | shoulder to hand | 106 | 492 | 100 | overlap | 0.20 |
| pass | L shank body / L knee rear cap | foot to pelvis | 613 | 534 | 100 | overlap | 0.69 |
| pass | L thigh fork / L knee outer cheek | foot to pelvis | 613 | 543 | 100 | overlap | 1.67 |
| pass | L shoulder bracket / L_shoulder_roll actuator (buy) RS06 | shoulder to hand | 106 | 545 | 100 | overlap | 2.08 |
| pass | L upper arm frame / L elbow bridge | shoulder to hand | 106 | 619 | 100 | overlap | 2.00 |
| pass | L forearm lower frame / L_wrist_yaw flange | shoulder to hand | 106 | 628 | 100 | overlap | 4.25 |
| pass | L upper arm frame / L_shoulder_yaw flange | shoulder to hand | 106 | 753 | 100 | overlap | 2.75 |
| pass | neck housing / neck_pitch actuator (buy) RS00 | neck to head | 19 | 758 | 100 | overlap | 0.17 |
| pass | L elbow cheek out / L elbow cheek disc out | shoulder to hand | 106 | 788 | 100 | overlap | 3.00 |
| pass | L elbow cheek in / L elbow cheek disc in | shoulder to hand | 106 | 788 | 100 | overlap | 3.00 |
| pass | chest frame / neck_yaw actuator (buy) RS00 | neck to head | 19 | 871 | 100 | overlap | 0.25 |
| pass | L elbow post / L forearm frame | shoulder to hand | 106 | 875 | 100 | overlap | 5.00 |
| pass | L elbow axle / L_elbow flange | shoulder to hand | 106 | 906 | 100 | overlap | 0.60 |
| pass | head frame / neck_pitch flange | neck to head | 19 | 987 | 100 | overlap | 0.30 |
| pass | chest frame / waist_yaw flange | pelvis to shoulder | 435 | 1150 | 100 | overlap | 0.34 |
| pass | L shoulder bracket / L_shoulder_pitch flange | shoulder to hand | 106 | 1187 | 100 | overlap | 4.85 |
| pass | L shank body / L shank back panel | foot to pelvis | 81 | 1281 | 100 | overlap | 0.20 |
| pass | L hip carrier / L_hip_pitch flange | foot to pelvis | 810 | 1355 | 100 | overlap | 0.34 |
| pass | L thigh fork / L_knee flange | foot to pelvis | 613 | 1461 | 100 | overlap | 0.38 |
| pass | L forearm frame / L_elbow actuator (buy) RS06 | shoulder to hand | 106 | 1618 | 100 | flush | 0.00 |
| pass | L thigh fork / L_hip_yaw flange | foot to pelvis | 810 | 2357 | 100 | overlap | 0.20 |
| pass | pelvis frame / L_hip_pitch actuator (buy) RS04 | foot to pelvis | 543 | 3516 | 100 | overlap | 0.27 |
| pass | chest frame / L_shoulder_pitch actuator (buy) RS04 | pelvis to shoulder | 106 | 3516 | 100 | overlap | 0.27 |
| pass | L hip carrier / L_hip_roll actuator (buy) RS04 | foot to pelvis | 810 | 3528 | 100 | overlap | 0.31 |
| pass | pelvis frame / waist_yaw actuator (buy) RS04 | pelvis to shoulder | 435 | 3580 | 100 | overlap | 0.37 |
| pass | L shank body / L_knee actuator (buy) RS04 | foot to pelvis | 543 | 8212 | 100 | flush | 0.00 |

## Output bearings: required (hand estimates), rating unknown

RobStride publishes no output-bearing rating that I could find, so nothing here is a verdict. This is what each must take, to put to the maker. Tilting moment is about the axes across the joint, at the output face. "Equivalent" is radial + axial + 2 x moment / pitch, with an assumed bearing pitch of 0.9 x motor radius: for comparing joints, not for selecting a bearing.

| joint | motor | case | axial (N) | radial (N) | tilting moment (N m) | equivalent (kN) |
|---|---|---|---|---|---|---|
| L_hip_roll | RS04 | 3,400 N foot | 0 | 3400 | 335 | 15.8 |
| L_knee | RS04 | 3,400 N foot | 0 | 3400 | 142 | 8.7 |
| waist_yaw | RS04 | 3,400 N foot | 1826 | 0 | 177 | 8.4 |
| L_hip_yaw | RS03 | 3,400 N foot | 3400 | 0 | 102 | 7.7 |
| L_hip_pitch | RS04 | 3,400 N foot | 0 | 3400 | 115 | 7.7 |
| waist_yaw | RS04 | 810 N walking | 435 | 0 | 171 | 6.8 |
| L_hip_roll | RS04 | 810 N walking | 0 | 810 | 148 | 6.3 |
| L_hip_yaw | RS03 | 810 N walking | 810 | 0 | 99 | 4.9 |
| L_shoulder_roll | RS06 | 3,400 N foot | 274 | 0 | 88 | 4.7 |
| L_shoulder_yaw | RS02 | 3,400 N foot | 0 | 229 | 59 | 3.6 |
| L_knee | RS04 | 810 N walking | 0 | 810 | 63 | 3.1 |
| L_hip_pitch | RS04 | 810 N walking | 0 | 810 | 57 | 2.9 |
| L_shoulder_roll | RS06 | 5 kg in the hand | 98 | 0 | 44 | 2.3 |
| L_shoulder_yaw | RS02 | 5 kg in the hand | 0 | 90 | 33 | 2.0 |
| L_elbow | RS06 | 3,400 N foot | 207 | 0 | 32 | 1.8 |
| L_shoulder_pitch | RS04 | 3,400 N foot | 154 | 0 | 36 | 1.5 |
| L_shoulder_pitch | RS04 | 5 kg in the hand | 89 | 0 | 36 | 1.4 |
| L_elbow | RS06 | 5 kg in the hand | 86 | 0 | 22 | 1.2 |
| L_shoulder_roll | RS06 | 810 N walking | 65 | 0 | 21 | 1.1 |
| L_wrist_yaw | RS02 | 3,400 N foot | 0 | 106 | 17 | 1.0 |
| neck_yaw | RS00 | 3,400 N foot | 0 | 80 | 11 | 0.9 |
| L_shoulder_pitch | RS04 | 810 N walking | 75 | 0 | 21 | 0.9 |
| L_shoulder_yaw | RS02 | 810 N walking | 0 | 54 | 14 | 0.8 |
| L_wrist_yaw | RS02 | 5 kg in the hand | 0 | 68 | 13 | 0.8 |
| L_wrist_pitch | RS00 | 3,400 N foot | 79 | 0 | 8 | 0.7 |
| L_wrist_pitch | RS00 | 5 kg in the hand | 63 | 0 | 8 | 0.7 |
| neck_pitch | RS00 | 3,400 N foot | 56 | 0 | 7 | 0.6 |
| L_elbow | RS06 | 810 N walking | 49 | 0 | 8 | 0.4 |
| L_wrist_roll | RS00 | 5 kg in the hand | 59 | 0 | 4 | 0.4 |
| L_wrist_roll | RS00 | 3,400 N foot | 55 | 0 | 4 | 0.4 |
| L_wrist_yaw | RS02 | 810 N walking | 0 | 25 | 4 | 0.3 |
| neck_yaw | RS00 | 810 N walking | 0 | 19 | 3 | 0.2 |
| L_wrist_pitch | RS00 | 810 N walking | 19 | 0 | 2 | 0.2 |
| neck_pitch | RS00 | 810 N walking | 13 | 0 | 2 | 0.1 |
| L_wrist_roll | RS00 | 810 N walking | 13 | 0 | 1 | 0.1 |

## Bolted joints (hand estimates, not VDI 2230)

12.9 screws (assumed), real patterns from the maker's drawing, placed by `spec/hardware.py`. Fp: preload, the smaller of 0.75 x proof and strip force / 2. Formulas per pattern of n screws on radius r: slip SF = mu n Fp / (V + T / r); separation SF = Fp / (Fa / n + 2 Mt / (n r)); shear if slipped SF = 0.6 Rm As / (V / n + T / (n r)); tension SF = proof / (Fp + phi Ft); strip SF = F_strip / (Fp + phi Ft). T: the motor's peak. V, Fa: below. Required: SF 2 except tension 1.1 (preload alone uses 0.75 of proof). Pins not counted in shear. Not modelled: fatigue, embedding, flange flex.

| pattern | load | screws | thread, engaged mm | Fp kN (limit) | torque N m (estimate) | T, V, Fa, Mt | slip | separation | shear | tension | strip |
|---|---|---|---|---|---|---|---|---|---|---|---|
| L knee hub | the design, the supports take the force | 9 of 9 on d36 | M5, 6.2 | 10.3 (0.75 x proof) | 10.3 | 120 N m, 0 N, 0 N, 0 N m | 2.1 | inf | 14.0 | 1.3 | 2.2 |
| L knee hub | what if the motor carried it all | 9 of 9 on d36 | M5, 6.2 | 10.3 (0.75 x proof) | 10.3 | 120 N m, 3400 N, 1614 N, 142 N m | 1.4 | 5.3 | 9.3 | 1.3 | 2.1 |
| L knee stator | the design, the supports take the force | 10 of 10 on d106 | M4, 4.7 | 6.4 (0.75 x proof) | 5.1 | 120 N m, 0 N, 0 N, 0 N m | 4.2 | inf | 28.4 | 1.3 | 2.2 |
| L knee stator | what if the motor carried it all | 10 of 10 on d106 | M4, 4.7 | 6.4 (0.75 x proof) | 5.1 | 120 N m, 3400 N, 1614 N, 142 N m | 1.7 | 9.2 | 11.3 | 1.3 | 2.1 |
| L hip yaw hub | the design, the supports take the force | 6 of 6 on d30 | M4, 5.5 | 6.4 (0.75 x proof) | 5.1 | 60 N m, 0 N, 0 N, 0 N m | 1.5 | inf | 9.8 | 1.3 | 2.5 |
| L hip yaw hub | what if the motor carried it all | 6 of 6 on d30 | M4, 5.5 | 6.4 (0.75 x proof) | 5.1 | 60 N m, 0 N, 1614 N, 102 N m | 1.5 | 2.6 | 9.8 | 1.2 | 2.3 |
| L ankle pitch stator | the design, the supports take the force | 5 of 8 on d98 | M4, 7.8 | 6.4 (0.75 x proof) | 5.1 | 60 N m, 0 N, 0 N, 0 N m | 3.9 | inf | 26.2 | 1.3 | 3.6 |
| L ankle pitch stator | what if the motor carried it all | 5 of 8 on d98 | M4, 7.8 | 6.4 (0.75 x proof) | 5.1 | 60 N m, 3400 N, 1614 N, 0 N m | 1.0 | 19.8 | 6.9 | 1.3 | 3.5 |
| L ankle roll stator | the design, the supports take the force | 6 of 8 on d82 | M3, 8.0 | 3.7 (0.75 x proof) | 2.2 | 36 N m, 0 N, 0 N, 0 N m | 3.8 | inf | 25.2 | 1.3 | 4.8 |
| L ankle roll stator | what if the motor carried it all | 6 of 8 on d82 | M3, 8.0 | 3.7 (0.75 x proof) | 2.2 | 36 N m, 3400 N, 1614 N, 0 N m | 0.8 | 13.6 | 5.2 | 1.3 | 4.7 |
| L ankle pitch hub | the design, the supports take the force | 6 of 6 on d30 | M4, 5.8 | 6.4 (0.75 x proof) | 5.1 | 60 N m, 0 N, 0 N, 0 N m | 1.5 | inf | 9.8 | 1.3 | 2.7 |
| L ankle pitch hub | what if the motor carried it all | 6 of 6 on d30 | M4, 5.8 | 6.4 (0.75 x proof) | 5.1 | 60 N m, 3400 N, 1614 N, 0 N m | 0.8 | 23.8 | 5.2 | 1.3 | 2.6 |
| L ankle roll hub | the design, the supports take the force | 6 of 6 on d24 | M4, 6.0 | 6.4 (0.75 x proof) | 5.1 | 36 N m, 0 N, 0 N, 0 N m | 1.9 | inf | 12.9 | 1.3 | 2.7 |
| L ankle roll hub | what if the motor carried it all | 6 of 6 on d24 | M4, 6.0 | 6.4 (0.75 x proof) | 5.1 | 36 N m, 3400 N, 1614 N, 0 N m | 0.9 | 23.8 | 6.0 | 1.3 | 2.7 |
| L hip pitch stator | the design, the supports take the force | 10 of 10 on d106 | M4, 5.3 | 6.4 (0.75 x proof) | 5.1 | 120 N m, 0 N, 0 N, 0 N m | 4.2 | inf | 28.4 | 1.3 | 2.4 |
| L hip pitch stator | what if the motor carried it all | 10 of 10 on d106 | M4, 5.3 | 6.4 (0.75 x proof) | 5.1 | 120 N m, 3400 N, 1614 N, 115 N m | 1.7 | 10.7 | 11.3 | 1.3 | 2.4 |
| waist stator | the design, the supports take the force | 10 of 10 on d106 | M4, 5.3 | 6.4 (0.75 x proof) | 5.1 | 120 N m, 0 N, 0 N, 0 N m | 4.2 | inf | 28.4 | 1.3 | 2.4 |
| waist stator | what if the motor carried it all | 10 of 10 on d106 | M4, 5.3 | 6.4 (0.75 x proof) | 5.1 | 120 N m, 0 N, 1614 N, 177 N m | 4.2 | 7.7 | 28.4 | 1.3 | 2.4 |
| L hip roll stator | the design, the supports take the force | 10 of 10 on d106 | M4, 5.3 | 6.4 (0.75 x proof) | 5.1 | 120 N m, 0 N, 0 N, 0 N m | 4.2 | inf | 28.4 | 1.3 | 2.4 |
| L hip roll stator | what if the motor carried it all | 10 of 10 on d106 | M4, 5.3 | 6.4 (0.75 x proof) | 5.1 | 120 N m, 3400 N, 1614 N, 335 N m | 1.7 | 4.5 | 11.3 | 1.3 | 2.3 |
| L hip pitch hub | the design, the supports take the force | 9 of 9 on d36 | M5, 6.2 | 10.3 (0.75 x proof) | 10.3 | 120 N m, 0 N, 0 N, 0 N m | 2.1 | inf | 14.0 | 1.3 | 2.2 |
| L hip pitch hub | what if the motor carried it all | 9 of 9 on d36 | M5, 6.2 | 10.3 (0.75 x proof) | 10.3 | 120 N m, 3400 N, 1614 N, 115 N m | 1.4 | 6.5 | 9.3 | 1.3 | 2.1 |
| waist hub | the design, the supports take the force | 9 of 9 on d36 | M5, 6.2 | 10.3 (0.75 x proof) | 10.3 | 120 N m, 0 N, 0 N, 0 N m | 2.1 | inf | 14.0 | 1.3 | 2.2 |
| waist hub | what if the motor carried it all | 9 of 9 on d36 | M5, 6.2 | 10.3 (0.75 x proof) | 10.3 | 120 N m, 0 N, 1614 N, 177 N m | 2.1 | 4.4 | 14.0 | 1.3 | 2.1 |
| L hip roll hub | the design, the supports take the force | 9 of 9 on d36 | M5, 6.2 | 10.3 (0.75 x proof) | 10.3 | 120 N m, 0 N, 0 N, 0 N m | 2.1 | inf | 14.0 | 1.3 | 2.2 |
| L hip roll hub | what if the motor carried it all | 9 of 9 on d36 | M5, 6.2 | 10.3 (0.75 x proof) | 10.3 | 120 N m, 3400 N, 1614 N, 335 N m | 1.4 | 2.4 | 9.3 | 1.2 | 2.0 |
| L hip yaw stator | the design, the supports take the force | 8 of 8 on d98 | M4, 4.8 | 6.4 (0.75 x proof) | 5.1 | 60 N m, 0 N, 0 N, 0 N m | 6.3 | inf | 42.0 | 1.3 | 2.2 |
| L hip yaw stator | what if the motor carried it all | 8 of 8 on d98 | M4, 4.8 | 6.4 (0.75 x proof) | 5.1 | 60 N m, 0 N, 1614 N, 102 N m | 6.3 | 8.9 | 42.0 | 1.3 | 2.1 |
| L shoulder stator | the design, the supports take the force | 10 of 10 on d106 | M4, 5.3 | 6.4 (0.75 x proof) | 5.1 | 120 N m, 0 N, 0 N, 0 N m | 4.2 | inf | 28.4 | 1.3 | 2.4 |
| L shoulder stator | what if the motor carried it all | 10 of 10 on d106 | M4, 5.3 | 6.4 (0.75 x proof) | 5.1 | 120 N m, 0 N, 1614 N, 36 N m | 4.2 | 21.5 | 28.4 | 1.3 | 2.4 |
| neck stator | the design, the supports take the force | 6 of 6 on d50 | M3, 4.5 | 3.7 (0.75 x proof) | 2.2 | 14 N m, 0 N, 0 N, 0 N m | 5.9 | inf | 39.4 | 1.3 | 2.7 |
| neck stator | what if the motor carried it all | 6 of 6 on d50 | M3, 4.5 | 3.7 (0.75 x proof) | 2.2 | 14 N m, 80 N, 1614 N, 11 N m | 5.1 | 8.9 | 34.5 | 1.3 | 2.6 |
| neck pitch stator | the design, the supports take the force | 6 of 6 on d50 | M3, 4.0 | 3.7 (0.75 x proof) | 2.2 | 14 N m, 0 N, 0 N, 0 N m | 5.9 | inf | 39.4 | 1.3 | 2.4 |
| neck pitch stator | what if the motor carried it all | 6 of 6 on d50 | M3, 4.0 | 3.7 (0.75 x proof) | 2.2 | 14 N m, 0 N, 1614 N, 7 N m | 5.9 | 10.1 | 39.4 | 1.3 | 2.4 |
| neck pitch hub | the design, the supports take the force | 6 of 6 on d27 | M3, 4.3 | 3.7 (0.75 x proof) | 2.2 | 14 N m, 0 N, 0 N, 0 N m | 3.2 | inf | 21.3 | 1.3 | 2.6 |
| neck pitch hub | what if the motor carried it all | 6 of 6 on d27 | M3, 4.3 | 3.7 (0.75 x proof) | 2.2 | 14 N m, 0 N, 1614 N, 7 N m | 3.2 | 8.2 | 21.3 | 1.3 | 2.5 |
| neck yaw hub | the design, the supports take the force | 6 of 6 on d27 | M3, 4.2 | 3.7 (0.75 x proof) | 2.2 | 14 N m, 0 N, 0 N, 0 N m | 3.2 | inf | 21.3 | 1.3 | 2.5 |
| neck yaw hub | what if the motor carried it all | 6 of 6 on d27 | M3, 4.2 | 3.7 (0.75 x proof) | 2.2 | 14 N m, 80 N, 1614 N, 11 N m | 2.9 | 6.8 | 19.8 | 1.3 | 2.4 |
| L knee rim | the side force and the post's tilt; the cap takes no torque | 6 of 6 on d126 | M3, 7.0 | 3.7 (0.75 x proof) | 2.2 | 0 N m, 0 N, 1614 N, 0 N m | 3294000000.0 | 13.6 | 3681960000.0 | 1.3 | 6.7 |
| L knee cheek top | half of the outer support, 2,574 N, and half of the moment: the side force 1,614 N at 90 mm over the row, and the bearing 5.75 mm off the seam: an upper bound | 2 of 2 on d50 | M5, 11.5 | 10.3 (0.75 x proof) | 10.3 | 0 N m, 1287 N, 0 N, 80 N m | 2.4 | 3.2 | 16.2 | 1.3 | 6.1 |
| L knee cheek | the other half, as the top pair | 2 of 2 on d50 | M5, 10.0 | 10.3 (0.75 x proof) | 10.3 | 0 N m, 1287 N, 0 N, 80 N m | 2.4 | 3.2 | 16.2 | 1.3 | 5.3 |
| L knee post | the side force, on the inner race | 4 of 4 on d37 | M4, 8.4 | 6.4 (0.75 x proof) | 5.1 | 0 N m, 0 N, 1614 N, 0 N m | 3834000000.0 | 15.8 | 6426960000.0 | 1.3 | 6.1 |
| L knee hub in foot | a cover: its own weight at 10 g | 2 of 2 on d20 | M4, 9.2 | 6.4 (0.75 x proof) | 5.1 | 0 N m, 30 N, 30 N, 0 N m | 63.9 | 426.0 | 428.5 | 1.3 | 6.7 |
| L knee hub out foot | a cover: its own weight at 10 g | 2 of 2 on d20 | M4, 9.2 | 6.4 (0.75 x proof) | 5.1 | 0 N m, 30 N, 30 N, 0 N m | 63.9 | 426.0 | 428.5 | 1.3 | 6.7 |
| L shank panel | shear flow in the closed section, a hand figure from the motor's torque on the section | 6 of 6 on d75 | M3, 7.0 | 3.7 (0.75 x proof) | 2.2 | 0 N m, 200 N, 0 N, 0 N m | 16.5 | inf | 110.5 | 1.3 | 6.7 |
| L thigh collar | the whole leg, and the yaw motor's and knee motor's peak | 6 of 6 on d78 | M4, 8.0 | 6.4 (0.75 x proof) | 5.1 | 60 N m, 810 N, 3400 N, 120 N m | 2.4 | 4.0 | 16.4 | 1.3 | 5.6 |
| L ankle roll post | the roll rod at the peak of the RS06, 1,385 N along the post; its 6.6 deg lean, 160 N across, 61 mm up | 2 of 2 on d40 | M4, 11.0 | 6.4 (0.75 x proof) | 5.1 | 0 N m, 160 N, 1385 N, 10 N m | 12.0 | 5.3 | 80.3 | 1.3 | 7.8 |
| L hip pitch rim | what the ring passes on: the bearing goes in it, not the screws, which only hold it | 6 of 6 on d126 | M3, 7.8 | 3.7 (0.75 x proof) | 2.2 | 0 N m, 0 N, 1614 N, 0 N m | 3294000000.0 | 13.6 | 3681960000.0 | 1.3 | 7.4 |
| waist rim | what the ring passes on: the bearing goes in it, not the screws, which only hold it | 6 of 6 on d126 | M3, 7.8 | 3.7 (0.75 x proof) | 2.2 | 0 N m, 0 N, 1000 N, 0 N m | 3294000000.0 | 22.0 | 3681960000.0 | 1.3 | 7.4 |
| L hip yaw rim | the leg, at 810 N, from the motor's face into the housing, and the yaw motor's peak | 6 of 6 on d111 | M3, 6.8 | 3.7 (0.75 x proof) | 2.2 | 60 N m, 810 N, 810 N, 60 N m | 1.7 | 7.4 | 11.7 | 1.3 | 6.3 |

## Bearings (catalogue ratings, hand estimates of load)

Two supports at the knee, on the lever rule, the motor's own bearing taking nothing (assumed: its rating is unpublished). Static: fs = C0 / (Fr + 0.44 Fa) (IKO CAT-57166), needs 1.5 (its Table 4, normal operation). "With side" adds the recorded 1,614 N as axial, an upper bound as in the load cases. Dynamic: 810 N, the lever limited by the ankle's rated torque, fw 1.5; life in oscillating cycles of 60 deg; a hand figure for service life.

| bearing | catalogue | d x D x B | C, C0 (N) | peak Fr (N) | fs at 3,400 N | fs with side | walk P (N) | life, millions of cycles | needs |
|---|---|---|---|---|---|---|---|---|---|
| L hip pitch bearing | CRBS 508 (iko, document) | 50 x 66 x 8 | 4900, 6170 | 3400 | **1.81** | 1.50 | 1215 | 313 | 31.5 |
| waist bearing | CRBS 508 (iko, document) | 50 x 66 x 8 | 4900, 6170 | 3400 | **1.81** | 1.50 | 1215 | 313 | 31.5 |
| L knee outer bearing | CRBS 508 (iko, document) | 50 x 66 x 8 | 4900, 6170 | 2227 | **2.77** | 2.10 | 867 | 966 | 31.5 |
| L knee inner bearing | CRBS 508 (iko, document) | 50 x 66 x 8 | 4900, 6170 | 2573 | **2.40** | 1.88 | 990 | 620 | 31.5 |

### Every catalogue bearing against the knee's slot

The outer support: d50 post, 8.5 mm for the race between its shoulder and its lip, and the eye's d96. Same load as above. Rows from `spec/hardware_catalog.json`; `search_excerpt` rows want a check on the maker's page.

| bearing | d x D x B | C0 (N) | fs at 3,400 N | fs with side | life, M cycles | goes in today | what would have to grow | read |
|---|---|---|---|---|---|---|---|---|
| CRBS 508 | 50 x 66 x 8 | 6170 | 2.77 | 2.10 | 966 | **yes** | nothing | document |
| 61809 | 45 x 58 x 7 | 4000 | 1.80 | 1.80 | 726 | no | post down to d45 (fits; weaker post) | search_excerpt |
| W 61808-2RS1 (stainless) | 40 x 52 x 7 | 3750 | 1.68 | 1.68 | 274 | no | post down to d40 (fits; weaker post) | search_excerpt |
| 61808-2RZ | 40 x 52 x 7 | 3650 | 1.64 | 1.64 | 601 | no | post down to d40 (fits; weaker post) | search_excerpt |
| 61807 | 35 x 47 x 7 | 3200 | 1.44 | 1.44 | 494 | no | post down to d35 (fits; weaker post) | search_excerpt |
| CRBT 505 A | 50 x 61 x 5 | 3200 | 1.44 | 1.09 | 75 | **yes** | nothing | document |
| 61806 | 30 x 42 x 7 | 2900 | 1.30 | 1.30 | 318 | no | post down to d30 (fits; weaker post) | search_excerpt |
| 61805 | 25 x 37 x 7 | 2600 | 1.17 | 1.17 | 382 | no | post down to d25 (fits; weaker post) | search_excerpt |
| CRBT 405 A | 40 x 51 x 5 | 2520 | 1.13 | 0.86 | 49 | no | post down to d40 (fits; weaker post) | document |
| CRBH 208 A | 20 x 36 x 8 | 2430 | 1.09 | 0.83 | 170 | no | post down to d20 (fits; weaker post) | document |
| CRBT 305 A | 30 x 41 x 5 | 1970 | 0.88 | 0.67 | 32 | no | post down to d30 (fits; weaker post) | document |
| CRBT 205 A | 20 x 31 x 5 | 1290 | 0.58 | 0.44 | 15 | no | post down to d20 (fits; weaker post) | document |

## The knee motor's heat path (a hand estimate)

RS04, 40 N m rated on a 345 x 345 mm plate, 35 on 220 x 200 (`spec/actuators.json`). What it conducts into now, with paste in the bore and a gap pad on the skirt, both assumed:

| path | area (cm2) |
|---|---|
| side wall in the barrel's bore, 0.05 mm gap | 146 |
| front face on the barrel's plate, bolted | 77 |
| rear face on the rear cap's skirt | 38 |
| **total contact** | **262** |
| maker's plate, one side: 220 x 200 / 345 x 345 | 440 / 1190 |
| of that, the washer on the outer hub cap, the hub's own path | 5 |
| outward metal of the barrel and its ends | 485 |

**Ratio:** contact is 0.59 of the small plate's one side, 0.22 of the big one's. Outward metal is 0.55 of the small plate's two sides and 0.20 of the big one's, and it sits under knit, where the plate is in open air. So the rated torque isn't transferred by this: sustained torque under the garment wants a thermal model or test. The hub cap's own path is thin. Not modelled: paste resistance, airflow, the knit.

## Assumptions behind the two tables above

From `spec/assumptions.json`, one row each: change a value there and run the checks. All status `assumed`. "estimate, from memory" means a hand figure no document here backs.

| id | value | basis | source | what it risks | settled by |
|---|---|---|---|---|---|
| hub_thread_depth_RS04 | 6.5 mm | drawing | RS04 User Manual 260713 section 1.1: 9-M5 6.5 MIN. User's choice, 2026-11-05: design to the drawing | If the STEP is right, engagement falls from 6 to 3 mm, 0.6 x d: thread strip then limits preload (reports/strength.md shows the margin) | RobStride question 3 |
| hub_thread_depth_RS06 | 6.0 mm | drawing | RS06 User Manual 260713 section 1.1: 6-M4 depth 6. User's choice, 2026-11-05 | Not used yet: no RS06 hub is bolted in the spec | RobStride question 3 |
| hub_thread_depth_RS02 | 7.0 mm | drawing | RS02 User Manual 260713 section 1.1: 6-M4 7 MIN. User's choice, 2026-11-05 | Not used yet: no RS02 hub is bolted in the spec | RobStride question 3 |
| rear_threads | drawing only  | standard practice | User's rule, 2026-11-05: no load on rear threads that are not on a drawing. RS04's rear 10-M4 is on its drawing; RS03 and RS06 rear ears and RS02's through-holes are not | RS04's rear 10-M4 is drawn but its rated use isn't stated | RobStride question 7 |
| screw_grade | 12.9  | standard practice | User's rule, 2026-11-05. Proof and breaking loads: ISO 898-1 via hardware_catalog.json (wuerth p3) | RobStride gives no grade or torque. A softer hub thread may need less | RobStride question 4 |
| preload_fraction | 0.75 of proof load | estimate, from memory | Usual target for reusable joints (Shigley, VDI 2230 practice) | Scatter in tightening is about +-25 % with a torque wrench: separation margins carry it | Joint trial |
| torque_coefficient | 0.2 T = K F d | estimate, from memory | Black-oxide steel screw, dry or lightly oiled (Shigley) | Sets the torque quoted, not the capacities | Joint trial |
| friction_joint | 0.15  | estimate, from memory | Bare aluminium on aluminium for slip, as tools/strength.py BOLT_SLIP_N already used | Anodised or oiled faces can be lower: slip margins scale with it directly | Coupon test |
| joint_stiffness_factor | 0.2 share of external tension the screw sees | estimate, from memory | Typical screw in short metal clamp (VDI 2230 range about 0.1 to 0.3) | Small: tension margins are mostly preload | VDI 2230 calculation |
| shear_al_motor | 207.0 MPa | estimate, from memory | 6061-T6 shear strength (ASM). RobStride's housing and hub alloys are unknown | A casting (ADC12 about 185 MPa, estimate) drops the strip margin by a tenth | RobStride question 4 |
| shear_al_part | 331.0 MPa | estimate, from memory | 7075-T6 shear strength (ASM) | Only for threads tapped in our own parts | Material certificate |
| strip_factor | 2.0 thread strip force / screw load | standard practice | Same factor as tools/strength.py SF_MIN. The stripping area is the standard one for an internal thread (ISO 898 / FED-STD-H28), which assumes even load across the threads; first threads carry more | The check limits preload by this; it does not model fatigue of the thread | Bossard calculator for the alloy, or a pull test |
| min_engagement | 2.0 x thread diameter | catalogue | hardware_catalog.json thread_engagement.aluminium (project rule, top of Bossard F.044's range) | RobStride's threads are shallower than this by drawing: see the 'fastener' group | RobStride question 4 |
| machining_clearance | 0.2 mm | standard practice | Twice ISO 2768-m's +-0.1 mm for parts this size: the least running gap that is still a gap once made | Stack of three parts can use it up | Tolerance stack with real drawings |
| seat_fit | per IKO: slight interference, measured  | catalogue | IKO CAT-57166 p8: on Super Slim, 'fit based on the actual measured dimensions' and 'a slight interference fit'. Seats are drawn at nominal diameter | Interference eats internal clearance at 70 to 90 %: machined to the bearing in hand | Bench fit |
| support_shared_by_levers | 2 bearings, lever rule; the motor's own bearing takes none  | standard practice | RobStride publishes no output bearing rating, so nothing is rested on it (reports/actuator_interfaces.md). Real share goes by stiffness: the motor's bearing will take some, which helps the two supports and loads it unrated | HIGH: knee capacities assume the fork shares load between the two supports only, with no flex in 3 mm cheeks | RobStride question 2; FEA of the fork |
| walk_force_line | the ankle motor's rated torque limits the lever  | standard practice | A load repeated every step can only be held by what a motor sustains: RS06 rated 11 N m x 1.32 linkage, so 18 mm at 810 N. Static cases keep the peak | A faster walk or jog passes 810 N (reports/strength.md: to 2,220 N) | Rainflow on recorded takes |
| bearing_load_factor | 1.5 fw | catalogue | IKO CAT-57166 Table 5: 1.2 to 1.5 normal operation, 1.5 to 3 with shock. Walking taken at the boundary | Shock loads would use a higher factor | Rainflow on recorded takes |
| bearing_static_min | 1.5 fs | catalogue | IKO CAT-57166 Table 4: 1.5 or more for normal operation | A fall isn't in the load cases at all | Fall sim |
| service_cycles | 31500000.0 knee cycles | estimate, from memory | 8 h a day x 1 cycle a second x 365 days x 3 years: a hand figure for a service life, no product requirement behind it | A real duty cycle may be half or twice this | A stated product requirement |
| knee_oscillation | 60.0 deg, 2 theta | estimate, from memory | Knee swing in a calm walk (human about 60 deg). Not measured on echo's take | Enters the oscillating-life formula as a straight factor | Read from the walk take |
| garment_former | torso 0.42, thigh 0.70, shank 0.30, gaiter 0.24 of 3.3 kg/m2 wall_fill on role knit | estimate, from memory | Iteration 41: the garment's density held 2.5 kg/m2 of undesigned formers. The shank's closed body now fills that skin to 3 mm, and the thigh needs only ribs off its tube. Knit 0.5 and foam 0.3 kg/m2 are the note in spec/robot.py MATERIALS | Up to 1.0 kg on the robot if formers are heavier than this. Nothing here is weighed | Design the thigh's ribs; a coupon of the knit and foam |
| bearing_retainers | threaded rings M68 x 1, nut M50 x 1  | standard practice | Thin rings, made not bought. Thread forms aren't drawn: the rings and nut are plain bands in the spec. Tightened with a pin spanner, locked with thread adhesive | Race axial load on a fine thread in 7075: not calculated; a circlip needs 2.65 mm of groove and 4 mm more width each side, estimate | FEA of the collar; a trial fit |
| thermal_interface | paste in the bore, gap pad on the skirt  | standard practice | reports/strength.md counts these as contact area. No resistance is modelled, and the bore's 0.05 mm gap is a nominal | Rated torque isn't transferred from the maker's plate | A thermal model or test |
| steel_density | 7850.0 kg/m3 | standard practice | Steel, for screw masses: geometry times density, as no maker's mass table was read | None that matters | Scale |
| shoe_walls | upper and heel 1.5 mm TPU (wall_fill 0.5); midsole 0.45 of its solid; the outsole's top not counted wall_fill | estimate, from memory | Iteration 43: the shell rule gave the shoe a 3 mm wall, the midsole was a solid filling the whole shoe below its rail, frame included, and the outsole counted a top wall the midsole sits on. A molded shoe upper is about 1.5 mm; a midsole is foam under and round the frame, not through it | About 0.25 kg a foot if the shoe is built as the old rule counted it | Weigh a printed shoe |
| ankle_bushings | CuSn8 flanged bushings d10 D12, 5 and 6 long; pins d10 h6 hardened; shoulder screws ISO 7379 d6 12.9  | standard practice | Iteration 43: plain bushings where a catalogue bearing would not fit the 5 to 6 mm plates. Allowable static pressure of bronze about 60 MPa, from memory: at 810 N on two, 6.8 MPa; at 3,400 N with the line off centre, 44 MPa | Wear and play over time, not strength; a polymer bushing of the same size if lubrication is a problem | A wear test on the bench |
| rod_ends | female spherical rod ends, bore 6, eye 15, width 5 to 6, misalignment 15 deg or more  | estimate, from memory | Iteration 43: drawn to the size a catalogue M6 rod end has; static rating about 10 kN, from memory, against 2,649 N at the RS03's peak through the crank | The roll rod's lower end tilts 17 deg across its pin at full roll: a high-misalignment rod end | Pick a part from a catalogue |

## What this cannot assess, and what would settle it

Nothing here waits on hardware: nothing is being bought soon, and the design has to stand up in a pitch and in sim. So each row names the analysis that could settle it now, and says plainly where only a physical test can. Any number in this section is a hand estimate too.

| item | what is open | settles it now | only a test can settle |
|---|---|---|---|
| Fasteners | Real screws at the knee only (tables above); every other joint is still contact area standing in for room. As of 2026-11-05 the hip bracket and front plate touch their flanges only outside the d36 output bolt circle, so neither can bolt there as drawn. The bolt slip load in Interfaces is from memory | Place the remaining patterns with `spec/hardware.py`; VDI 2230 calculation per joint; FEA with preload on the worst few | Thread and preload scatter, if a margin ends up thin |
| Output bearings | Required loads are above; I found no rating. Hip roll is the one to ask about. The knee no longer rests on its motor's bearing by intention, but only stiffness decides what that bearing really takes | Maker data: ask RobStride for the rating or the bearing's part number, then read the bearing maker's catalogue | If the maker gives neither: a moment-to-failure test on one module |
| Motor housings as structure | Several rows pass load face to face through a motor | Maker data for an allowed load. Failing that, route frame past the motor so the question goes away, or FEA of the housing from the STEP with an assumed alloy (an estimate: the casting is unknown) | The housing's true strength, if the design keeps relying on it |
| Battery case | Undefined. No frame between spine and beam, and the pack is not counted as frame: its row has zero section. | Design the case or rails, then FEA; cell limits from the cell maker's data sheet | Abuse and crush behaviour of the pack in a fall |
| Thin-wall hollow sections | Solid is the best case. "SF hollow" keeps the outline at the mass model's fill; walls, pockets and corner radii are not drawn | Draw the walls; FEA with linear buckling | Nothing at this stage |
| Stress concentration | None included: fillets and bores at Kt 1 | Linear static FEA of the top rows; handbook Kt values (Peterson) as a first pass | Nothing at this stage |
| Fatigue | Static yield only. Bolted aluminium in a walking machine fatigues well below these stresses | Cycle counts from the recorded takes (rainflow on sim forces and torques), FEA stresses, published 7075 S-N data | Real scatter and fretting at the joints |
| Impact and falls | 3,400 N is one 20 ms sample from a stiff sim. No fall was run | Run falls in sim with whole-body collision and read the forces; sweep contact stiffness to see how far the peak moves; explicit dynamic FEA on the worst | What foot, floor and covers really absorb: the sim's contact has no measured basis without a drop test |
| Bent poses and hard stops | Zero pose only, each joint limited by its peak. Only the foot plate row allows for a stop | Rerun these sections on joint wrenches recorded from the sim takes (MuJoCo reports them per body), with stops modelled | Nothing at this stage |
| Stiffness | The 3 mm cheeks, the 4 mm stator plate and the thigh frame's thin side look soft; none of that is here | FEA for compliance, fed into the sim model as joint compliance | Measured stiffness, only if the sim proves sensitive to it |
| Thermal | Not in this table: a hot motor derates its peak, and every motor case here assumes the full peak. Audit item 4 stands | Thermal model from the maker's plate ratings and the real conduction paths; maker data for winding limits | Heat through the garment |
| Hand, covers, knit | The hand is a placeholder, not assessed past its bracket. Shell and knit carry no load by rule. The knee and elbow hubs are 7075 but role shell, so they are not counted | Design the hand; decide whether the hubs are structure and re-role them | How a textile wears, if the claim depends on it |

## Notes on method

- Yield: 7075-T6 503 MPa (typical plate); PA12 48 MPa as a strength.
- Sections are slices of the real solids through a plane tied to a part, so they follow the part. A plane that misses is zero area and fails.
- Stress: axial plus biaxial bending at every outline point, Saint-Venant torsion, shear 1.5 V / A, von Mises of the worst of each, whether or not they coincide.
- Pieces in one plane act together unless the row says otherwise (they are assumed tied at both ends: a generous assumption for 3 mm plates).
- The load line in 3,400 N and 810 N is taken at all four corners of what the ankle allows, worst result kept. Above the waist and in the limbs, inertia in the worst direction, each joint limited by its peak torque.
