meetsitaram/echo/reports/compare/compare.md

# Figure 03 vs replica: measurements

Figure 03: published specs (figure.ai) and landmarks measured on reveal-video frames (spec/targets.json). Replica: its own geometry (spec/robot.json).

| measure | Figure 03 | tolerance | replica | difference | |
|---|---|---|---|---|---|
| height (m) | 1.727 | 0.010 | 1.727 | -0.000 | ok |
| chin_z | 1.522 | 0.020 | 1.522 | +0.000 | ok |
| shoulder_top_z | 1.445 | 0.025 | 1.447 | +0.002 | ok |
| elbow_z | 1.156 | 0.025 | 1.155 | -0.001 | ok |
| wrist_z | 0.955 | 0.030 | 0.955 | +0.000 | ok |
| fingertip_z | 0.710 | 0.030 | 0.716 | +0.006 | ok |
| knee_z | 0.540 | 0.030 | 0.535 | -0.005 | ok |
| pelvis_band_top_z | 1.085 | 0.020 | 1.085 | +0.000 | ok |
| hips_black_bottom_z | 0.860 | 0.030 | 0.853 | -0.007 | ok |
| head_height_m | 0.205 | 0.015 | 0.205 | -0.000 | ok |
| head_depth_m | 0.183 | 0.015 | 0.190 | +0.007 | ok |
| head_width_m | 0.138 | 0.012 | 0.140 | +0.002 | ok |
| chest_depth_m | 0.235 | 0.025 | 0.231 | -0.004 | ok |
| bideltoid_width_m | 0.510 | 0.040 | 0.525 | +0.015 | ok |
| foot_length_m | 0.280 | 0.020 | 0.289 | +0.009 | ok |
| mass (kg, bottom-up) | 61.0 | -10 % / +1.5 | 58.0 | -3.0 | ok |
