meetsitaram/echo/reports/compare/replica_34.png

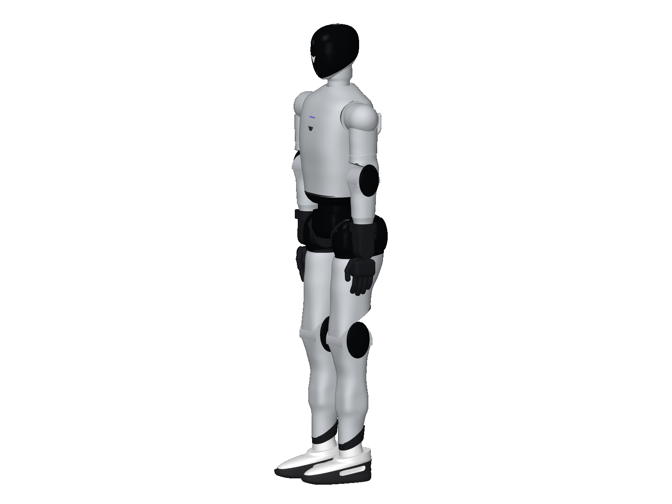
reports/compare/replica_34.png
