meetsitaram/echo/reports/compare/replica_side.png

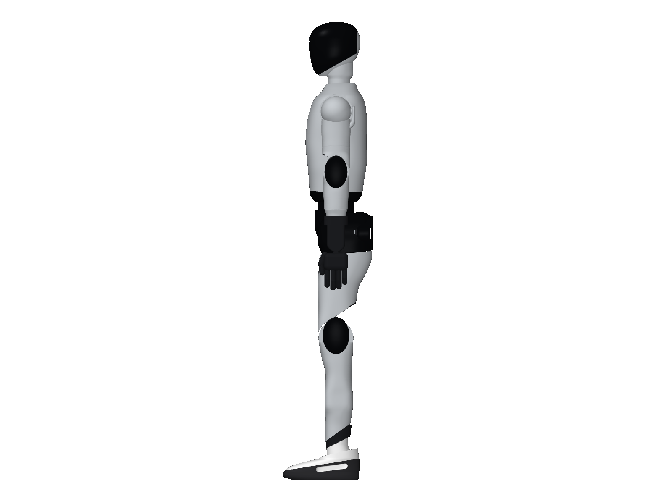
reports/compare/replica_side.png
