meetsitaram/echo/reports/hero_34.png

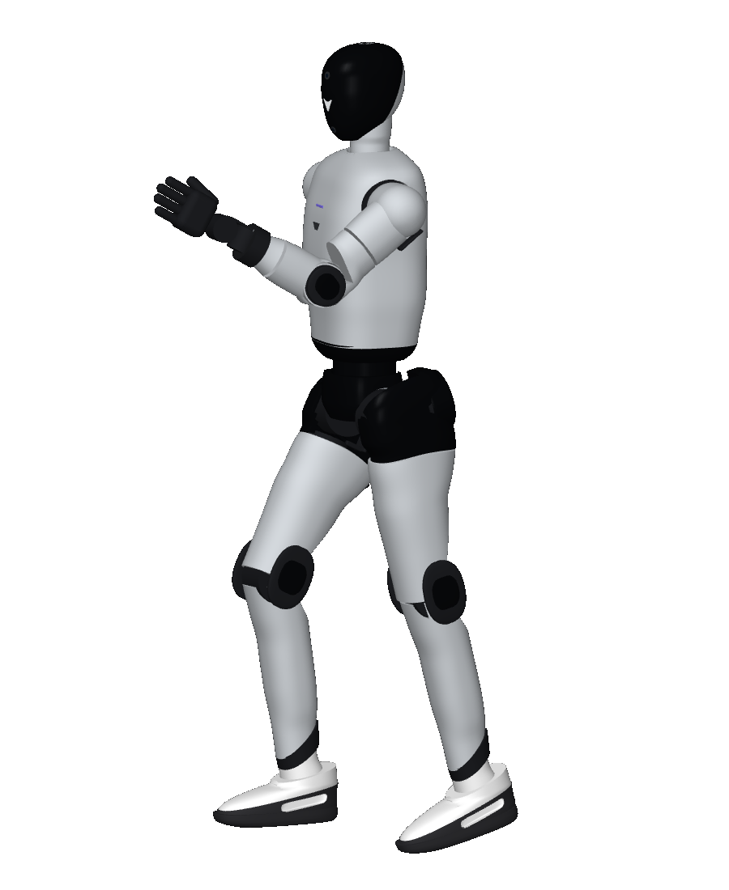
reports/hero_34.png
