meetsitaram/echo/reports/preview.png

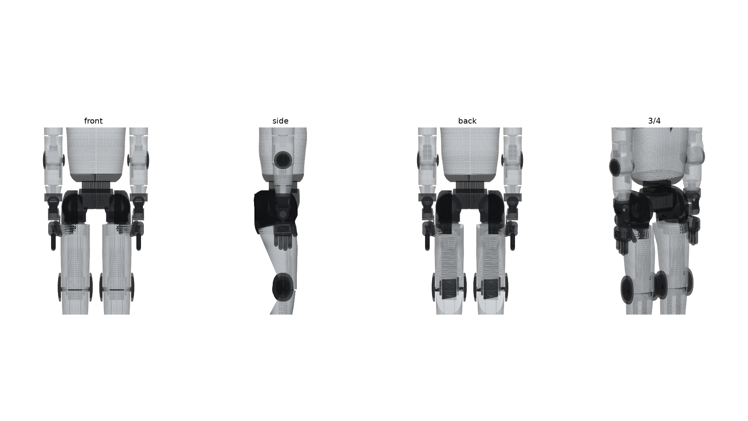
reports/preview.png
