meetsitaram/echo/reports/scene/living_room_reach_34.png

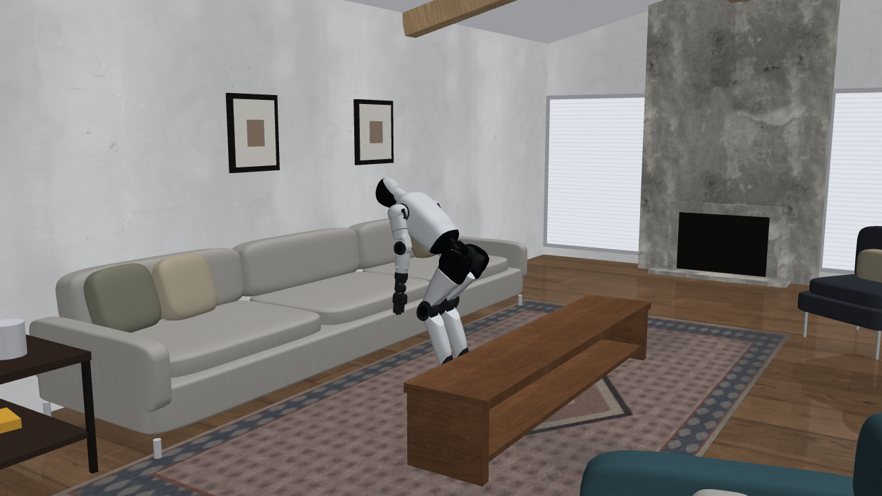
reports/scene/living_room_reach_34.png
