meetsitaram/echo/reports/scene/living_room_reach_clip.png

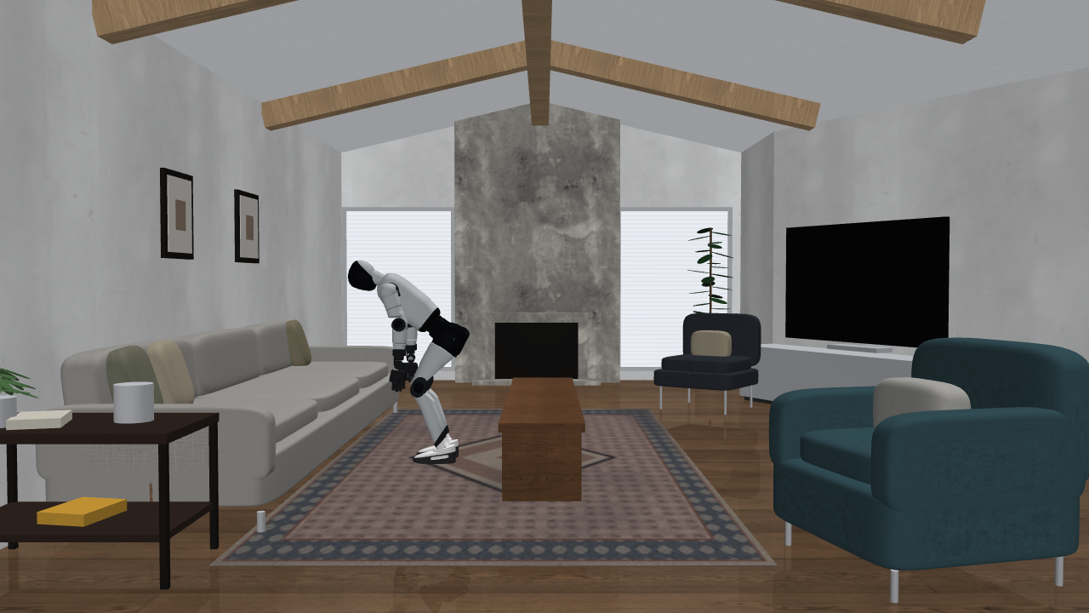
reports/scene/living_room_reach_clip.png
