meetsitaram/echo/reports/skeleton_sheet.png

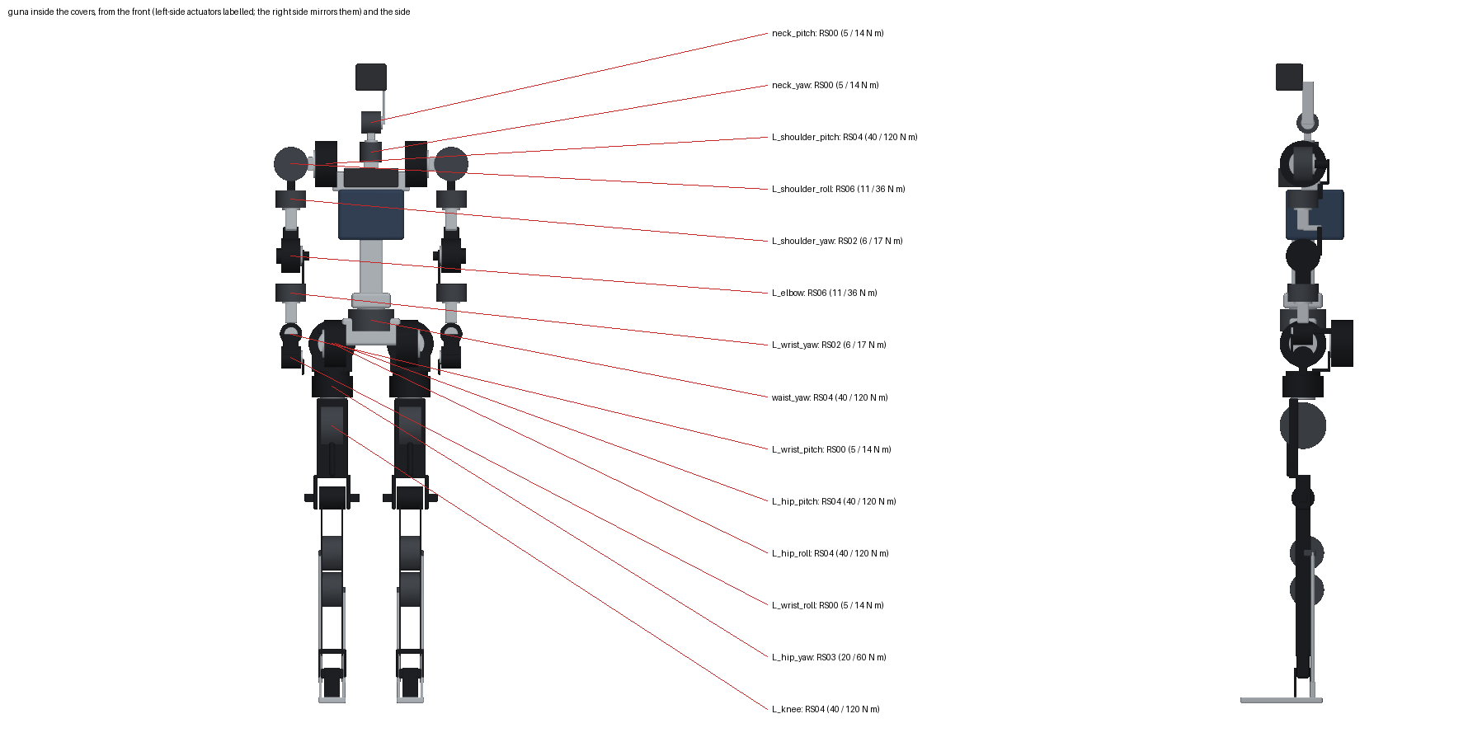
reports/skeleton_sheet.png
