meetsitaram/echo/reports/parts/body_metal.png

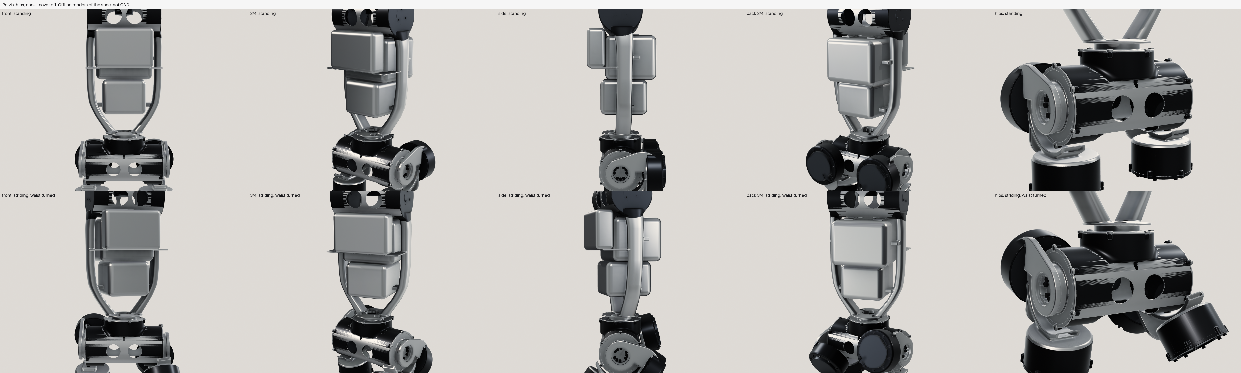
reports/parts/body_metal.png
