meetsitaram/echo/reports/parts/head_metal.png

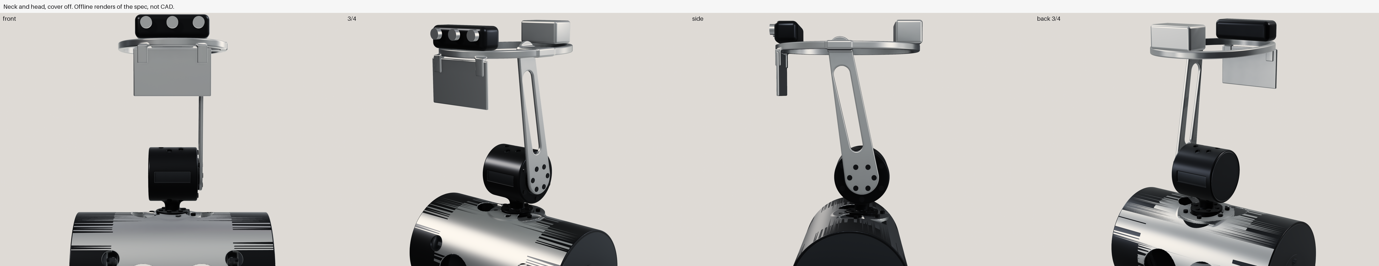
reports/parts/head_metal.png
