meetsitaram/echo/reports/parts/knee_faces.png

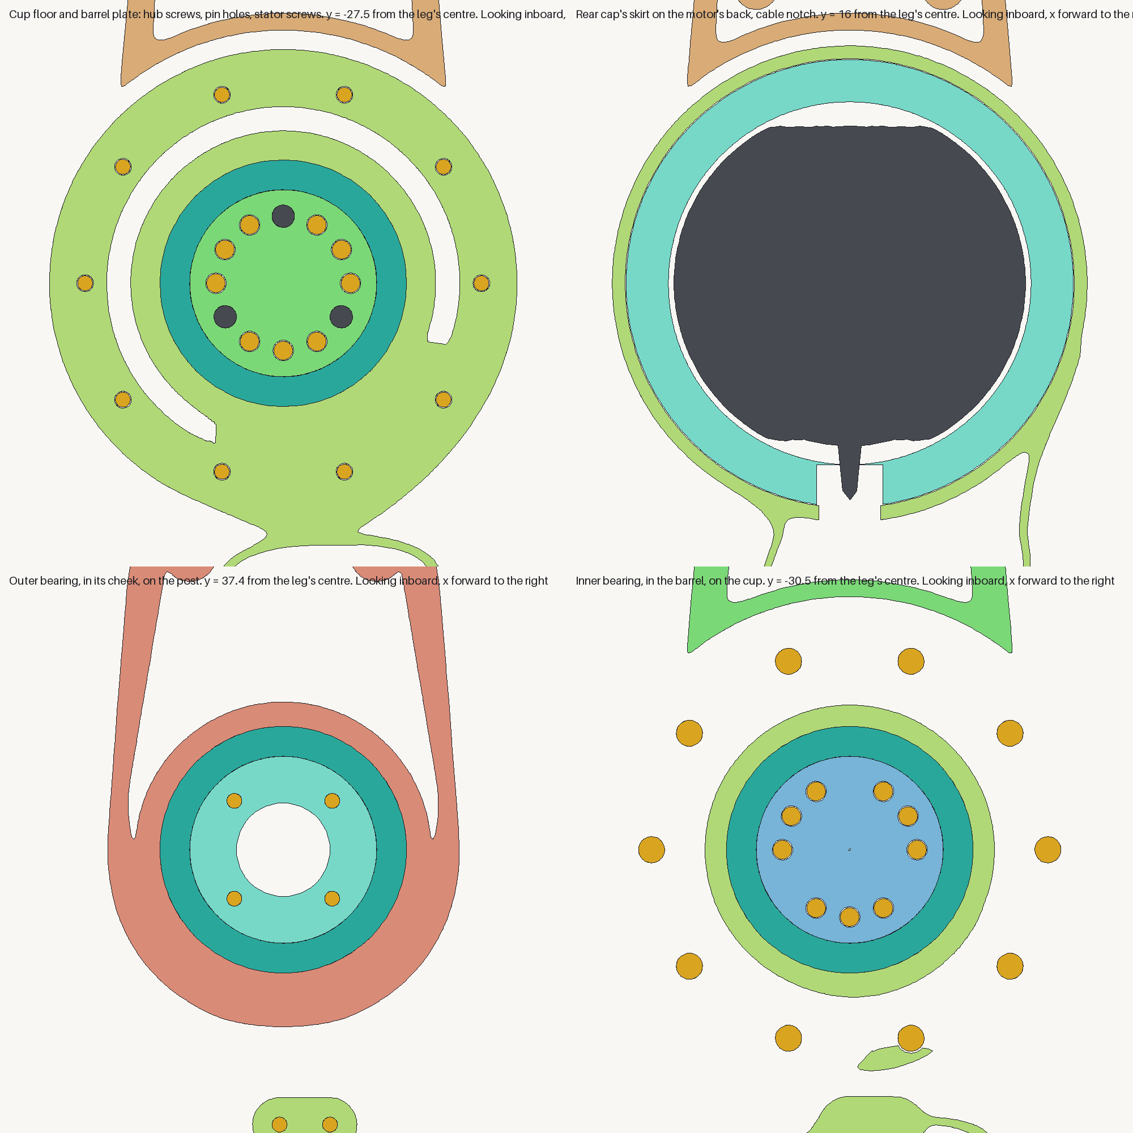
reports/parts/knee_faces.png
