meetsitaram/echo/reports/parts/knee_metal_0.00.png

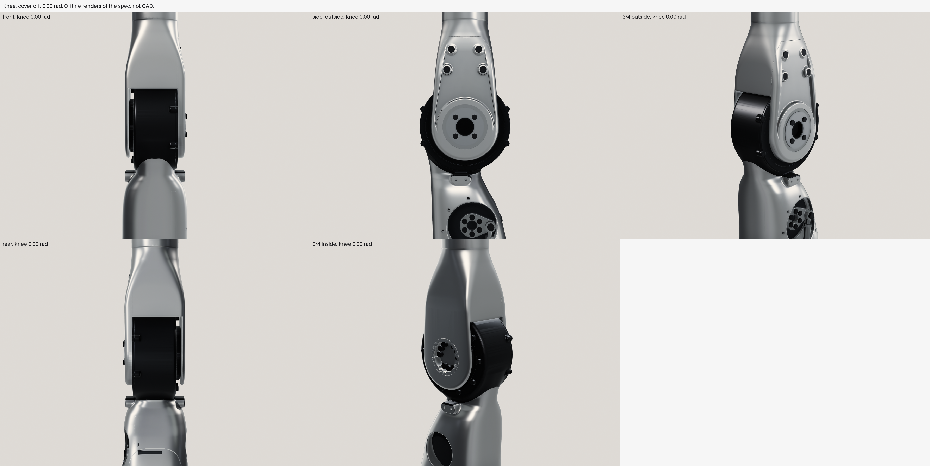
reports/parts/knee_metal_0.00.png
