meetsitaram/echo/reports/parts/knee_metal_0.60.png

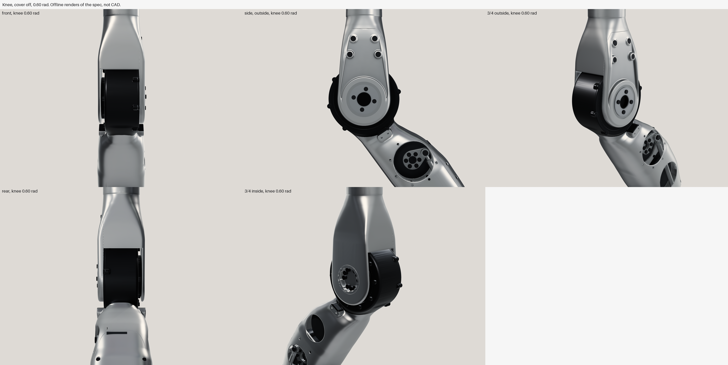
reports/parts/knee_metal_0.60.png
