meetsitaram/echo/reports/parts/knee_metal_2.15.png

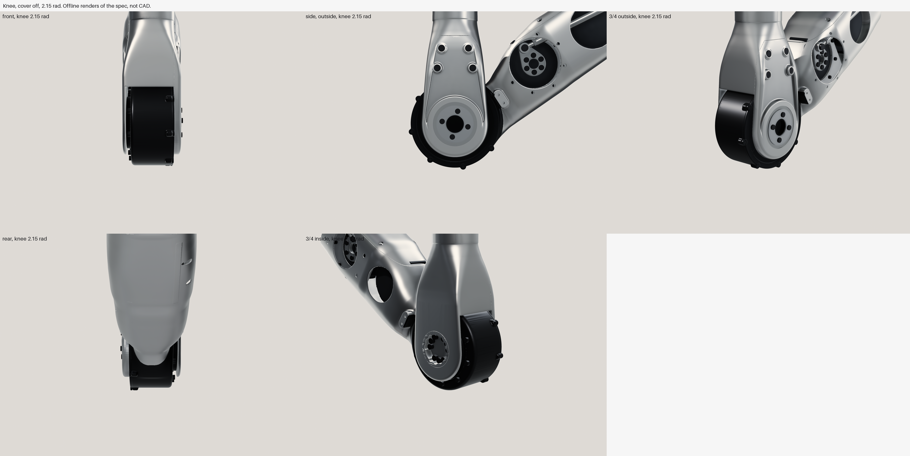
reports/parts/knee_metal_2.15.png
