meetsitaram/echo/reports/parts/knee_metal_section.png

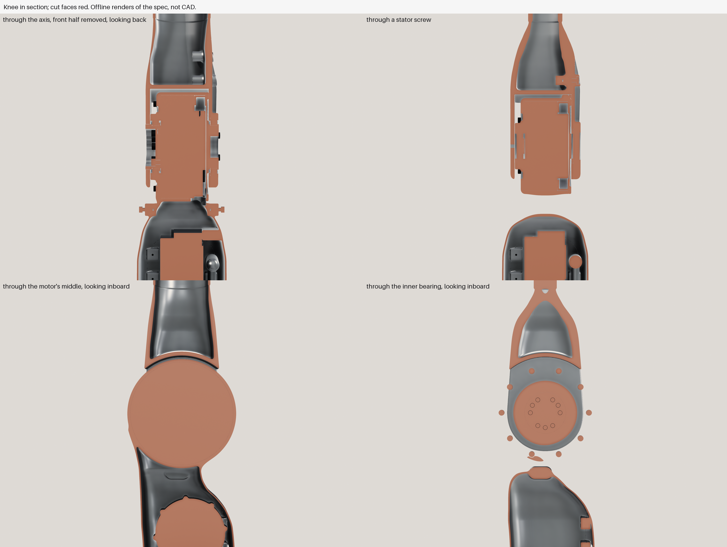
reports/parts/knee_metal_section.png
