meetsitaram/echo/reports/parts/knee_section.png

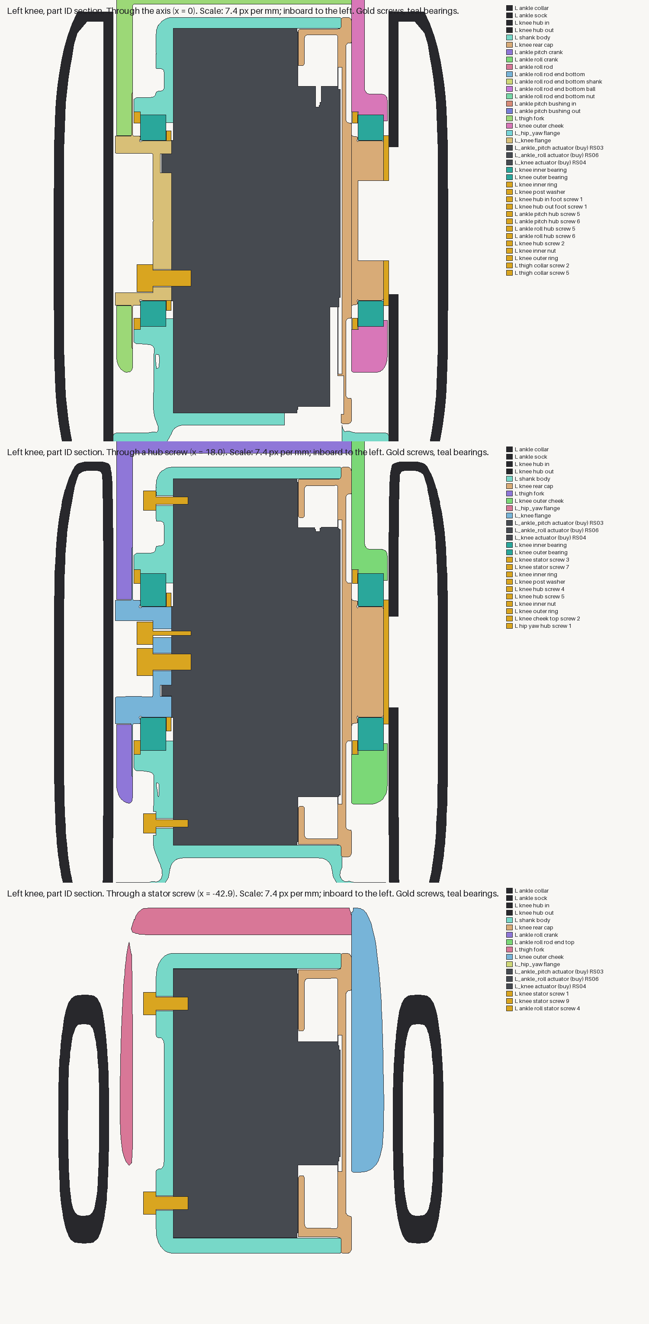
reports/parts/knee_section.png
