meetsitaram/echo/reports/parts/leg_metal.png

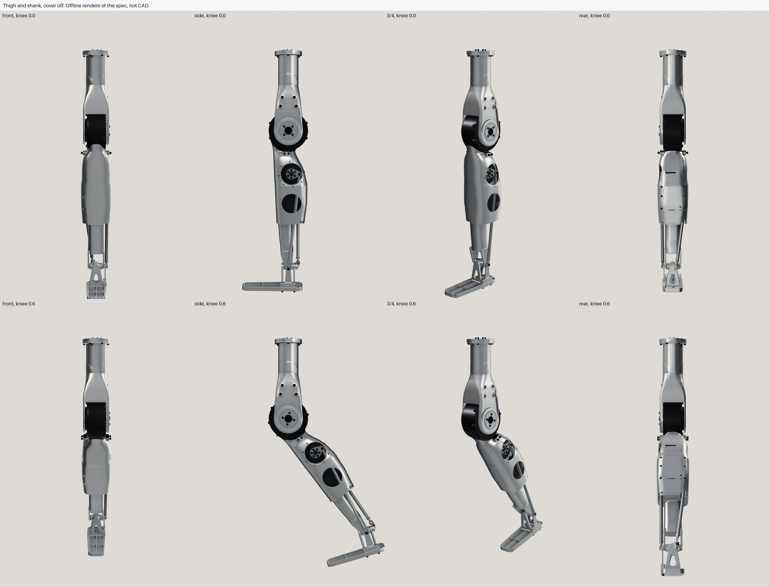
reports/parts/leg_metal.png
