meetsitaram/echo/reports/parts/parts_sheet.png

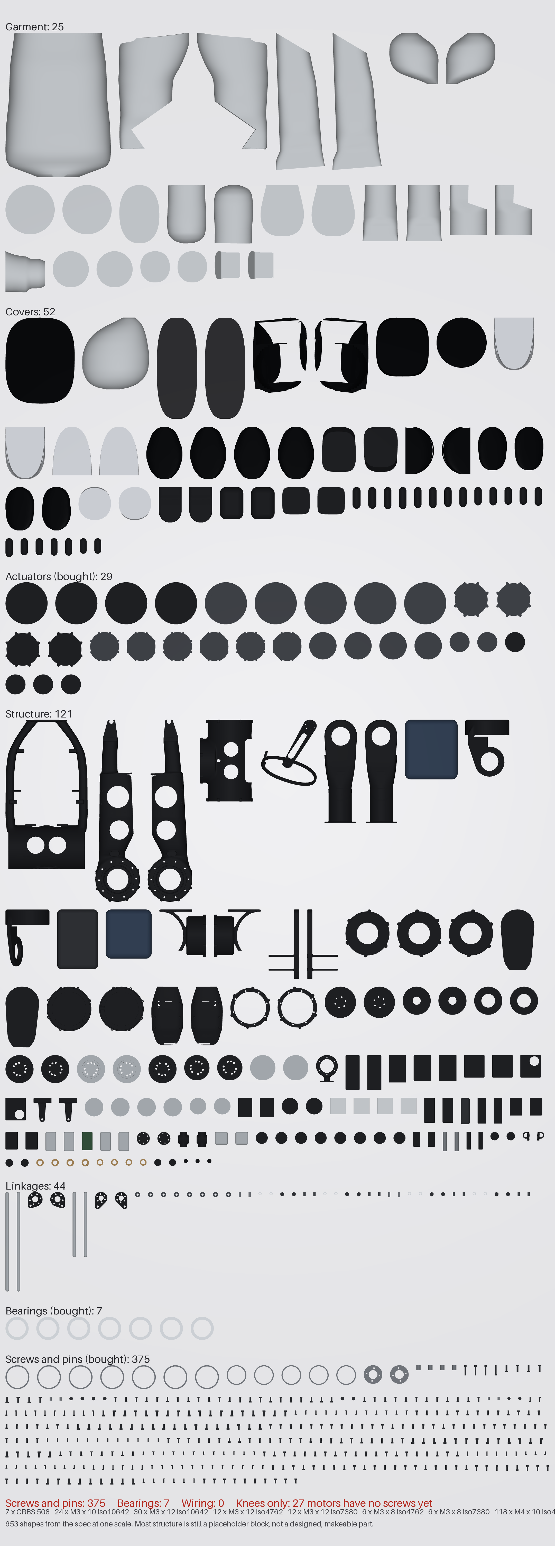
reports/parts/parts_sheet.png
