meetsitaram/echo/reports/parts/skeleton_shiny.png

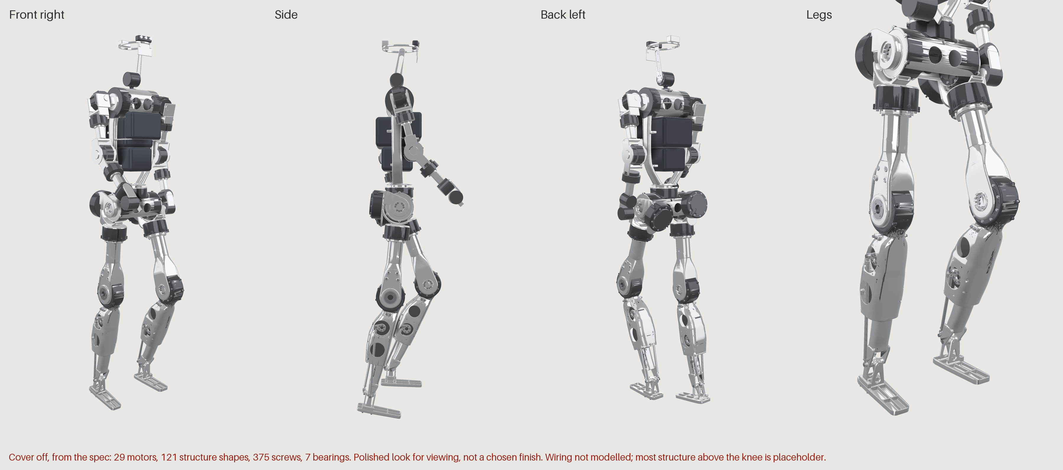
reports/parts/skeleton_shiny.png
