meetsitaram/echo/cad/echo.step

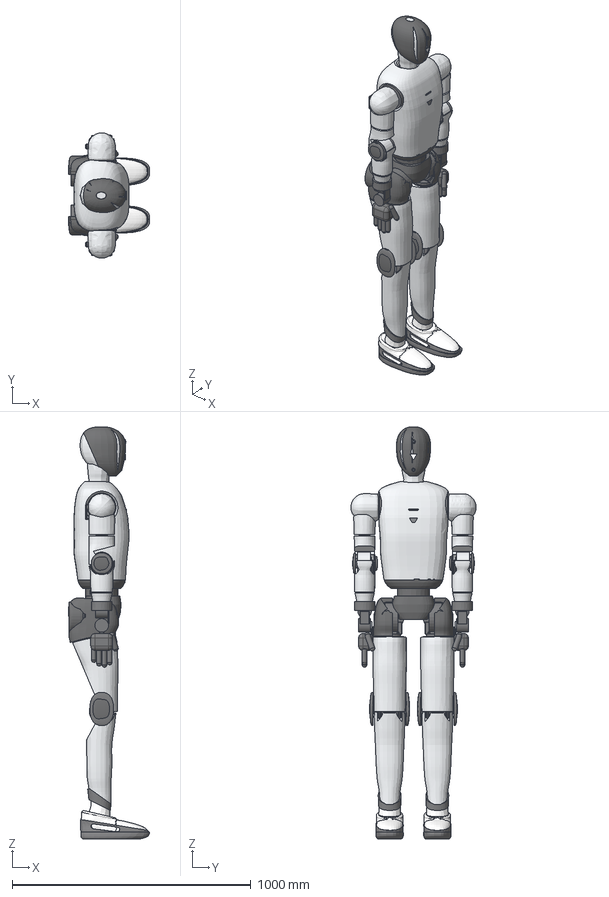
[picture p23: CAD file, 2026-11-01]
cad/echo.step
341.5 x 525.0 x 1726.5 mm
