meetsitaram/echo/urdf/meshes/L_hip_roll_link.stl

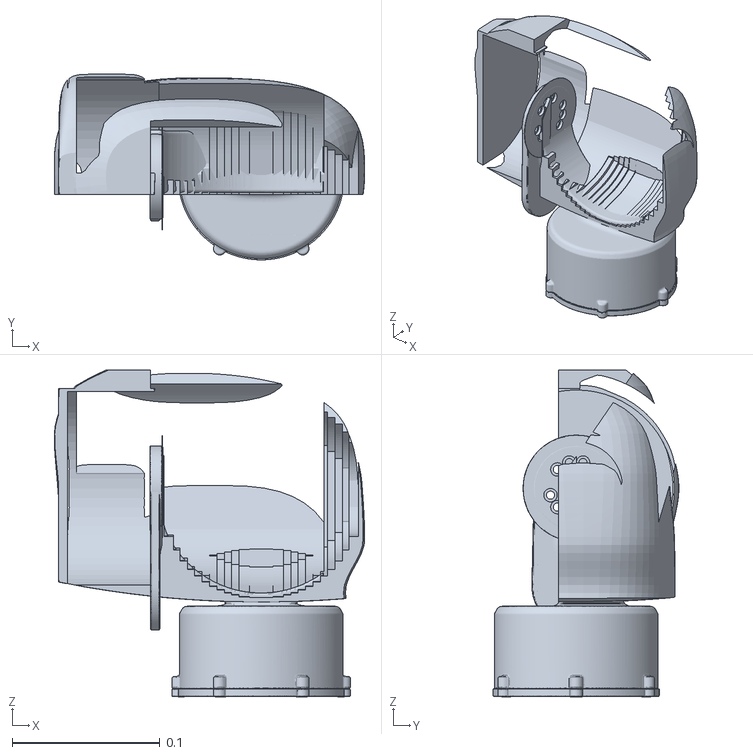
[picture p24: CAD file, 2026-11-05]
urdf/meshes/L_hip_roll_link.stl
0.21 x 0.126 x 0.221
