meetsitaram/echo/urdf/meshes/L_foot.stl

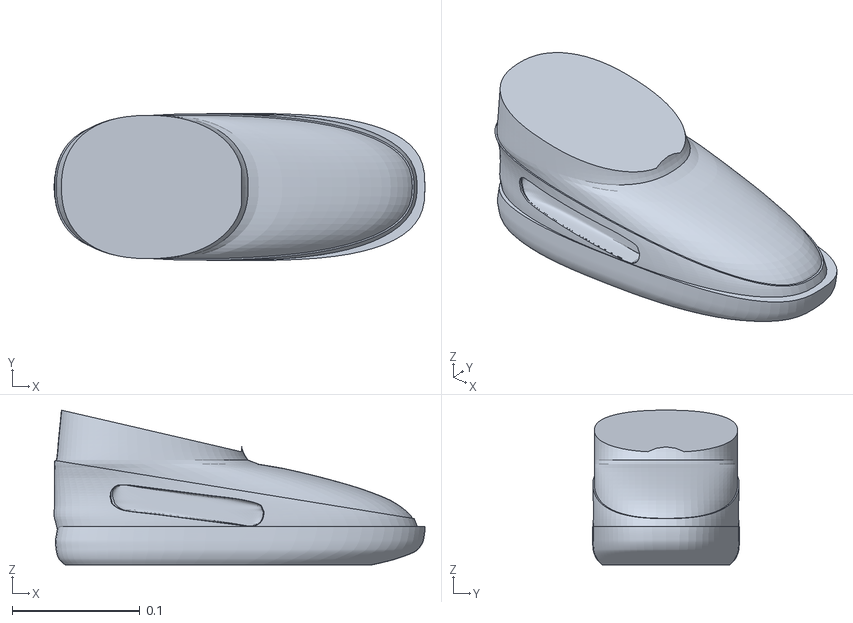
[picture p25: CAD file, 2026-11-05]
urdf/meshes/L_foot.stl
0.29 x 0.115 x 0.121
