meetsitaram/echo/urdf/meshes/L_knee_link.stl

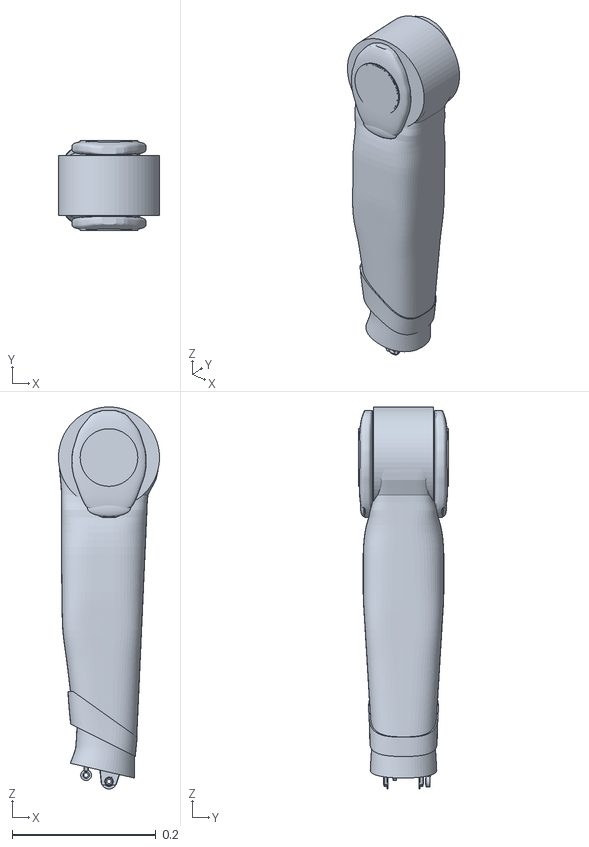
[picture p26: CAD file, 2026-11-05]
urdf/meshes/L_knee_link.stl
0.14 x 0.126 x 0.531
