meetsitaram/echo/urdf/meshes/R_ankle_pitch_link.stl

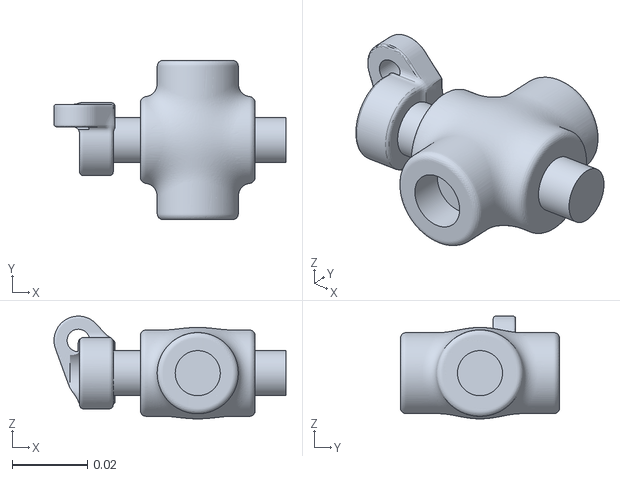
[picture p27: CAD file, 2026-11-05]
urdf/meshes/R_ankle_pitch_link.stl
0.0618 x 0.0424 x 0.0274
