meetsitaram/echo/urdf/meshes/pelvis.stl

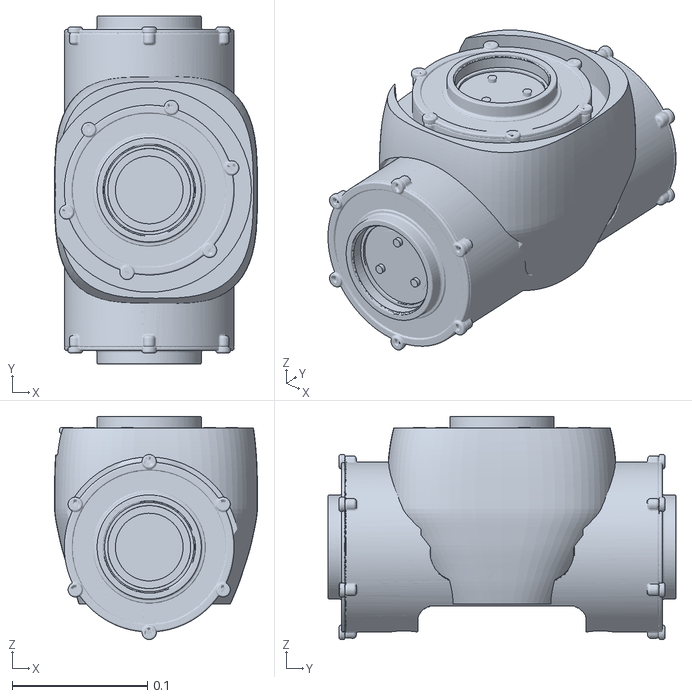
[picture p28: CAD file, 2026-11-05]
urdf/meshes/pelvis.stl
0.15 x 0.257 x 0.165
