meetsitaram/echo/urdf/meshes/head.stl

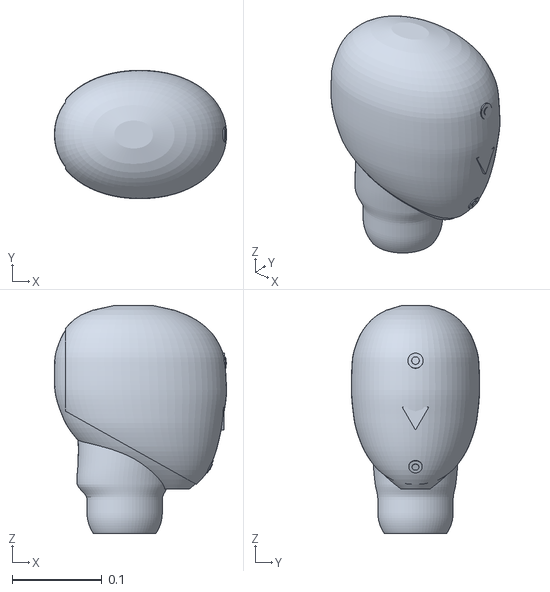
[picture p29: CAD file, 2026-11-05]
urdf/meshes/head.stl
0.192 x 0.143 x 0.254
