meetsitaram/echo/urdf/meshes/L_ankle_pitch_link.stl

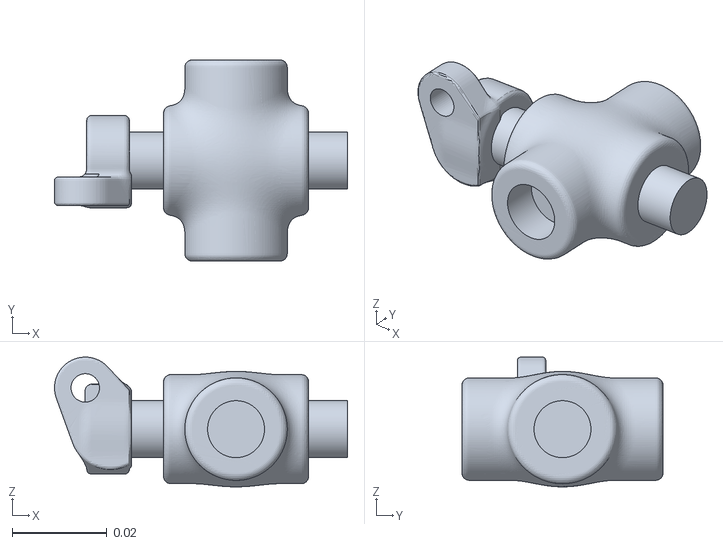
[picture p30: CAD file, 2026-11-05]
urdf/meshes/L_ankle_pitch_link.stl
0.0618 x 0.0424 x 0.0274
