meetsitaram/echo/urdf/meshes/neck_yaw_link.stl

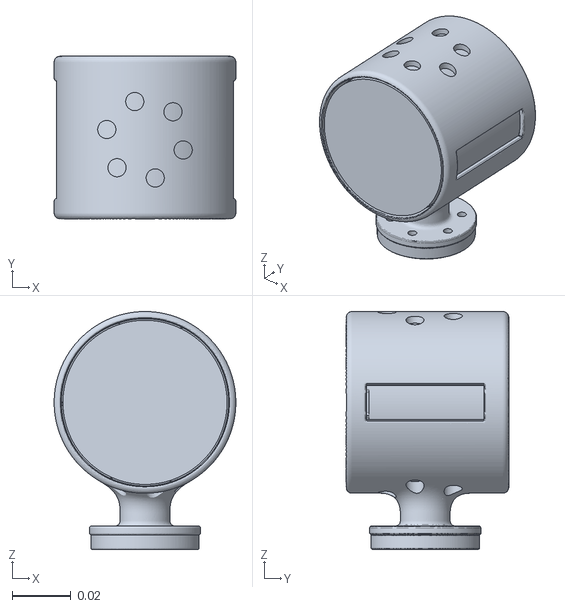
[picture p31: CAD file, 2026-11-05]
urdf/meshes/neck_yaw_link.stl
0.062 x 0.0555 x 0.0812
