meetsitaram/echo/urdf/meshes/L_hip_pitch_link.stl

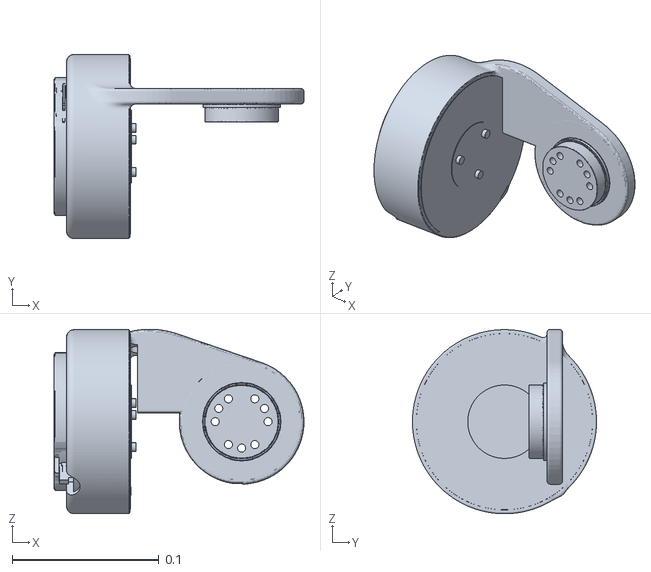
[picture p32: CAD file, 2026-11-05]
urdf/meshes/L_hip_pitch_link.stl
0.17 x 0.125 x 0.126
