meetsitaram/echo/urdf/meshes/L_elbow_link.stl

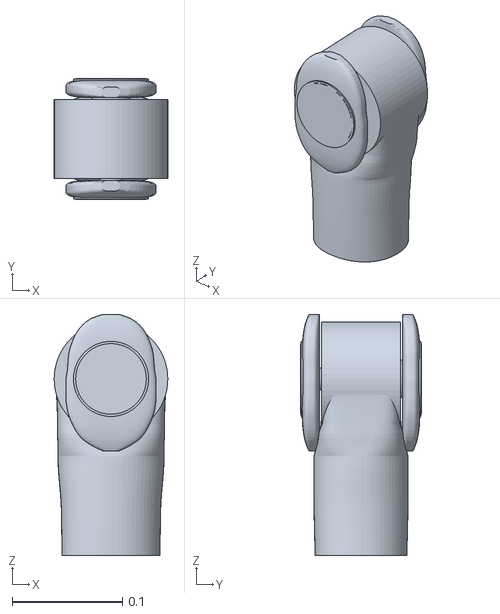
[picture p33: CAD file, 2026-11-05]
urdf/meshes/L_elbow_link.stl
0.103 x 0.11 x 0.218
