meetsitaram/echo/urdf/meshes/R_shoulder_yaw_link.stl

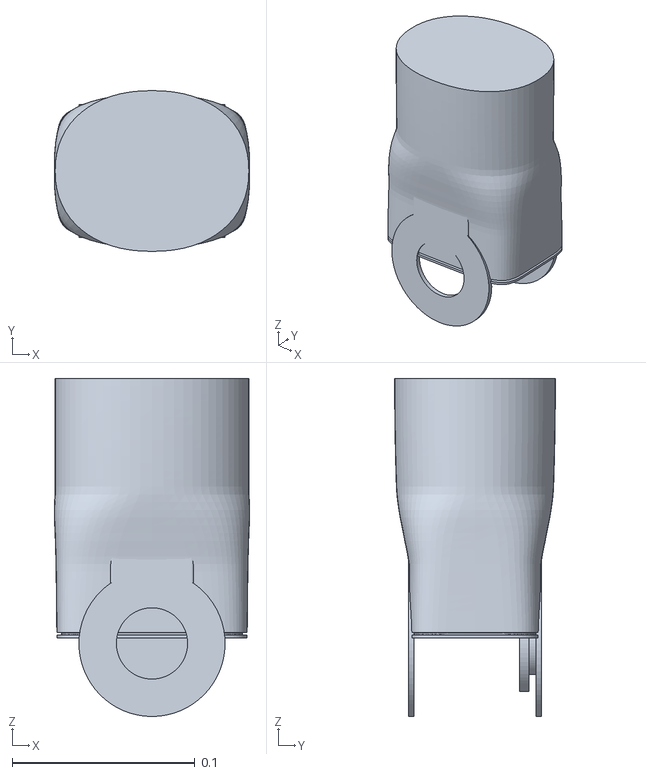
[picture p34: CAD file, 2026-11-05]
urdf/meshes/R_shoulder_yaw_link.stl
0.107 x 0.088 x 0.185
