meetsitaram/echo/urdf/meshes/L_hip_yaw_link.stl

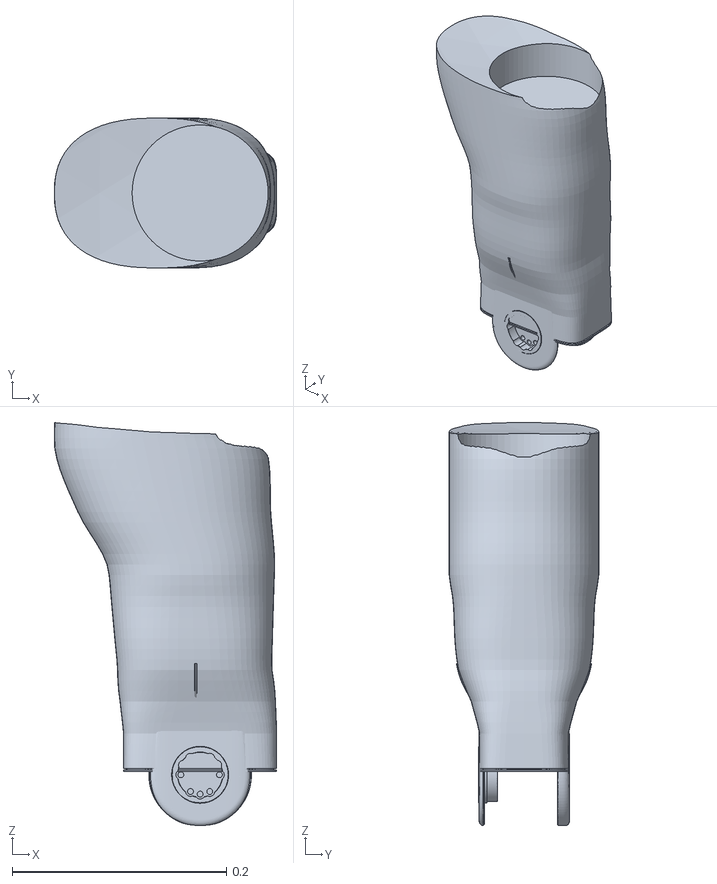
[picture p35: CAD file, 2026-11-05]
urdf/meshes/L_hip_yaw_link.stl
0.208 x 0.14 x 0.376
