meetsitaram/echo/urdf/meshes/torso.stl

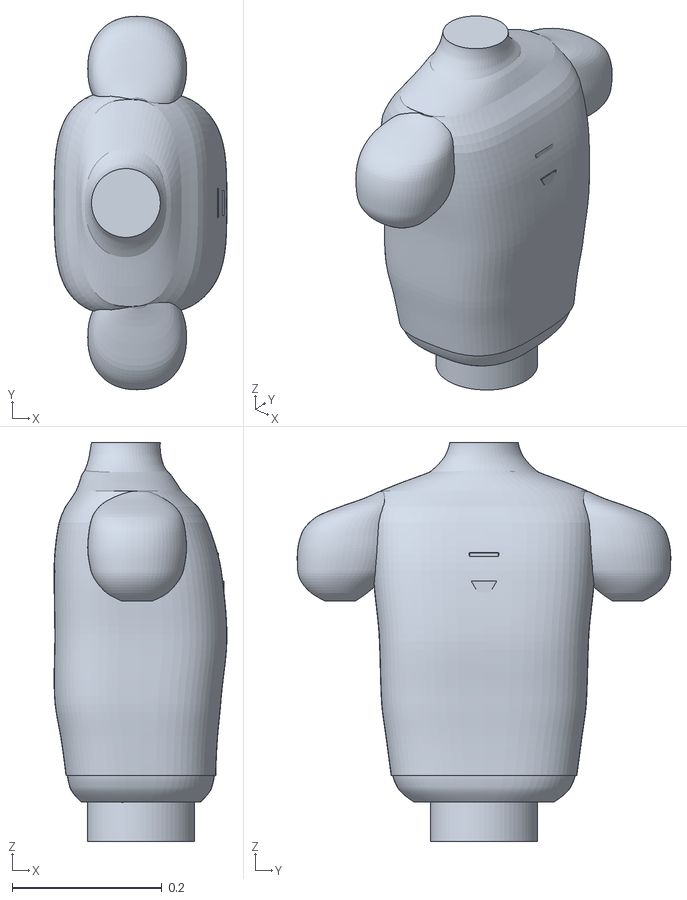
[picture p36: CAD file, 2026-11-05]
urdf/meshes/torso.stl
0.231 x 0.499 x 0.533
