meetsitaram/echo/urdf/meshes/L_shoulder_roll_link.stl

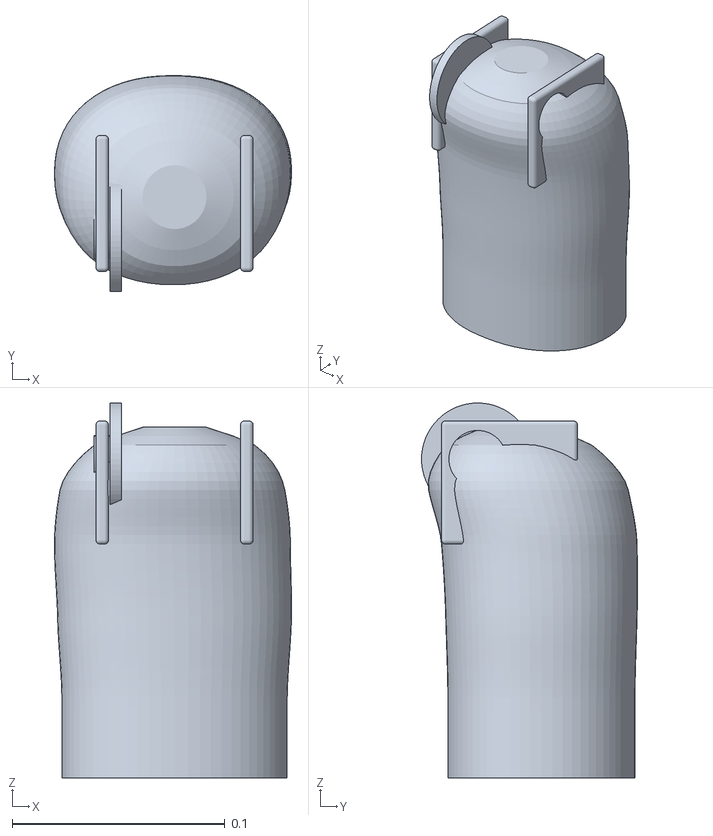
[picture p37: CAD file, 2026-11-05]
urdf/meshes/L_shoulder_roll_link.stl
0.112 x 0.102 x 0.176
