meetsitaram/echo/urdf/meshes/L_wrist_pitch_link.stl

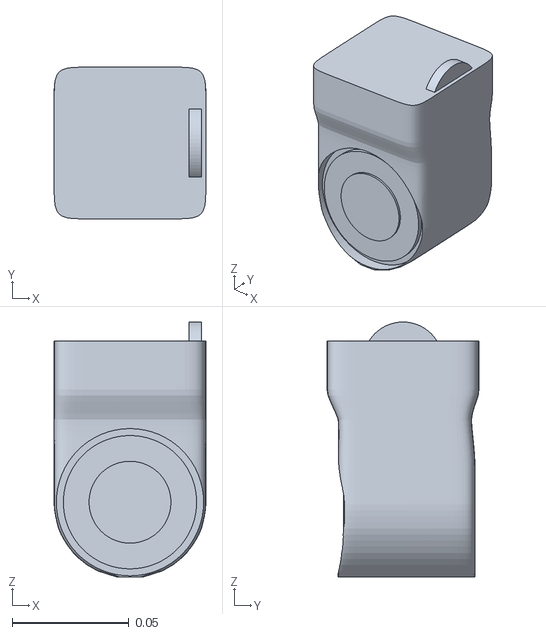
[picture p38: CAD file, 2026-11-05]
urdf/meshes/L_wrist_pitch_link.stl
0.065 x 0.065 x 0.109
