meetsitaram/echo/urdf/meshes/L_shoulder_pitch_link.stl

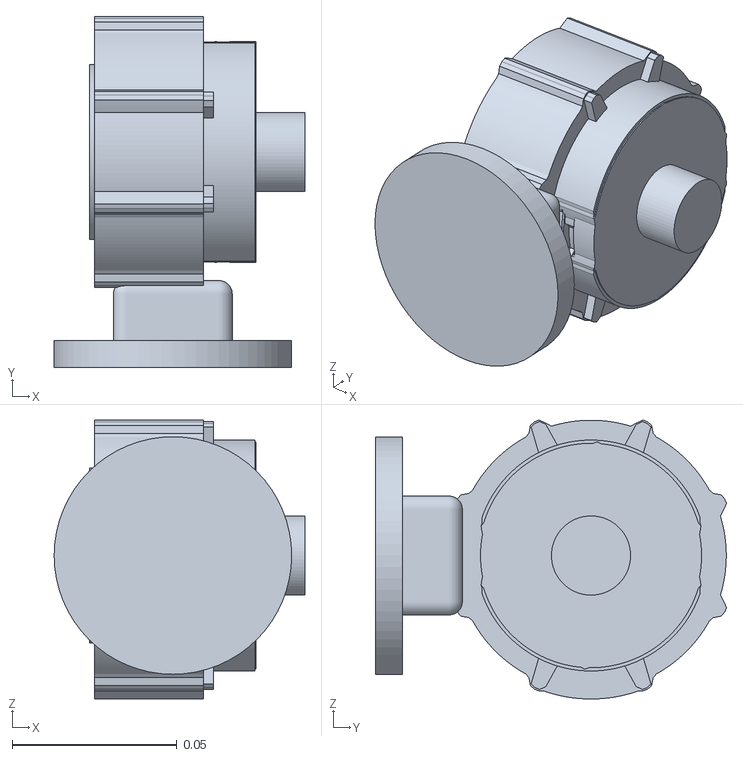
[picture p39: CAD file, 2026-11-05]
urdf/meshes/L_shoulder_pitch_link.stl
0.076 x 0.106 x 0.0846
