meetsitaram/echo/urdf/meshes/L_hand.stl

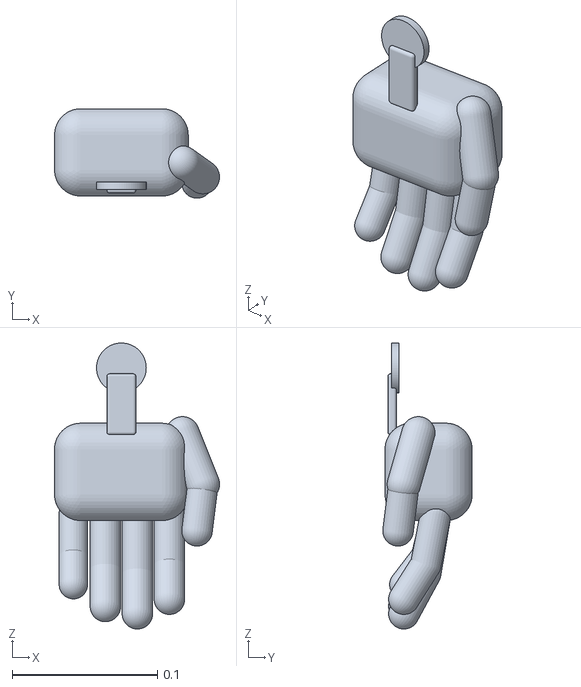
[picture p40: CAD file, 2026-11-05]
urdf/meshes/L_hand.stl
0.113 x 0.0615 x 0.197
