meetsitaram/echo/urdf/meshes/L_wrist_yaw_link.stl

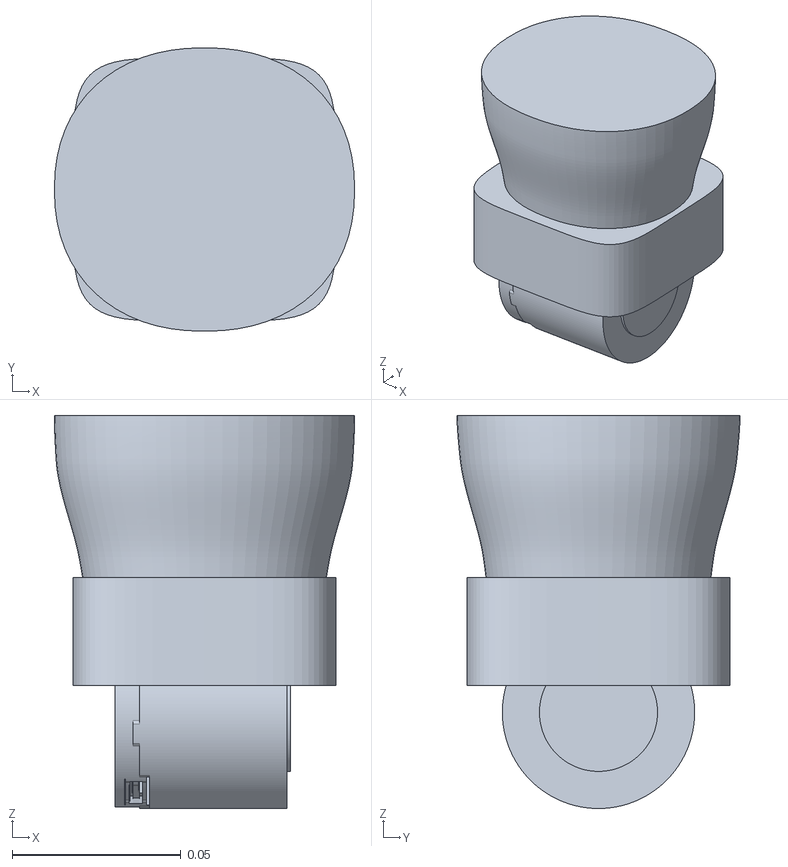
[picture p41: CAD file, 2026-11-05]
urdf/meshes/L_wrist_yaw_link.stl
0.089 x 0.084 x 0.116
