meetsitaram/echo/(list of files, cad)

Other CAD files:
cad/guna.step
urdf/meshes/R_knee_link.stl
urdf/meshes/R_foot.stl
urdf/meshes/R_hip_roll_link.stl
urdf/meshes/R_elbow_link.stl
urdf/meshes/R_hip_pitch_link.stl
urdf/meshes/L_shoulder_yaw_link.stl
urdf/meshes/R_hip_yaw_link.stl
urdf/meshes/R_wrist_pitch_link.stl
urdf/meshes/R_hand.stl
urdf/meshes/R_shoulder_pitch_link.stl
urdf/meshes/R_wrist_yaw_link.stl
urdf/meshes/R_shoulder_roll_link.stl
cad/echo.f3d
