meetsitaram/echo/LESSONS.md

# Lessons learned: echo (a Figure 03 replica)

Builds on CDX-3R's `cad/fusion/LESSONS.md` and `docs/PIPELINE-PLAYBOOK.md` (C:\Users\PC\projects\cdx-3r): read those
first. Below: what went wrong in this project, and the rule or test that now prevents it. If you are building your
own humanoid this way, start with `.claude/skills/humanoid-from-spec/SKILL.md` (the method) and keep this file open beside it
(the traps).

## Process

| Issue | Do instead |
|---|---|
| Packaging a 61 kg humanoid by hand in Fusion would have meant many slow rebuilds | Lay out and check offline first (`tools/checks.py`, ~90 s for 296 checks), build in Fusion once the spec passes (CDX-3R lesson 75, applied to a whole robot) |
| A check passed a design it should have failed: deleting the hip bracket was not caught, because the cosmetic hip lobe "connected" the parts | Run every new check on a deliberately broken design first (`checks.py --bad <case>`). Covers carry no load: connectivity is checked on rigid parts alone, and covers separately must be mounted |
| The skin check let a 5 mm actuator corner through the calf (0.3 % of its volume) because the limit was 5 %; it showed as dark marks in Fusion | Limit 0.5 %; look at the Fusion render after every build (numbers hide ugly geometry) |
| The first proportions came from a low-resolution frame: head 4 cm too tall, arm 4-8 cm too low | Measure on the largest frames available (enlarge the video in the page, pause on exact times), same method on both pictures, and draw the targets as lines across both (`tools/compare.py`) |
| An automatic black-part detector on the photos and renders merged elbow, hand and pelvis into one blob | Measure the replica from its own geometry; use detection only for the reference |
| Every proportion change meant editing dozens of absolute coordinates | Anchor heights at the top of `spec/robot.py` (hip, knee, ankle, shoulder, elbow, wrist, hem, neck, chin); every part placed relative to them. Re-proportioning then passed all checks first time |
| All landmarks were in tolerance, yet the user saw a boxy "butt", a busy arm and a head that read as a bean | Shape is not landmarks: compare silhouettes in close-up crops at the same scale (`compare.py` detail_*), and render shaded without edge lines (every body edge drawn black made the model look like a kit of parts) |
| The head was modelled solid black for three iterations; Figure's is a grey knit hood with a black visor, visible only in a close-up of the side view | Zoom into each region of the reference before modelling it; the lowest-resolution look decides nothing |
| Pieces met with notches (pod above a straight thigh, a neck post under a round head) | Shape neighbours as one silhouette: the thigh's back continues the hip's back line, the neck's top section sits inside the hood so the nape is one curve |
| Our 3/4 render was at 40 degrees, Figure's 3/4 frame at about 60: every width read 10 cm too wide and the legs heavy | Fit the reference camera before comparing: project the model at several angles and pick the one whose silhouette widths match the frame (60 deg, rms 3 cm) |
| "The upper body looks skinnier than the lower": the chest measured right; the side frame showed arms 0.096 deep vs Figure's 0.11 and calves 0.135 vs 0.105, and the torso did not taper to the waist | Measure each section in the view it is seen in (arm depth from the side, width from the front) before changing anything; fix proportions, not only the part pointed at |
| The front frame (shot from above) put Figure's shoulders ~4 cm higher than the side and 3/4 frames do | Take heights from level views only; a raised camera lifts every top surface |
| Feet: a flat plate under a slipper, then a tall block with a flat top ("so off") | Zoom on the reference's feet first: Figure's is a low sneaker (outsole with toe spring, white upper rising from the toe, a stripe to the heel over a white window, angled collar). Model the parts the ankle moves on the shank (sock-shoe), the rest on the foot |
| A toe spring lifts the sole's front off the floor | The contact box (balance check, URDF, MuJoCo) covers only the flat part that stands on the floor |
| Figure's neck looked slimmer than ours by eye (0.07 m deep); the side frame measured 0.117 at its narrowest | Measure the frame (`compare.robot_box` and a row scan of the silhouette) before resizing a part |
| The link masses were hand budgets that summed to 61 kg exactly with the battery as the balance, and each budget was spread over the covers as if they were solid | Masses bottom-up from materials (`tools/mass_model.py`): cover walls, frame fill factors, catalogue actuators, explicit masses for the battery, compute and hands. Report the gap to the target (56.3 vs 61 kg) instead of padding the model to it |
| A per-link rule (frame at least 15 % of the actuators' mass) failed a 2 cm neck post that carries a 0.3 kg actuator easily | A check needs a physical reason: a mass ratio says nothing about strength |
| A `--bad` run of the mass check rewrote `reports/mass.md` with the broken design | Checks write only `reports/checks.md`; each tool writes its own report |
| A measured target read the wrong shape: the black-hip height took the hip lobe before its cuts, and its lowest point anywhere (the domed seam drops at the back) | Measure the replica where the photo was measured (the lobe's underside in its front half, as seen in the front and side frames) and on the finished shape (with its cuts) |
| A redesign done blind: the first hip fix gave the lobe a fin, a slot and a see-through seam, all visible only in pictures | After every geometry change: the checks, then close-up renders from the front, side, back and the angle the user looked from, before and after side by side; then the walk replay |
| The user looked at the hip from below in the web viewer, an angle none of our standard views had | Render the angle the user reports from (a low front view here) and keep it in the before/after set |
| Pictures and numbers in the repo drifted from the design: early renders of an old robot sat in `reports/`, and the README and the viewer quoted last round's mass | Before each commit, re-render every committed picture from the current spec (`render_pose.py`, `preview.py`, the README video) and copy the quoted numbers from the reports (`reports/mass.md`, `reports/checks.md`) |

## Mechanical design

| Issue | Do instead |
|---|---|
| A roll/pitch waist (A3, H2) cannot hide under a one-piece fabric torso: 20 degrees of tilt needs ~5 cm of hem clearance | Yaw-only waist (Asimov 1); keep Figure's look with a black waist column that turns inside the pelvis block |
| A closed black skirt over the hips: the hip roll brackets swing through ~16 cm radius as the thigh flexes | Covers that ride on the moving link (hip lobes first on the hip pitch link, since iteration 21 on the hip roll link: see below); a pelvis block narrow and high enough for 97 degrees of hip flexion (its underside is Figure's arch between the legs) |
| Hip roll bracket ran through the hip pitch actuator | Roll actuator behind the pitch actuator driving backwards; bracket wraps behind and under |
| ...which left a bracket corner behind and below the roll actuator, so the hip cover had to be a box | Drive the roll FORWARD: its output plate runs down the 9 mm gap between the two actuators (it turns in its own plane, so never meets the pitch actuator); the pitch-side bracket goes over the top (the output plate only swings below the axis). Nothing behind the roll actuator, so the cover is a round pod |
| The elbow's output plate showed as a black rectangle on the outside of the arm | Put outputs on the inner face where the outside should read clean (elbow) |
| Knee flexion stopped at 92 degrees: a thigh frame behind the knee met the calf's ankle actuators | Put thigh structure in front, beside the knee pushrod |
| Shoe collar met the ankle fork at 0.67 rad | Low-cut collar below the ankle axis; the black ankle shows above the shoe, as on Figure |
| ...but a rigid shoe cannot rise in front of the ankle: at 0.9 rad of dorsiflexion the shin sweeps down to 8 cm there | Sock-shoe: the shoe's collar line drops from the heel (0.122) to the front of the ankle (0.09); the white upper above it and the angled black collar ride on the shank. Dorsiflexion 0.8 rad (the 90 degree squat uses 0.77). The sock flares toward the heel and sides, where the range leaves room |
| The round shoulder cap and round arms read as a drum on a stick | Arms oval like Figure's (0.11 deep, 0.09 wide); the cap as deep as the arm, starting at full radius inside the torso's side (no waist), the arm flaring up under it |
| Deeper forearms met the upper arm at 135 degrees of elbow flexion | Elbow limit 129 degrees |
| Every actuator's output needs a part of the child link on it | Auto-generated flange on the child's side of each actuator (0.6 x its radius: 0.75 poked out at the shoulder) |
| Static torque in two-foot stance was overstated at the ankle roll (one leg was made to hold the whole upper body's sideways moment) | Closed chain: each leg takes half the upper body as a force at its hip plus half the moment |
| 20 kg in the hands continuously needs 40 N m per elbow (RS03 rated 20) | RS04 elbows first; then (user's choice) RS06 elbows and shoulder rolls, 88 mm, to look like Figure's arms: 10 kg short carry, 3 kg continuous (4 kg needed 109 % of the RS06 rating). The smaller roll flange moved the roll bracket up to stay connected |
| Single-joint sweeps flagged a hanging arm meeting the hip as the waist turns | Collisions between links more than 3 joints apart depend on the pose: warn, do not fail; task poses check combined motion |
| Balancing a pose leaned its ankles past the joint limit (deep squat: 0.86 rad against 0.8) and only a collision gave it away | Poses check every joint against its limits after balancing. The deep squat now leans the torso 21 degrees, as a person does (less knee torque too) |
| Covers cut apart along one plane only touched: the solid union fell into 156 slivers ('covers mounted' failed) | Overlap cut pieces by 2 mm, hidden inside the bigger one; count only pieces over 0.01 cm3 (a mirrored foot left a zero-volume sliver) |
| A thin wall slipped between the sweep's 0.03 rad steps and showed only in a pose | Where covers pass close (the ankle), scan the joint every 0.01 rad per part pair |
| The user circled the elbow bent 30 deg in a walk: a flat wedge on the upper arm over a slab-topped forearm, a mouth between them showing a recessed sleeve, a round puck on the side. It passed every check, and every review had looked at the zero pose | Render a joint at the bends it is used at (20-60 deg here), from the user's angle, before calling it done. Zoom on the reference at a bend: Figure's side frame shows a domed oval on a narrow neck under a hem. Elbow now a hinge: the child's top a drum round about the axis, the parent's end a socket running into one plane tangent to the circle the forearm's front rolls on at full flexion, the stator held from outside by a cheek under the pad |
| A pad with a full-thickness edge at its sides, thinned only at top and bottom, read as a puck from any 3/4 view | Dome in both directions (a loft of ellipses cut on the side plane) so it thins to nothing all round its rim |
| Flat 6 mm seams at the arm's yaw joints showed the background through in level views and read as separate rings; dozens of renders had shown them, and only the elbow's close-ups made them stand out | After fixing a flaw at one joint, look for its family at the others in the same pictures. Curve the seam on a sphere about the yaw axis, 3 mm, with the lower cover's top closed: on a hollow open sleeve a curved seam still passes light, as the rim is level with itself across the cover |
| A dome seam under the hip dropped the black lobe to 0.82 m at the back, a box behind the thigh; Figure's thigh rises toward the back into its black hip. A note saying it matched Figure kept it for several rounds | Read a seam's direction from the side frame before keeping a shape justified by the reference. A bowl (sphere centred above, thigh dished) is just as round about the yaw axis and rises at the back; its limit here is the roll motor's underside. A radius that lifts the seam by its gap across the thigh's width blocks level light: check on green |
| The knee kept pads on posts with daylight behind them and a black drum in a mouth when bent 35 deg, though its hinge row said done; the standing front view had always hidden it | Same rules as the elbow, at the bends the walk uses: a grey drum on the shank round about the axis, the thigh's socket running into a plane tangent to the calf's roll, a clevis fork OUTSIDE the drum with stub axles through round holes, domes on flat sides. A hole cut right through a drum counted the knuckle as uncovered (59 %): cut only the end walls. The notch behind the knee comes from the full flexion: choose the limit knowing that |
| The visor was one plane from crown to jaw, kept for rounds: the head read as a black egg | Read the reference's edges as lines between measured corners: Figure's visor has a lower edge rising 29 deg from the chin and a near-vertical rear edge, and the grey neck flows up under it. Scan neck depth in the side frame too (0.118 m against 0.08) |
| The torso's top held full width to 1.465 m and rounded into the neck: a corner above each shoulder cap | Row-scan the side frame at each height: hold width only to the motors' tops, then one slope to the collar. Heights from a 3/4 frame are unreliable here (it still reads 0.24 m against 0.15 m at 1.46 m, from a raised camera): trust the level side frame |
| Bent, the wrist showed a bare actuator drum, a cheek plate and a hand on a post, with daylight through them; nothing checked for it | One black housing on the middle link over both actuators, its top open and low so it rises inside the cuff, its lower end round about the next axis. Only the pitch moves it against the cuff, so the cuff need not be round. Sweep it: the housing's rim met the stator's frame at 0.86 rad until the frame slimmed to 24 mm |
| Straight capsule fingers read as a paddle | Two capsules a finger, the tip turning toward the palm: cheap and close to Figure's relaxed curl. Limit the curl by the thigh beside it, which the hand hangs 2 mm from |
| The cap read as a drum and a black bracket stood behind the shoulder: the 4 mm gap round the cap framed a black motor, drawn as a dark ring from every side | Look at what shows behind a gap. A grey liner behind it turns the band into a shadow line. Fair a bracket into the arm's back line, keeping it behind the plane the moving cover turns in |
| A lip hung behind the hip seam blocked the last hairline of light on the green test, and read as a black tab from the side and back | Weigh a fix against what it fixes: a 1 px line in one exact view lost to a tab in every view. Removed, and the hairline noted beside the seam |
| The drawn 2:1 knee linkage could not work (a 4-bar over 123 deg averages about 1.05:1), and the frame ran through its motor; only a paper solve showed that. The sim had been testing a robot the spec was not | Solve a linkage in numbers before drawing it. With the motor on the axis, the fork goes outside the drum and the output rides on an idler so the joint is held on both sides. Keep a failing check failing (stair, 134 N m against 120) and name it as open, rather than weakening it |
| The ankle was two motors shared by pitch and roll, in a calf sized round a bounding circle; a plate at each motor's face then blocked the roll rod below it | One motor per joint, each with its own crank and rod, from solved numbers. Draw the motor with its ears turned (RS03 98.5 deep, not 106). Square the section only where the motor's corners need it (n 4), or the calf reads as a block. Trace each rod past each plate: step the plates in below the motor |
| Actuator data rested on retailer lists; the manual and the maker's CAD differ in the rating and in the shape (RS03 98.5 deep, not 106; rated 20, not 21) | Read each number from the maker: manual for ratings with their plate size, STEP for shape. Check a second way when a tool you wrote read it (its CIRCLE radii here). Mark what is one reader's reading of a chart |
| The battery box held 13.1 kg in 3.3 L, denser than cells, and compute 1.6 kg in 0.42 L, so the CoM and the room were both wrong | Size a stated mass by a stated density and draw that volume. Where one box meets a tapering cover, use two boxes before moving the cover |
| No Figure logo (trademark) | Our own mark: inverted triangles on the visor and chest |
| The covers either side of a joint were allowed to overlap (treated as fabric), so 13 joints could not actually move | Sweep every joint min to max with the covers across it too (only the actuator / flange contact exempt); give each joint room where Figure shows black: openings (torso for shoulder caps and neck, pelvis for the waist column), seams at the arm yaw joints, elbow and knee zones the covers stop short of, round about the joint axis wherever something turns in it |
| Folding joints (elbow, knee) with the axis in the middle of a thick limb fold only until the covers meet | Covers end short of the axis, on a slant at the knee (deeper behind); set the limit from the sweep (elbow 109, knee 123 deg) |
| Marking a joint 'exposed' to let its flange show in a seam also exempted its actuator from the skin check: the 'poke' calibration stopped being caught | `exposed='flange'` exposes the flange only; rerun every calibration after touching a check |
| Windows cut right through the shoe showed the ankle clevis plates as bars | Cut a pocket each side ('cut' geoms with targets, applied in Fusion as a combine and offline as a manifold difference); what a cut uncovers counts as showing in the skin check (calibration 'window') |
| Smaller ankle motors no longer touched the shank plates: the motors floated | The connect check caught it; clamp them between the plates |
| Push rods drawn as part of the shank would collide with the foot in the sweep | Role 'linkage': drawn, kept out of the collision checks (they move with the linkage, not with either link) |
| Shoulder roll: the arm's top sat inside the cap (round about the pitch axis), and the roll bracket left the cap through its wall; rolling the arm 160 deg swept both through the cap | Where two axes cross, give the cover a hemisphere about the crossing and cut the next link's cover as a socket round it (4 mm); take the output out ON the axis (a round hole in the cap's back never sweeps) and down behind the cap. A bracket through the cap's side needs a slot round half of it. Range from the sweep: 150 deg (past it the arm's outer top swept the cap's top) |
| Neck pitch at the jaw: the hood's underside crossed the pitch actuator and the neck at every angle, and nodding swung the chin into the neck | Pitch at the neck's base, on the yaw axis: the neck tilts with the head (one piece with the hood, as Figure's knit neck bends), its base a sphere zone about the axes' crossing; compute the torso's opening from the swept neck. The tilt range sets the collar ring: 34 deg needed 1.2-1.9 cm, 26 deg 9 mm |
| Knee covers that stopped short of the axis on slants showed a black block in a gap ("real knees with actuators won't look like this") | A hinge: a drum round about the axis on one link, between fork cheeks of the other; each cover ends in a concave socket 4 mm clear of the drum, a narrow seam on the outside of the fold (6 deg in front of the knee), an open notch on the inside (behind: 123 deg of flexion) |
| A clip plane at the knee axis never cut the thigh: its loft stopped 3 cm above the axis, and the knee showed a 3.7 cm black band in front | A clip only trims: run a part's sections past every plane meant to shape it, then look at the front view |
| Rigid covers at a fold (elbow, 109 deg): the forearm's front face sweeps 7 cm up the upper arm, and any frame above the elbow is in its way | Cups: both covers run on round the actuator, hollow round it, side walls kept. The child ends on a line through the axis; the parent closes the outside of the fold down to 6 deg from where flexion turns that line, and in front is cut to the child's front face at full flexion (4 mm clear). Carry the stator from the sector the child never reaches |
| The thigh hung under the hip lobe on a 12 mm plate and the yaw actuator's rim, 2.5 cm down ("that connection looks so weak for such a big robot"): the lobe rode on the pitch link, so the thigh rolled and yawed against it | Put the cover on the link before the last joint (the hip roll link): only that joint (yaw) moves the next cover against it, and a seam square to its axis never sweeps (3 mm). The cover then moves against the pelvis (roll): hollow it round the swept parts (convex hulls through the range, as prisms) and bevel it where the roll tips it toward the pelvis |
| Reordering the hip joints (yaw first, as Unitree H1) looked like the way to let the thigh cup the hip motor, as the knee does | Check where the new first actuator goes before reordering: yaw first puts a motor above each hip, where the torso's hem turns, and Figure's black hip band (0.86-1.0 m) has no room for one either. Kept pitch, roll, yaw (Asimov 1, G1, H2) and moved the cover to another link instead: same ranges, same kinematics, the recorded walk still valid |
| Widening the rolling lobe to clear the parts that turn inside it made it touch the hanging wrist, and its swept-volume cut broke through its outer surface in places | Move the actuator along its own axis (6 mm inboard: no kinematic change) before widening a cover; cut the swept volume in slices along the axis, each only as tall as the actuator is there (a cylinder is lower away from its centre line); find holes by sampling the uncut outer surface and testing the points against every cut |
| Domed, the thigh's top wall crossed the rim of the yaw actuator inside it (the 'covers' check caught it) | A clearance opening must clear the actuator at every height the curved wall passes: the opening through the domed top runs 1 cm deeper |
| White lines in the side view: the flat 3 mm hip seam lined up with the other hip's and showed the background through both, and the roll motor's 3 mm clearance cut through the lobe's slim back | Any flat seam is see-through seen level: curve it round the joint's axis (the thigh's top inside a sphere, `keep`; the lobe 3 mm outside it), and cap what a clearance cut reaches. Test with a green background: green inside the outline is light through a gap |
| A bevel plane along the whole lobe left a fin, seen from the front | Cut only over the length of what it must clear (the pelvis block); the full back keeps the round outline |
| Single-joint sweeps cannot see combined motions (a hip pitching, rolling and yawing at once) | Replay the recorded walk through the collision test (`tools/motion_collisions.py`, every 5th frame) before and after a change at a joint |
| An oval pad standing off a rounded arm read as a disc on a post (3/4 view) | Set the disc into a flat side (the section squarer there, n 4), the child's side wall wrapping it 3 mm clear |
| Knee pads inside the leg's width needed recesses that narrowed the shank's top | Pads outside both covers, domed, on mounts that turn in a small round hole on the axis |
| A small domed pad's sections were closer together than the wall is thick, so the skin's cavity (each end moved in by the wall) put sections out of order and the interpolation failed ('x must be strictly increasing') | When moving a loft's ends in for the cavity, drop the middle sections the moved ends pass (`geom.inner_of`) |
| A hip lobe's flat cut faces went through the hip motors and no check saw it: the sweep and skin checks take covers as 3 mm walls, open where they are cut | Check 'covers': each cover's skin closed on its flat cut faces (as Fusion draws them) against the motors of its own and the neighbouring links. Where a motor passes a cover's face, a round opening 3 mm clear of it, centred on the motor's axis |

## Buildable, not only fitting

Each row is something a person had to find by eye, on a small hobby-servo build made with these same tools. Passing collision checks said nothing about any of them.

| Issue | Do instead |
|---|---|
| A flat 3 mm printed plate carried the whole robot's weight, bent across its thin side; the collision checks passed it | Estimate the stress through each section on the load path, at a landing's load (3 g), against the material across its print layers. Give each a `--bad` case. It finds weak parts; it does not replace FEA or a test |
| A bracket and a mount were joined to their links only through a bought actuator's case: the "link is one solid" check counted the case as structure | Check connectivity per made part, not per link: each printed or machined part must be one piece with the bought parts left out |
| Slivers under 1 mm beside bores, in plates that looked fine | Check walls on each part (a voxel opening at the smallest wall the process holds). Name what is thin on purpose, and why |
| An actuator drawn as its bounding box hid a step round its output and a lump on its back, so a seat's floor was meaningless on the real part | Model bought parts from sections of the maker's CAD; never design a seat or a mount against a bounding box |
| A plate's corner poked out of a rounded cover: a flag meant for parts that show had excused it from the skin check | Flag only what is meant to show. A part under a cover takes the cover's outline, inset, and stays under the check |
| Fasteners were decorations, with no length or direction, so parts were held by nothing and no hole was ever defined | Put every fastener in the spec: size, length, position, direction. Let them drive the assembly checks, the BOM and the holes in the exported parts |
| The finished robot passed, but a one-piece part had no way on, a tray closed on both sides could not take its actuator, and a bracket's screws sat under the next actuator | Hold the build order as data, with a path for each part. Check: it slides in without cutting what's on; a key reaches each screw at that moment; the thread bites something; the head clamps something |
| A collision limit set for one robot's size hid real collisions on a robot five times smaller | Scale volume limits with the robot (by the cube of its size), and list what a limit hides before trusting it |
| Thin covers exported solid, and reported hundreds of grams too heavy | Export what will really be made: the wall, with its holes. Look at the exported volumes |
| `check_connect` passed a 2.7 x 3.5 mm hip bracket, a 2 x 2 mm spine, a PA12 bracket, a 0.02 mm touch and deleted ankle rods: it proves that shapes touch, nothing more | Named sections cut from the real solids, at factor 2 to yield under named loads (`tools/strength.py`, group `loadpath`). A rigid part on no path fails too, so a new part can't slip past. Plus contact area per interface, a pin at every pivot, linkages traced motor to output, stators held by an end face |
| A new check that fails on today's design "catches" every broken copy of it too, proving nothing | `--bad` compares with the unbroken spec: a row must newly fail or get worse, which needs a number per row. And `--good` makes one fix and shows the row turn to PASS: a check that can never pass is no more use than one that can never fail |
| A section's stress note said 3 mm while the mesh was 5 mm: an rbox fillet over half its thickness crossed its corner spheres, so `mesh_of` and `inside` disagreed. Mass was 0.14 kg high | Clamp the fillet in `geom.py`. Read a part's real size from the solid before quoting a stress beside it |
| A fork's second bearing, drawn as air round a post, reads as sharing the load, but with no bearing the far cheek carries nothing and the motor's cheek takes it all. Knee stator plate SF 6 with the bearing, 0.5 without (hand estimates) | Keep the as-drawn row beside the as-intended one until the part exists, and say which is which |
| The worst foot force in a shoved sim also had a 1,614 N side force, 47 % of the vertical, read only when the frame was opened; the quoted number was the vertical alone | Read the whole recorded vector and the other joints' torques at the peak frame before calling it a load case |
| Lever arms grow by what the joints can hold: an estimate with the force exactly on the axes read the hip bracket at SF 0.85; with the 26 mm the ankle motors allow, 0.56 | Put the force line where the motors let it go, at each corner of that, and keep the worst. Say what the limit assumes: a joint on its stop passes more |
| Motors were cylinders from a bounding size, so each sat with no turn about its axis, and a flange placed from the cylinder's end sat 2 mm off the RS04's real hub, on its pins. Screws can't be placed on a shape with no clock | Read the maker's STEP into an outline (`tools/motor_outlines.py`: rays along the axis, radius per angle per height, erring outward) and give every motor a clock. Keep the cylinder's fields for mass, draw the outline. Real shape, first pass: the new `motorfit` group shows 13 of 16 left and centre motors built into their own frames, up to 227 cm3 (waist, in the pelvis frame): check_static never looks inside a link, so nothing had asked |
| A real knee stack showed what shapes hid: the d40 axle ran through the d36 hub screw circle, so nothing could reach or hold those screws; the stator plate reached 3 of 10 rear screws and sat on the rear cover, 13 mm behind the face they're in | Draw the pattern on the real parts before calling a connection possible. A contact area says a joint has room, not that its screws land on it. Now a cup round the heads and a rim to the real face, both inside the motor's own d120 |
| A catalogue fit is more than bore, OD and width: the slot held a CRBT 405 A, but IKO's shoulders and the race's retention use more of it, and the 0.5 mm left on the hub side holds no circlip | Check each race is stopped both ways from the solids (a probe at the catalogue's shoulder band). A bearing that fits and can walk out doesn't fit |
| The bearing's rating looked fine on half the leg's load. A force line 14 mm off centre on supports 76 mm apart puts 68 % on one, and fs fell from 1.48 to 1.08 | Use the lever rule on the same force line the rest of the table uses. Don't write 'half' for a pair |
| A hole near a plate's edge read 0 mm from it, with the disc it's drawn over carrying on past that edge | Read a hole on its parts as one body: plates drawn overlapping are one piece of metal. And a cut in a screw's own part mustn't count as uncovering it in a skin test |
| A check on a screw into a motor's hub failed through the joint's sweep: the mesh has hub and stator as one body, so the screw 'hit' a pin that really turns with it | Model what moves together. A bought part drawn as one solid has moving surfaces in it: ask only what the screw's own link doesn't carry |
| Right-side motors are the left's mirror in the spec, and no such part exists | Check that a pattern reflects onto itself (RS04's does, about its tab: the same part fits both sides). Where it doesn't, place each side from the real part, as the warning in group `pattern` says |
| Sealed cavities came back as pieces of negative volume from `decompose`, and the real RS00's steps under the wrist cuff made two, 'covers mounted' failing on a shape nobody could see | Count only positive-volume pieces. Print each piece's bounding box and volume first, as the earlier flare row says |
| Plates and boxes read as a kit, whatever their numbers ("our connections are flat square ones"), and offline primitives could not make a fillet where a tube meets a fork | A part is a tree of distances (`tools/sdf.py`, kind `sdf`): smooth unions and cuts, meshed and cached by hash, exact for inside tests, with bores still crisp `cut` geoms. Real fillets, real hollows, real volume: mass from the solid at fill 1 |
| A smooth union's fillet (k 16 mm) put metal outside the shape it blended: a blob on the barrel's plate over the screws, a lip past its open end the motor couldn't pass, and a thick lump that weighed 0.3 kg. Only the assembly check and a section showed it | Blend small, then cut the seats flat again after the blend. Slice a part's volume by height when its mass surprises you: the shank body's floor alone held 91 of 365 cm3 |
| Saint-Venant's J = A^4 / (40 Ip), right for solid shapes, read a d66 x 2 tube at about 470 x its real shear stress, and failed a closed section that passes easily | A section with a real hole is a closed section: Bredt, tau = T / (2 Am t_min). Check any formula against a known case when a shape class first appears. This was a wrong formula, not a weak design, and the change is named here because it raised numbers |
| A fork slides over a barrel, but a cup one piece with its cheek can't enter a bearing unless it comes along the axis, and one fork can't do both sides. Every first order drawn jammed | Think the build out while choosing the split: one cheek bolts on. Hold the order as data (`HW.step`) and let `assembly` slide each part along its path, and `access` reach each screw only past what's on by then. A check that ignores order calls a removable cap a blocker |
| A cover with one level of mesh: a marching-cubes mesh failed as non-manifold when a flat face lay on a grid plane (exact zeros in the field) | Mesh at a level no grid value equals |
| A black frame from the offscreen renderer, then a part-drawn one with a black band, looked like NaNs or settings; bisecting found it only with large meshes at large sizes | Render until the corners show the background. Read a frame's numbers rather than opening a picture each try |
| Mesh facets showed as streaks in polished reflections | Take normals from the distance tree where the mesh agrees |
| Thigh and shank meet at 2.15 rad through rigid structure, and the first neck hit the fork at 1.5 rad. The angle budget hadn't been worked out | At any radius, the two links' half angles add up to under 180 deg less the range. 57 deg here: scoop the shank behind the knee where the fork's wide. It also reads well |
| The first closed shank went through the knit's front at the waist: the barrel's tangent line ran past the skin's line. Only the covered close-up showed it, as a black blob | After changing structure under a skin, render the covered look as well, every time |
| A wall and a motor as deep as the limb: the RS03's ears reach the wall itself at some turns, no clock clears them | Square the section there (skin too, n 4.4), thin the wall to 1.4, and machine a relief for the ears in the panel's inner face. Say that this isn't a uniform wall |
| The 6 % wiring allowance said it covered bearings and fasteners, which are parts now; the skin's density held 2.5 kg/m2 of formers under skin the shank's body now fills, and a disc round the knee charged cloth for its end faces | When a real part arrives, take it out of the allowance that stood for it. Reconcile per link, say which figure is still a guess (`spec/assumptions.json` garment_former), and report mass before and after |
| Rules that a maker's part can't meet: 2 d of thread in a 5 mm hole | Keep the row failing, use the hole to its depth, read strip force as well, and put the question to the maker. No design change closes it, and no rewording of the check should |
| A hull of two circles came out as half a lug when the second circle was the bigger: the walk round it assumed the first was. The hip carrier lost its eye, and only a contact row (4.3 mm of air) showed it | Normalise inside the helper (bigger end first), and print a new part's bounding box before anything else |
| A check that read only a motor's two end planes called a motor bolted on its rear face, 13 mm in from its cover's end, unheld | Read the face its stator screws are in, from the screws themselves, as well as the ends |
| The build order called keys blocked by arms, covers and the other side's parts, none there when the joint is built | A build step can be a bench subassembly; covers aren't on till a step names them; links outside the build aren't there. Without that, access says nothing |
| A real structure made the robot 3 kg heavier than the placeholder it replaced: 65.2 against 62.5 | Lighten by walls and windows on what the load allows, and correct the model where it double counts (formers under a filled skin, 3 mm on 2 mm covers), each stated in assumptions.json. Report before and after |
| The calf's motors vanished inside one colour of metal: the cover-off picture read as one block | Finish is design: dark for a motor and its housing, silver for structure, and windows where a housing hides the motor |
| Panels that meet flush or overlap read as one surface, so a joint didn't read as a joint | Real seams: a groove with a dark floor between panels, a shadow line round each hub |
| The mirror renamed only parts named 'L ...': a motor named for its joint ('L_ankle_pitch actuator') kept its left name on the right leg | One rename for parts, joints and records (`mirror_part`), used everywhere |
| A pin pressed into a block, a bushing pressed into a cheek: the contact rule read each as a few mm2 (an overlap's volume over its thinnest side), so every pin and bushing came out as its own piece | Seat a bushing on its flange's face; let a pin join what it passes through; keep running fits exactly their size |
| Placed the RS03's eight ears' plate, then found the rod passes one ear and two sit against the panel: no turn of the motor clears all eight | Scan the ears against the rod's sweep and the walls before drawing the plate; report the screws placed, 5 of 8 here |
| The renderer gave 'a black frame' for every large set: the first frame after a big upload can stay black however long one waits, and a close view filled a corner with a dark part, which the corner test took for a failed frame | Rebuild and redraw a black frame (three tries); call a frame good when its edges are mostly not black, and look at every sheet, as a half-drawn one passed the looser test |
| The foot weighed 1.51 kg: the shoe counted a 3 mm wall, the midsole a solid through the frame, the outsole a top wall under the midsole | Ask what each rule counts on a shoe as on a cover; state the corrections (assumptions.json shoe_walls) |
| Reported "0 failing" as if it meant "buildable" | Say what the checks do not cover. Build one joint with real parts before buying the rest |
| An interrupted command had already run, and the report said nothing had changed | After any interrupted step, read the state before saying what is in it |
| Reviewed for hours in offline renders, the user assumed they were looking at CAD, and asked late on "were you building the whole thing without Fusion?" | State at the start of each review what the pictures are (offline primitives, or CAD), and what that can't show. Say early when CAD comes, and what it would add |
| A build video's parts were left out of place at the end, because a moved group didn't include what it was built on; small contact sheets hid it and the user found it | Assert in the renderer that every part ends at its final pose. Look at full-size frames of the finished result from several sides |
| A moving part was only ever compared shut; open, it was a hollow ring against the reference's filled one | Compare moving parts through their range, against the reference's own footage |
| Tools forked from a larger robot failed on the new one, and their names and assumptions were still the old robot's | Try each inherited tool early, and list which ones really work. Don't report a tool as available until it has run on this robot |
| A first torque analysis looked plausible but was meaningless: the floor carried nothing and the root held all the weight. A fall detector read a height that was never the robot's height | Sanity-check physics results against something known before reporting: does the floor carry the weight? does the first frame pass? Report a test as invalid rather than rounding it into a result |
| Collision on the feet only: a falling robot sank through the floor | Give the whole robot simple collision shapes before judging any fall or motion, and look at the video |
| A motion scaled by theory asked for 2.4 times the actuator's no-load speed, with a joint at its limit half the time | After retargeting, report each joint's peak speed against its no-load speed and its time at a limit, before trying physics |
| A physics number is only as good as its inputs: friction, stiffness and infill were guesses, reported beside measured ones | Keep a table of each sim parameter's source: measured, scaled, copied or guessed. Randomize the guesses in training, and replace them from a test rig |
| A background agent ended with no result and no notice, and was reported as still running | Before saying a background job is running, check that it and its output exist |
| Stale docs: the public README described the previous robot after a fork, and the default branch's page lagged the design | Before any push, read the page a stranger lands on. Say which version it shows |
| A trainer built for another robot ran happily on ours while dropping it from 12 cm at every reset: a height in the recipe was tuned to that robot's frame. Another setting silently did nothing, as it only acts through that robot's actuator model | Reused recipes hold absolute numbers and hidden assumptions. Before a long run: print every event and term of the loaded config and question each one; then reset, hold still with zero actions, and read the numbers (feet on the floor, none fall in 2 s). A clean smoke test only proves the code runs |
| "Is it training our robot?" could only be answered by checking | Print from the running config: the model's source, mass, joints, each joint's actuator values against the parts catalogue. Add it to the pre-run check |
| An audit of a recipe reused from another robot found: command ranges past our joint limits, gait lengths and times tuned to its size, mass randomization narrower than our uncertainty, and, once its actuator model was left out, no torque-speed curve or delay at all | Keep an audit script that prints every term of the loaded config. For each number, decide: scale it (say by what), replace it from our parts, or keep it (say why), and write that down beside the config. Removing a piece of a recipe also removes what it did: list those too |
| Actuator numbers were scaled from a sibling model by gear ratio, on the assumption of the same motor, and trained on for hours; a five-minute search showed torque 2.5 x off, as the sibling has a different motor | Before using any actuator number: search the maker's page first, then several retailers, then independent tests. Record the source of each number and whether sources disagree. Never derive a spec that can be looked up. Independent tests also give what specs don't: overload cut-outs, backlash, usable torque in motion |
| Electronics were placeholder boxes until the parts list was checked against real listings. Then: the 5 V regulator was far below the servos' summed stall current, no board fitted its box, a full battery was above the servos' rated voltage, the actuators had months of lead time, and one seller's torque disagreed with the number trained on | Size the electronics as a design step, not at purchase: sum stall currents per voltage rail against the regulator; take each board's and battery's real size from a listing before modelling its box; compare the battery's full-charge voltage with the actuator's range; check lead times early. At purchase, read each listing itself: stock against the quantity needed, what is in the box, and whether the page shows the product named, as one link led to a different product. Buy one joint's parts first, to measure what listings disagree on |
| A walking test reported speed in the body's frame, averaged over all robots, and called the walk good; the first proper video showed a robot told to go straight turning 310 deg in 10 s. Body-frame speed counts a circle as speed, and left and right turners cancel in an average | Test each robot on its own and in the world's frame: start-to-end distance over time against the command, and each robot's absolute turn rate, not the mean. Look at a video of the walk before reporting that it walks: from a following camera, measure heading too, as the camera's own motion hides turning |
| A floor task copied from another robot used its tucked pose: on ours the feet went through the head, and the simulation has no self-collision to stop it, so training would have learned a move the real robot can't make. Its knee pose was past our joint limit too | Before training a skill from another robot, put its poses through our limits and our parts' collision check. Then replay the learned motion through the same check before believing it, as a policy trained without self-collision can pass through itself |
| A render went dark after a small speed-up: a kinematics-only update leaves lights where they were, so the main light was effectively gone. The user noticed the picture was dark before the cause was looked for | When a picture changes in a way nobody asked for, find the cause rather than adjusting colours around it. Compare with a minimal scene to isolate it |
| A policy stayed up, tracked forward speed and lowered its servo load, yet could neither turn nor stand still: it pivoted on both hip yaws at 1.8 Hz. Time-averaged yaw hid this. The reused reward, an exponential of squared error, gives no gradient at a large error, so nothing taught it to stop. The first guess at the cause was wrong too, and only a measurement showed that | Print each reward term's score against its maximum: a term stuck near 0 is teaching nothing. Measure rates per step as well as averages. Test zero actions to split a bad policy from an unstable model. Pair an exponential tracking reward with a term that has a gradient far from the target. Measure before believing a diagnosis |
| A new penalty fixed a walk's twist and scored well, but the policy now pressed two joints on their stops at full stall torque all the time, as stops are perfectly stiff in sim. A real actuator would overheat. Only the per-joint torque table showed it | A new penalty moves the exploit: after each reward change, read every joint's position, torque and speed, not just tracking. Penalise holding near peak torque and resting on stops from the start |
| A get-up skill scored 100 % in 0.2 s. The reset put the robot in the air, so it swung its legs under itself mid-fall. Settled first it still scored 98-100 %, but replaying it through the real parts showed feet through feet and hips through the trunk: the sim had no self-collision | A result that looks too good gets its start state and its motion checked before it is reported. Skills start from rest, in training and in the test. Train floor skills with self-collision on, measure the height each reset pose clears the floor, and replay the winner through the real solids |
| A test labelled peak-torque time by joint order, while torques come in actuator order: every figure named the wrong joint | Index by the names of the array being read; never assume two lists of the same joints share an order |
| Four GPU trainings ran beside six CPU searches of 14 workers each, on a 32-thread machine: the display driver reset and every run died with an unknown CUDA error, with most progress unsaved. The shell's exit code 0 hid it, as the last command in the line was a grep | Count workers against the machine before starting another job, and add load one job at a time, reading iteration speed. An all-at-once exit means check the system log first. End a run's command with its own exit status, not a log filter's |
| Static torque numbers ignored momentum, and a question about a leg-driven throw exposed that. A scripted keyframe search answered in minutes what a training run takes hours to hint at | To tell a weak robot from a weak policy, search a simple open-loop motion under the real actuator limits and step the strength up: it gives a threshold. It can show a move is possible, never that it is impossible |
| Compared against a reference robot using an actuator's datasheet torque at its rated voltage. The reference's own training config ran it at a higher voltage and nearly double the torque, past the maker's limit, so the comparison was badly off | A reference robot's own files say how it runs its parts: read its actuator config before quoting a datasheet for it. Note where it runs a part outside the maker's ratings, as that is a choice with a cost |
| With several versions of a design in one repo, a motion from one was replayed against the default version's parts, and reported false collisions | Anything recorded from one version should be checked against that version: set the version explicitly for every tool, and save it with the recording when that can be done |
| The stall penalty went into the walk only, so the next skill trained found the same exploit on a different joint: its neck pressed on a stop at stall over 90 % of the time, and the success figure looked fine | A protection found in one task belongs in every task on that robot, from the start. Test checkpoints early and read each joint's load, not just the success rate |
| Scaling a design past its build method: a first concept had a one-piece part no printer could make, until the user said so. A check that every part can be made didn't exist | Check how each part gets made, not only that it fits: a part's size against the machine that makes it is a check, proven on a broken design. Split it, or change the material |
| Told the user a design would have bolts and bearings as the earlier robot's, from memory. That robot's spec had none | Read the earlier work before citing it as the standard, and say which details it actually has |
| Chose roller chain for a large robot's knee from a neat calculation, without looking for anyone who had used it at that size. The user asked; a search found chain only on small robots | Before picking a mechanism, look for proven examples at that size and load. If none turn up, say so when proposing it |
| Notes were written only when the user asked | Add the lesson in the same step as the fix, in this repo and in any parent method repo, without being asked |

## Motion (MuJoCo)

| Issue | Do instead |
|---|---|
| Adding bodies to an `MjSpec` that had been compiled once put the right toe on the ankle pitch link: the right ankle roll had a zero Jacobian column and never moved | Add to a fresh spec and compile once; assert each added body's parent |
| Kinematic playback with `mj_kinematics` alone left the directional light with a zero direction (a dark floor), and the MJCF's own spotlight sat over the origin | Call `mj_camlight` after `mj_kinematics`; light the viewing model on its own |
| Retargeted stance feet slid 9 cm/s and sank up to 3 cm into the floor: PICO's feet drift with no contact sensing | Lock planted feet in the IK targets (a second pass over the take) and ground the lowest sole every frame: 2 cm/s, no sinking |
| Motion from a video (2026-11-01): NLF's person detector missed the robot whenever it bent over, which is every pick-up (80 % of frames found) | The camera is fixed: find the robot by its difference from the empty room (the median of 60 frames) and pass that box to NLF as an extra detection: 99.6 % found, the bends included |
| A floor fitted to the planted feet came out tilted a degree or two; from a camera 1.3 m up, looking almost level, that put the back wall 10.6 m away on one side and 14 m on the other, and the robot grew taller with distance | Solve the horizon and the camera's height from the robot itself: in each upright frame its foot and head are at known heights, and the ratio of their distances below the horizon holds at any depth or focal length. The robot then measures 1.60-1.62 m (head joint) from 4 to 9 m |
| The camera's up vector had the wrong sign (tilting it up, not down): the robot came out 2.1 m tall | Derive it from the rule, not by eye: every ray on the horizon row is square to up, so u_z = (v_hz - c_y) when u_y = -f |
| The feet slid with the video's depth jitter: each frame NLF puts the whole body a little nearer or farther | Scale each frame about the camera (the picture is unchanged) until the lowest foot is on the floor, then pin planted feet by moving the root (`--pin`): 5 cm/s to 1 cm/s |
| The head and wrists took odd angles: a video cannot show a robot's visor direction or its wrist twist | Hold them straight (`--hold head,wrists`) and say so |
| The hips stop at 97 deg of flexion, so echo bends 65-77 deg where Figure folds over at every pick-up | Open: a hip redesign (more flexion, a slimmer rear lobe) |
| A retargeted walk swayed side to side at the waist; two retarget routes looked the same and the pipeline was blamed. Measured, it copied the human pelvis exactly (6.1 deg RMS roll), but a human spine cancels about 70 % of that (chest 1.8 deg) and a yaw-only waist cannot, so the whole upper body rolled with the hips. That mismatch also locked the elbows straight a third of the time | Compare each body with the source by numbers before tuning. On a robot with fewer spine joints than a human, weight the IK to the chest rather than the pelvis (torso roll 1.7 deg, elbows at limit 4 %). The cost moves to the hips and ankles: check it in physics. Waist pitch and roll are phase two, after this design walks in sim |
| A policy scored "100 % finished" at 1500 iterations with the pelvis 0.5 m off the path: the sim's termination is lenient, so it says little about falls | Report the strict tracking pass, the distance walked against the reference and a fall measure of your own beside it |
| A fall flag fired on spins, then on bows: tilt against the reference counts a missed heading, and lean from upright counts a bow the motion asks for | Fall = pelvis well below the reference, or leaning far past the reference's own lean; look at each flagged clip |
| Each 5 s shove barely tested a test set of 4-10 s clips | Shove every 2 s and step up the size until something falls |
| Peak torque hit the limit on many joints, which looked like undersized parts: part of it is the policy's chatter | Read RMS over a 0.2 s window and the time at the limit beside the raw peak. Ankle pitch stayed over rated on the smoothed number; the hips did not |
| Ankle pitch sat near rated just standing: the CoM is 35 mm ahead of the ankle axes in the default pose and 50-65 mm through the motions | Measure the CoM against the ankle axes per take (`train/ankle_load.py`), and hold this load against the rated torque |
| The trained walk passed the hands through the hips (56 cm3 overlap): only the soles collide in training, so nothing stops it | Replay policy takes through `tools/motion_collisions.py`; a stable walk in a soles-only sim says nothing about self-collision |
| Open-loop replay of a policy's targets in CPU MuJoCo left the take in 1-3 s, which says nothing about either sim | Run the policy closed loop in CPU MuJoCo, using the GPU sim only for observations (`train/replay_cpu.py`), and check floor force / weight comes to 1.00 |
| Fine-tuning from a checkpoint failed on an assertion: the loader had the X2's 31 joints written as numbers | Take the joint count from the robot config wherever a dimension depends on it |

## Scenes (MuJoCo)

| Issue | Do instead |
|---|---|
| A room laid out by eye put walls through the walking robot and the coffee table under its feet | Measure the room from the same video: floor points marked on the empty-room frame, traced to the floor through the calibrated camera, so the room and the motion share one frame. Then check the whole take for overlaps with `mj_geomDistance` |
| MuJoCo read no JPEG texture ("unsupported content type") | Keep sources as JPEG; write PNGs MuJoCo reads to an ignored build folder |
| A 2D texture on a box geom stretched one image over each face | Build textured boxes as meshes with texture coordinates in metres (`_box_mesh`), and rounded upholstery as superellipsoid meshes |
| Poly Haven's velvet is red and its linen blue; its walnut veneer is nearly grey | Keep the photo's detail (luminance about its mean) and recolour it to the room's colours |
| Poly Haven's API refused Python's default user agent (403) | Send a user agent (curl -A) |

## Fusion API (new here)

| Issue | Do instead |
|---|---|
| `rootComponent.name = ...` raises "root component name cannot be changed" | The root takes the document's name on save |
| Every loft showed a seam line down the front (face, torso, legs) | Start the closed splines' points at the back (t = pi) |
| Decals placed on a straight-line estimate of the face sat 2-3 mm deep | Place them on the loft surface interpolated the way the loft is (PCHIP), 0.6 mm proud; then measure in Fusion (TemporaryBRepManager difference) |
| Orthographic `camera.viewExtents` | Equals the visible height in cm (800 x 600 picture) |
| STL export units | millimetres; `make_robot_files.py` detects the scale against the spec |
| As-built joints from a sketch point | Joint axes line up with the world X/Y/Z; Fusion poses matched the offline kinematics within 1 mm |
| Rebuild time grows with the timeline (0.6 s per link in a new document, 10-15 s at ~650 features) | Rebuild into a fresh document when most links change |
| A visor cut from a head: removing bodies while iterating `splitBodyFeature.bodies` raised "Bad index" | Copy the collection to a list first; keep the piece whose centre of mass is in front of the plane. Offline the same cut is `Manifold.trim_by_plane` |
| `viewport.visualStyle` | `ShadedVisualStyle` for review renders (no edge lines) |
| A loft cut by several planes (shoe collar, a band between two lines) | `clip` takes a list of planes, applied in turn; a plane that misses the body makes `splitBodyFeatures.add` raise: keep the body |
| MCP calls time out (~60 s) while Fusion carries on: both feet in one call, all 29 joints in one call | One link per call when it has cut lofts (~45 s each); rebuild only the joints of the links rebuilt (`joints([...])`, 5 s); after a timeout, read `status()` before retrying |
| Past ~1,000 timeline features (repeated link rebuilds) every single-link call timed out, though the work still finished | Rebuild into a fresh document before the timeline passes ~900 |
| A full build alone is now ~1,800 features, and one hip lobe with 17 prism cuts took 5-10 minutes to rebuild (each cut is a sketch, an extrusion and a combine) | One link per call, then poll `status()` with read-only calls (they time out too while Fusion works; keep asking); do the offline work (renders, video, docs) meanwhile; keep cuts few and convex |
| `viewport.saveAsImageFile` returned True and wrote nothing: first while a moved joint's position was uncaptured, then for every save, even at rest (the MCP screenshot failed too) | `build.render` now reports whether the file was written; render poses offline from the spec's shapes (`tools/render_pose.py`, MuJoCo's renderer, same framing within 2 px) |
| ...and `build.render` said "written" because an older picture of the same name was there | Delete the target before saving, then check that the file exists |
| Renaming the document's appearances in one pass over `design.appearances` skipped some (renaming re-sorts the collection), so the STEP export still carried the old name | Collect the matching names first, rename, and repeat until none are left; then grep the export for the old name |
| `app.data.activeProject` raised 'InternalValidationError : group' with no project selected in the data panel | Find the project by name in `app.data.activeHub.dataProjects`; `document.saveAs(name, folder, description, tag)` into a folder made with `rootFolder.dataFolders.add`; check `doc.isSaved` and `dataFile.versionNumber` |
| The STEP's top-level product was named '(Unsaved)' while the document had never been saved | Save the document first (the root component takes its name), then export STEP and `.f3d` (`createFusionArchiveExportOptions`) |
| Fusion held about 10 GB with six full builds open, and the user needed the memory for training runs | Do the Fusion steps first (rebuild, save, export) and say when Fusion can be closed; build in one document, not a new one each round; if asked to terminate it, check the document is saved (`isModified` false) and stop the process |

## Environment (Windows)

| Issue | Do instead |
|---|---|
| `git clone` failed: "Current working directory has a path longer than allowed" (the session scratchpad path) | Clone into a short path (`C:\Users\PC\AppData\Local\Temp\figrefs`) |
| Python could not open files in the session scratchpad (the full path is over 260 characters) | Keep working files in a short path (`%TEMP%\echo`), not the scratchpad |
| Python's `zipfile` could not test the `.f3d` ('compression method not supported') | That is normal for Fusion archives: list the entries (`infolist`) to check the export, or open it in Fusion |
| `import mujoco` fails under `python -I` (it lives in the user site-packages, which `-I` skips) | `-I` for anything that reads downloaded files; plain `python` for our own sim on our own files |
| MuJoCo stand test rocked heel to toe, then leaned 5.5 degrees | Servo gains: kv = kp/6 (kp/25 was far under critical damping), kp = 8 x peak torque (servo give without gravity feed-forward). Both runs held the robot with no torque saturation |

## Repository and publishing

| Issue | Do instead |
|---|---|
| A video of someone else's robot is theirs: its frames and clips cannot be published, and X's terms forbid downloading outside its own features | Keep the clip local and ignored (`reports/video/`), fetch only the minutes needed (an HTTP range read, ffmpeg -ss over the URL), publish only echo's motion and our own renders, and say where the motion came from with no affiliation implied |
| The first push was rejected (GH007): the commits carried the owner's private e-mail | Author commits with the GitHub no-reply address (`<id>+<login>@users.noreply.github.com`); push with `GIT_TERMINAL_PROMPT=0 GCM_INTERACTIVE=never` so a missing credential fails instead of hanging |
| A public repo next to material we may not publish: the reference robot's video frames, comparison panels made from them, the operator's raw motion capture | Ignore them by pattern from the first commit (`reports/compare/figure_*`, `compare_*.png`, `detail_*.png`, `reports/motion/`, `reports/web/`); no reference logo (trademark): our own mark |
| A 20 MB Fusion archive was committed under the old name and renamed in the next commit, so every clone downloaded it twice | Settle names before committing large binaries. To remove one: rebuild the commits without it (`git commit-tree` on the same final tree, verify the trees identical and the file unreachable), keep a backup branch, and force-push with a lease (`--force-with-lease=main:<old>`) only with the owner's go-ahead (the permission system blocks it otherwise) |
| Renaming the robot and the repo (guna to echo) | Rename every file and mention in one commit (`git mv`, then a text replace over tracked files, then regenerate what bakes the name in: URDF, MJCF, STEP, videos), rename the repo through the GitHub API with the credential git already uses (never printed), then `git remote set-url`; GitHub redirects the old URL |
| We built on other people's work (the reference robot's specs and frames, open robots' layouts and URDFs, retargeting code from another project) without a running list of sources and licences, and had to trace each one back at the end | Keep a sources list from day one (`.claude/skills/humanoid-from-spec/references/sources.md`). Reading a design is not copying it: Asimov's, Unitree's and AgiBot's licences bind only if their files are copied. Adapted code keeps its notice (`THIRD_PARTY_NOTICES.md`, GMR's MIT notice) and names its source in the file. The project needs its own licence for others to reuse it: echo is Apache-2.0 (`LICENSE`) so anyone can |
| The user wanted to see changes before they went public | Publish the review page (the viewer with the new model, movies and renders), commit locally, and push only after the go-ahead |
| Scratchy lines across a part in a render. Two parts were cut at one height, so their faces shared a plane and the renderer picked either, triangle by triangle. No check looks at this, and the usual views never showed that side | Coincident faces show as lines or hatching that crawl with the camera: test by rendering with shadows off (no change means not shadows), then search for faces of two parts in one plane. Leave a real gap or step between parts, and look at a model from below, not only from the usual views |
| Started a long job on a design the user had already asked to change. The choice was left as an open question and the spec still had the old part; the user had to ask | Before a long run, list the open design choices and say which one the run assumes, in the same message that starts it |
| Proposed a mechanism without working it out, and sized its range from the joint's limits. When calculated it could not work as offered, and a simpler one could, once the motion's real range was measured | Calculate a mechanism before offering it as an option. First measure the range the motion really uses |
| Scaled a small robot's training rewards to a far larger one, every number correct by the physics, and it learned to stand still with survival looking perfect. A reward that needed a long foot lift was never found by chance, and standing already scored well | Correct scaling doesn't keep a reward discoverable. Compare a new robot's reward terms early with a robot that learned: a term at zero means no path to it. Episode length alone says nothing: test speed too, early |
| Guessed at a physical cause for a robot failing to step, when the numbers could be read. The user pointed it out. Measured, the guess was wrong about what stopped it, though the limits it named were real | Before naming a possible cause, measure it: joint torque, speed and range against limits, on the failing robot and on one that works, with one script. Pin every free variable in that script, and check against a known number |
| Called a robot weak after comparing it with one much smaller robot, normalised by total height. Against robots of its own class, by weight x leg length, the same joint was fine | Compare with robots of the same class, read from their own models, and normalise by the length that carries the load |
| Read joint torque and speed tables for a new robot and not joint angles. Its walk sat on a joint stop most of the time, pressing past it, across several runs. It explained why less mass didn't lower that joint's torque | Test time at each limit, in stance and in swing, from the first checkpoint that moves: a torque that won't drop with load is a joint pressing on something. Size a limited-range mechanism from the robot's own motion, not another robot's |
| Let a joint run 38 % over its rated torque, because the training only penalised near-stall, from 70 % of peak. With 3:1 peak to rated, a joint can sit at twice its rating and pay nothing | Penalise sustained load above the rated torque, over a few seconds, on any robot whose joints have a continuous rating. Compare RMS with rated at every checkpoint |
| Pushed a regenerated patch before testing it. It had picked up generated files and did not apply, and the test straight after caught it | Test a patch on a clean checkout of its base before pushing it. Take its file list from the last good one, and read what is new |
| Trained a parallel ankle with pitch and roll limited separately, though one pair of motors drives both, so the sim was optimistic. Found only when the user asked whether two motors could really share a joint | Where motors share joints, work out each motor's load from the take (motor = pitch / 2 +- roll / (2 x ratio)) and compare it with rated and peak; prefer a layout with one motor per joint |
| The hands passed through the hips in almost every clip and nothing flagged it: 95 % of the retargeted references already overlapped (echo's hips are wider than the human's) and training had no collision between them | Check self-contact in the reference motions as well as the takes; clear the references, then penalise overlap on the kinematics, since a world-model reward has no contact forces to read |
| A test shape's primitives, taken from mesh bounds, overlapped at the zero pose and exaggerated depth | Fit spheres to each link's convex hull, check them at the zero and default poses against the mesh gap, and confirm the result with the mesh collision test |
| Stiff elbows, sideways head and bent wrists in the walk: the retarget scaled each arm joint about the root (stretching the arm past its reach), kept X2's arm offsets, and had no head target; the policy doesn't track untracked joints, so they drifted. | Start the arm at the robot's real shoulder in the chest frame, place elbow and hand along the human's bones at the robot's bone lengths, drop arm rotation targets, calibrate wrist and head offsets from the walk's mean, and track the head and hands. Elbows then match the human (30/34 deg). Read the inherited robot's notes first: X2's README already described this class of problem. |
| Waist twisted about +-50 deg and hip yaw swung about 80 deg in the walk: the pelvis rotation weight was 0.1, so the IK twisted the pelvis freely. | Pelvis rotation weight 5: waist about +-10 deg, hip yaw swing about 26 deg. Check waist and hip yaw when judging a retarget, not only the limbs. |
| Ankle pitch ran over its rating even standing: the reference stood with the centre of mass 11 cm ahead of the ankles, and the load looked like a motor limit. | Measure the centre of mass over the ankles before upsizing an ankle motor. Pelvis weight and a 3 cm stance shift brought it to 4-6 cm. |
| The knee and elbow carried black plates stuck on a wide grey drum, and a hard thigh with a V cut for the fold: every check passed, and no real robot looks like that. Figure's black is a thick hub at the joint, and the grey turns round it | The black is a part on the load path: a thick hub on the distal link with the stator, the fork in the band between neck and hub, a neck only as wide as the motor needs. A wedge a hard cover needs for range is closed by a soft knit panel, and say plainly that the rigid checks do not see it |
| The user found the knee's plates and gap from a phone; the close-up comparison in the method had not been run on each joint, straight and bent, before asking for review | The close-up audit runs before asking for review: each joint region at the same scale beside the frames, straight and bent, measured. For each: is the black a real actuator or housing the grey turns around; is there any gap, wedge, stuck-on plate or step a real robot would not have |
| A closed flare over an opening counted as a second 'piece' in the covers check: manifold's decompose returned the sealed cavity, not a loose part | Print each piece's bounding box before chasing a bracket. Open the cavity (the neck runs through it anyway) |
| A cheek with a bearing bore wider than the cheek fell in two in the structure check | Size a part round its bore; the check caught it |
| Rigid-cover logic (sockets, drums, hems, fold planes, seals, plugs) kept adding new artefacts at the knee, elbow and shoulder, because Figure's grey is fabric, not shell | Model the grey as a knit garment (role knit): one stretch panel per link, ending beside the hubs, with a small gaiter at a fold. The rigid parts inside clear each other and fit the skin with an allowance; the garment's bulk still counts between far links. The look comes from the surface; the inner formers are not designed yet, and whether a textile does it is for the bench test |
| Shoulder motors stood outside the torso (the RS06 roll spanned y 0.161-0.249, the torso ended at 0.165), and three rounds tried to hide that with a cap and a sleeve | Move the joints: pitch and roll axes 30 mm in, the arm's line kept by a jog in the roll link, a fork round the motor. Ask where the motors are before shaping a cover |
| A dark sliver over the hub survived a guess at its cause; a part-ID render named it in one call: the outer cheek, seen through a lens between two nearly equal surfaces | Read the segmentation for the part at the pixel, don't guess. Parts meant to share a surface are cut from one list of sections |
