meetsitaram/echo/urdf/echo.urdf

<?xml version="1.0"?>
<robot name="echo">
  <!-- generated by tools/make_robot_files.py from spec/robot.json; do not edit -->
  <link name="pelvis">
    <inertial><origin xyz="0.000200445 -6.50375e-05 0.050538" rpy="0 0 0"/><mass value="6.1584"/>
      <inertia ixx="0.0485584" ixy="-2.82289e-07" ixz="-2.54689e-05" iyy="0.0170316" iyz="1.01542e-05" izz="0.0453683"/></inertial>
    <visual><geometry><mesh filename="meshes/pelvis.stl"/></geometry></visual>
    <collision><geometry><mesh filename="meshes/pelvis.stl"/></geometry></collision>
  </link>
  <link name="torso">
    <inertial><origin xyz="-0.0097095 1.29592e-07 0.26629" rpy="0 0 0"/><mass value="20.4020"/>
      <inertia ixx="0.276462" ixy="2.13212e-08" ixz="-0.00656202" iyy="0.247834" iyz="-5.41367e-07" izz="0.120184"/></inertial>
    <visual><geometry><mesh filename="meshes/torso.stl"/></geometry></visual>
    <collision><geometry><mesh filename="meshes/torso.stl"/></geometry></collision>
  </link>
  <link name="L_hip_pitch_link">
    <inertial><origin xyz="-0.088039 0.00423385 0.00115339" rpy="0 0 0"/><mass value="1.8944"/>
      <inertia ixx="0.00368996" ixy="-0.000598274" ixz="-7.16607e-05" iyy="0.00431146" iyz="-5.28705e-05" izz="0.00434189"/></inertial>
    <visual><geometry><mesh filename="meshes/L_hip_pitch_link.stl"/></geometry></visual>
    <collision><geometry><mesh filename="meshes/L_hip_pitch_link.stl"/></geometry></collision>
  </link>
  <link name="R_hip_pitch_link">
    <inertial><origin xyz="-0.088039 -0.00423384 0.00115339" rpy="0 0 0"/><mass value="1.8944"/>
      <inertia ixx="0.00368996" ixy="0.000598274" ixz="-7.16607e-05" iyy="0.00431146" iyz="5.28704e-05" izz="0.00434189"/></inertial>
    <visual><geometry><mesh filename="meshes/R_hip_pitch_link.stl"/></geometry></visual>
    <collision><geometry><mesh filename="meshes/R_hip_pitch_link.stl"/></geometry></collision>
  </link>
  <link name="neck_yaw_link">
    <inertial><origin xyz="1.91585e-07 0.00142031 0.0713208" rpy="0 0 0"/><mass value="0.4346"/>
      <inertia ixx="0.000272743" ixy="-4.6855e-10" ixz="-1.202e-10" iyy="0.000269897" iyz="-2.57826e-06" izz="0.000198811"/></inertial>
    <visual><geometry><mesh filename="meshes/neck_yaw_link.stl"/></geometry></visual>
    <collision><geometry><mesh filename="meshes/neck_yaw_link.stl"/></geometry></collision>
  </link>
  <link name="L_shoulder_pitch_link">
    <inertial><origin xyz="0.0005698 0.0796799 -1.15094e-09" rpy="0 0 0"/><mass value="0.7691"/>
      <inertia ixx="0.00102993" ixy="-4.52233e-06" ixz="-8.58135e-13" iyy="0.000521808" iyz="-4.26807e-11" izz="0.000875106"/></inertial>
    <visual><geometry><mesh filename="meshes/L_shoulder_pitch_link.stl"/></geometry></visual>
    <collision><geometry><mesh filename="meshes/L_shoulder_pitch_link.stl"/></geometry></collision>
  </link>
  <link name="R_shoulder_pitch_link">
    <inertial><origin xyz="0.0005698 -0.0796799 -1.15094e-09" rpy="0 0 0"/><mass value="0.7691"/>
      <inertia ixx="0.00102993" ixy="4.52233e-06" ixz="-8.58134e-13" iyy="0.000521808" iyz="4.26807e-11" izz="0.000875106"/></inertial>
    <visual><geometry><mesh filename="meshes/R_shoulder_pitch_link.stl"/></geometry></visual>
    <collision><geometry><mesh filename="meshes/R_shoulder_pitch_link.stl"/></geometry></collision>
  </link>
  <link name="L_hip_roll_link">
    <inertial><origin xyz="-0.0133328 0.00287777 -0.0917348" rpy="0 0 0"/><mass value="1.5149"/>
      <inertia ixx="0.00382075" ixy="0.000135209" ixz="0.00146737" iyy="0.00529508" iyz="-0.000271471" izz="0.00383771"/></inertial>
    <visual><geometry><mesh filename="meshes/L_hip_roll_link.stl"/></geometry></visual>
    <collision><geometry><mesh filename="meshes/L_hip_roll_link.stl"/></geometry></collision>
  </link>
  <link name="R_hip_roll_link">
    <inertial><origin xyz="-0.0133325 -0.00287771 -0.0917351" rpy="0 0 0"/><mass value="1.5149"/>
      <inertia ixx="0.00382069" ixy="-0.000135192" ixz="0.00146733" iyy="0.00529499" iyz="0.00027146" izz="0.00383768"/></inertial>
    <visual><geometry><mesh filename="meshes/R_hip_roll_link.stl"/></geometry></visual>
    <collision><geometry><mesh filename="meshes/R_hip_roll_link.stl"/></geometry></collision>
  </link>
  <link name="head">
    <inertial><origin xyz="0.0271777 0.00317143 0.123408" rpy="0 0 0"/><mass value="1.0287"/>
      <inertia ixx="0.00488978" ixy="5.24945e-05" ixz="-0.000101396" iyy="0.00662288" iyz="0.000180661" izz="0.00461789"/></inertial>
    <visual><geometry><mesh filename="meshes/head.stl"/></geometry></visual>
    <collision><geometry><mesh filename="meshes/head.stl"/></geometry></collision>
  </link>
  <link name="L_shoulder_roll_link">
    <inertial><origin xyz="-0.00174548 0.0254729 -0.0677619" rpy="0 0 0"/><mass value="0.8396"/>
      <inertia ixx="0.00179673" ixy="-3.58631e-05" ixz="9.7554e-05" iyy="0.00198913" iyz="0.000193078" izz="0.00105933"/></inertial>
    <visual><geometry><mesh filename="meshes/L_shoulder_roll_link.stl"/></geometry></visual>
    <collision><geometry><mesh filename="meshes/L_shoulder_roll_link.stl"/></geometry></collision>
  </link>
  <link name="R_shoulder_roll_link">
    <inertial><origin xyz="-0.00174548 -0.0254729 -0.0677619" rpy="0 0 0"/><mass value="0.8396"/>
      <inertia ixx="0.00179673" ixy="3.58558e-05" ixz="9.7554e-05" iyy="0.00198913" iyz="-0.000193078" izz="0.00105933"/></inertial>
    <visual><geometry><mesh filename="meshes/R_shoulder_roll_link.stl"/></geometry></visual>
    <collision><geometry><mesh filename="meshes/R_shoulder_roll_link.stl"/></geometry></collision>
  </link>
  <link name="L_hip_yaw_link">
    <inertial><origin xyz="-0.00243928 0.00268553 -0.1698" rpy="0 0 0"/><mass value="1.5481"/>
      <inertia ixx="0.0156258" ixy="-1.01663e-05" ixz="0.000904366" iyy="0.0158678" iyz="0.000259939" izz="0.00379251"/></inertial>
    <visual><geometry><mesh filename="meshes/L_hip_yaw_link.stl"/></geometry></visual>
    <collision><geometry><mesh filename="meshes/L_hip_yaw_link.stl"/></geometry></collision>
  </link>
  <link name="R_hip_yaw_link">
    <inertial><origin xyz="-0.00243928 -0.00268555 -0.1698" rpy="0 0 0"/><mass value="1.5481"/>
      <inertia ixx="0.0156258" ixy="1.02152e-05" ixz="0.000904366" iyy="0.0158678" iyz="-0.000259868" izz="0.00379251"/></inertial>
    <visual><geometry><mesh filename="meshes/R_hip_yaw_link.stl"/></geometry></visual>
    <collision><geometry><mesh filename="meshes/R_hip_yaw_link.stl"/></geometry></collision>
  </link>
  <link name="L_shoulder_yaw_link">
    <inertial><origin xyz="0.000136858 -0.00333585 -0.0557852" rpy="0 0 0"/><mass value="0.3927"/>
      <inertia ixx="0.00128441" ixy="-1.82913e-07" ixz="-5.9321e-07" iyy="0.0012496" iyz="-7.75784e-05" izz="0.000574904"/></inertial>
    <visual><geometry><mesh filename="meshes/L_shoulder_yaw_link.stl"/></geometry></visual>
    <collision><geometry><mesh filename="meshes/L_shoulder_yaw_link.stl"/></geometry></collision>
  </link>
  <link name="R_shoulder_yaw_link">
    <inertial><origin xyz="0.000136858 0.00333587 -0.0557852" rpy="0 0 0"/><mass value="0.3927"/>
      <inertia ixx="0.00128441" ixy="1.7495e-07" ixz="-5.93209e-07" iyy="0.0012496" iyz="7.75784e-05" izz="0.000574904"/></inertial>
    <visual><geometry><mesh filename="meshes/R_shoulder_yaw_link.stl"/></geometry></visual>
    <collision><geometry><mesh filename="meshes/R_shoulder_yaw_link.stl"/></geometry></collision>
  </link>
  <link name="L_knee_link">
    <inertial><origin xyz="-0.003933 0.000722175 -0.118494" rpy="0 0 0"/><mass value="5.2233"/>
      <inertia ixx="0.0906934" ixy="-2.24854e-05" ixz="-0.0021348" iyy="0.0921364" iyz="-0.000571107" izz="0.00772331"/></inertial>
    <visual><geometry><mesh filename="meshes/L_knee_link.stl"/></geometry></visual>
    <collision><geometry><mesh filename="meshes/L_knee_link.stl"/></geometry></collision>
  </link>
  <link name="R_knee_link">
    <inertial><origin xyz="-0.003933 -0.000722186 -0.118494" rpy="0 0 0"/><mass value="5.2233"/>
      <inertia ixx="0.0906934" ixy="2.25071e-05" ixz="-0.0021348" iyy="0.0921364" iyz="0.000571092" izz="0.00772331"/></inertial>
    <visual><geometry><mesh filename="meshes/R_knee_link.stl"/></geometry></visual>
    <collision><geometry><mesh filename="meshes/R_knee_link.stl"/></geometry></collision>
  </link>
  <link name="L_elbow_link">
    <inertial><origin xyz="-1.03347e-10 0.00111307 -0.0306498" rpy="0 0 0"/><mass value="1.8475"/>
      <inertia ixx="0.00597148" ixy="4.64502e-09" ixz="5.41031e-12" iyy="0.00548755" iyz="-2.83993e-05" izz="0.00241071"/></inertial>
    <visual><geometry><mesh filename="meshes/L_elbow_link.stl"/></geometry></visual>
    <collision><geometry><mesh filename="meshes/L_elbow_link.stl"/></geometry></collision>
  </link>
  <link name="R_elbow_link">
    <inertial><origin xyz="-1.03997e-10 -0.00111307 -0.0306498" rpy="0 0 0"/><mass value="1.8475"/>
      <inertia ixx="0.00597148" ixy="4.64545e-09" ixz="5.65172e-12" iyy="0.00548755" iyz="2.83993e-05" izz="0.00241071"/></inertial>
    <visual><geometry><mesh filename="meshes/R_elbow_link.stl"/></geometry></visual>
    <collision><geometry><mesh filename="meshes/R_elbow_link.stl"/></geometry></collision>
  </link>
  <link name="L_ankle_pitch_link">
    <inertial><origin xyz="-0.00401747 -0.000528611 0.000379847" rpy="0 0 0"/><mass value="0.1341"/>
      <inertia ixx="2.14513e-05" ixy="-1.94417e-06" ixz="1.41853e-06" iyy="2.77458e-05" iyz="5.10901e-07" izz="4.24004e-05"/></inertial>
    <visual><geometry><mesh filename="meshes/L_ankle_pitch_link.stl"/></geometry></visual>
    <collision><geometry><mesh filename="meshes/L_ankle_pitch_link.stl"/></geometry></collision>
  </link>
  <link name="R_ankle_pitch_link">
    <inertial><origin xyz="-0.00401747 0.000528611 0.000379847" rpy="0 0 0"/><mass value="0.1341"/>
      <inertia ixx="2.14513e-05" ixy="1.94417e-06" ixz="1.41853e-06" iyy="2.77458e-05" iyz="-5.10901e-07" izz="4.24004e-05"/></inertial>
    <visual><geometry><mesh filename="meshes/R_ankle_pitch_link.stl"/></geometry></visual>
    <collision><geometry><mesh filename="meshes/R_ankle_pitch_link.stl"/></geometry></collision>
  </link>
  <link name="L_wrist_yaw_link">
    <inertial><origin xyz="5.18208e-14 -4.46481e-10 -0.0536136" rpy="0 0 0"/><mass value="0.4944"/>
      <inertia ixx="0.000678861" ixy="1.80975e-10" ixz="1.33135e-16" iyy="0.000689287" iyz="7.65138e-13" izz="0.000290936"/></inertial>
    <visual><geometry><mesh filename="meshes/L_wrist_yaw_link.stl"/></geometry></visual>
    <collision><geometry><mesh filename="meshes/L_wrist_yaw_link.stl"/></geometry></collision>
  </link>
  <link name="R_wrist_yaw_link">
    <inertial><origin xyz="-1.54004e-13 4.46652e-10 -0.0536136" rpy="0 0 0"/><mass value="0.4944"/>
      <inertia ixx="0.000678861" ixy="1.80975e-10" ixz="1.92132e-16" iyy="0.000689287" iyz="-7.65761e-13" izz="0.000290936"/></inertial>
    <visual><geometry><mesh filename="meshes/R_wrist_yaw_link.stl"/></geometry></visual>
    <collision><geometry><mesh filename="meshes/R_wrist_yaw_link.stl"/></geometry></collision>
  </link>
  <link name="L_foot">
    <inertial><origin xyz="0.0331329 0.00153243 -0.0582261" rpy="0 0 0"/><mass value="1.0213"/>
      <inertia ixx="0.00119256" ixy="4.05768e-05" ixz="0.000353461" iyy="0.00442871" iyz="-1.51517e-05" izz="0.00464097"/></inertial>
    <visual><geometry><mesh filename="meshes/L_foot.stl"/></geometry></visual>
    <collision><origin xyz="0.04 0 -0.07"/><geometry><box size="0.24 0.1 0.03"/></geometry></collision>
  </link>
  <link name="R_foot">
    <inertial><origin xyz="0.0331329 -0.0015327 -0.0582261" rpy="0 0 0"/><mass value="1.0213"/>
      <inertia ixx="0.00119256" ixy="-4.06245e-05" ixz="0.000353461" iyy="0.00442871" iyz="1.5165e-05" izz="0.00464096"/></inertial>
    <visual><geometry><mesh filename="meshes/R_foot.stl"/></geometry></visual>
    <collision><origin xyz="0.04 0 -0.07"/><geometry><box size="0.24 0.1 0.03"/></geometry></collision>
  </link>
  <link name="L_wrist_pitch_link">
    <inertial><origin xyz="0.00417187 0.000768346 -0.051077" rpy="0 0 0"/><mass value="0.4373"/>
      <inertia ixx="0.000345666" ixy="1.40198e-06" ixz="-5.63764e-05" iyy="0.00038404" iyz="3.195e-06" izz="0.000249859"/></inertial>
    <visual><geometry><mesh filename="meshes/L_wrist_pitch_link.stl"/></geometry></visual>
    <collision><geometry><mesh filename="meshes/L_wrist_pitch_link.stl"/></geometry></collision>
  </link>
  <link name="R_wrist_pitch_link">
    <inertial><origin xyz="0.00417185 -0.000768345 -0.051077" rpy="0 0 0"/><mass value="0.4373"/>
      <inertia ixx="0.000345666" ixy="-1.40146e-06" ixz="-5.63766e-05" iyy="0.00038404" iyz="-3.195e-06" izz="0.000249859"/></inertial>
    <visual><geometry><mesh filename="meshes/R_wrist_pitch_link.stl"/></geometry></visual>
    <collision><geometry><mesh filename="meshes/R_wrist_pitch_link.stl"/></geometry></collision>
  </link>
  <link name="L_hand">
    <inertial><origin xyz="0.00110934 -0.00739179 -0.0710582" rpy="0 0 0"/><mass value="1.0164"/>
      <inertia ixx="0.00112685" ixy="1.3301e-05" ixz="1.73656e-05" iyy="0.00147448" iyz="8.23086e-05" izz="0.00088755"/></inertial>
    <visual><geometry><mesh filename="meshes/L_hand.stl"/></geometry></visual>
    <collision><geometry><mesh filename="meshes/L_hand.stl"/></geometry></collision>
  </link>
  <link name="R_hand">
    <inertial><origin xyz="0.00110934 0.00739179 -0.0710582" rpy="0 0 0"/><mass value="1.0164"/>
      <inertia ixx="0.00112685" ixy="-1.3301e-05" ixz="1.73656e-05" iyy="0.00147448" iyz="-8.23086e-05" izz="0.00088755"/></inertial>
    <visual><geometry><mesh filename="meshes/R_hand.stl"/></geometry></visual>
    <collision><geometry><mesh filename="meshes/R_hand.stl"/></geometry></collision>
  </link>
  <joint name="waist_yaw" type="revolute">
    <parent link="pelvis"/><child link="torso"/>
    <origin xyz="0 0 0.09" rpy="0 0 0"/>
    <axis xyz="0 0 1"/>
    <limit lower="-2.6" upper="2.6" effort="120.0" velocity="20.90"/>
    <dynamics damping="0.2" friction="1.5"/>
  </joint>
  <joint name="neck_yaw" type="revolute">
    <parent link="torso"/><child link="neck_yaw_link"/>
    <origin xyz="-0.012 0 0.4305" rpy="0 0 0"/>
    <axis xyz="0 0 1"/>
    <limit lower="-1.4" upper="1.4" effort="14.0" velocity="33.00"/>
    <dynamics damping="0.02" friction="0.3"/>
  </joint>
  <joint name="neck_pitch" type="revolute">
    <parent link="neck_yaw_link"/><child link="head"/>
    <origin xyz="0 0 0.0755" rpy="0 0 0"/>
    <axis xyz="0 1 0"/>
    <limit lower="-0.4" upper="0.45" effort="14.0" velocity="33.00"/>
    <dynamics damping="0.02" friction="0.3"/>
  </joint>
  <joint name="L_shoulder_pitch" type="revolute">
    <parent link="torso"/><child link="L_shoulder_pitch_link"/>
    <origin xyz="0 0.085 0.4" rpy="0 0 0"/>
    <axis xyz="0 1 0"/>
    <limit lower="-3.0" upper="1.0" effort="120.0" velocity="20.90"/>
    <dynamics damping="0.2" friction="1.5"/>
  </joint>
  <joint name="R_shoulder_pitch" type="revolute">
    <parent link="torso"/><child link="R_shoulder_pitch_link"/>
    <origin xyz="0 -0.085 0.4" rpy="0 0 0"/>
    <axis xyz="0 1 0"/>
    <limit lower="-3.0" upper="1.0" effort="120.0" velocity="20.90"/>
    <dynamics damping="0.2" friction="1.5"/>
  </joint>
  <joint name="L_shoulder_roll" type="revolute">
    <parent link="L_shoulder_pitch_link"/><child link="L_shoulder_roll_link"/>
    <origin xyz="0 0.09 0" rpy="0 0 0"/>
    <axis xyz="1 0 0"/>
    <limit lower="-0.05" upper="2.6" effort="36.0" velocity="50.30"/>
    <dynamics damping="0.08" friction="0.7"/>
  </joint>
  <joint name="R_shoulder_roll" type="revolute">
    <parent link="R_shoulder_pitch_link"/><child link="R_shoulder_roll_link"/>
    <origin xyz="0 -0.09 0" rpy="0 0 0"/>
    <axis xyz="1 0 0"/>
    <limit lower="-2.6" upper="0.05" effort="36.0" velocity="50.30"/>
    <dynamics damping="0.08" friction="0.7"/>
  </joint>
  <joint name="L_shoulder_yaw" type="revolute">
    <parent link="L_shoulder_roll_link"/><child link="L_shoulder_yaw_link"/>
    <origin xyz="0 0.03 -0.12" rpy="0 0 0"/>
    <axis xyz="0 0 1"/>
    <limit lower="-2.6" upper="2.6" effort="17.0" velocity="42.90"/>
    <dynamics damping="0.03" friction="0.4"/>
  </joint>
  <joint name="R_shoulder_yaw" type="revolute">
    <parent link="R_shoulder_roll_link"/><child link="R_shoulder_yaw_link"/>
    <origin xyz="0 -0.03 -0.12" rpy="0 0 0"/>
    <axis xyz="0 0 1"/>
    <limit lower="-2.6" upper="2.6" effort="17.0" velocity="42.90"/>
    <dynamics damping="0.03" friction="0.4"/>
  </joint>
  <joint name="L_elbow" type="revolute">
    <parent link="L_shoulder_yaw_link"/><child link="L_elbow_link"/>
    <origin xyz="0 0 -0.115" rpy="0 0 0"/>
    <axis xyz="0 1 0"/>
    <limit lower="-1.9" upper="0.0" effort="36.0" velocity="50.30"/>
    <dynamics damping="0.08" friction="0.7"/>
  </joint>
  <joint name="R_elbow" type="revolute">
    <parent link="R_shoulder_yaw_link"/><child link="R_elbow_link"/>
    <origin xyz="0 0 -0.115" rpy="0 0 0"/>
    <axis xyz="0 1 0"/>
    <limit lower="-1.9" upper="0.0" effort="36.0" velocity="50.30"/>
    <dynamics damping="0.08" friction="0.7"/>
  </joint>
  <joint name="L_wrist_yaw" type="revolute">
    <parent link="L_elbow_link"/><child link="L_wrist_yaw_link"/>
    <origin xyz="0 0 -0.125" rpy="0 0 0"/>
    <axis xyz="0 0 1"/>
    <limit lower="-2.6" upper="2.6" effort="17.0" velocity="42.90"/>
    <dynamics damping="0.03" friction="0.4"/>
  </joint>
  <joint name="R_wrist_yaw" type="revolute">
    <parent link="R_elbow_link"/><child link="R_wrist_yaw_link"/>
    <origin xyz="0 0 -0.125" rpy="0 0 0"/>
    <axis xyz="0 0 1"/>
    <limit lower="-2.6" upper="2.6" effort="17.0" velocity="42.90"/>
    <dynamics damping="0.03" friction="0.4"/>
  </joint>
  <joint name="L_wrist_pitch" type="revolute">
    <parent link="L_wrist_yaw_link"/><child link="L_wrist_pitch_link"/>
    <origin xyz="0 0 -0.075" rpy="0 0 0"/>
    <axis xyz="1 0 0"/>
    <limit lower="-0.9" upper="0.9" effort="14.0" velocity="33.00"/>
    <dynamics damping="0.02" friction="0.3"/>
  </joint>
  <joint name="R_wrist_pitch" type="revolute">
    <parent link="R_wrist_yaw_link"/><child link="R_wrist_pitch_link"/>
    <origin xyz="0 0 -0.075" rpy="0 0 0"/>
    <axis xyz="1 0 0"/>
    <limit lower="-0.9" upper="0.9" effort="14.0" velocity="33.00"/>
    <dynamics damping="0.02" friction="0.3"/>
  </joint>
  <joint name="L_wrist_roll" type="revolute">
    <parent link="L_wrist_pitch_link"/><child link="L_hand"/>
    <origin xyz="0 0 -0.06" rpy="0 0 0"/>
    <axis xyz="0 1 0"/>
    <limit lower="-0.6" upper="0.6" effort="14.0" velocity="33.00"/>
    <dynamics damping="0.02" friction="0.3"/>
  </joint>
  <joint name="R_wrist_roll" type="revolute">
    <parent link="R_wrist_pitch_link"/><child link="R_hand"/>
    <origin xyz="0 0 -0.06" rpy="0 0 0"/>
    <axis xyz="0 1 0"/>
    <limit lower="-0.6" upper="0.6" effort="14.0" velocity="33.00"/>
    <dynamics damping="0.02" friction="0.3"/>
  </joint>
  <joint name="L_hip_pitch" type="revolute">
    <parent link="pelvis"/><child link="L_hip_pitch_link"/>
    <origin xyz="0 0.1 0.03" rpy="0 0 0"/>
    <axis xyz="0 1 0"/>
    <limit lower="-1.65" upper="0.24" effort="120.0" velocity="20.90"/>
    <dynamics damping="0.2" friction="1.5"/>
  </joint>
  <joint name="R_hip_pitch" type="revolute">
    <parent link="pelvis"/><child link="R_hip_pitch_link"/>
    <origin xyz="0 -0.1 0.03" rpy="0 0 0"/>
    <axis xyz="0 1 0"/>
    <limit lower="-1.65" upper="0.24" effort="120.0" velocity="20.90"/>
    <dynamics damping="0.2" friction="1.5"/>
  </joint>
  <joint name="L_hip_roll" type="revolute">
    <parent link="L_hip_pitch_link"/><child link="L_hip_roll_link"/>
    <origin xyz="0 0 0" rpy="0 0 0"/>
    <axis xyz="1 0 0"/>
    <limit lower="-0.35" upper="0.6" effort="120.0" velocity="20.90"/>
    <dynamics damping="0.2" friction="1.5"/>
  </joint>
  <joint name="R_hip_roll" type="revolute">
    <parent link="R_hip_pitch_link"/><child link="R_hip_roll_link"/>
    <origin xyz="0 0 0" rpy="0 0 0"/>
    <axis xyz="1 0 0"/>
    <limit lower="-0.6" upper="0.35" effort="120.0" velocity="20.90"/>
    <dynamics damping="0.2" friction="1.5"/>
  </joint>
  <joint name="L_hip_yaw" type="revolute">
    <parent link="L_hip_roll_link"/><child link="L_hip_yaw_link"/>
    <origin xyz="0 0 -0.11" rpy="0 0 0"/>
    <axis xyz="0 0 1"/>
    <limit lower="-1.2" upper="1.2" effort="60.0" velocity="20.40"/>
    <dynamics damping="0.12" friction="1"/>
  </joint>
  <joint name="R_hip_yaw" type="revolute">
    <parent link="R_hip_roll_link"/><child link="R_hip_yaw_link"/>
    <origin xyz="0 0 -0.11" rpy="0 0 0"/>
    <axis xyz="0 0 1"/>
    <limit lower="-1.2" upper="1.2" effort="60.0" velocity="20.40"/>
    <dynamics damping="0.12" friction="1"/>
  </joint>
  <joint name="L_knee" type="revolute">
    <parent link="L_hip_yaw_link"/><child link="L_knee_link"/>
    <origin xyz="0 0 -0.285" rpy="0 0 0"/>
    <axis xyz="0 1 0"/>
    <limit lower="0.0" upper="2.15" effort="120.0" velocity="20.90"/>
    <dynamics damping="0.2" friction="1.5"/>
  </joint>
  <joint name="R_knee" type="revolute">
    <parent link="R_hip_yaw_link"/><child link="R_knee_link"/>
    <origin xyz="0 0 -0.285" rpy="0 0 0"/>
    <axis xyz="0 1 0"/>
    <limit lower="0.0" upper="2.15" effort="120.0" velocity="20.90"/>
    <dynamics damping="0.2" friction="1.5"/>
  </joint>
  <joint name="L_ankle_pitch" type="revolute">
    <parent link="L_knee_link"/><child link="L_ankle_pitch_link"/>
    <origin xyz="0 0 -0.45" rpy="0 0 0"/>
    <axis xyz="0 1 0"/>
    <limit lower="-0.8" upper="0.55" effort="90.0" velocity="13.60"/>
    <dynamics damping="0.27" friction="1.5"/>
  </joint>
  <joint name="R_ankle_pitch" type="revolute">
    <parent link="R_knee_link"/><child link="R_ankle_pitch_link"/>
    <origin xyz="0 0 -0.45" rpy="0 0 0"/>
    <axis xyz="0 1 0"/>
    <limit lower="-0.8" upper="0.55" effort="90.0" velocity="13.60"/>
    <dynamics damping="0.27" friction="1.5"/>
  </joint>
  <joint name="L_ankle_roll" type="revolute">
    <parent link="L_ankle_pitch_link"/><child link="L_foot"/>
    <origin xyz="0 0 0" rpy="0 0 0"/>
    <axis xyz="1 0 0"/>
    <limit lower="-0.3" upper="0.3" effort="47.5" velocity="38.11"/>
    <dynamics damping="0.1394" friction="0.924"/>
  </joint>
  <joint name="R_ankle_roll" type="revolute">
    <parent link="R_ankle_pitch_link"/><child link="R_foot"/>
    <origin xyz="0 0 0" rpy="0 0 0"/>
    <axis xyz="1 0 0"/>
    <limit lower="-0.3" upper="0.3" effort="47.5" velocity="38.11"/>
    <dynamics damping="0.1394" friction="0.924"/>
  </joint>
</robot>
