meetsitaram/echo/tools/render_quality.py

"""Product-quality OpenGL renders of echo, stills and replay movies. Everything here is look only: the spec is not touched.

Materials: tinted dark glass visor with an optional soft inner glow, glossy black hubs and shells, a procedural knit on the grey garment
(in each part's body frame, so it stays on the body in motion), matte shoes and rubber hands. Studio: seamless light backdrop, a faint
floor reflection, soft floor contact shadow. Camera names and framing follow train/render_forces.py.

  python tools/render_quality.py --sheet reports/parts/quality_covered.png
  python tools/render_quality.py --sheet reports/parts/quality_skeleton.png --skeleton
  python tools/render_quality.py --closeup head --glow blue --out head_blue.png
  python tools/render_quality.py --rec replay.npz --out clip.mp4 --start 2 --dur 5 --title "Relaxed walk" --tag "boneseed clip, used in training"

MuJoCo camera convention, as render_forces.py: the camera looks along azimuth; it stands at lookat - distance * (cos el cos az, cos el sin az, sin el).
So 'hero' at heading + 135 degrees stands at heading - 45 degrees: the robot's front right. Elevation -6 is above the target.
"""
from __future__ import annotations

import argparse
import ctypes
import hashlib
import math
import pickle
import sys
import tempfile
from pathlib import Path

import glfw
import imageio
import mujoco
import numpy as np
import OpenGL.GL as gl
import OpenGL.images as _gli
import trimesh
from PIL import Image, ImageDraw, ImageFont
from scipy import ndimage

sys.path.insert(0, str(Path(__file__).resolve().parent))
import checks as C  # noqa: E402
import geom as G  # noqa: E402
from render_motion import VIEWS as MJ_VIEWS, XML, smooth_track  # noqa: E402

_gli.COMPONENT_COUNTS[gl.GL_RG] = 2
KNIT, VISOR, GLOSS, MATTE, RUBBER, METAL, FLAT = 0, 1, 2, 3, 4, 5, 6
SKELETON = ('struct', 'actuator', 'linkage', 'hardware', 'bearing')
ELECTRONICS = {'battery', 'battery lower', 'compute'}
METALS = {'struct': (0.93, 0.94, 0.96), 'actuator': (0.11, 0.115, 0.13), 'linkage': (0.80, 0.81, 0.84), 'hardware': (0.42, 0.43, 0.46), 'bearing': (0.72, 0.73, 0.75)}
BEND = {'L_hip_pitch': -0.10, 'L_knee': 0.20, 'L_ankle_pitch': -0.10, 'R_hip_pitch': -0.10, 'R_knee': 0.20, 'R_ankle_pitch': -0.10, 'L_elbow': -0.25, 'R_elbow': -0.25}
# name, camera direction from the target as (front, left), height, distance, target height. Front is +x, the robot's right is -y.
SHEET = [('Front right', (1.0, -0.8), 0.15, 2.75, 0.88), ('Side', (0.0, -1.0), 0.05, 2.75, 0.88), ('Back left', (-1.0, 0.8), 0.15, 2.75, 0.88), ('Legs', (1.0, -0.75), 0.1, 1.45, 0.50)]
GLOWS = {'teal': (0.05, 0.62, 0.90), 'blue': (0.10, 0.32, 1.00), 'green': (0.08, 0.95, 0.42), 'off': (0.0, 0.0, 0.0)}
RGB = ((30, 170, 70), (235, 105, 10))
N_PER_M = 500.0  # metres of arrow per newton is half render_forces.py's: per contact point, capped at ARROW_MAX
ARROW_MAX = 0.85

VS = """#version 330 core
layout(location=0) in vec3 p; layout(location=1) in vec3 n; layout(location=2) in vec3 col; layout(location=3) in vec2 mp;
uniform mat4 vp; uniform mat4 model; uniform float mirror; uniform vec3 eye; uniform float bias;
out vec3 P; out vec3 N; out vec3 LP; out vec3 LN; out vec3 T; flat out int M; flat out float ID; flat out float LAYER;
void main(){
  vec4 w=model*vec4(p,1.0); P=w.xyz; N=mat3(model)*n; LP=p; LN=n; T=col; M=int(mp.x+0.5); ID=mp.y;
  LAYER = (M==FLATID)?0.0:fract(mp.y)*10.0;
  vec4 q=w; if(mirror>0.5) q.z=-q.z; else q.xyz+=normalize(eye-q.xyz)*LAYER*bias;  // decals sit a hair in front of the panel they lie on, in metres
  gl_Position=vp*q;
}""".replace('FLATID', str(FLAT))

FS = """#version 330 core
in vec3 P; in vec3 N; in vec3 LP; in vec3 LN; in vec3 T; flat in int M; flat in float ID; flat in float LAYER;
uniform vec3 eye; uniform vec3 key; uniform float envyaw; uniform mat3 modelR; uniform float mirror; uniform float ss;
uniform sampler2DShadow shadow; uniform mat4 lightvp; uniform vec3 flatcol;
uniform vec3 glow; uniform vec3 vmin; uniform vec3 vmax; uniform float skeleton; uniform float useroom; uniform sampler2D roomenv; uniform float roomgain; uniform float keyk;
out vec4 c;
const float PI2=6.28318531;
float box(float a,float a0,float a1,float s){ return smoothstep(a0-s,a0+s,a)*(1.0-smoothstep(a1-s,a1+s,a)); }
// The studio, turned with the camera. rough widens every edge. Softboxes run brighter than 1: tone mapping and Fresnel bring them down.
float env(vec3 r,float rough,float room){
  float e=asin(clamp(r.z,-1.0,1.0)); float az=atan(r.y,r.x)-envyaw; az=atan(sin(az),cos(az));
  float s=0.02+rough*0.9;
  float g=mix(0.34,0.50,smoothstep(-1.2,0.0,e));       // pale floor and backdrop
  g=mix(g,0.62,smoothstep(0.0,0.5,e)); g=mix(g,0.32,smoothstep(0.7,1.5,e)); g*=room;
  g+=6.0*box(az,-1.25,-0.45,s)*box(e,-0.05,0.95,s);    // the big key box, its cross bar a window in the glass
  g-=2.2*box(az,-0.88,-0.82,s)*box(e,-0.05,0.95,s);
  g+=3.2*box(az,0.35,0.62,s)*box(e,-0.25,0.85,s);      // a tall strip on the other side
  g+=2.6*box(az,2.45,3.05,s)*box(e,-0.2,0.8,s);        // two kickers behind
  g+=2.6*box(az,-2.95,-2.3,s)*box(e,-0.1,0.9,s);
  float cy=cos(envyaw),sy=sin(envyaw); vec2 rr=vec2(cy*r.x+sy*r.y,-sy*r.x+cy*r.y);
  g+=2.4*box(rr.x,-0.55,0.15,s)*box(rr.y,-0.28,0.28,s)*step(0.0,r.z);   // overhead
  return g;
}
vec3 eqsample(vec3 d,float lod){ vec2 uv=vec2(atan(d.y,d.x)/PI2+0.5,asin(clamp(d.z,-1.0,1.0))/3.14159265+0.5); return textureLod(roomenv,uv,lod).rgb; }
// in the room, reflections and fill come from the room itself: a low-res image of it taken from where echo stands
vec3 env3(vec3 r,float rough,float room){ return useroom>0.5?eqsample(r,rough*9.0)*mix(1.0,room,0.35):vec3(env(r,rough,room)); }
vec3 hemi3(vec3 n,float lo,float hi){ return useroom>0.5?eqsample(n,6.2)*roomgain:vec3(mix(lo,hi,0.5+0.5*n.z)); }
float lit_shadow(vec3 n){
  float g=1.0-max(dot(n,key),0.0);
  vec4 q=lightvp*vec4(P+n*(0.003+0.012*g),1.0); vec3 u=q.xyz*0.5+0.5;
  if(u.x<0.0||u.x>1.0||u.y<0.0||u.y>1.0) return 1.0;
  float s=0.0; const float R=1.6/2048.0;
  for(int i=-2;i<=2;i++) for(int j=-2;j<=2;j++) s+=texture(shadow,vec3(u.xy+vec2(i,j)*R,u.z-0.00025));
  return s/25.0;
}
// Knit: stitches at about 2.5 mm, courses each 7.5 mm that still read when the whole body is in the frame. Each fades before it can alias.
const float PF=0.0025, PM=0.0075;
float stitch(vec2 ab){
  float r=ab.y/PF; float shift=0.5*mod(floor(r+0.5),2.0);
  return (0.5+0.5*cos(PI2*r))*(0.72+0.28*cos(PI2*(ab.x/PF+shift)));
}
float knit_height(vec3 lp,vec3 ln,out float fine){
  vec3 w=pow(abs(ln),vec3(6.0)); w/=w.x+w.y+w.z;
  float fw=max(length(dFdx(lp)),length(dFdy(lp)))*ss;     // metres per picture pixel, obliquity included
  float ff=1.0-smoothstep(PF/4.0,PF/2.6,fw); float fm=1.0-smoothstep(PM/4.5,PM/2.6,fw);
  float hf=0.0,hm=0.0;
  if(ff>0.0) hf=w.x*stitch(lp.yz)+w.y*stitch(lp.xz)+w.z*stitch(lp.yx);
  hm=w.x*cos(PI2*lp.z/PM)+w.y*cos(PI2*lp.z/PM)+w.z*cos(PI2*lp.x/PM);
  fine=ff;
  return ff*(hf-0.5)*0.75 + fm*(0.5*hm)*0.32*(1.0-0.6*ff);
}
vec3 bump(vec3 n,float h,float k){
  vec3 dx=dFdx(P),dy=dFdy(P); vec3 r1=cross(dy,n),r2=cross(n,dx); float det=dot(dx,r1);
  vec3 g=sign(det)*(dFdx(h)*r1+dFdy(h)*r2);
  return normalize(abs(det)*n-k*g);
}
float tonemap1(float x){ const float a=0.72; return x<a?x:a+(1.0-a)*(1.0-exp(-(x-a)/(1.0-a))); }
vec3 tonemap(vec3 v){ return vec3(tonemap1(v.r),tonemap1(v.g),tonemap1(v.b)); }
void main(){
  vec3 n=normalize(N); vec3 realeye=mirror>0.5?vec3(eye.xy,-eye.z):eye; vec3 v=normalize(realeye-P);
  if(dot(n,v)<0.0) n=-n;
  float nv=max(dot(n,v),0.0);
  float sh=mirror>0.5?1.0:lit_shadow(n);
  vec3 col;
  if(M==FLATMAT){
    col=flatcol*(0.55+0.55*max(dot(n,normalize(vec3(key.xy,1.0))),0.0)+0.35*pow(max(dot(reflect(-v,n),normalize(vec3(key.xy,1.0))),0.0),24.0));   // shaded like a solid, a little brighter than lit paint
  } else if(M==KNITMAT){
    float fine; float h=knit_height(LP,normalize(LN),fine);
    vec3 nb=bump(n,h,0.00042);
    float nvb=max(dot(nb,v),0.0);
    float wrap=max((dot(nb,key)+0.30)/1.30,0.0);
    float hemi=0.5+0.5*nb.z;
    vec3 diff=hemi3(nb,0.38,0.54)+vec3(1.0,0.97,0.92)*keyk*0.56*wrap*mix(0.12,1.0,sh);
    vec3 alb=T*(1.0-0.22*clamp(0.5-h,0.0,1.0));
    float sheen=pow(1.0-nvb,3.5)*0.24*mix(0.5,1.0,hemi);
    col=alb*diff+vec3(sheen);
  } else if(M==VISORMAT){
    vec3 r=reflect(-v,n);
    float f=0.07+0.42*pow(1.0-nv,5.0);
    vec3 tint=vec3(0.86,0.95,1.0);
    vec3 refl=env3(r,0.015,0.30)*f*tint;
    // the glow lives behind the glass: seen through it, sampled a little deeper along the view, with no source to find
    vec3 vl=transpose(modelR)*v; vec3 q=LP-vl*0.03;
    vec3 ce=0.5*(vmin+vmax); vec3 sz=vmax-vmin;
    float gz=(q.z-(ce.z+0.08*sz.z))/(0.11*sz.z); float gy=(q.y-ce.y)/(0.36*sz.y);
    float g=exp(-gz*gz)*exp(-gy*gy*gy*gy)+0.10*exp(-0.22*gz*gz)*exp(-0.8*gy*gy);
    col=vec3(0.003,0.0035,0.0045)+glow*g*(1.0-f)+refl;
  } else if(M==GLOSSMAT){
    vec3 r=reflect(-v,n);
    float f=0.04+0.55*pow(1.0-nv,5.0);
    col=T*(0.25+0.5*max(dot(n,key),0.0)*sh)+env3(r,0.07,0.35)*f;
  } else if(M==RUBBERMAT){
    vec3 r=reflect(-v,n);
    float f=0.025+0.14*pow(1.0-nv,5.0);
    vec3 diff=hemi3(n,0.5,0.8)+vec3(0.6*max(dot(n,key),0.0)*sh);
    col=T*diff+env3(r,0.45,0.6)*f;
  } else if(M==METALMAT){
    vec3 r=reflect(-v,n);
    float f=pow(1.0-nv,5.0);
    col=(T*env3(r,0.06,1.0)*0.72+vec3(f*0.3))*mix(0.55,1.0,sh);
  } else {
    float wrap=max((dot(n,key)+0.25)/1.25,0.0);
    vec3 diff=hemi3(n,0.38,0.54)*0.86+vec3(1.0,0.97,0.92)*keyk*0.44*wrap*mix(0.12,1.0,sh);
    float sheen=pow(1.0-nv,4.0)*0.08;
    col=T*diff+vec3(sheen);
  }
  col=pow(tonemap(col),vec3(1.0/2.2));
  if(mirror>0.5){
    if(P.z<0.0) discard;
    float a=exp(-P.z/0.32); c=vec4(col*a,a);
  } else c=vec4(col,1.0);
}""".replace('FLATMAT', str(FLAT)).replace('KNITMAT', str(KNIT)).replace('VISORMAT', str(VISOR)).replace('GLOSSMAT', str(GLOSS)).replace('RUBBERMAT', str(RUBBER)).replace('METALMAT', str(METAL))

SHADOW_FS = "#version 330 core\nvoid main(){}"
ID_VS = """#version 330 core
layout(location=0) in vec3 p; layout(location=3) in vec2 mp; uniform mat4 vp; uniform mat4 model; uniform mat4 view; uniform vec3 eye;
flat out float ID; flat out float K; out float Z;
void main(){ vec4 w=model*vec4(p,1.0); ID=floor(mp.y); K=(int(mp.x+0.5)==0)?1.0:0.0; Z=-(view*w).z;
  w.xyz+=normalize(eye-w.xyz)*fract(mp.y)*10.0*0.001; gl_Position=vp*w; }"""
ID_FS = """#version 330 core
flat in float ID; flat in float K; in float Z; out vec4 c; void main(){ c=vec4(K>0.5?ID:-ID,Z,0.0,1.0); }"""

AO_FS = """#version 330 core
in vec2 u; out vec4 c; uniform sampler2D gbuf; uniform vec2 res; uniform float tanv; uniform float aspect; uniform vec2 radii;
vec3 vp(ivec2 t){ float z=texelFetch(gbuf,clamp(t,ivec2(0),ivec2(res)-1),0).g; vec2 d=(vec2(t)+0.5)/res*2.0-1.0; return vec3(d.x*tanv*aspect*z,d.y*tanv*z,-z); }
float hash(vec2 p){ return fract(52.9829189*fract(dot(p,vec2(0.06711056,0.00583715)))); }
// Horizon-style occlusion in view space: how far the geometry around a point rises above its surface, within R metres.
float ao(vec3 P,vec3 n,ivec2 t,float R,float focal,float jit){
  float pr=max(R*focal/(-P.z),3.0); float sum=0.0; const int D=12,S=6;
  for(int i=0;i<D;i++){
    float a=(float(i)+jit)/float(D)*6.2831853; vec2 dir=vec2(cos(a),sin(a));
    for(int j=0;j<S;j++){
      float r=(float(j)+0.3+0.7*fract(jit*7.0+float(i)*0.37))/float(S)*pr;
      vec3 v=vp(t+ivec2(dir*r))-P; float d2=dot(v,v); if(d2<1e-9) continue;
      float co=dot(v,n)/sqrt(d2)-0.06;
      sum+=max(co,0.0)*max(1.0-d2/(R*R),0.0);
    }
  }
  return clamp(5.5*sum/float(D*S),0.0,1.0);
}
void main(){
  ivec2 t=ivec2(u*res); vec3 P=vp(t);
  if(-P.z>500.0){ c=vec4(0.0); return; }
  const int s=2;
  vec3 xp=vp(t+ivec2(s,0))-P, xn=P-vp(t-ivec2(s,0)), yp=vp(t+ivec2(0,s))-P, yn=P-vp(t-ivec2(0,s));
  vec3 dx=abs(xp.z)<abs(xn.z)?xp:xn; vec3 dy=abs(yp.z)<abs(yn.z)?yp:yn;
  vec3 n=normalize(cross(dx,dy)); if(n.z<0.0) n=-n;
  float focal=res.y/(2.0*tanv); float jit=hash(gl_FragCoord.xy);
  c=vec4(ao(P,n,t,radii.x,focal,jit),ao(P,n,t,radii.y,focal,fract(jit+0.5)),0.0,1.0);
}"""
BG_VS = """#version 330 core
const vec2 q[4]=vec2[4](vec2(-1,-1),vec2(1,-1),vec2(-1,1),vec2(1,1)); out vec2 u;
void main(){ u=q[gl_VertexID]*0.5+0.5; gl_Position=vec4(q[gl_VertexID],0.9999,1.0); }"""
BACKDROP = """
vec3 backdrop(vec2 u){
  float y=u.y; float g=mix(0.885,0.925,smoothstep(0.0,0.5,y)); g=mix(g,0.860,smoothstep(0.55,1.0,y));
  float x=abs(u.x-0.5)*2.0; g-=0.022*x*x;
  return vec3(g,g,g*1.002);
}"""
BG_FS = "#version 330 core\nin vec2 u; out vec4 c;" + BACKDROP + "\nvoid main(){ c=vec4(backdrop(u),1.0); }"
FLOOR_VS = """#version 330 core
layout(location=0) in vec3 p; uniform mat4 vp; out vec3 P; void main(){ P=p; gl_Position=vp*vec4(p,1.0); }"""
FLOOR_FS = "#version 330 core\nin vec3 P; out vec4 c; uniform vec2 res; uniform vec3 eye; uniform sampler2D mirrortex; uniform sampler2D floorshadow; uniform vec4 shadowbox; uniform float marks;" + BACKDROP + """
void main(){
  vec2 u=gl_FragCoord.xy/res; vec3 col=backdrop(u);
  vec2 su=(P.xy-shadowbox.xy)/shadowbox.zw+0.5;
  float near=1.0-smoothstep(1.2,2.9,length(P.xy-shadowbox.xy));
  // faint marks each half metre: the camera tracks the robot, and on a plain floor a walk would read as a treadmill
  if(marks>0.5){
    vec2 q=abs(fract(P.xy/0.5+0.5)-0.5)*0.5; vec2 fw=fwidth(P.xy)*1.2;
    vec2 ln=1.0-smoothstep(vec2(0.0012),vec2(0.0012)+fw,q);
    float m=max(ln.x*(1.0-smoothstep(0.014,0.014+fw.y,q.y)),ln.y*(1.0-smoothstep(0.014,0.014+fw.x,q.x)));
    col*=1.0-0.07*m*(1.0-smoothstep(2.0,5.5,length(P.xy-shadowbox.xy)));
  }
  float s=(su.x>0.0&&su.x<1.0&&su.y>0.0&&su.y<1.0)?texture(floorshadow,su).r:0.0;
  col*=1.0-s*near;
  vec3 vd=normalize(eye-P); float R=0.16+0.34*pow(1.0-max(vd.z,0.0),4.0);
  vec4 m=textureLod(mirrortex,u,1.6);
  col=col*(1.0-m.a*R)+m.rgb*R;
  c=vec4(col,1.0);
}"""


def srgb_to_linear(hex_color):
    h = hex_color.lstrip('#')
    v = np.array([int(h[i:i + 2], 16) / 255 for i in (0, 2, 4)])
    return np.where(v < 0.04045, v / 12.92, ((v + 0.055) / 1.055) ** 2.4)


def part_material(g, skeleton):
    """(material, linear colour, layer) for one spec part; None to leave it out."""
    role, name, col = g.get('role'), g['name'], g.get('color', '#808080')
    if role == 'cut' or 'crease' in name:  # the thigh creases lie half buried in the thigh and read as scratches; the seams do their job
        return None
    if skeleton == 'both' and role in SKELETON:
        skeleton = True
    elif skeleton == 'both':
        skeleton = False
    if skeleton:
        if role not in SKELETON:
            return None
        if name in ELECTRONICS:
            return GLOSS, np.array([0.02, 0.022, 0.026]), 0
        # a part's finish decides when the spec gives one (black anodised or silver); otherwise its role
        finish = str(g.get('finish') or '').lower()
        tint = METALS['actuator'] if 'black' in finish or 'anodi' in finish and 'clear' not in finish else METALS['struct'] if 'silver' in finish else METALS[role]
        return METAL, np.array(tint), 0
    if role not in ('knit', 'shell', 'decal'):
        # inside the garment: the covered view keeps them, so a gap shows what is really there, but dark so they never compete
        return (None if role == 'hardware' else (MATTE, srgb_to_linear(col) * 0.35, 0))
    layer = (3 if 'crease' in name or ' seam' in name else 1) if role == 'decal' else 0
    if name == 'visor':
        return VISOR, srgb_to_linear(col), layer
    if role == 'knit' or (name == 'head' and col.upper() == '#BCC0C4'):
        return KNIT, srgb_to_linear(col), layer
    if 'palm' in name or 'cuff' in name or 'wrist' in name or any(w in name for w in ('index', 'middle', 'ring', 'little', 'thumb')) and ' hub ' not in name:
        return RUBBER, srgb_to_linear(col), layer
    if col.upper() in ('#08090B', '#0A1420'):
        return GLOSS, srgb_to_linear(col), layer
    return MATTE, srgb_to_linear(col), layer


def load_parts(skeleton):
    """Every part in its body's frame: {body: Nx11 float array}, cached since the solids take a while. Body frames are world-aligned at zero."""
    root = Path(__file__).resolve().parents[1]
    key = hashlib.sha1((root / 'spec' / 'robot.json').read_bytes() + Path(__file__).read_bytes().split(b'def load_parts(')[0].split(b'def part_material(')[-1] + Path(__file__).read_bytes().split(b'def load_parts(')[1].split(b'def perspective(')[0]).hexdigest()[:12]
    cache = Path(tempfile.gettempdir()) / f'echo_quality_{key}_{skeleton}.pkl'
    if cache.exists():
        return pickle.loads(cache.read_bytes())
    spec = G.load()
    S = C.Solids(spec)
    m0 = mujoco.MjModel.from_xml_path(str(XML))
    d0 = mujoco.MjData(m0)
    mujoco.mj_forward(m0, d0)
    out, vis, pid, count, groups, pieces = {}, None, 1, {}, {}, {}
    for (ln, i), solid in S.geom.items():
        g = spec['links'][ln]['geoms'][i]
        got = None if solid is None else part_material(g, skeleton)
        if got is None:
            continue
        mat, col, layer = got
        mesh = solid.to_mesh()
        v, f = np.asarray(mesh.vert_properties[:, :3], float) - d0.xpos[m0.body(ln).id], np.asarray(mesh.tri_verts, int)
        if len(f) < 4:
            continue
        s = trimesh.graph.smooth_shade(trimesh.Trimesh(v, f, process=True), angle=math.radians(40 if mat != VISOR else 60))  # keeps machined edges sharp
        tri, nor = s.vertices[s.faces].reshape(-1, 3), s.vertex_normals[s.faces].reshape(-1, 3)
        if mat == VISOR:
            vis = np.array([tri.min(0), tri.max(0)])
        group = g['name'].replace('knee gaiter', 'thigh').replace('elbow gaiter', 'upper arm').replace('upper arm lower', 'upper arm')
        seam_id = groups.setdefault(group, pid)
        # the id's fraction carries the depth layer: 0.1 per step
        arr = np.hstack((tri, nor, np.tile(col, (len(tri), 1)), np.full((len(tri), 1), mat), np.full((len(tri), 1), seam_id + layer * 0.1)))
        start = sum(len(x) for x in out.get(ln, []))
        pieces.setdefault(ln, []).append((start, len(arr), tri.mean(0), g.get('role') in ('knit', 'shell', 'decal'), float(np.linalg.norm(tri - tri.mean(0), axis=1).max()), g.get('role')))
        out.setdefault(ln, []).append(arr.astype(np.float32))
        count[g.get('role')] = count.get(g.get('role'), 0) + 1
        pid += 1
    res = {'parts': {k: np.vstack(v) for k, v in out.items()}, 'visor': vis, 'count': count, 'pieces': pieces}
    cache.write_bytes(pickle.dumps(res))
    return res


def perspective(fovy, aspect, n, f):
    t = 1 / math.tan(fovy / 2)
    return np.array([[t / aspect, 0, 0, 0], [0, t, 0, 0], [0, 0, (f + n) / (n - f), 2 * f * n / (n - f)], [0, 0, -1, 0]], float)


def look_at(eye, tgt):
    z = eye - tgt
    z = z / np.linalg.norm(z)
    x = np.cross([0, 0, 1.0], z)
    x = x / np.linalg.norm(x)
    y = np.cross(z, x)
    M = np.eye(4)
    M[0, :3], M[1, :3], M[2, :3] = x, y, z
    M[:3, 3] = -M[:3, :3] @ eye
    return M


def ortho(cx, cy, cz, right, up, fwd, half, depth):
    M = np.eye(4)
    M[0, :3], M[1, :3], M[2, :3] = right / half, up / half, fwd / depth
    M[:3, 3] = -M[:3, :3] @ np.array([cx, cy, cz])
    return M


def prim_meshes():
    """Unit cylinder, cone and disc along +z, in the same vertex layout, for the arrows."""
    def layout(mesh):
        s = trimesh.graph.smooth_shade(mesh, angle=math.radians(50))
        tri, nor = s.vertices[s.faces].reshape(-1, 3), s.vertex_normals[s.faces].reshape(-1, 3)
        return np.hstack((tri, nor, np.ones((len(tri), 3)), np.full((len(tri), 1), FLAT), np.zeros((len(tri), 1)))).astype(np.float32)
    cyl = trimesh.creation.cylinder(radius=1.0, height=1.0, sections=20)
    cyl.apply_translation([0, 0, 0.5])
    cone = trimesh.creation.cone(radius=1.0, height=1.0, sections=20)
    return {'cyl': layout(cyl), 'cone': layout(cone)}


def compile_program(vs, fs):
    def sh(kind, src):
        s = gl.glCreateShader(kind)
        gl.glShaderSource(s, src)
        gl.glCompileShader(s)
        if not gl.glGetShaderiv(s, gl.GL_COMPILE_STATUS):
            raise RuntimeError(gl.glGetShaderInfoLog(s))
        return s
    p = gl.glCreateProgram()
    gl.glAttachShader(p, sh(gl.GL_VERTEX_SHADER, vs))
    gl.glAttachShader(p, sh(gl.GL_FRAGMENT_SHADER, fs))
    gl.glLinkProgram(p)
    if not gl.glGetProgramiv(p, gl.GL_LINK_STATUS):
        raise RuntimeError(gl.glGetProgramInfoLog(p))
    return p


def rt(w, h, internal, depth=True, samples=0):
    fbo = gl.glGenFramebuffers(1)
    gl.glBindFramebuffer(gl.GL_FRAMEBUFFER, fbo)
    for att, fmt, want in ((gl.GL_COLOR_ATTACHMENT0, internal, True), (gl.GL_DEPTH_ATTACHMENT, gl.GL_DEPTH_COMPONENT32F, depth)):
        if not want:
            continue
        rb = gl.glGenRenderbuffers(1)
        gl.glBindRenderbuffer(gl.GL_RENDERBUFFER, rb)
        if samples:
            gl.glRenderbufferStorageMultisample(gl.GL_RENDERBUFFER, samples, fmt, w, h)
        else:
            gl.glRenderbufferStorage(gl.GL_RENDERBUFFER, fmt, w, h)
        gl.glFramebufferRenderbuffer(gl.GL_FRAMEBUFFER, att, gl.GL_RENDERBUFFER, rb)
    return fbo


_ROOMS, _ENVS = {}, {}
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
