meetsitaram/echo/tools/showcase.py

"""echo's showcase film for a phone: 1080 x 1920 in the living room. Every motion is a CPU MuJoCo replay of the v6 policy
(train/replay_forces.py npz); the exploded view is posed, not simulated. Rendered with tools/render_quality.py; sections
render separately (in parallel) and ffmpeg joins them.

  python tools/showcase.py --section tour_a --out a.mp4      (sections: SECTIONS)
  python tools/showcase.py --check                          (clearance from the furniture of every placed clip)

Room frame as tools/scene_living_room.py. The room is background only: echo never collides with it, so every clip is
placed on open floor and checked against the furniture footprints below.
"""
from __future__ import annotations

import argparse
import math
import sys
from pathlib import Path

import imageio
import mujoco
import numpy as np
from PIL import Image, ImageDraw, ImageFilter, ImageFont
from scipy.interpolate import CubicSpline

sys.path.insert(0, str(Path(__file__).resolve().parent))
import render_quality as RQ  # noqa: E402
from render_motion import smooth_track  # noqa: E402

Q = 'C:/Users/PC/AppData/Local/Temp/claude/714944801f6bb85e/092d1abd-f8dd-4f81-a7d0-79bb9f2082fb/scratchpad/qual'
FPS = 25
W, H, PIC, STRIP = 1080, 1920, 1560, 360
FOVY = 45.0
CREDIT = 'Motion Data by Bones Studio (bones.studio)'
TEAL = np.array(RQ.GLOWS['teal'])
GLOW = 0.14

# furniture footprints (x0, x1, y0, y1) and circles (x, y, r), from scene_living_room.py, each 0.1 m larger
BOXES = [(5.06, 7.77, -0.34, 0.37), (4.30, 9.0, 1.27, 2.6), (3.5, 4.8, 1.27, 2.6), (7.0, 11.6, -3.5, -1.95)]
CIRCLES = [(4.05, -1.6, 0.85), (9.0, -1.55, 0.7), (10.84, -1.91, 0.45)]
ROOM = (-1.35, 11.2, -2.25, 2.35)
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
