meetsitaram/echo/(commit log)

2026-11-01 guna: a Figure 03 replica built from one spec
    The spec (spec/robot.py), the physical checks (244, 0 failing), the Fusion
    build scripts and a STEP export of the model, URDF and MJCF with meshes, the
    bottom-up mass model, the PICO retargeter with kinematic playback, and the
    README's walking video.
    Not included: Figure's video frames and the side-by-side panels made with
    them, and the raw PICO capture.
    [L_ankle_pitch_link.stl, L_elbow_link.stl, L_foot.stl, L_hand.stl, L_hip_pitch_link.stl, L_hip_roll_link.stl, L_hip_yaw_link.stl, L_knee_link.stl]
2026-11-01 Cups at the elbows and knees
    Iterating on the side-by-sides with Figure 03, the covers next to each
    actuator now run on round it instead of stopping short:
    - Elbow: both covers continue round the actuator, hollow round it and a grey
    sleeve on it, their side walls kept. The upper arm closes the back of the
    elbow down to a 6 deg seam; in front it stops where the forearm's front face
    reaches at full flexion (109 deg, 4 mm clear). The actuator hangs from a
    bracket behind it, in the sector the forearm never reaches. Figure's round
    elbow disc is set into the outer side, with a smaller one inside. The 9 cm
    black elbow band is gone.
    - Knee: the thigh's cover now runs down to the axis (i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
    [L_elbow_link.stl, L_hip_yaw_link.stl, L_knee_link.stl, L_shoulder_yaw_link.stl, R_elbow_link.stl, R_hip_yaw_link.stl, R_knee_link.stl, R_shoulder_yaw_link.stl]
2026-11-01 Hip lobes on the roll link: the thigh meets them in a 3 mm seam
    Seen from below, the thigh hung under the hip lobe on a 12 mm plate and
    the yaw actuator's grey rim, in a 2.5 cm gap. The lobe rode on the hip
    pitch link, so the thigh rolled and yawed against it and needed the room.
    - The lobe now rides on the hip roll link, so only the hip yaw turns the
    thigh under it. The thigh's flat top meets the lobe's flat underside in
    a 3 mm seam at 0.857 m, with the roll parts and the yaw actuator inside:
    a front plate, two tabs and a crown on the yaw actuator, through a round
    hole in the thigh's top.
    - The lobe now rolls against the pelvis instead. It is hollow round the
    pitch actuator, its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
    [L_hip_pitch_link.stl, L_hip_roll_link.stl, L_hip_yaw_link.stl, R_hip_pitch_link.stl, R_hip_roll_link.stl, R_hip_yaw_link.stl, guna.step, guna.urdf]
2026-11-01 Hip seam domed, roll motor capped
    The side view showed two white lines at the hip, both light through gaps:
    - The flat 3 mm seam between the hip lobe and the thigh lined up with the
    other hip's, so a level side view saw the background through both. Any
    flat seam does that. The thigh's top is now a dome round the hip yaw
    axis: it stays inside a 0.28 m sphere (a new 'keep' option for lofts,
    offline and in Fusion), and the lobe's underside is 3 mm outside the same
    sphere. The thigh still turns in place under the lobe, but no straight
    line runs along the seam. The seam drops 9 mm to the sides and 3.6 cm to
    the back, as Figure's thigh top falls toward the back.
    - The roll motor sto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
    [L_hip_roll_link.stl, L_hip_yaw_link.stl, R_hip_roll_link.stl, R_hip_yaw_link.stl, guna.step, guna.urdf]
2026-11-01 Rename the robot from guna to echo; Fusion design in the repo
    - The robot, its files and its tools are renamed to echo:
    urdf/echo.urdf and echo.xml (robot "echo"), cad/echo.step,
    docs/media/echo_*, tools/ik/pico_to_echo.json, the Fusion appearances and
    the viewer's model (echo.json).
    - The Fusion design is saved in the Fusion hub as "echo" (project
    my-projects, folder echo). CLAUDE.md says where to find it.
    - cad/echo.f3d: the Fusion 360 design itself (30 link components with
    their build timeline, 29 joints with limits), exported from the saved
    document next to cad/echo.step (root "echo" and the 30 links).
    - The README walk video is re-rendered with the updated robot, titled
    "e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
    [echo.f3d, echo.step, echo.urdf]
2026-11-01 Lessons, a build-your-own skill, references and licence notices
    - LESSONS.md: every issue from the hip rounds and the rename, with the fix
    that prevents it:
    - the joint-order decision, the wrist clearance, holes in swept cuts,
    the misread black-hip measure, the dome crossing the yaw motor;
    - Fusion save, rename, memory and speed, and Windows paths;
    - the duplicate binary in git, GH007, repo hygiene, review before push,
    stale pictures and numbers, keeping a sources list;
    - a new section, Repository and publishing.
    - skills/humanoid-from-spec/: the method as a skill, so someone can build
    their own humanoid this way. SKILL.md has five rules, ten steps, a
    checklist for each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
    [retarget_pico.py]
2026-11-01 License echo under Apache-2.0
    echo is now Apache-2.0 so anyone can use, modify and build on it,
    commercially too: the code, the spec, the CAD, the robot models, the
    documents and the media. LICENSE is the verbatim Apache License 2.0 text.
    The README, THIRD_PARTY_NOTICES.md (GMR's MIT notice still applies to
    the adapted retargeting parts), the skill's sources and publishing notes
    and LESSONS.md now say so.
2026-11-01 README: a clean overview; the details move to docs/DESIGN.md
    The README was long and its wide tables broke on a phone. It now gives:
    - what echo is, the walk video and the views;
    - an overview (size, joints, actuators, battery, payload, deliverables,
    what was verified);
    - the design ideas and the approach, as short bullets;
    - the repository layout, a quick start and the licence.
    Everything else (Figure 03 comparison, joint table, masses, joint room,
    walking, checks, commands, files, next steps) moves unchanged to
    docs/DESIGN.md. The skill's publishing notes describe the same split.
2026-11-02 Living room: echo replays motion captured from a video, in a room rebuilt from it
    - tools/video_nlf.py: NLF reads the robot's SMPL body in each frame; the bent-over robot,
    which NLF's detector misses, is found by background difference (99.6 % of frames)
    - tools/nlf_to_tape.py: camera calibrated on the robot's own feet and head, per-frame
    depth anchored to the floor, gaps filled, smoothed, written as a PICO-format tape
    - tools/retarget_pico.py: --hold (head and wrists straight) and --pin (planted feet still)
    - tools/scene_living_room.py: the room measured from the video's frames, Poly Haven CC0
    textures recoloured to it, rounded upholstery, a generated rug
    - tools/render_compare.py: ech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
    [nlf_to_tape.py, render_compare.py, render_motion.py, retarget_pico.py, scene_living_room.py, video_nlf.py]
2026-11-03 Skill and lessons: buildable, not only fitting; matching a reference robot
    Fit checks say nothing about strength or printing. Adds what to have before a
    design counts as ready, and how to work from a reference robot's own model.
2026-11-03 Lessons: review honesty, sim sanity checks, inherited tools, keeping notes current
2026-11-03 Lessons: look actuator specs up before using them; never derive what can be read
2026-11-03 Lessons: proven mechanisms first, measure before naming a cause, compare within a class, test joint limits
2026-11-05 Elbow as a hinge: drum on the forearm, tangent hem, domed oval pads
    The bent elbow showed a flat wedge, a mouth and a puck (user's screenshot). The forearm's top is now a drum round
    about the axis, the upper arm ends in a socket and a plane tangent to the forearm's roll, and the stator is held
    from outside by a cheek. Range unchanged (0 to 109 deg). Masses change: forearm link +0.09 kg, upper arm link -0.15 kg.
    compare.py gains a feet band; render_pose --views renders at 1600 x 1200.
    [compare.py, render_pose.py, robot.py]
2026-11-05 Arm yaw seams: 3 mm and curved, closed tops, no light through
    The shoulder yaw and wrist yaw seams were flat and 6 mm. Now on spheres about each yaw axis. Masses change slightly:
    upper arm and lower forearm covers.
2026-11-05 Hip seam a bowl, not a dome: black no longer drops to 0.80 m at the back
    Thigh top dished, lobe underside round about the yaw axis, front 0.853 m, back 0.863 m. Masses change: hip roll and
    hip yaw links by about 0.03 kg per side. No joint changed.
    [checks.py, robot.py]
2026-11-05 Knee as the elbow: grey drum, tangent fold, clevis outside it, domed pads
    Bent 35 deg the knee showed a flat shank top, a black drum in a mouth and pads on posts. Range unchanged (0 to 2.15
    rad). Masses change: thigh link -0.05 kg, shank link +0.08 kg per side. No joint moved. The rod crank and its slot in
    the drum are still not modelled.
    [robot.py]
2026-11-05 Add SuperMimic soundness work: training tools, plants, self-collision spheres, force renders
    [echo.urdf]
2026-11-05 Visor with two edges; neck deeper above the collar
    From corners measured on the side frame. Visor is a decal, so head mass moves slightly; the neck cover grows. No joint.
2026-11-05 Shoulder slope: one line from the motors tops to the collar
    Side frame at 1.46 m: Figure 0.13 m, was 0.168, now 0.149. Torso cover mass falls slightly. No joint.
2026-11-05 Correct a number: the old hip seam dropped to 0.82 m at the back, not 0.80
    The commit that changed the seam says 0.80; its loft reached 0.80 but the dome cut it at 0.82. Comment and lesson only.
    [robot.py]
2026-11-05 Wrist: one housing over both actuators, a squarer cuff
    Bent, it read as separate parts. Palm top 4 mm lower (explicit palm mass unchanged). Masses change on the wrist pitch and
    yaw links. No joint or limit changed.
    [robot.py]
2026-11-05 Hands: relaxed curl from two capsules a finger
    No joints. Finger covers change, palm mass unchanged. Fingertip 0.716 m (Figure 0.71).
2026-11-05 Shoulder: grey liner behind the cap gap, a fairing over the roll lug
    The dark ring drew the cap as a circle and the black lug stood out behind. Roll link and torso masses change slightly.
    No joint or limit changed.
2026-11-05 Knee: direct RS04 on the axis, inside the drum (known open: stair check fails)
    Ratio 1, not remote. Pushrod and motor-frame clash gone. Drum radius 60 to 66 mm, shank top and thigh end 6 mm deeper.
    Check fails on purpose: L_knee 134.0 N m x 1.5 against peak 120 in step up a stair. Invalidates the trained policy:
    knee torque, armature, masses.
    [robot.py]
2026-11-05 Ankle: RS03 pitch and RS06 roll, each with its own crank and rod
    From the paper solve. Pitch ratio 1.5 (first pass of 1.44 to 2.71), roll 1.32, in capacity so checks and robot files use
    them. Calf 107 mm deep at the RS03, fork and cross narrower, pitch arm through the back clevis. Actuators gain depth
    fields used here (round 3 finishes that file). No published example of this layout: a warning sign. Same known open failure
    (stair, 135.5 N m). Invalidates the trained policy: ankle torque, armature, masses.
    [robot.py]
2026-11-05 Actuators: the maker numbers, with sources and notes
    RS03 rated 20, RS02 rated 6, lengths and depths from STEP, plate and stall notes. Same known open failure (stair).
2026-11-05 Battery 5.24 L and compute 1.07 L: boxes sized by density, no cover changed
    CoM z 0.960 to 0.949 m, x -10.2 to -7.6 mm at the zero pose. Same known open failure (stair).
    [robot.py]
2026-11-05 Regenerate urdf/ from the spec for a retrain
    Direct RS04 knee (120 N m), RS03 pitch at 1.5 (90 N m), RS06 roll at 1.32 (47.5 N m), 57.97 kg, self-collision spheres refit.
    Stands in sim_stand: tilt 1.9 deg, no saturation. This model is not the one the trained policies used.
    [L_ankle_pitch_link.stl, L_elbow_link.stl, L_foot.stl, L_hand.stl, L_hip_pitch_link.stl, L_hip_roll_link.stl, L_hip_yaw_link.stl, L_knee_link.stl]
2026-11-05 v6: the whole robot collides, as far as the sim and the reward need
    Self penetration spheres for leg against leg and hand and forearm against torso and shanks, all capped to the link's hull so the
    zero pose is clear (self_clearance.py --bad). Floor-only primitives for knee and shin, forearm, hand, pelvis, torso and head, on
    their own contact bit; no new robot-robot physics. clear_arms.py clears references of all of it, into a new file. The v6 plant
    and robot config carry da4326b's real values. eval_design.py reads peak and no-load from them and shows motor-side RMS against
    the manual's ratings.
    [make_robot_files.py]
2026-11-05 Shank: straight tapering lines from the collar to the knee, one section shape, measured against Figure
    Figure's side frame: 94 mm deep at z 0.20, 113 at 0.29, 132 at 0.40. The RS03 only needs its depth at z 0.30, so two
    straight lines clear it with a 3 mm wall at 110 mm, and the old bulge and pinch go.
2026-11-05 Back of the knee: the thigh's back line bends into the fold plane; 2.15 rad held
    The plane cannot move at this range, it is where the calf's back lands. The corner can: the plane now meets the back line
    at 26 deg, not 49, 1 cm lower, and the black hem that read as a wing from behind is gone. The limit is unchanged.
2026-11-05 Wrist: cuff 78 x 78 (was 92 x 86), housing 65 x 65 (was 68 x 66), from the RS00 STEP
    The maker's file gives round d57, 52.1 long, so a 3 mm wall stops the housing at 63. No joint changed.
2026-11-05 Wrist: draw the housing in below the pitch motor, so 0.9 rad clears the slimmer cuff
    The previous commit blocked the pitch at 0.86 rad; the housing's sides swung up into the cuff.
2026-11-05 Regenerate robot files for the straight shank, softer knee line and slimmer wrist
    [L_hip_yaw_link.stl, L_knee_link.stl, L_wrist_pitch_link.stl, L_wrist_yaw_link.stl, R_hip_yaw_link.stl, R_knee_link.stl, R_wrist_pitch_link.stl, R_wrist_yaw_link.stl]
2026-11-05 Knee: thick black hubs on the shank round the RS04, a 72 mm neck, knit panel and hem instead of the V
    The pads were 12 mm domes on a 123 mm drum. Stator now rides on the shank, the thigh's fork holds the output.
    [L_hip_yaw_link.stl, L_knee_link.stl, R_hip_yaw_link.stl, R_knee_link.stl, echo.urdf]
2026-11-05 Elbow as the knee: hubs on the forearm, knit panel and hem; knit sleeve over the shoulder, knit flare at the neck, grey shoes
    Close-up audit against Figure, each region straight and bent.
    [robot.py]
2026-11-05 Hubs' tails blunter, shoulder sleeve over the torso's opening, hem rim inside the torso; robot files regenerated
    [L_elbow_link.stl, L_hip_yaw_link.stl, L_knee_link.stl, L_shoulder_roll_link.stl, L_shoulder_yaw_link.stl, R_elbow_link.stl, R_hip_yaw_link.stl, R_knee_link.stl]
2026-11-05 Parts sheet: every spec part flat at one scale; movies frame the whole body and take a tag
2026-11-05 Regenerate robot files for the second look round
    [L_elbow_link.stl, L_hip_yaw_link.stl, L_knee_link.stl, L_shoulder_roll_link.stl, L_shoulder_yaw_link.stl, R_elbow_link.stl, R_hip_yaw_link.stl, R_knee_link.stl]
2026-11-05 Grey as a garment: knit panels per link over the rigid parts; shoulder pitch and roll 30 mm in, the arm on a jog, a fork round the RS06
    Role knit: panels, gaiters at the knee and elbow, a yoke over the shoulder motors. Rigid parts checked inside the skin with 3 mm; the bulk counts between far links.
    [L_elbow_link.stl, L_hip_yaw_link.stl, L_knee_link.stl, L_shoulder_pitch_link.stl, L_shoulder_roll_link.stl, L_shoulder_yaw_link.stl, L_wrist_yaw_link.stl, R_elbow_link.stl]
2026-11-05 Strength table and load checks: named sections, contact area, pivots, linkages, stator faces
    check_connect only proved shapes touch. tools/strength.py cuts named sections from the real solids
    and estimates stress by hand under 3,400 N, walking, motor peak and payload (reports/strength.md).
    New checks.py groups loadpath, contact, pivot, linkage and stator, each with --bad cases compared
    against the unbroken spec, and --good cases that turn a row to PASS. They fail on today's design, as
    expected: 61 new failing rows, reported rather than fixed.
    geom.py: clamp an rbox fillet to half its thinnest side (audit item 18, a tool bug). Total mass
    61.46 to 61.32 kg; robot.json unchanged.
    Co-Authored-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
    [checks.py, geom.py, strength.py]
2026-11-05 Real connections, infrastructure and a proof on the knee: STEP motor outlines, screws, holes, bearings
    - Motors at the maker's STEP outline, each with a clock (tools/motor_outlines.py, spec/actuator_outlines.json)
    - spec/hardware.py: one call places a screw pattern, bearing, pin, insert or retainer, cutting real holes; masses from the catalogue; roles hardware and bearing
    - spec/assumptions.json: every unconfirmed value in one table, printed in the reports
    - Checks motorfit, fastener, holes, bolted, bearing, pattern, access (tools/hw_checks.py), each with a --bad case; --good deepthread, bigbearing, keyclear
    - Knee proof: RS04 9 M5 and 10 M4 real patterns, 2 x CRBT 405 A, within today's hubs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
    [L_elbow_link.stl, L_hand.stl, L_hip_pitch_link.stl, L_hip_roll_link.stl, L_hip_yaw_link.stl, L_knee_link.stl, L_shoulder_pitch_link.stl, L_shoulder_roll_link.stl]
2026-11-05 The knee as the joint template: a round machined barrel on the RS04's real face, two CRBS 508, a fork into a closed tube, a closed shank, a build order as data
    Distance-tree parts with real fillets (tools/sdf.py), reusable helpers in spec/hardware.py, group assembly, Bredt for closed sections, masses from the solids. Checks 116 failing of 599 to 97 of 768.
    [checks.py, compare_knee.py, geom.py, hardware.py, hw_checks.py, mass_model.py, render_knee.py, render_metal.py]
2026-11-05 Regenerate robot files and parts pictures for the machined knee
    [L_hip_yaw_link.stl, L_knee_link.stl, R_hip_yaw_link.stl, R_knee_link.stl, echo.urdf]
2026-11-05 Iteration 42: machined pelvis, waist, hips and chest frame; finish, calf windows, seams
    - Pelvis: one round bar across with a barrel each end (hip pitch RS04s on their
    rear faces) and a round housing for the waist yaw RS04; ring, CRBS 508, cup.
    - Hip roll carrier on the roll axis with a closed arm over the top; hip yaw yoke
    with a band concentric with the pitch axis and a housing round the RS03.
    - Chest frame: disc on the waist cup, two closed rails, a bar holding both
    shoulder motors and the neck; pack and compute are passengers on shelves.
    - Finish field (dark motor and housing, silver structure) read by every renderer;
    windows in the calf over the RS03 and RS06; seam grooves and s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
    [L_elbow_link.stl, L_hip_pitch_link.stl, L_hip_roll_link.stl, L_hip_yaw_link.stl, L_knee_link.stl, L_shoulder_yaw_link.stl, R_elbow_link.stl, R_hip_pitch_link.stl]
2026-11-05 README: the showcase film, current numbers and status; design doc status; skill: what echo learned past the look
2026-11-05 README: drop the old walk, living-room and views media; one still of the current body
2026-11-05 Iteration 43: foot and ankle machined, neck and head frame, pelvis T
    - Ankle drive: each calf motor on a 4 mm plate across the closed section, on its
    ears' real front face (RS03 5 of 8 M4, RS06 6 of 8 M3: the pitch rod passes one
    ear, two rear ears sit in the panel's relief); machined cranks on the 6 M4 hubs;
    d10 rods with spherical rod ends on d6 shoulder screws at both ends.
    - Shank runs on as a closed tapered tube past the rods into a fork; a round cross
    on d12 stub pins in flanged bronze bushings; a d12 roll shaft through the cross
    in bushings in the foot's two clevis plates; pitch arm on the shaft's end; the
    roll rod on a bolted post. Thin plates gone.
    - Foot: pocketed frame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
    [L_ankle_pitch_link.stl, L_foot.stl, L_hip_roll_link.stl, L_knee_link.stl, R_ankle_pitch_link.stl, R_foot.stl, R_hip_roll_link.stl, R_knee_link.stl]
