meetsitaram/echo/reports/parts/ankle_metal.png

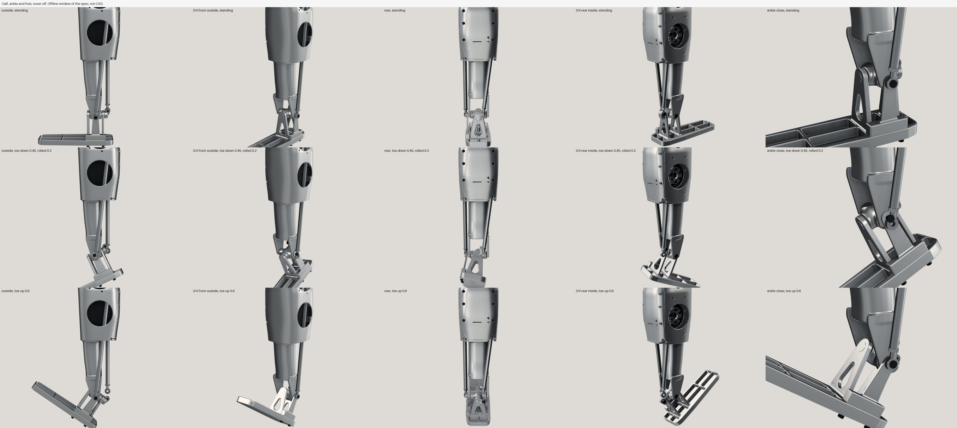
reports/parts/ankle_metal.png
